ET-FR/HP_new_generation/docs/README.md

# docs

Retour au [document principal](../README.md).

| Emplacement | Contenu |
|---|---|
| `simulateur/` | Captures du simulateur de la PAC |
| `nomenclature.md` | Nomenclature de la PAC (rôle, choix, masse, coût, charge R290) |

Tout ce qui concerne les échangeurs (CFD, formes, plans, bibliographie, cahier des charges) est dans
[`../conception_echangeur/`](../conception_echangeur/README.md) ; les ventilateurs, dans
[`../conception_ventilateur/`](../conception_ventilateur/README.md).
