ET-FR/HP_new_generation/compresseurs/sources/concurrents_marche/SOURCES.md

# Sources : compresseurs des concurrents, marché et réglementation R290

Toutes les pages ont été consultées le 2026-11-11. « Fichier » = copie locale dans ce dossier.
« non sauvegardé » = page bloquée (Cloudflare, 403, JavaScript) : seule l'URL est conservée, et le contenu
a été lu par extrait de moteur de recherche ou par WebFetch (fiabilité moindre).

## 1. Produits concurrents

| Titre | URL | Fichier | Ce que la source établit |
|---|---|---|---|
| Midea PWHP — fiche technique (Efficiency Vermont, 2022-10-31) | https://www.efficiencyvermont.com/Media/Default/docs/products/Midea-PWHP_TechProdSheet_2022-10-31.pdf | midea_pwhp_techprodsheet_efficiencyvermont_2022.pdf | PWHP 9k : **R-32**, compresseur à vitesse variable, EER 12,6 (95 °F), COP 3,57 / 2,36 / 1,71 à 47 / 17 / 0 °F ; garantie compresseur 12 ans. Aucun modèle de compresseur. |
| Midea PWHP MAH09H1AGR — Product Specs 2024-06-12 v2.0 | https://midea.com/content/dam/midea-aem/us/air-conditioners/pwhp/mah09h1agr/PWHP-Product-Specs-20240612-v2-0.pdf | midea_pwhp_product_specs_2024.pdf | R-32 ; EER 11,81 ; COP 4,0 (47 °F), 2,42 (17 °F), 2,0 (5 °F), 1,41 (temp. min.) ; CEER 16, SEER2 18,76, HSPF2 10,12. |
| Midea 9,000 BTU Packaged Window Heat Pump (page produit) | https://midea.com/us/Heating_Cooling/pwhp/9000btu-115v-packaged-window-heat-pump-mah09h1agr | non sauvegardé | Fonctionnement jusqu'à −13 °F, 115 V. |
| Fast Company — Midea heat pump review | https://www.fastcompany.com/91448042/midea-heat-pump-review | non sauvegardé (anti-robot) | Midea dit avoir conçu un compresseur neuf pour ce format ; Midea possède son fabricant de compresseurs (GMCC). Lu par extrait de recherche seulement. |
| ACHR News — Midea à l'ENERGY STAR Partner Meeting 2024 | https://www.achrnews.com/articles/155312-midea-showcases-heat-pump-innovation-at-2024-energy-star-products-partner-meeting | achrnews_midea_energy_star_2024_window_hp.html | PWHP présenté dans le cadre du Clean Heat for All Challenge ; COP 2,42 à 17 °F. |
| ACCA blog — Midea cold-climate compressor (EVI) | https://hvac-blog.acca.org/transforming-cold-climate-heating-a-look-at-mideas-innovation-in-heat-pump-compressors/ | acca_blog_midea_cold_climate_compressor.html | Rotatif bi-étagé « sequential stage » à injection de vapeur saturée entre cylindres, pour les PAC **gainables** Midea (pas la fenêtre). |
| Cooling Post — Midea exceeds cold climate challenge (16/10/2023) | https://www.coolingpost.com/world-news/midea-exceeds-cold-climate-challenge/ | coolingpost_midea_exceeds_cold_climate_challenge.html | PAC 3 tonnes Midea (pas la fenêtre) : EVI, 118 % de la capacité à −15 °F, COP 1,92 ; fluide A2L non nommé. |
| Gradient All-Weather 120V — Spec Sheet | https://cdn.shopify.com/s/files/1/0558/4925/5070/files/All_Weather_120V_Spec_Sheet.pdf | gradient_allweather120v_spec_sheet.pdf | **R32** hermétique, compresseur et ventilateurs à vitesse variable ; EER 10,0 ; COP 4,00 / 2,60 / 2,35 / 1,71 à 47 / 17 / 5 / −7 °F. |
| Gradient — product specifications (Efficiency Vermont) | https://www.efficiencyvermont.com/Media/Default/docs/products/gradient-product-specifications.pdf | gradient_product_specifications_efficiencyvermont.pdf | Autre version : EER 13,6, COP 4,04 / 2,37 / 2,06 / 1,80 ; R-32 chargé en usine. |
| Gradient — Installation Manual | https://cdn.shopify.com/s/files/1/0558/4925/5070/files/Gradient_Installation_Manual.pdf | gradient_installation_manual.pdf | R32, consignes A2L ; pas de masse de charge ni de modèle de compresseur trouvés. |
| Gradient blog — How we build your Gradient's heat pump (2022) | https://gradientcomfort.com/blog/how-to-build-a-planet-friendly-air-conditioner | gradient_blog_how_we_build_heat_pump.html | Assemblage, charge R32, scellé hermétique. |
| Cooling Post — Gradient rethinks the window air conditioner | https://www.coolingpost.com/products/gradient-rethinks-the-window-air-conditioner/ | coolingpost_gradient_rethinks_window_ac.html | Ancien modèle : R32, objectif « naturel » à terme ; « thought to employ » un compresseur à « roll-diaphragm » breveté (hypothèse du journaliste). |
| NaturalRefrigerants.com — window heat pumps / ACEEE (Gradient 780 g R32) | https://naturalrefrigerants.com/news/window-mounted-heat-pumps-offer-lowest-cost-solution-to-decarbonize-multifamily-buildings-according-to-aceee-study/ | non sauvegardé (403) | Selon l'extrait de recherche : Gradient 780 g de R32, ouvert au R290 à l'avenir. **Non vérifié.** |
| Hydrocarbons21 — Gradient eyes R290 (2021) | https://archive.hydrocarbons21.com/articles/10123/HC21-120.png | non sauvegardé | Gradient envisageait le R290 (2021) ; limite US ~114 g selon UL 60335-2-40. |
| LG — Case study INNOVA x LG (2022) | https://www.lg.com/global/business/insights/compressor-motor/blog/case-study1-innova-lg/ | lg_case_study_innova_2.0_mini_R290_twin_rotary.html | Innova 2.0 MINI : **compresseur rotatif bi-cylindre inverter LG R290** (« LG R290 Twin Inv. Rotary »). Pas de référence ni de cylindrée. |
| Innova 2.0 — brochure EN (2025-01-16) | https://ventilaatorid24.ee/wp-content/uploads/documents/250116_-_innova_-_2_0-en.pdf | innova_2.0_brochure_en_2025.pdf | 2.0 MINI 9 HP : R290, **0,14 kg**, rotatif DC inverter, EER 3,01, COP 3,15, 27–39 dB(A) ; tous les modèles plus gros sont en R32 (0,50 kg). |
| CINEA — LIFE ZEROGWP (Innova 2.0 NR) | https://cinea.ec.europa.eu/featured-projects/life-zerogwp_cs | non sauvegardé | Projet LIFE : monobloc double conduit Innova 2.0 NR chargeable en R290 ; compresseur non précisé. |
| Ephoca AIO Wall Mounted Pro — data sheet (copie NYC DOB, rév. 08/2024) | https://www.nyc.gov/assets/buildings/pdf/ec220.82.pdf | ephoca_AIO_wall_mounted_pro_datasheet_nycgov_2024.pdf | Ephoca = filiale US d'Innova ; **rotatif bi-cylindre BLDC inverter** ; **R32 ou R410A** (pas de R290 aux US) ; garantie compresseur 9 ans. |
| Olimpia Splendid — catalogue Unico « Retail » IT | https://olimpiasplendid.it/Downloadfile/IT_UnicoRetail | olimpia_catalogue_unico_retail_IT.pdf | Unico Next-F 8 / Next 10 : R290, **0,145 kg**, 1,6 / 2,1 kW froid ; les tailles 2,6 kW sont en R32 (0,28 kg). Compresseur « Twin Rotary a basse vibrazioni ». Charges R290 < 152 g pour éviter la vérification de surface de pièce. |
| Olimpia Splendid — catalogue Unico « Prof » IT | https://olimpiasplendid.it/Downloadfile/IT_UnicoProf | olimpia_catalogue_unico_prof_IT.pdf | Unico Evo / Evo-F en R290 (16, 20, 25), même logique < 152 g, twin rotary. |
| Olimpia Splendid — catalogue Unico EN 2024 (copie distributeur) | https://steelsoft.rs/wp-content/uploads/2024/10/OLIMPIA-SPLENDID-UNICO-EN24.pdf | olimpia_unico_EN24_steelsoft.pdf | Nomenclature (P = R290, V = inverter), « new Twin Rotary compressor », 30 dB(A) en mode silence, encart IEC 60335-2-40 (152 g / 988 g). |
| Olimpia Splendid — notice Unico Evo-F R290 (10-2024) | https://olimpiasplendid.it/media/files/9451_26A00171A-1_UNICO%20EVO-F_10-2024_13L_compressed.pdf | olimpia_unico_evo_f_manual_2024_R290.pdf | Consignes de sécurité R290 ; pas de référence de compresseur. |
| AirCare — R290 monoblock AC (fiche) | https://aircareappliances.co.uk/cdn/shop/files/R290_MONOBLOCK_AC-2ffb4dfa-eb73-4440-b06b-8fc143c64816.pdf | r290_monoblock_ac_aircare.pdf | Monobloc mural R290 10 000 BTU générique : charge 290 g. |
| Midea — R290 NewGen Refrigerant (dossier Blauer Engel) | https://produktinfo.blauer-engel.de/uploads/pdf_uploads/R290%20NewGen%20Refrigerant.pdf | midea_blauer_engel_R290_newgen_refrigerant.pdf | Tableau Midea : charges R290 90–230 g (modèles PHA5K…PD12K) et compresseurs R290 **plus lourds de 0,6 à 2,7 kg** que les R410A équivalents. |
| Midea — Faltblatt R290 (2024) | https://midea.com/content/dam/midea-aem/de/hvac/kataloge/midea-faltblatt-r290-natural-organic-refrigerant-2024-din-a4-5seiter-digital.pdf | midea_faltblatt_R290_2024.pdf | Gamme split R290 Midea en Allemagne. |
| Midea — communiqué PortaSplit R290 (sept. 2026) | https://www.midea.com/content/dam/midea-aem/de/umber-midea/press/Midea-Pressemitteilung-PortaSplit-R290.pdf | midea_portasplit_R290_pressemitteilung.pdf | PortaSplit passe du R32 au R290 en 2027 à cause de l'interdiction F-gas du 1/1/2027. |
| Cooling Post — Midea propane AC wins Blue Angel | https://www.coolingpost.com/world-news/midea-propane-ac-wins-blue-angel-award/ | coolingpost_midea_propane_ac_blue_angel.html | Split R290 Midea « All Easy » ; compresseur R290 développé en interne. |
| IIR — Midea launches R290 split ACs on the European market | https://iifiir.org/en/news/midea-launches-r290-split-acs-on-the-european-market | non sauvegardé | Lancement 2021 en Europe. |
| Groupsumi — Midea Zenith R290 3,5 kW | https://groupsumi.es/en/climate-control/air-conditioning/split-air-conditioning/midea-zenith-r290-3-5-kw-12000-btu-air-conditioner-with-wifi-13950487 | non sauvegardé | Charge 0,38 kg (revendeur). |
| Haier Pearl R290 (2024) | https://haierhvac.eu/sites/default/files/2024-06/Haier_ENG_PearlR290_2024_Digital.pdf | haier_pearl_R290_2024.pdf | Split R290 : « Rotary Inverter », 310 g en usine, aucun complément de charge autorisé. |
| 2025 Resource Guide — R290 Split AC | https://industriaeformazione.it/wp-content/uploads/2025/07/2025_FINAL_ResourceGuide_R290_Split_AC_update.pdf | resource_guide_R290_split_AC_2025.pdf | Panorama des splits R290 du marché (non dépouillé en détail). |
| Room Heat Pumps Factsheet (08/2024) | https://static1.squarespace.com/static/5bb2379dca525b5810509ec1/t/66bcf2adb7400d548c67cd01/1723658926543/Room+Heat+Pumps+Factsheet+0814.pdf | room_heat_pumps_factsheet_0814.pdf | Tous les PAC de pièce US recensés sont en R32. |
| Windmill — spec sheet (Home Depot) | https://images.thdstatic.com/catalog/pdfImages/38/38f6fb39-9b2d-4f40-9b09-40b530a222c7.pdf | non sauvegardé | WhisperTech 12k : compresseur inverter, R32 ; climatiseur seul (pas de PAC). |
| Distributeur Area Cooling — catalogue compresseurs (GMCC R290) | https://exhibitorsearch.messefrankfurt.com/images/original/document_downloads/10000006202501/418603/1741874234911_75076646.pdf | distributeur_messefrankfurt_GMCC_R290_compresseurs_2025.pdf | Rotatifs GMCC R290 DC inverter 12–120 rps : RDSK46D15TZR3 (4,6 cm³), RDSK66D15TBZ3 (6,6), RDSK75D35TBZ3 (7,5), RDSK89D35TBZ3 (8,9), EDTN150D32EFZ (15,0), EDTN180D32EFZ (17,9), EDTN210D32EFZ (20,9) ; COP 3,08–3,51 (conditions de chauffage non explicitées dans l'extrait). |

## 2. Programmes Clean Heat for All / DOE

| Titre | URL | Fichier | Ce que la source établit |
|---|---|---|---|
| BE-Exchange — Window HP Expo program (17/06/2026) | https://be-exchange.org/wp-content/uploads/2026/06/20260617_Window-HP-Expo-Program_WEBSITE.pdf | be_exchange_window_hp_expo_2026-06.pdf | Exigences du challenge (≥ 1,87 COP à 17 °F, 9 000 Btu/h, 115 V 15 A) ; moyenne des deux fabricants : COP 3,92 / 2,44 / 2,03 / 1,32 / 1,19 à 47 / 17 / 5 / −13 / −22 °F ; R-32 ; 30–50 dB(A). |
| BE-Exchange — Room Heat Pump Expo (15/10/2025) | https://be-exchange.org/wp-content/uploads/2025/10/10.15.25-Room-Heat-Pump-Expo-Presentation-for-web.pdf | be_exchange_room_heat_pump_expo_2025-10.pdf | Cahier des charges NYCHA, cible ≤ 35 dB(A) évoquée pour d'autres programmes. |
| BE-Exchange — Clean Heat slides (16/01/2025) | https://be-exchange.org/wp-content/uploads/2025/01/20250116_CleanHeat_Slides-UPDATED.pdf | be_exchange_cleanheat_slides_2025-01.pdf | Midea vs Gradient : tous deux compresseur variable, R-32 ; 51 et 47 dB(A) max. |
| ACEEE 2024 — PWHP NYCHA (pièce jointe) | https://www.aceee.org/sites/default/files/proceedings/ssb24/assets/attachments/20240722160802234_36119e7d-75eb-48b9-ac5f-b4c191450e36.pdf | aceee_2024_ssb24_window_heat_pumps_attachment.pdf | Processus de sélection (6 propositions), R-32 + compresseurs variables, retours terrain. |
| Contractor Mag — Midea 20 000 unités NYCHA | https://www.contractormag.com/green/article/21249624/midea-to-provide-20000-electric-window-heat-pump-units-for-nyc-public-housing | non sauvegardé | Contrat de 20 000 unités. |
| DOE BTO Peer Review 2024 — Next-gen low-cost DX heat pumps | https://www.energy.gov/sites/default/files/2024-11/bto-peer-2024-322262007-next-gen-low-cost-direct-expansion-heat-pumps-li.pdf | doe_bto_peer_2024_next_gen_low_cost_DX_heat_pumps.pdf | Compresseur bi-étagé Copeland (R-457A) ; isentropique comparable au R-410A. |
| DOE 2016 — Shen, cold climate HP tandem compressors | https://www.energy.gov/sites/prod/files/2016/04/f30/32212_Shen_040616-1135.pdf | doe_2016_shen_cold_climate_hp_tandem_peer_review.pdf | Tandem à injection de vapeur + flash tank : 88 % de capacité à −13 °F, COP 4,4 à 47 °F. |
| OSTI 1468210 — Cold climate HP using tandem vapor-injection compressors | https://www.osti.gov/biblio/1468210 | non sauvegardé | À −30 °F : 75 % de la capacité à 47 °F, COP 1,8. |

## 3. Réglementation et normes

| Titre | URL | Fichier | Ce que la source établit |
|---|---|---|---|
| Règlement (UE) 2024/573 (F-gas), JO L du 20/02/2024 | https://eur-lex.europa.eu/legal-content/EN/TXT/PDF/?uri=OJ:L_202400573 | eurlex_reglement_UE_2024_573_fgas.pdf | Annexe IV point 8 : monoblocs / autonomes / plug-in ≤ 12 kW interdits avec GWP ≥ 150 au **1/1/2027** et avec tout gaz fluoré au **1/1/2032** (dérogation sécurité : GWP 750). Point 9 : splits air-air ≤ 12 kW GWP ≥ 150 au 1/1/2029, sans F-gas au 1/1/2035. |
| EIA — Concise guide EU F-gas, Ban/Market prohibitions (2026) | https://eia-international.org/wp-content/uploads/2026-EIA-A-Concise-Guide-to-the-EU-F-Gas-Regulation-Ban-Market-Prohibitions-Spread.pdf | eia_2026_concise_guide_fgas_ban_market_prohibitions.pdf | Synthèse des interdictions. |
| EIA US — Enabling Ultralow GWP Heating and Cooling (maj. 07/01/2026) | https://eia.org/wp-content/uploads/2025/09/Enabling-Ultralow-GWP-Heating-and-Cooling-Updating-U.S.-Safety-Standards-and-Codes-update-1.7.26.pdf | eia_us_enabling_ultralow_gwp_safety_standards_2026.pdf | Tableau 1 : IEC 60335-2-40 éd. 7 (2022) R290 : M1 = 4×LFL = 152 g, M2 = 26×LFL = 988 g, M3 = 130×LFL = 4,94 kg, non fixe 2×M1 = 304 g. UL 60335-2-40 éd. 4 : 3×LFL = 114 g partout. ASHRAE 15 : < 150 g. |
| Federal Register 80 FR 19454 (10/04/2015), SNAP Rule 20 | https://www.govinfo.gov/content/pkg/FR-2015-04-10/html/2015-07895.htm | federal_register_2015-07895_snap_hydrocarbons_room_ac.html | Table 2 « Window AC » : R-290 max **0,24 kg à 9 000 Btu/h** (0,22 à 8 000 ; 0,26 à 10 000) ; PTAC/PTHP 0,14 kg ; portable 0,30 kg ; mural 0,43 kg. |
| EPA — SNAP Rule 25 fact sheet (2023) | https://www.epa.gov/system/files/documents/2023-04/SNAP%20Final%20Rule%2025%20Factsheet_Final_4-3-2023_508_2.pdf | epa_snap_rule25_factsheet_2023.pdf | UL 60335-2-40 3e éd. obligatoire au 2/1/2024 pour les A2L en climatisation résidentielle. |
| EPA — SNAP Rule 27 proposed, fact sheet (10/2025) | https://www.epa.gov/system/files/documents/2025-10/fact-sheet-snap-rule-27_0.pdf | epa_snap_rule27_factsheet_2025-10.pdf | Mise à jour des conditions d'usage vers UL 60335-2-40 4e éd. ou certification NRTL (proposition). |
| EPA — SNAP Rule 27 supplemental proposal fact sheet (02/04/2026) | https://www.epa.gov/system/files/documents/2026-04/fact-sheet-san-12207-snprm-snap-listing-rule-27-04-02-2026.pdf | epa_snap_rule27_snprm_factsheet_2026-04.pdf | Proposition complémentaire ; non finalisée à la date de consultation (pas de règle finale trouvée). |
| IEC 60335-2-40:2022 éd. 7.0 — aperçu VDE | https://www.vde-verlag.de/iec-normen/preview-pdf/info_iec60335-2-40%7Bed7.0%7Db.pdf | iec_60335-2-40_ed7_preview_vde.pdf | Sommaire et domaine d'application de l'édition 7. |
| Cooling Post — Standard revision a « milestone » for propane AC (03/05/2022) | https://www.coolingpost.com/world-news/standard-revision-a-milestone-for-propane-ac/ | coolingpost_standard_revision_milestone_propane_ac.html | Éd. 7 approuvée le 29/04/2022 ; de ~334 g à 988 g de R290 pour un split avec mesures de sécurité. |
| HVAC&R News — Flammable charge limits on the move again (2020) | https://hvacrnews.com.au/regulations/flammable-charge-limits-on-the-move-again/ | hvacrnews_flammable_charge_limits_on_the_move.html | 334 g → 988 g dans une pièce de 20 m² × 2,2 m sous réserve de circulation d'air, vannes, conception robuste. |
| GIZ Proklima — Safety standards (2023) | https://www.green-cooling-initiative.org/fileadmin/user_upload/230630_GIZ-ProClima_Safety_standards_RZ.pdf | giz_proklima_safety_standards_2023.pdf | Formules de charge, notion d'« enhanced tightness refrigerating system », facteurs F = 0,35 / 0,50. |

## 4. Rendement des compresseurs rotatifs R290 et injection de vapeur

| Titre | URL | Fichier | Ce que la source établit |
|---|---|---|---|
| ORNL — Development of High Efficiency Window AC and Compressor Using Propane (rapport CRADA, 2018) | https://info.ornl.gov/sites/publications/Files/Pub119670.pdf | ornl_pub119670_window_ac_propane_limited_charge.pdf | Shanghai Highly : R410A ASD100HW-H6KUN (10,0 cm³) et R290 **PSD162XW (16,2 cm³)**, tous deux isentropique 67 % ; prototype R290 optimisé ≈ 0,77–0,80 isentropique ; climatiseur fenêtre 12k EER 14,0 avec charge < 260 g. |
| ORNL/OSTI 1649540 — Development of High Efficiency WAC Using Propane under Limited Charge (article) | https://www.osti.gov/pages/servlets/purl/1649540 | osti_1649540_ornl_window_ac_propane_limited_charge_paper.pdf | Version article ; charge réductible à 150 g avec microcanaux ; R290 demande ~50 % de cylindrée en plus que le R410A. |
| Purdue ICEC 2096 (2012) — Gao, Chen, Gao : R290 compressor effect on RAC charge | https://docs.lib.purdue.edu/icec/2096/ | non sauvegardé (Cloudflare) | 1 HP inverter R290 : comparaison mono- / bi-cylindre et influence sur la charge (résumé seulement). |
| Purdue ICEC 2300 (2014) — R290 less-oil rotary compressor | https://docs.lib.purdue.edu/icec/2300 | non sauvegardé | Réduire l'huile pour réduire la charge R290 (gaz dissous). |
| Purdue ICEC 2815 (2024) — Zhang & Da : high-speed R290 compressor for RAC (fiche IIR) | https://iifiir.org/en/fridoc/development-of-a-high-speed-r290-compressor-for-room-air-conditioner-149533 | non sauvegardé | Haute vitesse plutôt que grande cylindrée ; double refoulement avantageux au-delà de ~90 Hz. |
| Purdue ICEC 2203 — minimum viscosity for high-side R290 rotary | https://docs.lib.purdue.edu/icec/2203 | non sauvegardé | Dilution de l'huile par le R290 dans un carter haute pression. |
| Ma, Huang, Geng, Zhu (2012), J. Refrigeration — Vapor-injection rotary compressor for residential HP | https://library.kab.ac.ug/Record/doaj-art-c8a6c94245424c779acdd21b521b4ab0/Description | non sauvegardé | Rotatif à injection : +18 % de puissance calorifique en basse température, flash tank meilleur que l'échangeur interne. |
| IIR Fridoc — startup characteristics of R290 rotary compressor / RAC | https://iifiir.org/en/fridoc/experimental-study-on-startup-characteristics-of-a-r290-room-air-141980 | non sauvegardé | Démarrage à froid : aspiration sub-atmosphérique, condensation du R290 dans le compresseur. |
