ET-FR/HP_new_generation/compresseurs/sources/japon_coree/SOURCES.md

# Sources — compresseurs R290 petits, fabricants japonais / coréens / thaïlandais

Toutes les sources consultées le 2026-11-11. « Fichier local » = copie dans ce dossier (rien n'a été exécuté).
Certaines pages (industrial.panasonic.com, docs.lib.purdue.edu en texte intégral, mdpi.com, sciencedirect.com) refusent les téléchargements automatiques : URL citée sans copie locale.

## Panasonic (dont Panasonic Wanbao Appliances Compressor, Guangzhou)

| Titre | URL | Fichier local | Ce que ça appuie |
|---|---|---|---|
| Panasonic Industry Europe — HVAC-R Components catalogue 2026 | https://industry.panasonic.eu/storage/custom-upload/Devices/Panasonic_HVAC_R_Catalogue_2026.pdf | panasonic_HVACR_catalogue_2026.pdf | Tableau « Inverter R290 Rotary Compressors » : 7MS020Z (2,0 cm³) … 7SD110Z (11,2 cm³, twin, Ø95×225 mm, 1990 W froid / 570 W, COP chaud 4,49) … 7WD220Z ; conditions CT 54,4 / ET 7,2 / Ts 35 / Tex 46,1 °C ; plages 15–120 rps (série R) ; fabrication Chine |
| Panasonic — Fighting card « Compressors – Rotary (variable and fixed speed) » v3 | https://industry.panasonic.eu/storage/custom-upload/Devices/Compressors/Fighting_Card_Compressors_v3.pdf | panasonic_fighting_card_rotary_v3.pdf | Arguments techniques (aimant terres rares, bobinage concentré/distribué, ratio huile/R290 optimisé, twin rotary) |
| Panasonic Industry EU — page Rotary compressors | https://industry.panasonic.eu/products/devices/compressors/rotary-compressors | panasonic_eu_rotary_page.html | Gamme 1–10 kW, R290 |
| Panasonic — fiche 7TD052Z- (T2P, R290) | https://industrial.panasonic.com/kr/products/pt/rotary-compressors-vs/models/7TD052Z- | — (accès bloqué au téléchargement) | 5,20 cm³, 1325 W, 443 W, COP 2,99, condition « HPD 57.5Hz », 1Φ 208–230 V UL, Chine |
| Panasonic — fiche 7TD062Z- (T2P, R290) | https://industrial.panasonic.com/kr/products/pt/rotary-compressors-vs/models/7TD062Z- | — | 6,20 cm³, 1500 W, 525 W, COP 2,86, « HPD 57.5Hz », 3Φ DC inverter |
| Panasonic — fiche 7SS064Z- (S, R290) | https://industrial.panasonic.com/kr/products/pt/rotary-compressors-vs/models/7SS064Z- | — | 6,40 cm³, 1636 W, 478 W, COP 3,42, « HPD 57.5Hz » (le catalogue EU donne 330 W / COP 4,53 : incohérence) |
| Panasonic — liste des modèles rotatifs vitesse variable | https://industrial.panasonic.com/ww/products/pt/rotary-compressors-vs/models | — | 38 modèles R290 (séries J2P, K2P, M, M2P, R1P, R2P, S, S2P, T2P, V2P, W2P) |
| Panasonic NA — R-290 series | https://na.industrial.panasonic.com/products/hvacr-appliance-devices/compressors/lineup/rotary-compressors/series/150863 | — | Gamme R290 vitesse fixe 0,5–8 kW, gros modèles 3–16 kW |

## LG Electronics (Corée)

| Titre | URL | Fichier local | Ce que ça appuie |
|---|---|---|---|
| LG Rotary Compressor Catalog 2022 (copie hébergée par un distributeur, hvacr-shop.com) | https://cdn.shopify.com/s/files/1/0605/9560/1544/files/LG_Rotary_Compressor_Catalog_2022_20230420_143824.pdf | lg_rotary_catalog_2022.pdf | R290 vitesse variable : PST092MA, PST102MA (2 pistons), PAT134MA ; capacité, puissance, COP à 60 Hz ASHRAE ; 20–90 rps ; aimant NdFeB ; nomenclature (P = R290, 102 = 10,2 cc/tr) ; R290 vitesse fixe PSG066P/PSG075P/PSG075K |
| LG — catalogue rotatif 2025 (preview) | https://www.lg.com/global/business/download/airsolution/2025_LG_CM_Catalog_Rotary%20compressor_preview[20250718_155755452].pdf | — (le serveur renvoie une page d'erreur) | non exploité |
| LG — page Rotary Compressor | https://www.lg.com/global/business/compressor-motor/compressors/rotary-compressor/ | lg_rotary_compressor_page.html | R290 en vitesse fixe et variable, 1,0–14 kW, single/twin |
| LG — Case study INNOVA (R290 twin inverter rotary) | https://www.lg.com/global/business/insights/compressor-motor/blog/case-study1-innova-lg/ | lg_case_study_innova_R290_twin_rotary.html | Compresseur LG R290 twin rotary inverter choisi pour le monobloc INNOVA 2.0 MINI (concurrent direct « mural sans unité extérieure ») |

## Mitsubishi Electric / Mitsubishi Electric Siam Compressor Industry (Thaïlande) / MHI

| Titre | URL | Fichier local | Ce que ça appuie |
|---|---|---|---|
| Mitsubishi Electric — Compressors | https://www.mitsubishielectric.com/bu/air-conditioning-systems/products/compressors/ | mitsubishi_electric_compressors_page.html | « premier compresseur R290 du secteur (orienté ATW) », extension de capacité R290 ; technologies (Pokipoki motor, vilebrequin revêtu, scrum middle plate) ; sites Shizuoka, Siam (Laem Chabang), Guangzhou ; contact marketing@siamcompressor.com |
| ME-SCI (Siam Compressor) — Products | https://technic.me-sci.com/siamcompressor/en/products | siam_compressor_products_page.html | Filtre « R-290 » présent mais aucune donnée publique ; catalogue rotatif non téléchargeable (lien javascript) |
| ME-SCI — Documentation | https://technic.me-sci.com/siamcompressor/en/documentation | — | Catalogues listés sans lien de téléchargement |
| Mitsubishi Electric UK — MSZ-RZ R290 | https://les.mitsubishielectric.co.uk/products/air-conditioning/m-series/wall-mounted/msz-rz-r290 | mitsubishi_MSZ-RZ_R290_page.html | Split mural R290 (RZ25/RZ35), SEER jusqu'à 11,7, SCOP 5,3 : preuve qu'un petit rotatif R290 inverter Mitsubishi existe (modèle non publié) |
| MHI Technical Review Vol. 60 No. 2 (2023) — SRK_23S | https://mth.mhi.com/development/paper/pdf/e602050.pdf | mhi_technical_review_e602050_twin_rotary_RAC.pdf | (R32) twin rotary 13→15 cc, revêtement DLC palette, +5 % de rendement ; onduleur MOSFET superjonction, pertes contrôleur −60 % |
| Mitsubishi Ecodan R290 (PUZ-WZ) — revendeur | https://www.theheatpumpwarehouse.co.uk/shop/heat-pumps/mitsubishi-ecodan-r290-5kw-monobloc/ | — | PAC eau R290 à rotatif double (trop gros pour nous) |

## Samsung (Corée)

| Titre | URL | Fichier local | Ce que ça appuie |
|---|---|---|---|
| Samsung — Rotary & Scroll applications | https://www.samsung.com/global/business/compressor/applications/special-rotary-scroll | samsung_special_rotary_scroll_page.html | « Variable Speed / R290 » seulement en scroll ; aucun rotatif R290 publié |
| Samsung — Rotary compressor dimension spec | https://images.samsung.com/is/content/samsung/assets/global/business/compressor/rotary-compressor/rotary-compressor-dimension-spec-detailed-v1.pdf | samsung_rotary_dimension_spec_detailed_v1.pdf | Cotes des carcasses 39/44/48 frames ; pas de fluide ni performances |

## Toshiba / GMCC, Hitachi / Highly (JCI), Daikin — notes

| Titre | URL | Fichier local | Ce que ça appuie |
|---|---|---|---|
| ORNL/TM-2018/1063 — Development of High Efficiency Window AC and Compressor Using Propane (B. Shen) | https://info.ornl.gov/sites/publications/Files/Pub119670.pdf | ornl_window_AC_propane_limited_charge_Pub119670.pdf | Highly (Shanghai Hitachi / JCI) PSD162XW R290 16,2 cm³ : 10 014 Btu/h, 894 W, COP 3,28, η_vol 91 %, η_is 67 %, huile 270 ml, ~40 g de R290 dans l'huile ; prototype optimisé ≈ 0,80 d'η_is (carte 0,77–0,80) ; climatiseur fenêtre R290 EER 14,0 |
| ORNL — Development of High Efficiency WAC Using Propane under Limited Charge (article) | https://www.osti.gov/pages/servlets/purl/1649540 | ornl_osti1649540_window_AC_propane_limited_charge_paper.pdf | Même projet, charge ramenée à 150 g avec microcanaux |
| Toshiba GMCC compressor catalogue (revendeur) | https://okmarts.com/jeecg-boot/sys/common/pdf/PDF/Compressor/Toshiba_Compressor/Toshiba_GMCC_Compressor.pdf | — | GMCC = JV Midea / Toshiba Carrier ; ligne R290 depuis 2014 |
| Revendeur — GMCC DSM180D19UDZ R290 | https://qishanr.com/products/r290-gmcc-inverter-compressor-dsm180d19udz | — | R290 DC inverter 17,9 cm³ (source non constructeur) |
| Daikin — EWA(Y)K-CZ | https://www.daikin.eu/en_us/product-group/chillers/ewa-y-k-cz.html | — | Daikin R290 = scroll ; pas de « swing » R290 public trouvé |

## Littérature rendement

| Titre | URL | Fichier local | Ce que ça appuie |
|---|---|---|---|
| Zheng et al. (Midea / Pékin), Performance analysis for a rotary compressor at high speed, arXiv 2407.11080 (2024) | https://arxiv.org/pdf/2407.11080 | arxiv_2407.11080_rotary_compressor_high_speed.pdf | (R32, Te −14,3 / Tc 33,3, PR ≈ 4,2) rendement global ≈ 0,66–0,70 entre 80 et 160 Hz, pic ~68 % à 160 Hz, chute à 200 Hz ; η_vol 84 % (80 Hz) → 105 % (180 Hz) ; η moteur×méca ≈ 83–87 % |
| Gao, Qian, Chen, Liang (GMCC/Meizhi), Research and Development of R290 Less Oil Rotary Compressor, ICEC 2014, paper 2300 | https://docs.lib.purdue.edu/icec/2300/ | purdue_icec2014_2300_R290_less_oil_rotary_abstract.html | Réduction de l'huile pour baisser la charge R290 (IEC 60335-2-40) ; résumé seulement |
| Gao, Chen, Gao, Research of R290 Compressor Effect on RAC System Charge Amount, ICEC 2012, paper 2096 | https://docs.lib.purdue.edu/icec/2096/ | purdue_icec2012_2096_abstract.html | Mono- vs bicylindre dans une clim 1 HP R290 DC inverter ; résumé |
| Zhang, Da, Development of a High Speed R290 Compressor for Room Air Conditioner, ICEC 2024, paper 2815 | https://docs.lib.purdue.edu/icec/2815/ | purdue_icec2024_2815_high_speed_R290_RAC_compressor_abstract.html | Rotatif R290 haute vitesse pour clim ; refoulement simple/double équilibré vers 90 Hz (texte intégral non accessible) |
| Experimental Investigation of Heat Pump Modules Limited to 150 g of R290 (Energies 2025, 18(10), 2455) | https://www.mdpi.com/1996-1073/18/10/2455 | — (accès refusé au téléchargement) | η_is total > 0,45 pour rotatif et piston ; rotatif meilleur à faible taux de compression, piston meilleur à fort taux |
| Performance research and improvement of ultra-high-speed R290 rotary compressor (ResearchGate) | https://www.researchgate.net/publication/381387371_Performance_research_and_improvement_of_ultra-high-speed_R290_rotary_compressor | — | « η_is > 80 % » annoncé à −20 °C (résumé seulement, définition non vérifiée) |
| Thermodynamic performance … low GWP refrigerant in compressors (ATE 2024) | https://www.sciencedirect.com/science/article/abs/pii/S1359431124021598 | — (403) | R290 vs R32 à cylindrée égale : R290 meilleur η_is aux vitesses usuelles ; chute à haute vitesse par sur-compression (d'après résumé du moteur de recherche) |
