ET-FR/HP_new_generation/conception_ventilateur/ventilateurs.html

# Ventilateurs de la PAC de fenêtre : pales, biomimétisme, moteur BLDC

Recherches et pré-dimensionnement · généré le 11/11/2026 par conception_ventilateur/outils/fiche_ventilateurs.py · ventilateur interactif

## L'essentiel

1. Les ventilateurs pèsent lourd : à COP 6, les 76 W du budget actuel font 17 % de la puissance électrique. Les ramener à 40 W donne COP 6,5.
2. Le budget de 76 W est faux : il ne compte que les 25 Pa de la batterie. Un ventilateur axial perd aussi l'énergie de l'air qui sort (½ρc²) : à l'extérieur, de 10 Pa (rotor de 500 mm) à 75 Pa (300 mm). Le diamètre disponible dans la fenêtre décide de tout.
3. Le premier gain vient de ce qu'il y a autour de la pale : grand rotor lent, diffuseur, stator redresseur, faible jeu en bout de pale. Un diffuseur fait passer un axial de 42 % à plus de 50 %[12][11].
4. Le biomimétisme sert d'abord le bruit (−2,5 à −5 dB) ; les gains de rendement indépendants sont de 3 à 8 %. Les tubercules de baleine aident quand la batterie extérieure givre (le ventilateur ne décroche pas).
5. Moteur BLDC à commande vectorielle sans capteur : le bon choix. 60–90 % de rendement contre 30–50 % pour un moteur à condensateur, et efficace à bas régime, là où la PAC tourne le plus[29].
6. Pourquoi un petit ventilateur rend si mal : pression utile faible (l'air sortant emporte l'énergie), faible Reynolds (profils peu efficaces), bout de pale, petit moteur. Le ventilateur EC du commerce du dépôt plafonne à 0,26. Cible revue : 0,45–0,55.
7. Bout de pale : anneau tournant fixé aux pales, oui ; roulement en périphérie, non ; moteur en périphérie (rim-driven), intéressant mais trop cher pour le premier prototype.
8. Un seul module (même batterie, même ventilateur) des deux côtés : ça tient, et les ventilateurs ne consomment plus que ≈ 12 à 30 W au total ; la batterie intérieure plus grande permet de baisser Tc (≈ −35 W de compresseur à 8,3 °C). Voir Même ventilateur et même échangeur.
9. Pour essayer les variantes : ventilateur interactif (géométrie, vitesse, anneau, diffuseur, motifs bio-inspirés, moteur ; bilan des pertes en direct).

## Cahier des charges

| Intérieur | Extérieur
Débit max | 800 m³/h | 2 500 m³/h
Perte de charge de la batterie | ≤ 25 Pa | ≤ 25 Pa, davantage quand elle givre
Cas qui dimensionne | chauffage 8,3 °C | chauffage −8,3 °C (air à 1,33 kg/m³, +11 % de pression)
Budget actuel | 76 W au total, η = 0,30, perte de sortie non comptée
Cible du dossier | η global 0,45–0,55 → ≈ 45–55 W au total
Moteur | BLDC rotor extérieur, FOC sans capteur

Source : pac_9000btu.html, cahier des charges des échangeurs (9 000 BTU/h = 2 638 W).

## Pourquoi chaque watt compte

COP de l'unité selon la puissance des ventilateurs, compresseur inchangé. Ronds : budget actuel ; carrés verts : cible de 40 W.

COP visé | P élec. totale W | Ventilateurs 76 W | Ventilateurs 40 W | COP si 76 → 40 W
4,0 | 660 | 12 % | 6 % | 4,23
6,0 | 440 | 17 % | 9 % | 6,54

## Architecture : la perte de sortie et le diamètre

pression totale à fournir Δp_t = Δp_batterie + ½ ρ c² (c = débit / section annulaire du rotor) puissance électrique P = Q × Δp_t / η_global similitude Q ∝ n D³ Δp ∝ n² D² P ∝ n³ D⁵ bruit ∝ u⁵ à u⁶ (u = vitesse en bout de pale)

Pression totale qu'un axial doit fournir selon son diamètre. Bleu : la batterie ; orange : énergie perdue par l'air qui sort ; vert : avec un diffuseur qui en récupère la moitié.

Puissance électrique selon le diamètre (diffuseur à 50 %) pour trois rendements ; en pointillé violet, la vitesse de rotation pour un coefficient de pression ψ = 0,2.

Échangeur | D mm | c sortie m/s | ½ρc² Pa | Δp_t avec diffuseur Pa | u bout m/s | tr/min | φ | P élec. W (η 0,30 / 0,45 / 0,60)
intérieur | 200 | 8,1 | 39,0 | 44,5 | 19,3 | 1839 | 0,37 | 33 / 22 / 16
intérieur | 250 | 5,2 | 16,0 | 33,0 | 16,6 | 1267 | 0,27 | 24 / 16 / 12
intérieur | 300 | 3,6 | 7,7 | 28,9 | 15,5 | 987 | 0,20 | 21 / 14 / 11
extérieur | 300 | 11,2 | 75,2 | 62,6 | 22,8 | 1454 | 0,43 | 145 / 97 / 72
extérieur | 400 | 6,3 | 23,8 | 36,9 | 17,5 | 837 | 0,32 | 85 / 57 / 43
extérieur | 500 | 4,0 | 9,7 | 29,9 | 15,8 | 603 | 0,22 | 69 / 46 / 35

φ = Q / (π D²/4 · u) : coefficient de débit, en vert dans la plage usuelle d'un axial basse pression (0,15–0,35), en rouge si le diamètre est mal adapté au débit. ψ = 2 Δp_t / (ρ u²) = 0,2. Calcul : conception_ventilateur/outils/predimensionnement.py.

Lecture. À l'extérieur, un rotor de 300 mm est hors jeu (φ trop grand, 145 W à η = 0,3). À 500 mm on tourne à 600 tr/min, silencieux, pour 35 W à η = 0,6. À l'intérieur, 250–300 mm à 1 000–1 300 tr/min, 11 à 16 W.

## Quelle famille de ventilateur

Famille | Où elle gagne | Rendement global typique | Pour nous
Axial à virole + diffuseur / stator | grand débit, faible pression (notre cas) | 0,45–0,60 avec diffuseur[12] | extérieur : choix de base
Contrarotatif (2 rotors) | plus de pression dans le même diamètre, giration récupérée | 63–65 % mesurés sur petits rotors[23][24] | si la fenêtre limite le diamètre
Diagonal (hélico-centrifuge) | pression moyenne, compact | ≈ 0,48–0,56 (chiffre fabricant)[28] | intérieur si la batterie résiste plus que prévu
Centrifuge à aubes arrière | pression élevée, débit moyen | > 0,70 en grande taille (chiffre fabricant)[15] | intérieur possible, encombrant
Tangentiel (cross-flow) | nappe d'air large, très plat, silencieux | faible (≈ 0,2–0,4, à vérifier)[21][22] | standard des splits ; à éviter pour gagner des watts

### Jeu en bout de pale

Passer de 0,3 % à 0,1 % du diamètre gagne ≈ 2 points de rendement[27] ; en dessous de 5 % de la hauteur de pale, le rendement baisse linéairement avec le jeu[26]. Avec une virole partielle, il existe un jeu optimal non nul[25]. Les solutions (anneau tournant, roulement périphérique, rim-driven) sont comparées plus bas, section Jeu en bout de pale.

## Pales récentes des fabricants

Produit | Ce qui change | Gain annoncé (chiffre fabricant)
ebm-papst AxiBlade / AxiBlade.Perform (2025)[10][11] | profil aile, winglets intégrés, aubes directrices, diffuseur | jusqu'à +54 % de rendement, −8 dB ; η statique ≤ 53 %
ebm-papst AxiTop[12] | diffuseur seul | −27 % de puissance et −7,2 dB(A), ou +9 % de débit
Ziehl-Abegg FE2owlet[14][16] | pales en faucille, bord de fuite dentelé, winglets | −4 dB(A) ; version Mahle : +10 % de rendement, −10 % de masse
Ziehl-Abegg ZAbluefin[15] | centrifuge, bord d'attaque ondulé (nageoire de baleine) | +10 à +15 % selon les sources
LG MULTI V 5[20] | pales inspirées de la baleine | −20 % de consommation
Sharp[17][18] | roue sirocco « aile de libellule » ; hélice extérieure aigle / albatros / martinet | −2,5 dB mesurés (sirocco) ; extérieur : qualitatif

Aucun de ces chiffres n'est accompagné d'une norme d'essai ou d'une référence de comparaison publiée.

## Biomimétisme : ce que dit la recherche

Les motifs bio-inspirés, dessinés schématiquement sur une même pale.

Modèle naturel | Motif | Effet mesuré | Prix à payer
Chouette | dents de bord d'attaque, peigne de bord de fuite | −3 à −5 dB à moyenne et haute fréquence[1] ; hélice avec les deux : −3,1 dB et +7,9 % de rendement de poussée[3] | sous 15° d'incidence, l'aéro se dégrade[2] ; dents longues = moins de bruit mais moins de rendement[4]
Baleine à bosse | tubercules sinusoïdaux au bord d'attaque | décrochage retardé, tourbillons de bout réduits, couple réduit (hélices, CFD)[5][7] ; ventilateurs : chiffres commerciaux seulement[6] | léger déficit au point nominal ; gain surtout hors nominal
Libellule | section ondulée | −2,5 dB (sirocco Sharp)[17] ; rigidité d'une pale très mince | profil plus délicat à mouler
Harle (oiseau) | profil d'aile sur roue tangentielle | −3,3 % de puissance à débit égal[19] | gain modeste
Bout d'aile d'oiseau | winglets, faucille | réduit le tourbillon de bout de pale[25] | —

Pour nous. Quand la batterie extérieure givre, sa perte de charge monte et le ventilateur passe à faible débit et forte incidence : c'est là que tubercules et dentelures sont favorables (décrochage retardé, moins de bruit de décrochage tournant). C'est l'argument le plus solide pour un motif bio-inspiré dans la PAC. Revues générales : [8][9][7].

## Moteur : petit BLDC piloté en FOC sans capteur

Rendement des moteurs de ventilateur, ordres de grandeur[29].

- Pourquoi : rendement élevé et presque plat en charge partielle, vitesse continue (on suit la puissance de la PAC au lieu de trois vitesses), démarrage doux, et le couple mesuré à vitesse donnée révèle l'encrassement ou le givre.
- Moteur : rotor extérieur intégré au moyeu, la cloche sert de moyeu.
- Alimentation : bus DC commun (24 V, ou bus haute tension de l'onduleur du compresseur) : à trancher avec l'électronique de la PAC.

Circuit | Type | Points forts | Usage
TI MCF8316A / C / D[30][31] | FOC sans capteur, MOSFET intégrés, 4,5–35 V, 8 A crête | aucun code, identification automatique du moteur, consigne PWM / analogique / I²C | prototype
Fortior FT8132[32] | pré-driver FOC sans capteur, MOSFET externes, 28 V | réglage par interface graphique, paramètres en EEPROM ; famille FT8213 / FT8215 / FS9276 | grande série, bas coût
Infineon iMOTION IMD110, ST STSPIN32 | contrôleur FOC intégré | à évaluer | alternatives

## Un ventilateur EC du commerce, mesuré

Courbes fabricant du ventilateur déjà utilisé par le simulateur (ventilateurs/W1G200-EC87-20.json).

Même un bon ventilateur EC de 200 mm plafonne à η = 0,26 à son meilleur point : l'hypothèse de 0,30 du cahier des charges correspond à un bon produit standard, pas à un objectif ambitieux.

## Pourquoi le rendement est si bas

Quatre causes se cumulent ; les deux premières sont physiques et nous suivent quel que soit le dessin.

1. Pression utile faible : l'air qui sort emporte une grosse part de l'énergie. Le rendement statique ne compte que la pression gagnée sur la batterie. W1G200 à 320 m³/h : section annulaire ≈ 250 cm², air sortant à 3,5 m/s, ½ρc² ≈ 7,5 Pa perdus, soit 25 % de la pression totale. À 1 000 Pa (centrifuge) ce serait négligeable ; à 25 Pa c'est structurel.
2. Faible nombre de Reynolds. Re = vitesse × corde / viscosité ≈ 55 000 pour le W1G200, ≈ 100 000 pour un rotor de 500 mm à 600 tr/min, contre ≈ 10⁷ pour une aile d'avion. Sous ≈ 10⁵ la finesse d'un profil tombe de ≈ 100 à 20–40 (couche limite laminaire, bulle de décollement). C'est le régime des oiseaux et des insectes : profils minces cambrés, dentelures et ondulations y sont adaptés.
3. Bout de pale et giration. 1 à 2 mm de jeu sur 200 mm, c'est 3 à 10 fois plus en proportion que sur un grand ventilateur ; sans stator, la rotation de l'air en sortie est perdue.
4. Petit moteur et électronique. À 8 W, roulements, pertes fer, alimentation de la commande et redresseur 230 V pèsent lourd : ≈ 60–70 % pour le moteur, contre plus de 90 % à 1 kW.

Où part l'électricité. Première ligne : estimation pour le W1G200 (seules l'entrée et la sortie viennent de la fiche). Lignes suivantes : modèle de l'animation, à la vitesse qui donne 2 500 m³/h.

Cas (modèle de l'animation) | tr/min | m³/h | P élec. W | η global | Reynolds | w₂/w₁ (décroche < 0,62)
W1G200 (banc, modèle) | 1300 | 302 | 7,0 | 0,25 | 36 k | 0,65
Extérieur 300 mm | 2204 | 2 500 | 101,0 | 0,17 | 121 k | 0,86
Extérieur 500 mm, base | 616 | 2 499 | 41,1 | 0,42 | 80 k | 0,74
Extérieur 500 mm, optimisé | 559 | 2 501 | 29,4 | 0,59 | 75 k | 0,79
Intérieur 280 mm, optimisé | 1016 | 800 | 10,3 | 0,54 | 46 k | 0,79

Ce que nous pouvons attaquer : le moteur et l'électronique (BLDC + FOC à 15–40 W : 80–85 %), l'air sortant et la giration (diffuseur, stator), le bout de pale (anneau). Le faible Reynolds ne se supprime pas, il se repousse : grand diamètre, corde large, profil choisi pour ce régime. D'où la cible revue de 0,45–0,55. Le modèle de l'animation donne ≈ 0,6 pour la version optimisée : il est optimiste (une seule section de pale, écoulement idéal derrière la batterie).

## Jeu en bout de pale : anneau, roulement, rim-driven

Coupes schématiques du bout de pale. Rouge : fuite d'air de l'aval vers l'amont.

Solution | Pour | Contre | Décision
Pales libres, jeu serré | simple | perte ≈ 2,85 × jeu / hauteur de pale[26] ; bruit de jeu ; tolérances serrées | référence
Anneau tournant fixé aux pales (« ring fan », ventilateurs automobiles) | plus de tourbillon de bout de pale ; la fuite passe entre anneau et carter, moins nuisible, freinée par un joint sans contact (lèvre dans une gorge du pavillon, labyrinthe) ; pales rigidifiées, donc plus minces ; 2–3 mm de jeu tolérés (fabrication, givre) | frottement de l'air sur l'anneau ≈ 1 W à 500 mm ; un peu d'inertie | retenu : à comparer en CFD (jeu 1 à 3 mm)
Anneau porté par un roulement en périphérie | — | couple de frottement ∝ diamètre : graisse et joints d'un roulement fin de 500 mm, quelques à plusieurs dizaines de W à 600 tr/min (à vérifier sur catalogue) ; givre, eau et poussière dans le contact ; bruit transmis au carter ; coût | écarté
Moteur en périphérie (rim-driven) | plus de moyeu : +14 % de section (moyeu 0,35 D), −23 % d'énergie de l'air sortant | entrefer ≈ 1 mm sur 500 mm de diamètre, aimants coûteux, paliers à l'air froid et humide | intéressant mais trop cher : hors premier prototype

Gain attendu de l'anneau : quelques points de rendement (2 à 5 estimés, pas encore de mesure sur un ventilateur comparable).

## Quelle pale pour notre système

Notre cas : axial basse pression (25 Pa), rotor de 500 mm à ≈ 500–600 tr/min à l'extérieur, 280 mm à ≈ 1 000 tr/min à l'intérieur, Reynolds de pale 50 000–150 000. Ce que dit la recherche, point par point :

Choix | Ce que dit la recherche | Pour nous
Profil | Sous Re ≈ 10⁵, la plaque cambrée mince (arc de cercle, ≈ 3 % d'épaisseur, bord d'attaque arrondi) vaut ou bat les profils épais type NACA : leur traînée explose à bas Reynolds, pas celle de la plaque[33][34]. Modèles mesurés de portance et traînée : Re 40 000–140 000, cambrure 0–8 %, C_L 0–1,3, C_D 0,02–0,14[33]. Au-dessus de ≈ 1,5·10⁵, les profils minces dessinés pour le bas Reynolds (famille SD, Selig) deviennent intéressants[35]. | plaque cambrée 4–7 %, épaisseur 3 %, bords arrondis : simple à imprimer et à mouler, légère
Nombre de pales et corde | Les hélices d'unités extérieures de PAC sont à 3 pales très larges, semi-carénées[42]. Exemple publié : 401 mm, 3 pales, moyeu 0,25, corde 67 → 318 mm du pied au bout, calage 46 → 69°, 839 tr/min, 1 780 m³/h, rendement total 65 → 68 % après optimisation[36]. | 3 à 4 pales larges : à solidité égale, la corde double et le Reynolds aussi (≈ 150 000 au lieu de 75 000)
Répartition le long de la pale | Passer d'un tourbillon libre à un tourbillon contrôlé (pied de pale moins chargé) : +4,2 points[38] ; à faible rapport moyeu / diamètre, +3,9 à 4,6 points de rendement[37]. Un tourbillon contrôlé crée des migrations radiales : il faut redessiner les sections en conséquence[39]. | tourbillon contrôlé, moyeu 0,25–0,30 (le BLDC à rotor extérieur tient dans 100–150 mm)
Faucille | Faucille avant au bout de pale : +3 points et −1,1 dB sur le ventilateur de PAC de 401 mm[36] ; moins de fluctuations de pression en paroi et moins de bruit sur un 495 mm[40]. Hors point nominal (faible débit), la faucille arrière est plus silencieuse[41]. | faucille avant modérée ; à vérifier en conditions de givre
Bout de pale | Anneau tournant + chevauchement axial avec le carter = joint à labyrinthe ; l'anneau améliore le rendement volumétrique, la fuite résiduelle fait du bruit quand la pale est très chargée[46][45]. | anneau tournant + labyrinthe (déjà retenu)
Pavillon et installation | Pavillon redessiné : +1,2 %[44]. Une pale optimisée montée dans l'unité fait mieux qu'une pale optimisée seule ; les gros changements sont au bout de pale[43]. L'air qui arrive de la batterie n'est pas uniforme : décollements et bruit[42]. | optimiser la pale avec la batterie et le pavillon dans la CFD, pas isolée
Bords | Bord de fuite dentelé : −2 à −4 dB, petit coût ; tubercules : marge au décrochage (voir Biomimétisme). | bord de fuite dentelé ; tubercules en option pour le givre

### Nombre de pales, avec le modèle de l'animation

Rotor extérieur 500 mm optimisé (anneau, diffuseur, stator, calage 34°) | tr/min | Reynolds | P élec. W | η global
9 pales, corde 85 mm, plaque | 512 | 52 k | 31,5 | 0,552
9 pales, corde 85 mm, profil bas Re | 502 | 51 k | 29,5 | 0,589
7 pales, corde 110 mm, plaque | 509 | 67 k | 31,0 | 0,560
7 pales, corde 110 mm, profil bas Re | 500 | 66 k | 29,2 | 0,594
5 pales, corde 150 mm, plaque | 508 | 92 k | 30,6 | 0,568
5 pales, corde 150 mm, profil bas Re | 500 | 91 k | 29,0 | 0,600
4 pales, corde 190 mm, plaque | 506 | 116 k | 30,3 | 0,574
4 pales, corde 190 mm, profil bas Re | 498 | 115 k | 28,7 | 0,604
3 pales, corde 250 mm, plaque | 505 | 152 k | 30,0 | 0,580
3 pales, corde 250 mm, profil bas Re | 498 | 151 k | 28,6 | 0,608

À solidité comparable, moins de pales plus larges gagnent ≈ 1,5 point et tournent moins vite (moins de bruit) ; le profil bas Reynolds gagne 3 à 4 points sur la plaque standard. Ces écarts viennent directement de la loi de traînée supposée dans le modèle (voir les hypothèses de l'animation) : ce sont des tendances, que la CFD devra chiffrer.

### Pale de départ proposée

extérieur : Ø 500 mm, moyeu 0,25–0,30, 3 à 4 pales, corde ≈ 150 mm au pied → 220–250 mm au bout plaque cambrée arc de cercle 3 % d'épaisseur, cambrure 5–6 %, bords arrondis tourbillon contrôlé, faucille avant modérée, anneau tournant + labyrinthe, pavillon soigné bord de fuite dentelé ; ≈ 500–550 tr/min ; BLDC rotor extérieur + FOC intérieur : Ø 280 mm, même famille, 5 pales, corde ≈ 90–110 mm (Re ≈ 70 000–100 000 : la plaque cambrée s’impose)

## Les autres formes de roue : blower, centrifuge, tangentielle

Les grandes formes de roue, vues de face (schémas).

### Ce que fait un climatiseur de fenêtre classique

Un seul moteur à double arbre, en général asynchrone PSC à 3 vitesses, entraîne à la fois la roue blower côté pièce et l'hélice « slinger » côté extérieur[47][48]. La roue blower est une centrifuge à aubes avant ; elle souffle l'air de la pièce à travers l'évaporateur. La slinger est une hélice axiale à anneau en bout de pales : c'est déjà un « ring fan ». Elle aspire l'air à travers le condenseur et projette l'eau de condensation du bac sur la batterie.

| Fenêtre classique | Notre PAC
Moteurs | 1 moteur PSC à double arbre (30–50 %) | 2 BLDC + FOC indépendants (80–85 %)
Vitesses | liées entre elles, 3 crans | continues, réglées séparément (dégivrage : extérieur seul, intérieur arrêté)
Intérieur | roue blower : compacte, lente, silencieuse, tourne l'air de 90° | à choisir (tableau ci-dessous)
Extérieur | hélice axiale à anneau (slinger) | axiale à anneau + labyrinthe (même famille, mieux dessinée)
Eau de condensation | projetée sur le condenseur (gain de capacité en clim) | piste à garder en clim ; en chauffage, la batterie extérieure givre : pas de slinger

### Familles de roues

Famille | Forme des aubes | Coef. de pression ψ | Rendement de pointe publié | Points forts | Points faibles
Roue blower (sirocco, centrifuge aubes avant) | 36 à 60 aubes courtes, courbées vers l'avant | ≈ 2–3 | statique 0,55–0,68[49][51] (grandes roues) | très compacte et lente pour un débit donné, silencieuse, courbe plate | rendement plus bas ; puissance qui monte avec le débit ; la volute compte beaucoup (+5 %[54], −6,4 dB[55])
Centrifuge aubes arrière (roue libre, EC) | 6 à 12 aubes longues, courbées vers l'arrière, parfois profilées | ≈ 0,8–1,1 | statique ≤ 0,80, profilée ≤ 0,84[51][50] ; module EC de 250 mm : global 0,47–0,56[52][53] | le meilleur rendement, courbe stable, puissance plafonnée | plus grosse et plus rapide qu'une blower ; à l'aise à des centaines de Pa, pas à 25 Pa
Centrifuge aubes radiales | aubes droites | ≈ 1–2 | plus bas | robuste, s'encrasse peu | rendement et bruit : sans intérêt ici
Tangentielle (cross-flow) | tambour à aubes avant, l'air le traverse | ≈ 2 | faible[21][22] | nappe d'air large et plate, silencieuse : le standard des splits muraux | rendement le plus bas, sensible au tourbillon interne
Diagonale | pales en hélice sur un moyeu conique | ≈ 0,4–0,6 | ≈ 0,48–0,56[28] | entre les deux | encombrement axial
Axiale | pales en hélice | ≈ 0,1–0,3 | 0,45–0,60 avec diffuseur | grand débit, faible pression : notre extérieur | besoin de diamètre ; l'air ne tourne pas tout seul de 90°

ψ = 2Δp / (ρu²), avec u la vitesse en bout de roue. Plus ψ est grand, plus la roue est petite et lente pour une même pression. Les rendements publiés sont ceux de grandes roues ; à petite taille, tous perdent des points, pour les raisons de la section « Pourquoi le rendement est si bas ».

### Côté intérieur : quelle roue pour 800 m³/h ?

Famille | ψ (coef. de pression) | Taille pour 800 m³/h | tr/min | u bout m/s | Rendement statique de pointe publié
Roue blower (aubes avant) | 2,5 | Ø 160 × 171 mm de large | 616 | 5,2 | 0,55–0,68 (grandes roues)
Centrifuge aubes arrière | 1,0 | Ø 250 × 139 mm de large | 624 | 8,2 | ≤ 0,80 (grandes roues)
Tangentielle | 2,0 | Ø 100 × 642 mm de large | 1103 | 5,8 | faible, à vérifier
Axiale (avec virage dans un caisson) | 0,2 | Ø 280 mm | 1245 | 18,3 | 0,45–0,60 avec diffuseur

Hypothèses : 40 Pa à fournir (25 Pa de batterie + ≈ 15 Pa de grille et de virage de l'air) ; coefficients de débit supposés de 0,5 (blower), 0,25 (aubes arrière) et 0,6 (tangentielle) ; diamètre choisi pour chaque famille. Ce sont des ordres de grandeur pour comparer les encombrements, pas un dimensionnement.

Lecture. À l'extérieur, l'axiale à anneau reste le bon choix : grand débit, 25 Pa, et la place existe côté façade. À l'intérieur, tout dépend de la place dans la fenêtre. La roue blower fait 800 m³/h avec une roue de Ø 160 mm à ≈ 600 tr/min : c'est pour cela que les climatiseurs l'utilisent. Elle tourne l'air de 90° sans caisson et reste très silencieuse, mais rend moins bien. L'axiale de 280 mm rend mieux, à condition d'avoir la profondeur et un caisson pour tourner l'air. La centrifuge à aubes arrière n'est intéressante que si la perte de charge intérieure dépasse nettement 25 Pa (filtre, grilles). À trancher avec la géométrie de la fenêtre : c'est la même question que le diamètre maximal.

## Même ventilateur et même échangeur des deux côtés

Attention : le ventilateur n'est pas encore dessiné. Les puissances ci-dessous viennent du modèle de l'animation appliqué à la pale de départ proposée (axiale 500 mm, 3 pales), une hypothèse de travail, pas une conception.

Idée : un seul module (batterie + ventilateur de 500 mm) monté deux fois, l'un côté pièce, l'autre côté façade. Il est dimensionné sur le cas le plus dur côté extérieur. Avec les Te et Tc actuels de la fiche échangeur, ce cas n'est plus le chauffage à −8,3 °C mais la clim à 35 °C : 1 104 W/K à 2 500 m³/h (contre 897 W/K à −8,3 °C). Les deux côtés ont alors le même circuit d'air : seule la vitesse du ventilateur change. Calcul : conception_ventilateur/outils/module_commun.py (besoins de la fiche échangeur, hA ∝ débit^0,6, modèle du ventilateur de l'animation).

### Débits et puissances avec le module commun

Point | Intérieur | Extérieur | Ventilateurs | Budget actuel (fiche)
Clim 95 °F (35 °C) | 570 m³/h · 125 tr/min · 1,4 W | 2 500 m³/h · 498 tr/min · 28,6 W | 30 W | 72 W
Chauffage 47 °F (8,3 °C) | 830 m³/h · 177 tr/min · 2,2 W | 1 690 m³/h · 345 tr/min · 10,2 W | 12 W | 76 W
Chauffage 17 °F (−8,3 °C) | 830 m³/h · 177 tr/min · 2,2 W | 2 160 m³/h · 434 tr/min · 19,3 W | 22 W | 76 W
Chauffage 5 °F (−15 °C) | 830 m³/h · 177 tr/min · 2,2 W | 1 700 m³/h · 346 tr/min · 10,3 W | 13 W | 76 W

- Le ventilateur reste à son point de dessin à toutes les vitesses : même batterie, même circuit, donc mêmes triangles des vitesses. Seul le Reynolds baisse à bas régime (≈ 36 000 à 125 tr/min), d'où un rendement plus faible côté pièce, sur une puissance de 1 à 2 W.
- Côté pièce, il tourne à 125–180 tr/min : vitesse en bout de pale de 3 à 5 m/s, quasi inaudible.
- La batterie intérieure est plus grande que nécessaire, et c'est une chance : on peut baisser la température de condensation (tableau ci-dessous).

### Ce que permet la batterie intérieure plus grande (chauffage 8,3 °C)

Débit intérieur m³/h | Tc possible °C | Air soufflé °C | Compresseur W | Ventilateur intérieur W | Bilan
830 | 32,0 | 30,6 | 355 | 2,2 | 0 W
1 000 | 30,4 | 28,9 | 335 | 3,1 | −19 W
1 200 | 29,0 | 27,6 | 318 | 4,5 | −35 W
1 500 | 27,7 | 26,3 | 302 | 7,6 | −48 W
2 500 | 25,4 | 24,2 | 273 | 28,6 | −56 W

Tc la plus basse pour laquelle la batterie intérieure du module suffit, cycle de la fiche échangeur (Te = 3,5 °C, η_is = 0,75). À 1 200 m³/h, on gagne ≈ 35 W, soit ≈ 10 % de la puissance électrique, pour un air soufflé un peu moins chaud ; au-delà, le gain continue mais l'air soufflé descend sous 27 °C (sensation de courant d'air tiède). À confirmer avec la fiche échangeur (résistance côté propane, givre).

### Points à vérifier

Point | Pourquoi | Avec qui
Encombrement côté pièce | une batterie de ≈ 0,4–0,5 m² de façade et un rotor de 500 mm aussi à l'intérieur | géométrie de la fenêtre
Charge de propane | deux batteries identiques au volume maximal : le cahier des charges admet déjà ≤ 279 cm³ chacune ; plus de surface d'ailettes pour le même volume | dossier échangeur
Eau | le module doit évacuer le condensat (clim, côté pièce) et dégivrer (chauffage, côté façade) : il le doit déjà, l'échangeur étant réversible | dossier échangeur
Moteur | le même BLDC doit tourner de 125 à 500 tr/min et fournir de 1,4 à 30 W : FOC sans capteur possible avec un moteur multipolaire (fréquence électrique suffisante) ; reprise d'un rotor que le vent fait tourner, côté façade | électronique
Jet d'air dans la pièce | ≈ 0,5 m/s en façade de batterie : la grille de soufflage doit porter l'air | conception

## Étapes suivantes

1. Fixer le diamètre maximal disponible dans la fenêtre pour chaque ventilateur.
2. Refaire le budget de ventilation avec la pression totale (batterie + perte de sortie − récupération du diffuseur), aussi dans conception_echangeur/outils/analytique/pac_calc.py.
3. Pale axiale de base (méthode de l'élément de pale, ψ ≈ 0,2), puis comparaison en CFD 3D (OpenFOAM, MRF) : stator redresseur, diffuseur, tubercules, bord de fuite dentelé, winglets, anneau tournant (jeu 1 à 3 mm, avec et sans labyrinthe). Profil choisi pour Re ≈ 50 000–100 000.
4. Batterie extérieure givrée : vérifier que la pale ne décroche pas quand la perte de charge double.
5. Prototype : pale imprimée en 3D, moteur BLDC rotor extérieur, carte d'évaluation MCF8316, banc débit / pression / puissance (ISO 5801).

## Sources

1. Agrawal et Sharma, bords d'attaque dentelés type chouette (AIAA 2016), Iowa State (https://dr.lib.iastate.edu/entities/publication/7628929b-0c75-4202-8ecc-9e165a324645)
2. Chiba University, dentelures et incidence (Bioinspir. Biomim. 2017) (https://www.sciencedaily.com/releases/2017/07/170704093621.htm)
3. Hélice à dentelures de chouette bord d'attaque + fuite (Phys. Fluids 2025) (https://www.ebsco.com/articles/chemistry/a2779745-54b9-5e5a-a4fc-1d678df0ef2d/experimental-investigation-of-a-biomimetic-propeller-coupled-with-owl-inspired-l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)
4. Mémoire PolyU, densité et longueur des dentelures (2019) (https://theses.lib.polyu.edu.hk/handle/200/10116)
5. Falchi et al., tubercules sur hélices marines (Ocean Eng. 2022) (https://strathprints.strath.ac.uk/80727/1/Falchi_etal_OE_2022_effect_of_leading_edge_tubercles_on_the_performance_of_marine_propellers.pdf)
6. WhalePower, tubercules (MIT Technology Review 2008) (https://www.technologyreview.com/2008/03/06/221447/whale-inspired-wind-turbines/)
7. Revue : rotors axiaux à bord d'attaque sinusoïdal (Energies 2024) (https://doaj.org/article/49e25c189677480097639621c0b9dfc4)
8. Revue : bio-inspiration et bruit aérodynamique (Appl. Sci. 2019) (https://mdpi.com/2076-3417/9/11/2224)
9. Revue : pales bio-inspirées éolien et marin (2025) (https://tethys-engineering.pnnl.gov/sites/default/files/publications/RevathiRamakrishnan-2025.pdf)
10. ebm-papst, AxiBlade.Perform (2025) (https://www.ebmpapst.com/ae/en/newsroom/news/2025/new-axiblade-perform-ec-technology.html)
11. ebm-papst, genèse de l'AxiBlade (https://mag.ebmpapst.com/en/?p=11258)
12. ebm-papst, diffuseur AxiTop (https://www.climatecontrolnews.com.au/news/axitop-sets-new-standard-in-acoustics)
13. ebm-papst, axial ou centrifuge pour PAC (https://www.ebmpapst.com.cn/en/newsroom/news/2020/fans-for-air-water-heat-pumps.html)
14. Ziehl-Abegg, bionique (https://www.ziehl-abegg.com/en/glossary/bionics-biomimetics)
15. Ziehl-Abegg, ZAbluefin (https://www.climatecontrolnews.com.au/interviews/bionic-profiling-delivers-peak-efficiency)
16. Mahle, ventilateur « chouette » (New Atlas) (https://newatlas.com/automotive/mahle-biomimetic-owl-cooling-fan)
17. Sharp, roue sirocco « libellule » (rapport technique) (https://corporate.jp.sharp/rd/n39/pdf/107_09.pdf)
18. Sharp, biomimétisme de l'unité extérieure (https://www.vn.sharp/en/microsite/biomimetic/air-conditioner-outdoor)
19. Roue tangentielle à pales d'aile de harle (Xi'an Jiaotong) (https://scholar.xjtu.edu.cn/zh/publications/%E9%87%87%E7%94%A8%E4%BB%BF%E7%A7%8B%E6%B2%99%E9%B8%AD%E7%BF%BC%E5%9E%8B%E5%8F%B6%E7%89%87%E8%B4%AF%E6%B5%81%E9%A3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)
20. LG, biomimétisme dans le HVAC (https://www.lghvacstory.com/?p=3076)
21. Vanaei et al., revue des ventilateurs tangentiels (Energies 2023) (https://sam.ensam.eu/bitstream/10985/26216/2/LIFSE_E_2023_VANAEI.pdf)
22. Himeur et al., performance des ventilateurs tangentiels (Energies 2022) (https://mdpi.com/1996-1073/15/14/5134/htm)
23. Wang, Ravelet, Bakir, ventilateurs contrarotatifs (2015) (https://sam.ensam.eu/bitstream/10985/9486/3/Dynfluid-JEPS-WANG-2015-1.pdf)
24. Contrarotatif : espacement et répartition de charge (https://pdf.arxiv.org/pdf/1208.6396)
25. Jeu en bout de pale, winglets, hauteur de virole (IIR) (https://iifiir.org/en/fridoc/effect-of-tip-clearance-winglets-and-shroud-height-on-the-tip-141441)
26. Jeu en bout de pale, ventilateur de 806 mm (https://koreascience.kr/article/JAKO200806135603722.page?lang=ko)
27. Jeu en bout de pale : 0,3 % → 0,1 % du diamètre (https://core.ac.uk/download/357550149.pdf)
28. ebm-papst DiaForce, ventilateur diagonal (DigiKey) (https://www.digikey.com/en/articles/high-performance-cooling-diagonal-compact-fans)
29. DigiKey, rendements EC / PSC / pôles ombragés (https://www.digikey.com/en/articles/ac-input-electronically-commutated-fans)
30. TI MCF8316A, FOC sans capteur (https://www.ti.com/product/MCF8316A)
31. TI MCF8316D (https://www.ti.com/product/MCF8316D)
32. Fortior FT8132, fiche technique (https://shop.mev-elektronik.com/wp-content/uploads/FT8132Q.pdf)
33. Balla et Vad, coefficients de portance et traînée des plaques cambrées à bas Reynolds (AIAA J. 2022) (https://real.mtak.hu/205592/1/Balla_Vad_resubmit_final_repositoriumba.pdf)
34. Koning, Romander, Johnson, profils à très bas Reynolds (NASA Ames, AIAA 2020) (https://rotorcraft.arc.nasa.gov/Publications/files/koningAIAA2020.pdf)
35. McGranahan et Selig, profils bas Reynolds (AIAA 2003, UIUC) (https://m-selig.web.engr.illinois.edu/pubs/McGranahanSelig-2003-AIAA-2003-4067-LRN-Airfoils.pdf)
36. Ventilateur axial à faucille avant pour PAC, optimisation (Frontiers Energy Res. 2021) (https://www.frontiersin.org/journals/energy-research/articles/10.3389/fenrg.2021.700365/full)
37. Jie Wang, ventilateurs axiaux basse pression : faucille et distribution de tourbillon (thèse Twente 2021) (https://www.utwente.nl/en/et/events/2021/12/258645/phd-defence-jie-wang-design-for-high-efficiency-of-low-pressure-axial-fans-use-of-blade-sweep-and-vortex-di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)
38. Tourbillon contrôlé à partir d'un tourbillon libre : +4,2 points (J. Appl. Fluid Mech. 2025) (https://doaj.org/article/ad577dee349946238ff246414e6c18b2)
39. Faucille avant et pales à tourbillon contrôlé, ventilateurs sans stator (Vad et al.) (https://katalog.lib.cas.cz/KNAV/EdsRecord/edsair,edsair.doi.dedup.....99d0ad5fba65dabcd33e17d129c3a276)
40. Sanjosé et al., faucille et bruit, ventilateur de 495 mm (Lattice Boltzmann, ETS 2022) (https://espace2.etsmtl.ca/26128/1/Sanjose-M-2022-26128.pdf)
41. Revue : faucille, bruit et rendement des ventilateurs basse pression (Acoustics 2020) (https://mdpi.com/2624-599X/2/4/43)
42. Iwase et Kishitani, hélice semi-carénée d'unité extérieure, optimisation CFD + algorithme génétique (https://www.jstage.jst.go.jp/article/tsj/43/6/43_325/_article/-char/en)
43. Optimisation de pales en tenant compte de l'unité extérieure (Int. J. Refrig., vol. 175) (https://iifiir.org/en/fridoc/aerodynamic-optimization-of-axial-fans-mounted-on-outdoor-air-151002)
44. Pavillon redessiné : +1,2 % de rendement d'unité extérieure (IIR) (https://iifiir.org/en/fridoc/aerodynamic-performance-improvement-of-up-flow-outdoor-unit-of-air-137908)
45. Ventilateurs à virole tournante : bruit de fuite (Gênes, ETC 2019) (https://iris.unige.it/bitstream/11567/963706/4/ETC2019-368.pdf)
46. Brevet US9903387B2, ventilateur à anneau et carénage (https://patents.google.com/patent/US9903387)
47. Friedrich, manuel de service : moteur à double arbre, roue blower intérieure, hélice « slinger » extérieure (https://lawnandgarden.manualsonline.com/manuals/mfg/friedrich/cp24n30.html?p=7)
48. Moteur PSC à double arbre pour climatiseur de fenêtre (Fasco D367) (https://www.supplyhouse.com/Fasco-D367-3-Speed-1550-RPM-Window-A-C-Motor-115V)
49. Bureau of Energy Efficiency (Inde), ventilateurs : rendements par famille (https://beeindia.gov.in/sites/default/files/3Ch5.pdf)
50. ASHRAE Handbook, chapitre 21 : ventilateurs (https://handbook.ashrae.org/Handbooks/S20/IP/s20_ch21/s20_ch21_ip.aspx)
51. Sélection des ventilateurs de traitement d'air (rapport d'application J1000) (https://www.precision-elec.com/wp-content/uploads/2020/11/J1000-Application-Report-Fan-Selection-for-Air-Handling.pdf)
52. ebm-papst K3G250-RR02-I2, centrifuge EC aubes arrière 250 mm : rendement global 56 % (https://media.onlinecomponents.com/upload/globalresourcefiles/ebm-papst%20-%20k3g250-rr02-i2.pdf)
53. ebm-papst R3G250-AM50-01, centrifuge EC 250 mm à 11 aubes : rendement global 47 % (https://www.mouser.com/catalog/specsheets/ebm_papst_R3G250AM5001.pdf)
54. Optimisation de la volute d'une roue sirocco : +5 % de rendement (Du et al.) (https://scite.ai/authors/shouhua-du-6gv30k)
55. Volute courbe d'une roue multi-aubes : −4,6 % de puissance, −6,4 dB (Xi'an Jiaotong 2025) (https://scholar.xjtu.edu.cn/en/publications/numerical-and-experimental-study-on-the-effects-of-curved-volute-/)
56. Greenheck, sélection de base d'un ventilateur (https://webcontent.greenheck.com/atg-cms-prod/docs/default-source/pdf-downloads/industry-articles/hpac_basic-fan-selection.pdf)
