ET-FR/HP_new_generation/conception_echangeur/docs/rapport_cfd.html

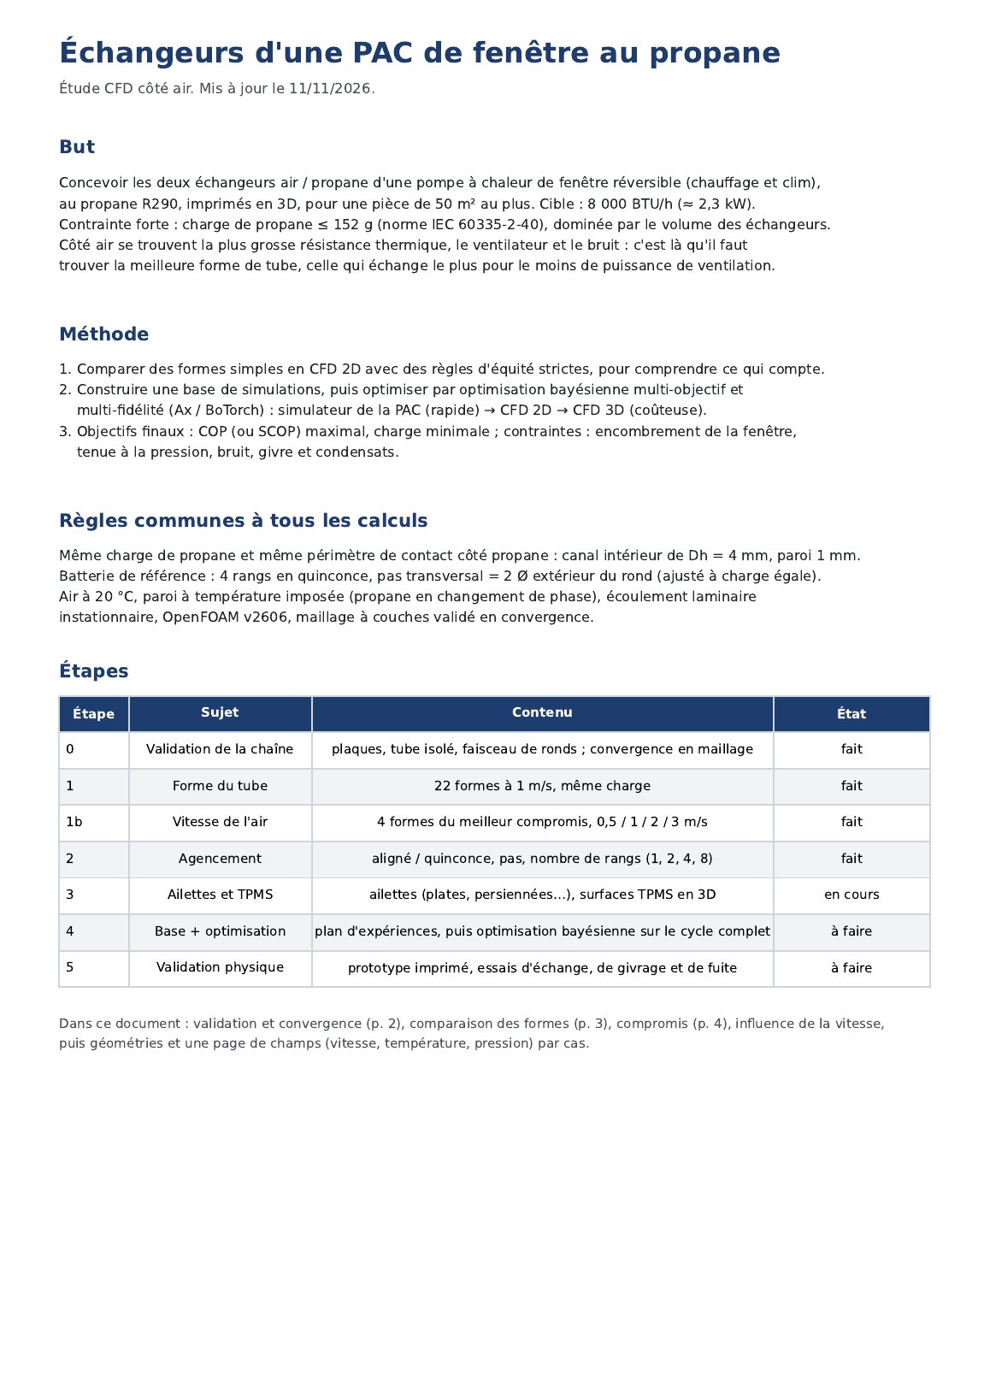
[picture p2: conception_echangeur/docs/rapport_cfd/pages/p-01.jpg]
Échangeurs d'une PAC de fenêtre au propane


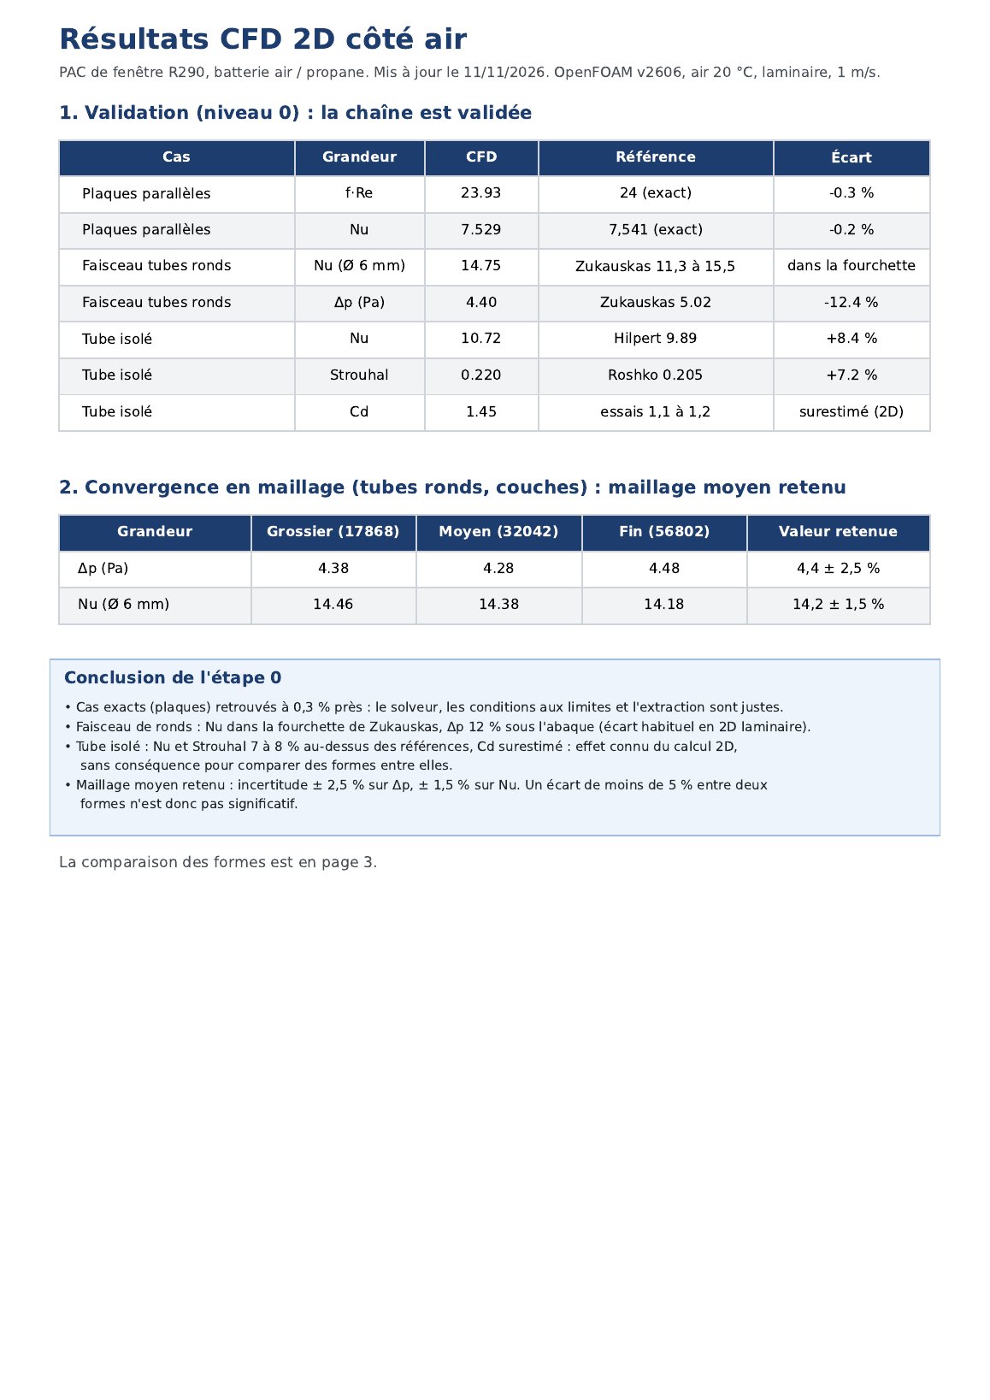
[picture p3: conception_echangeur/docs/rapport_cfd/pages/p-02.jpg]
Résultats CFD 2D côté air


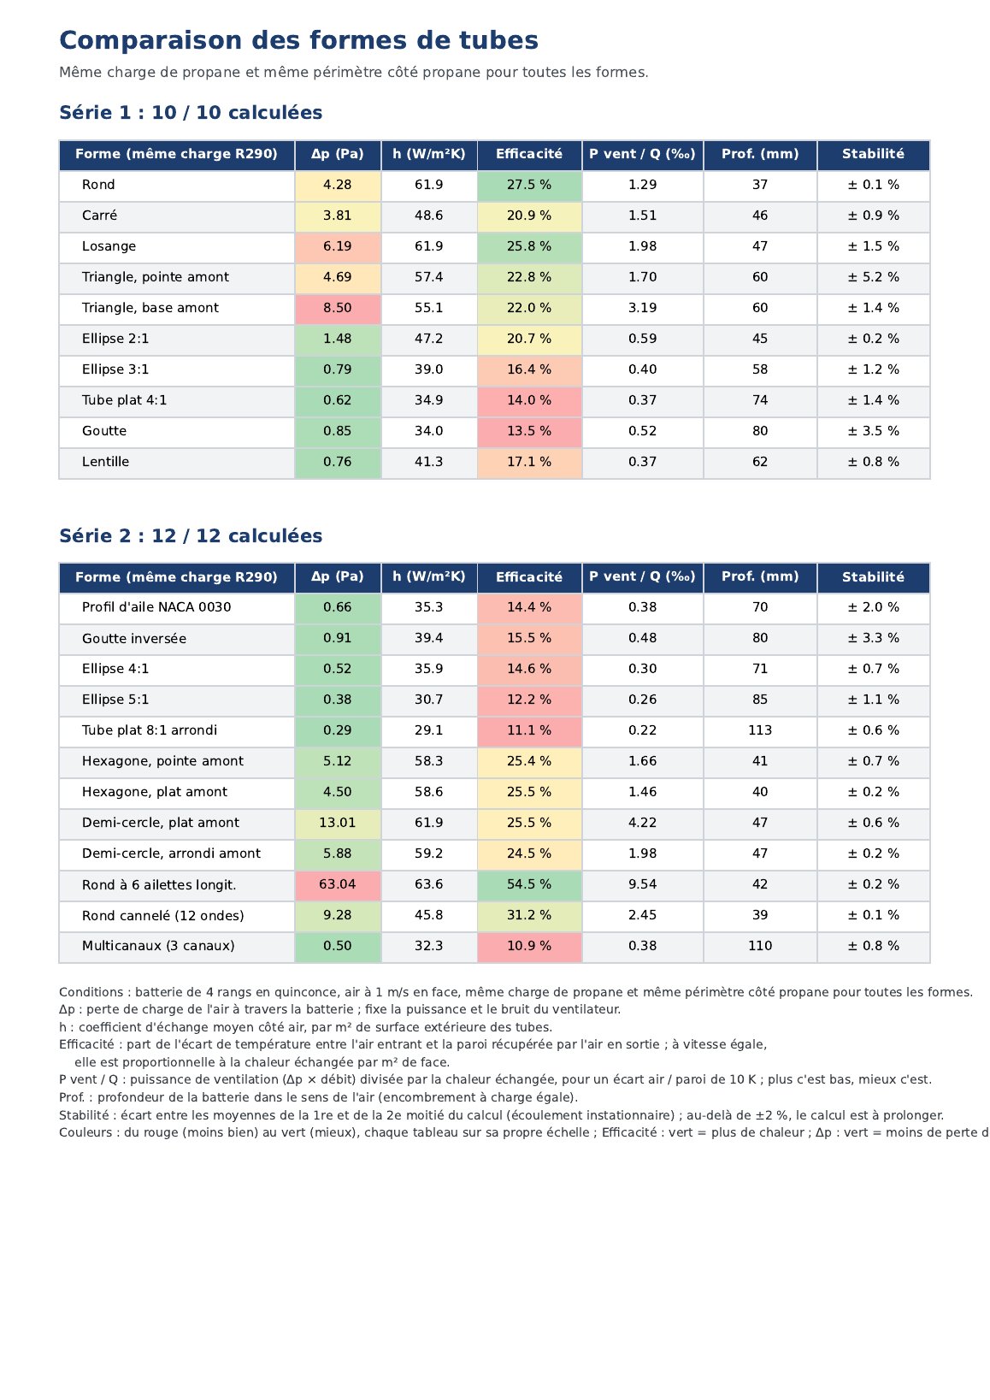
[picture p4: conception_echangeur/docs/rapport_cfd/pages/p-03.jpg]
Comparaison des formes de tubes


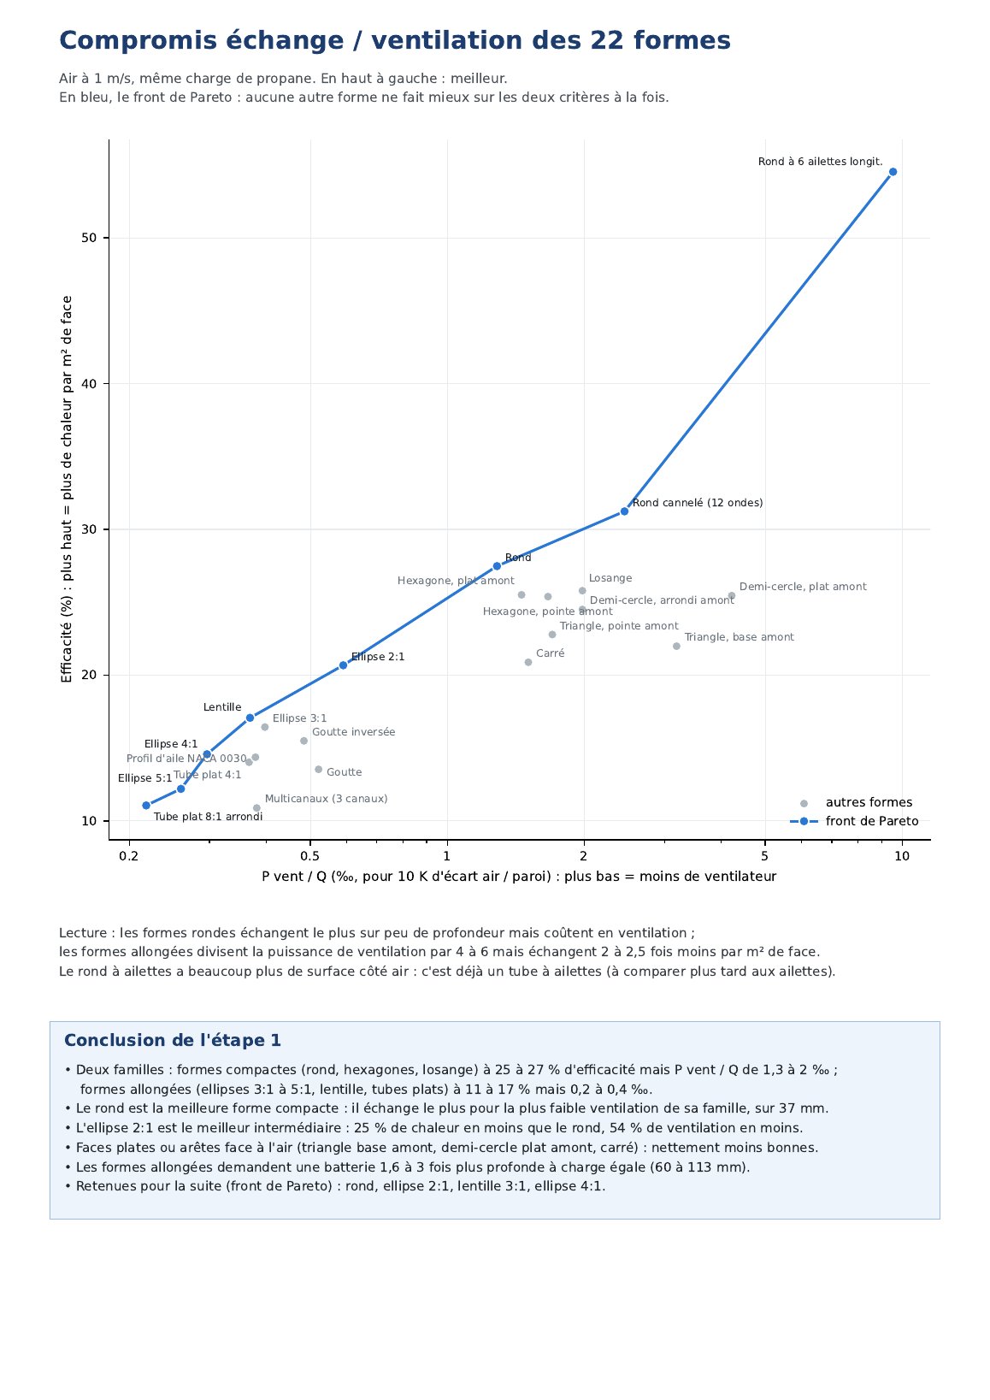
[picture p5: conception_echangeur/docs/rapport_cfd/pages/p-04.jpg]
Compromis échange / ventilation des 22 formes


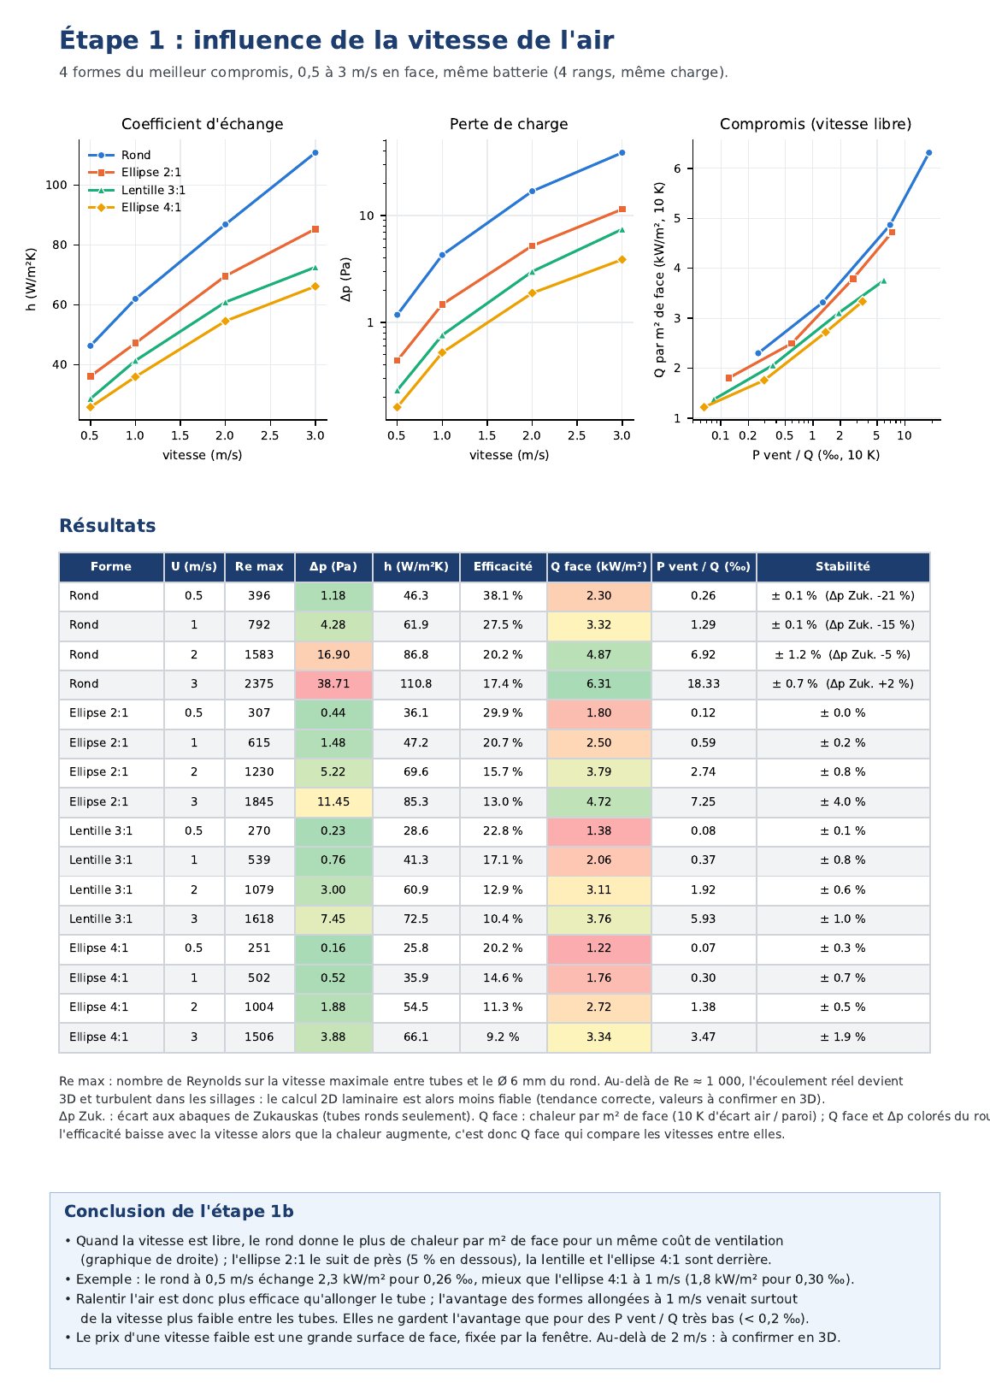
[picture p6: conception_echangeur/docs/rapport_cfd/pages/p-05.jpg]
Étape 1 : influence de la vitesse de l'air


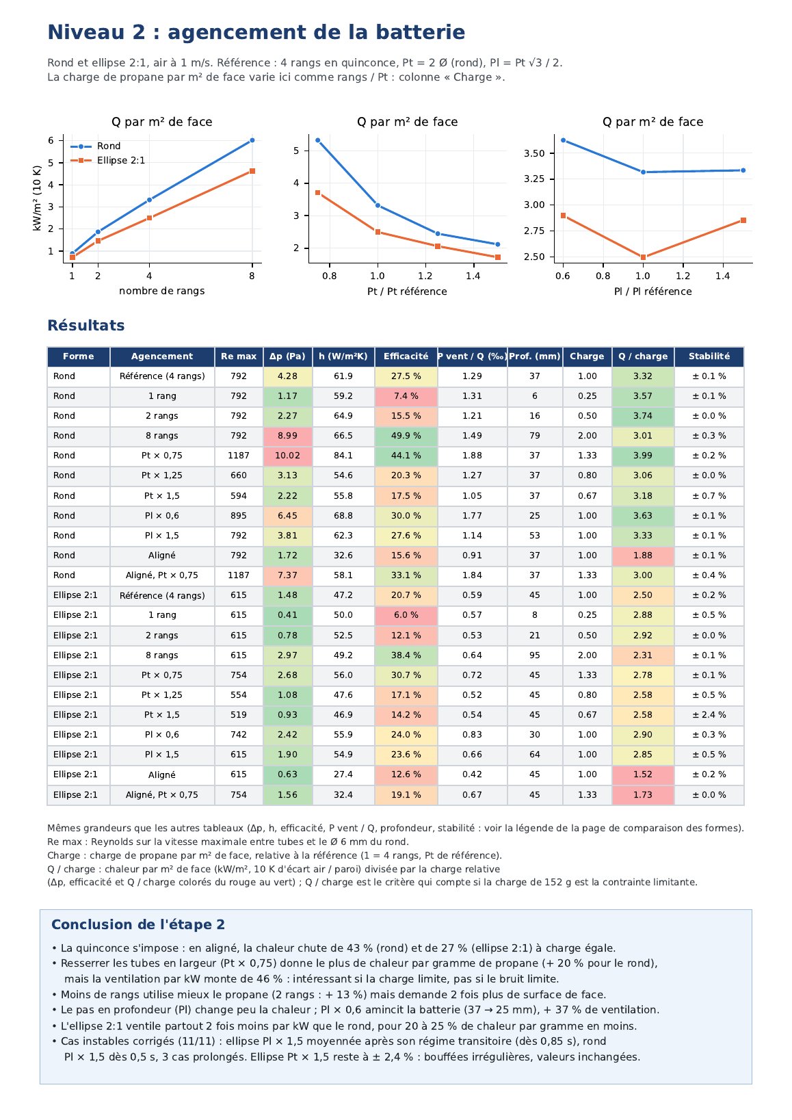
[picture p7: conception_echangeur/docs/rapport_cfd/pages/p-06.jpg]
Niveau 2 : agencement de la batterie


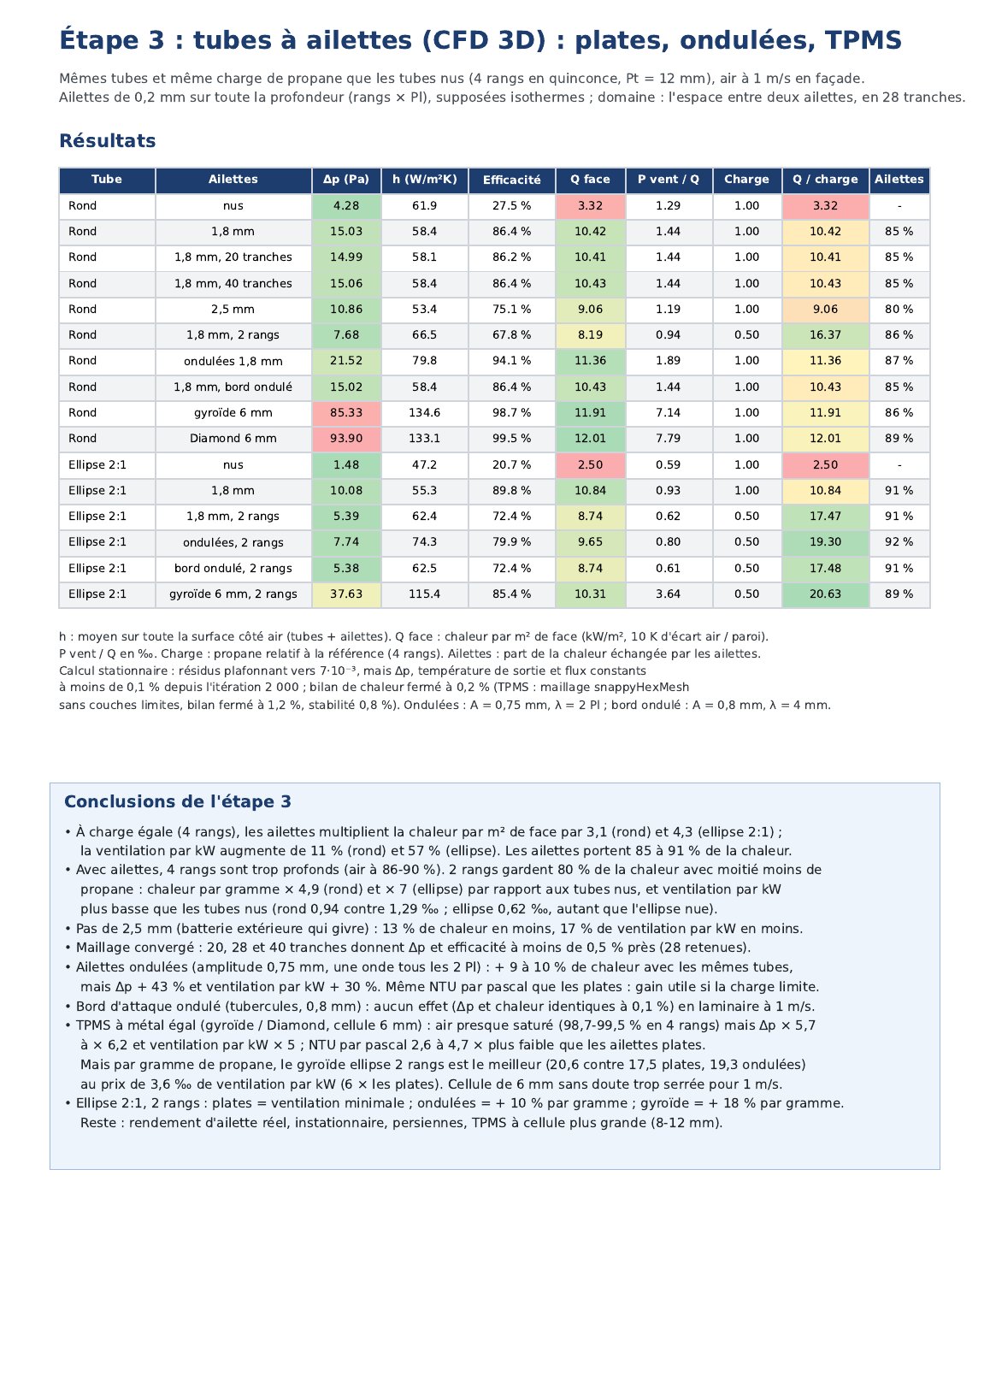
[picture p8: conception_echangeur/docs/rapport_cfd/pages/p-07.jpg]
Étape 3 : tubes à ailettes (CFD 3D) : plates, ondulées, TPMS


## Vue 3D interactive : tubes à ailettes (plates, ondulées, TPMS)

Glisser pour tourner, molette pour zoomer, clic droit pour déplacer. Le menu en haut à gauche choisit le cas ; un clic dans la légende masque ou affiche un objet. Coupe horizontale à mi-distance entre les ailettes (température), coupe verticale à travers les tubes 1 et 3 (vitesse), lignes de courant colorées par la température. Épaisseur entre ailettes dilatée × 4.

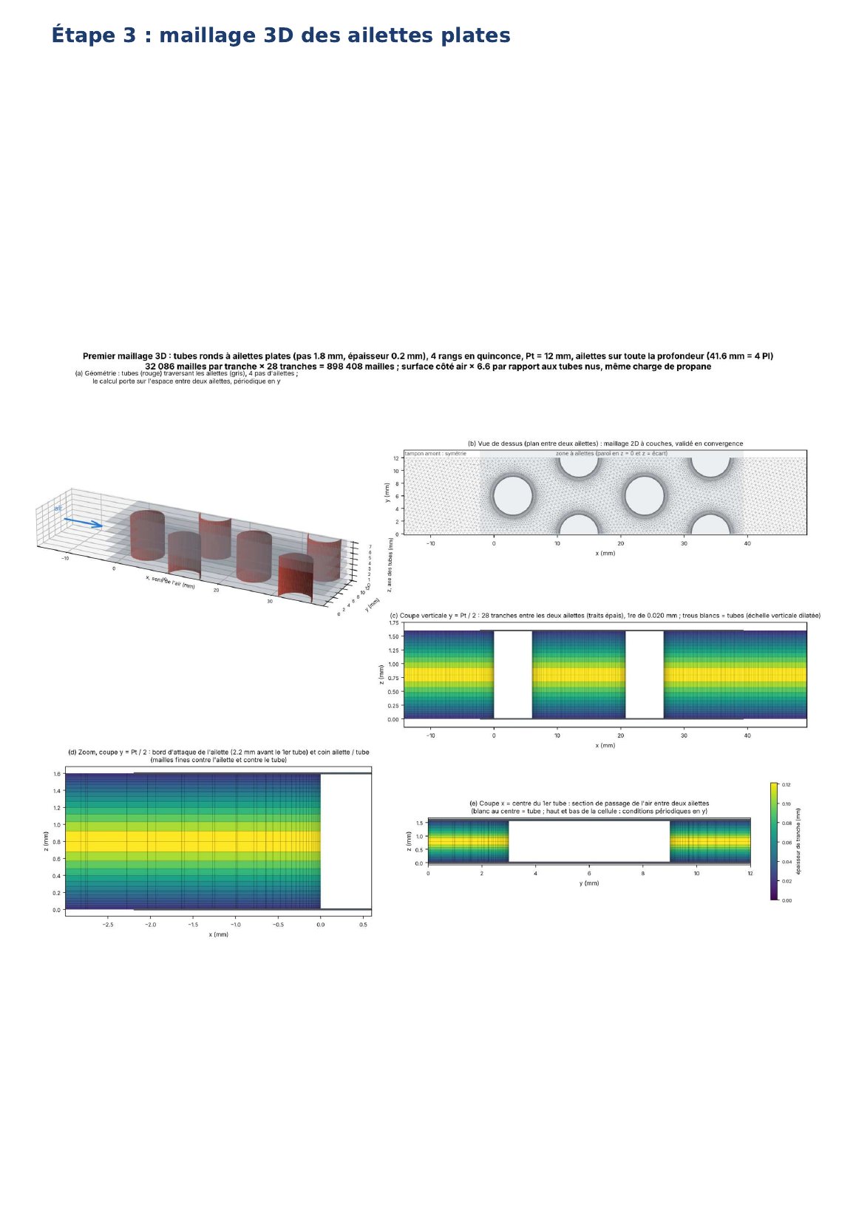
[picture p9: conception_echangeur/docs/rapport_cfd/pages/p-08.jpg]
Étape 3 : maillage 3D des ailettes plates


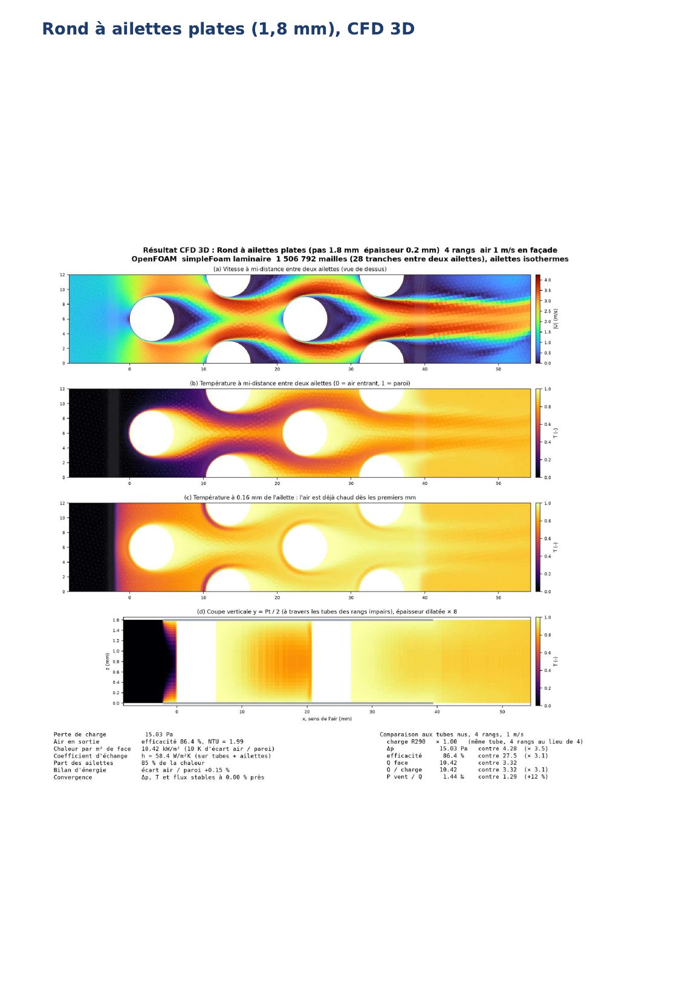
[picture p10: conception_echangeur/docs/rapport_cfd/pages/p-09.jpg]
Rond à ailettes plates (1,8 mm), CFD 3D


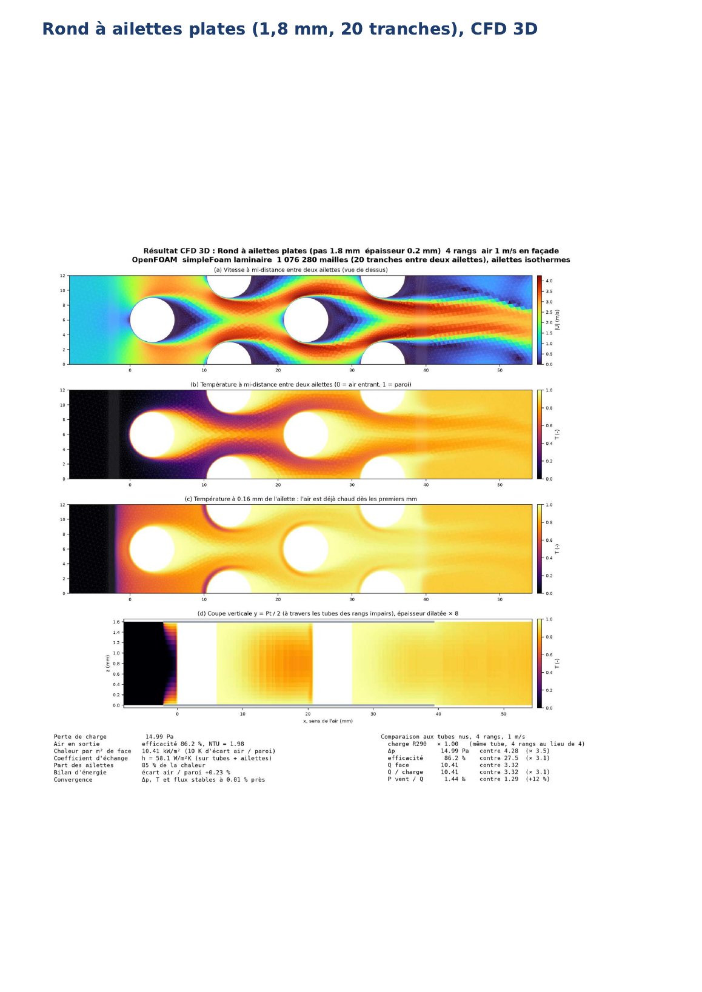
[picture p11: conception_echangeur/docs/rapport_cfd/pages/p-10.jpg]
Rond à ailettes plates (1,8 mm, 20 tranches), CFD 3D


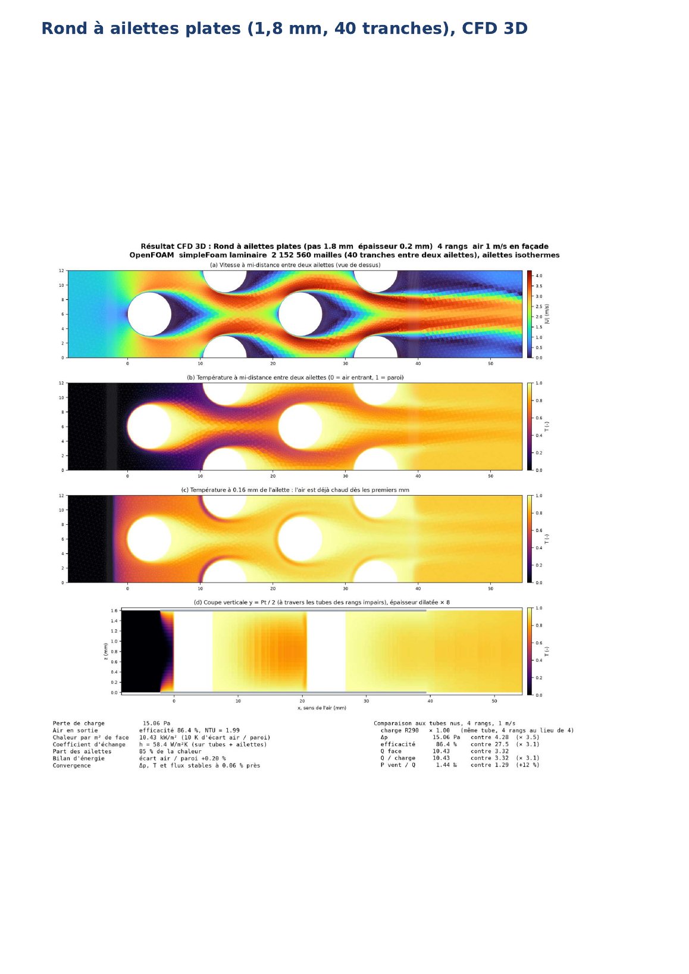
[picture p12: conception_echangeur/docs/rapport_cfd/pages/p-11.jpg]
Rond à ailettes plates (1,8 mm, 40 tranches), CFD 3D


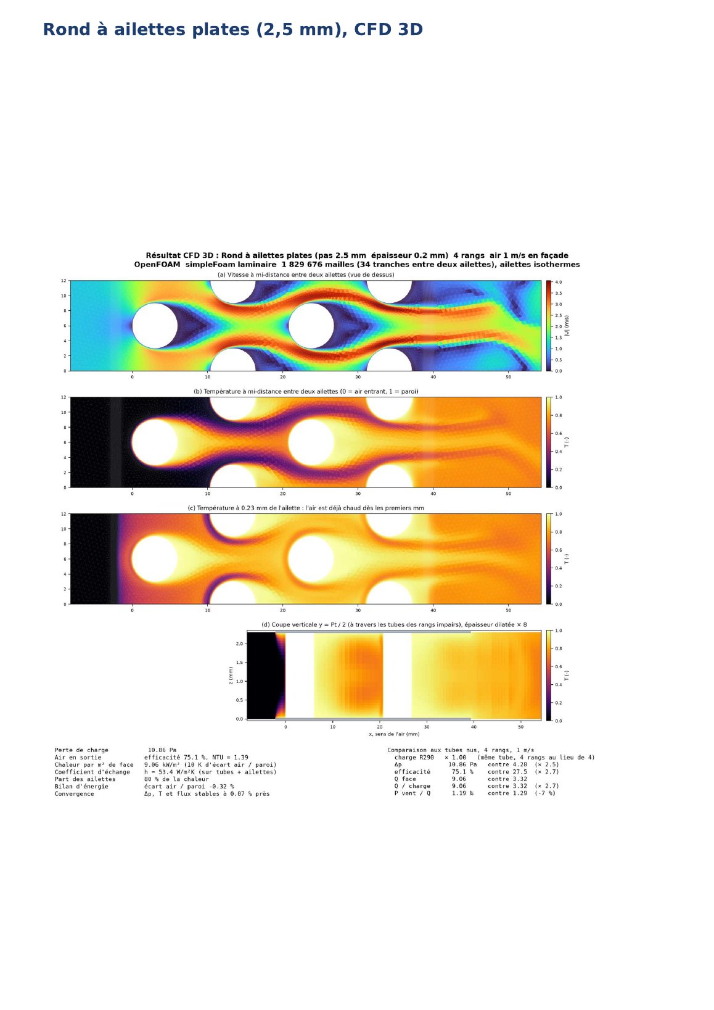
[picture p13: conception_echangeur/docs/rapport_cfd/pages/p-12.jpg]
Rond à ailettes plates (2,5 mm), CFD 3D


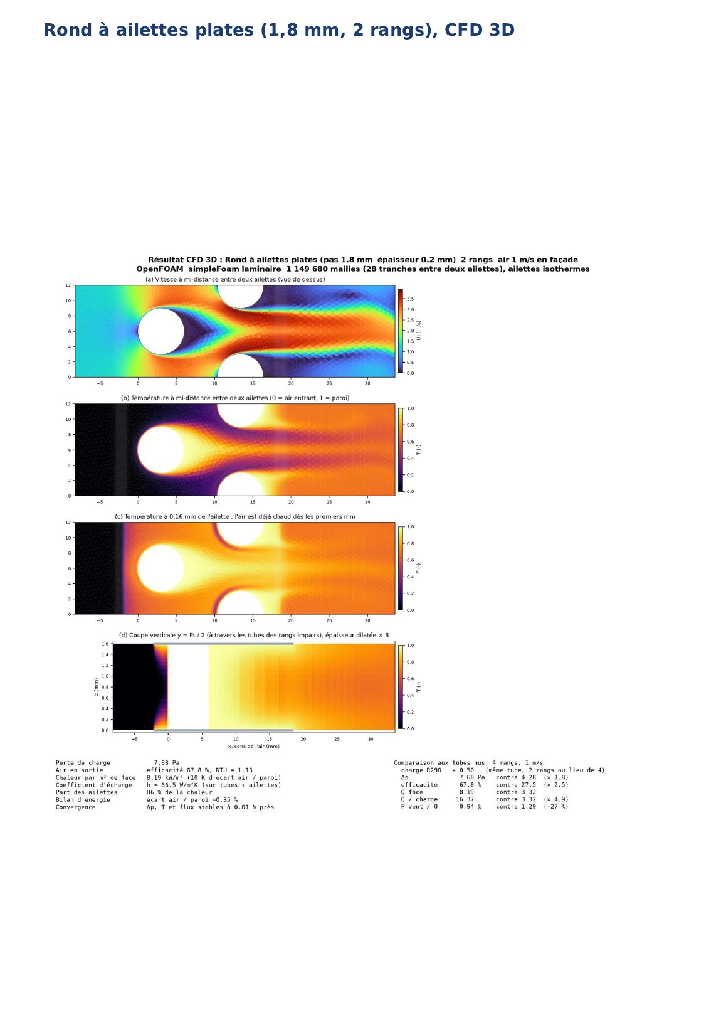
[picture p14: conception_echangeur/docs/rapport_cfd/pages/p-13.jpg]
Rond à ailettes plates (1,8 mm, 2 rangs), CFD 3D


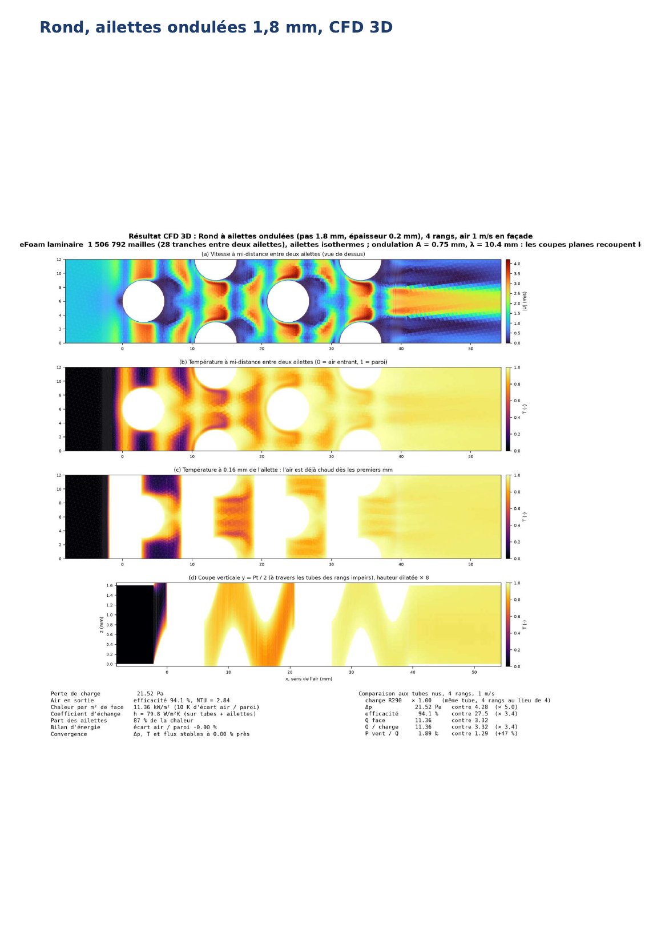
[picture p15: conception_echangeur/docs/rapport_cfd/pages/p-14.jpg]
Rond, ailettes ondulées 1,8 mm, CFD 3D


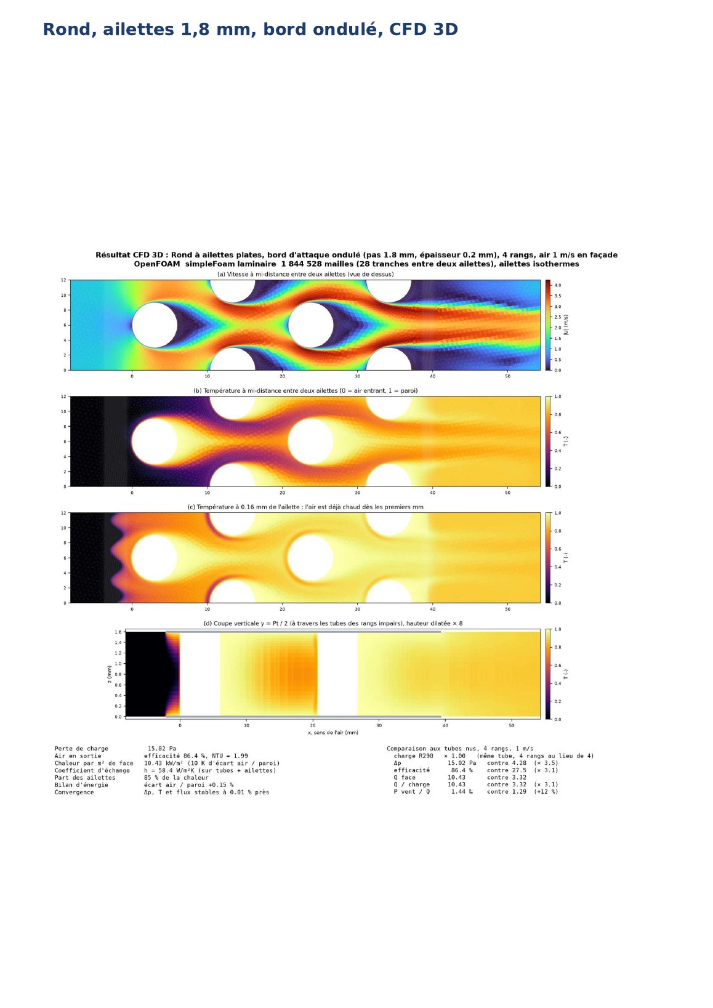
[picture p16: conception_echangeur/docs/rapport_cfd/pages/p-15.jpg]
Rond, ailettes 1,8 mm, bord ondulé, CFD 3D


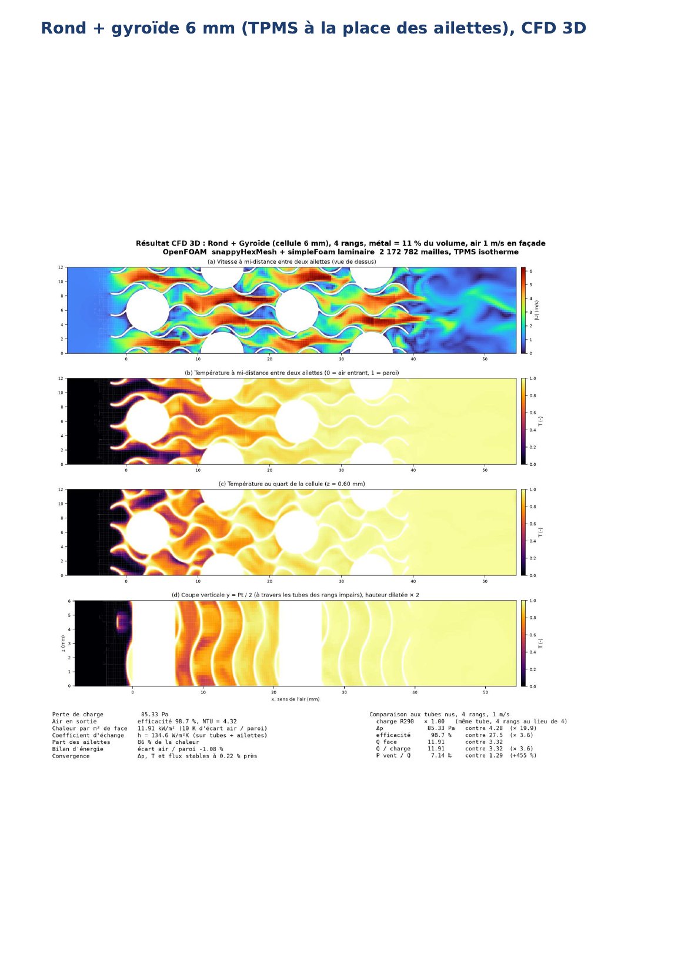
[picture p17: conception_echangeur/docs/rapport_cfd/pages/p-16.jpg]
Rond + gyroïde 6 mm (TPMS à la place des ailettes), CFD 3D


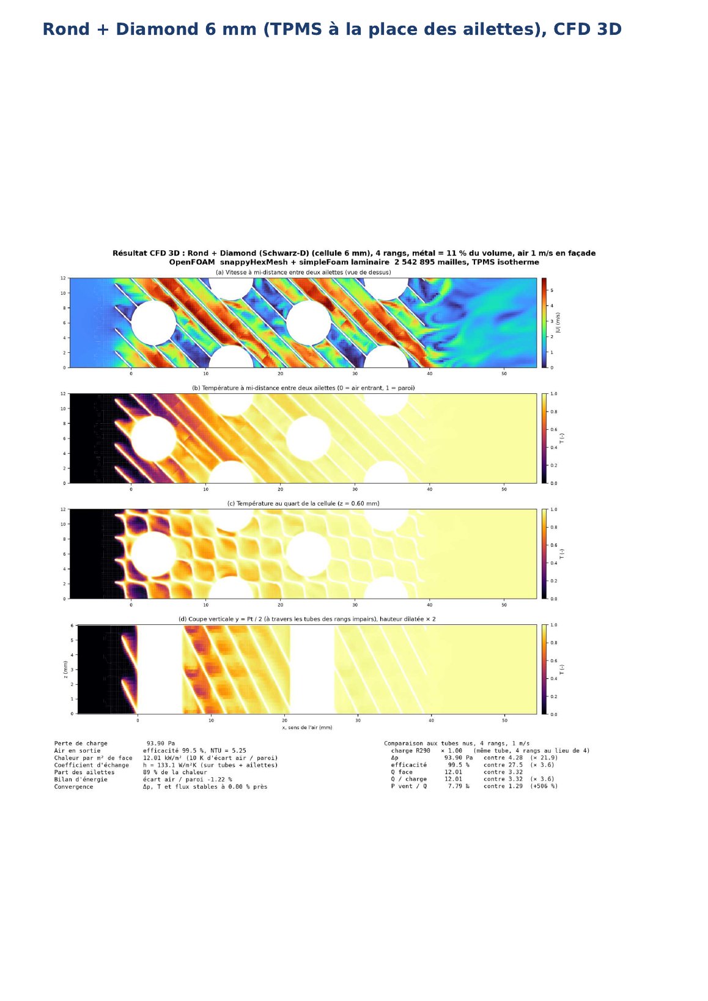
[picture p18: conception_echangeur/docs/rapport_cfd/pages/p-17.jpg]
Rond + Diamond 6 mm (TPMS à la place des ailettes), CFD 3D


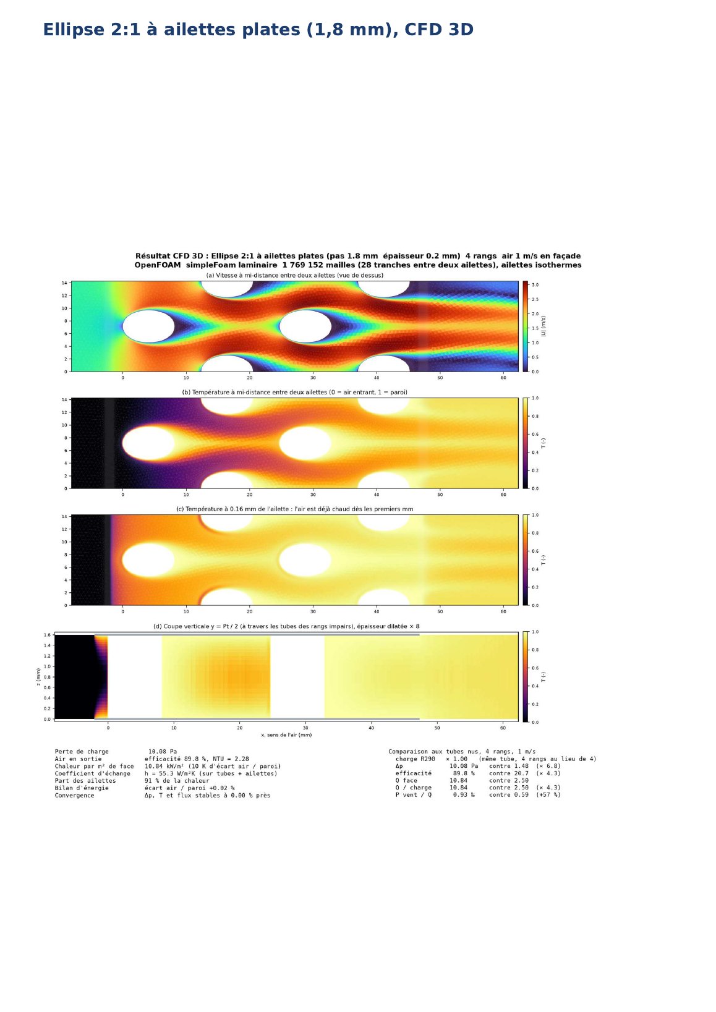
[picture p19: conception_echangeur/docs/rapport_cfd/pages/p-18.jpg]
Ellipse 2:1 à ailettes plates (1,8 mm), CFD 3D


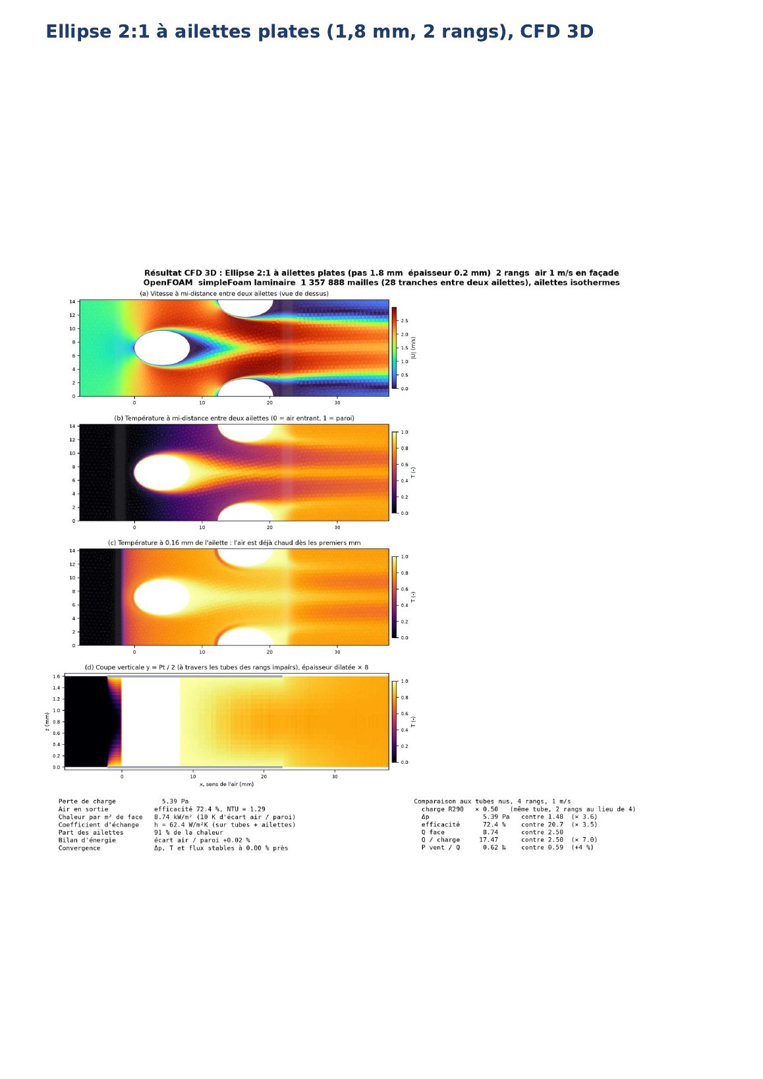
[picture p20: conception_echangeur/docs/rapport_cfd/pages/p-19.jpg]
Ellipse 2:1 à ailettes plates (1,8 mm, 2 rangs), CFD 3D


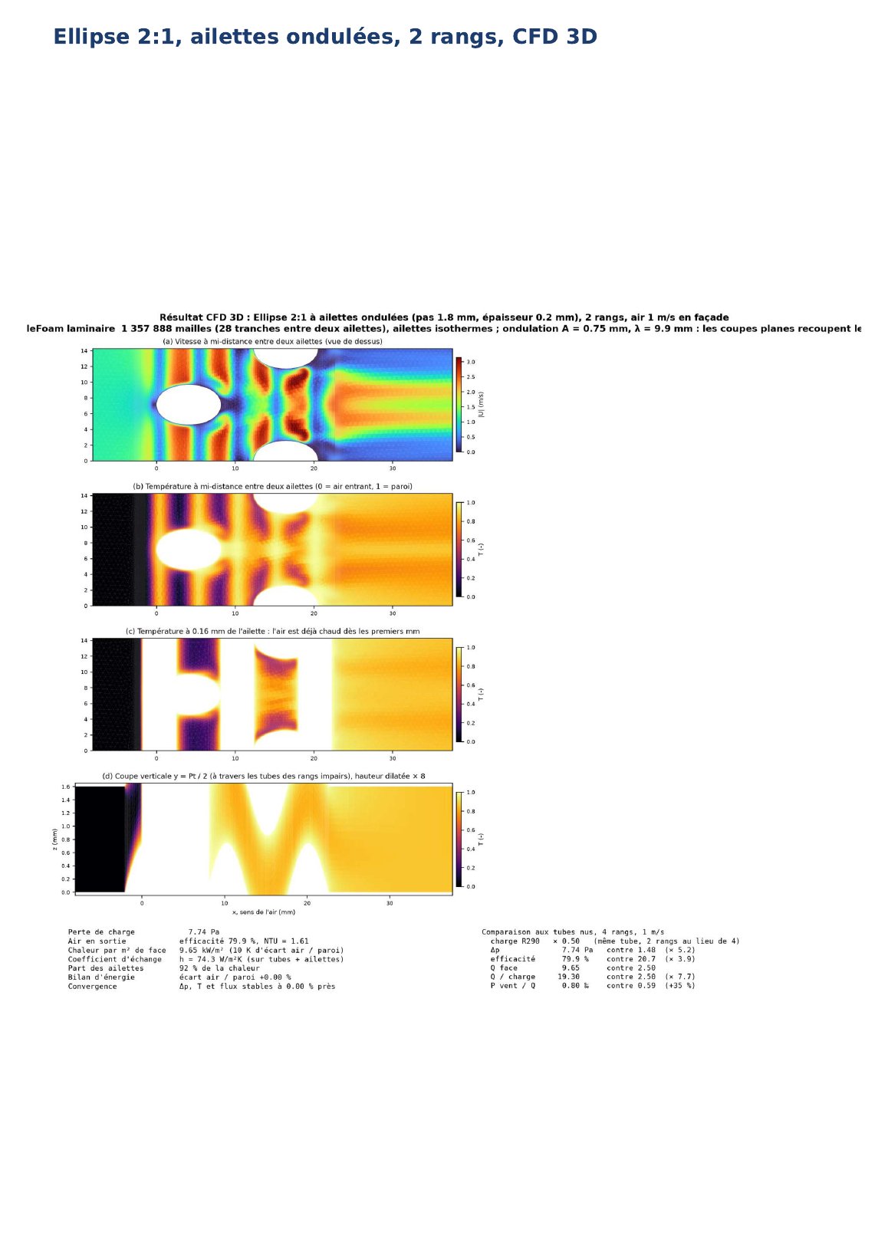
[picture p21: conception_echangeur/docs/rapport_cfd/pages/p-20.jpg]
Ellipse 2:1, ailettes ondulées, 2 rangs, CFD 3D


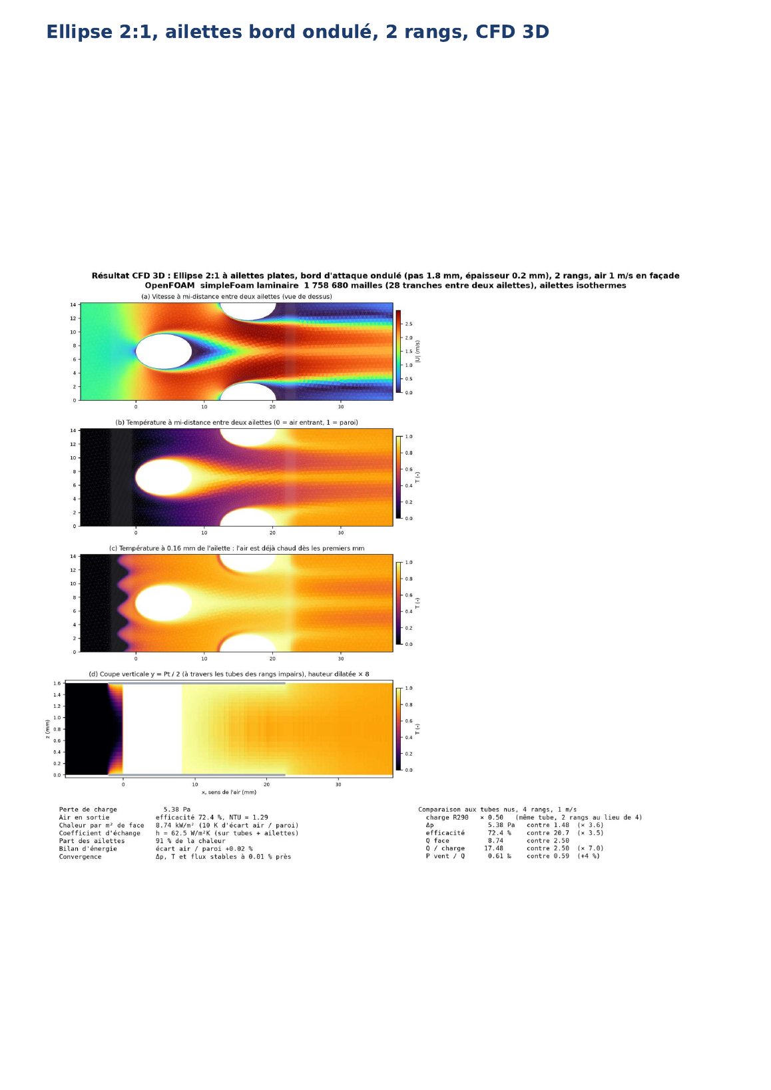
[picture p22: conception_echangeur/docs/rapport_cfd/pages/p-21.jpg]
Ellipse 2:1, ailettes bord ondulé, 2 rangs, CFD 3D


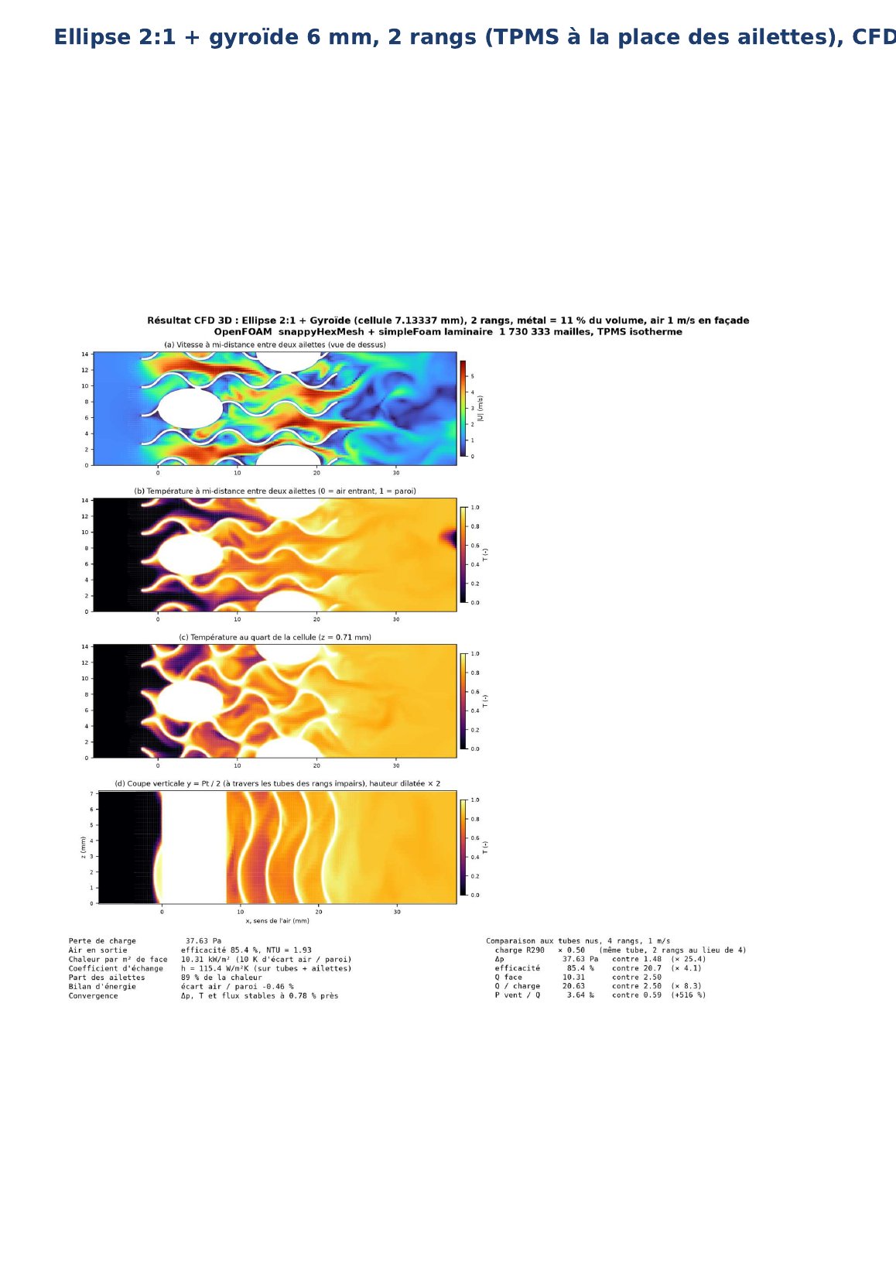
[picture p23: conception_echangeur/docs/rapport_cfd/pages/p-22.jpg]
Ellipse 2:1 + gyroïde 6 mm, 2 rangs (TPMS à la place des ailettes), CFD


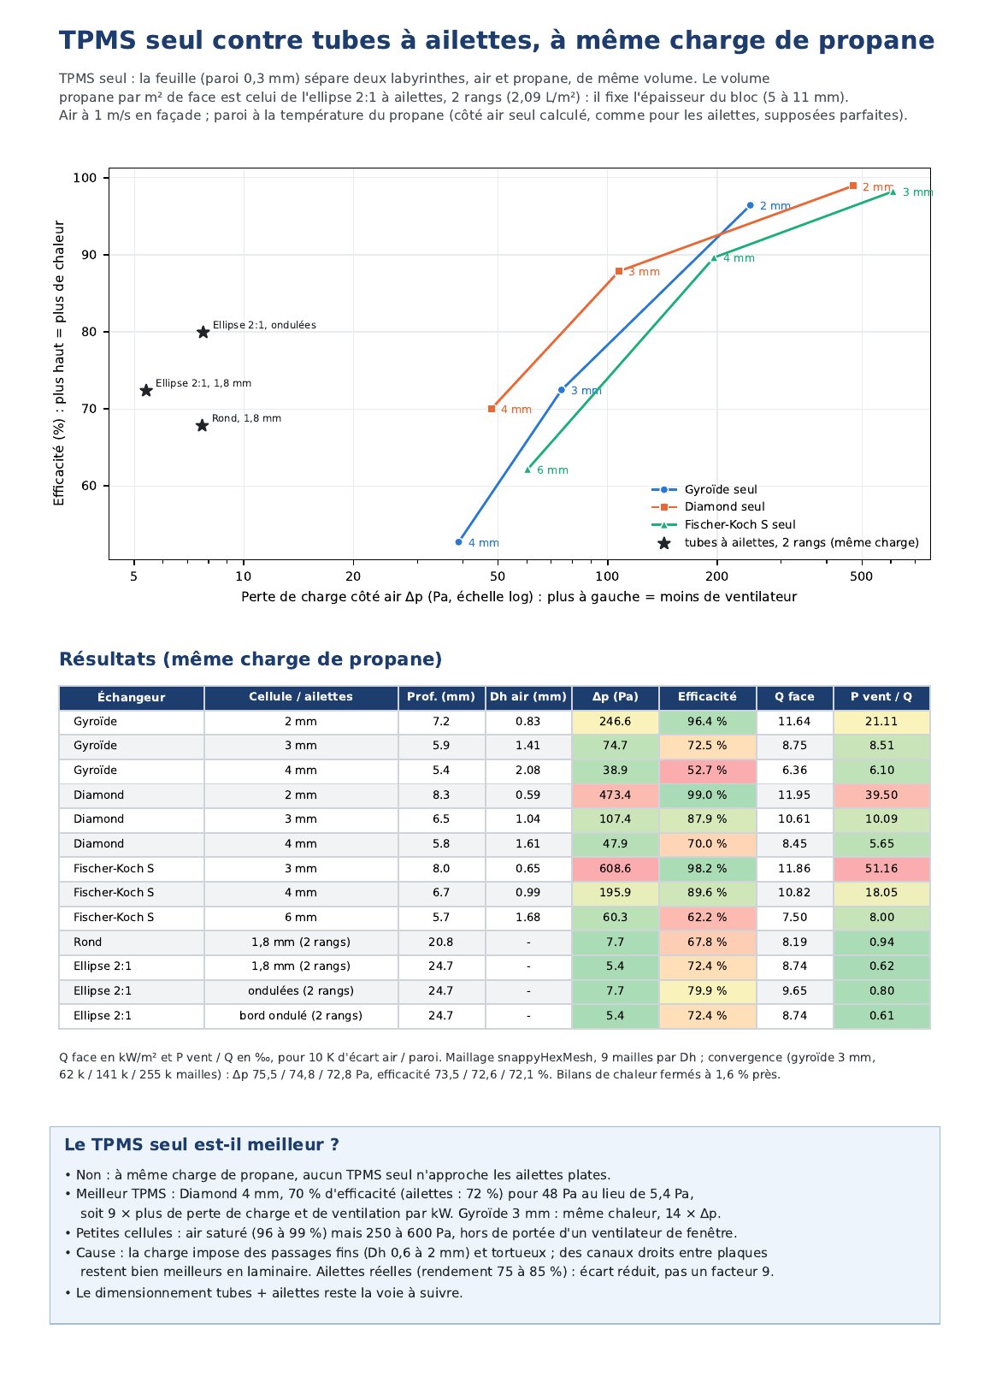
[picture p24: conception_echangeur/docs/rapport_cfd/pages/p-23.jpg]
TPMS seul contre tubes à ailettes, à même charge de propane


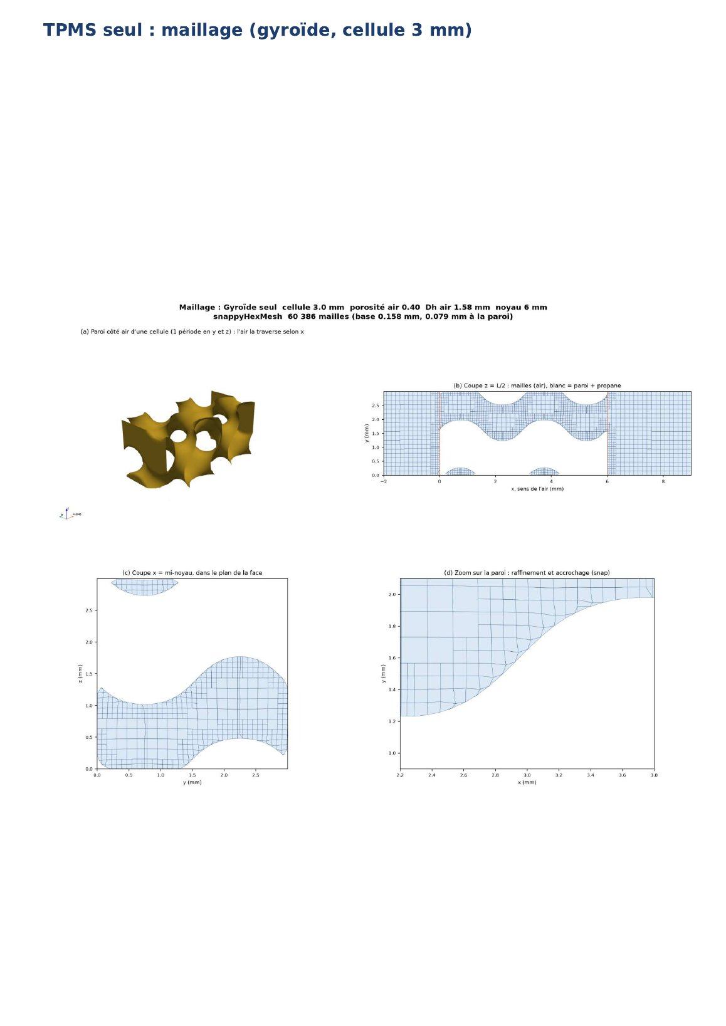
[picture p25: conception_echangeur/docs/rapport_cfd/pages/p-24.jpg]
TPMS seul : maillage (gyroïde, cellule 3 mm)


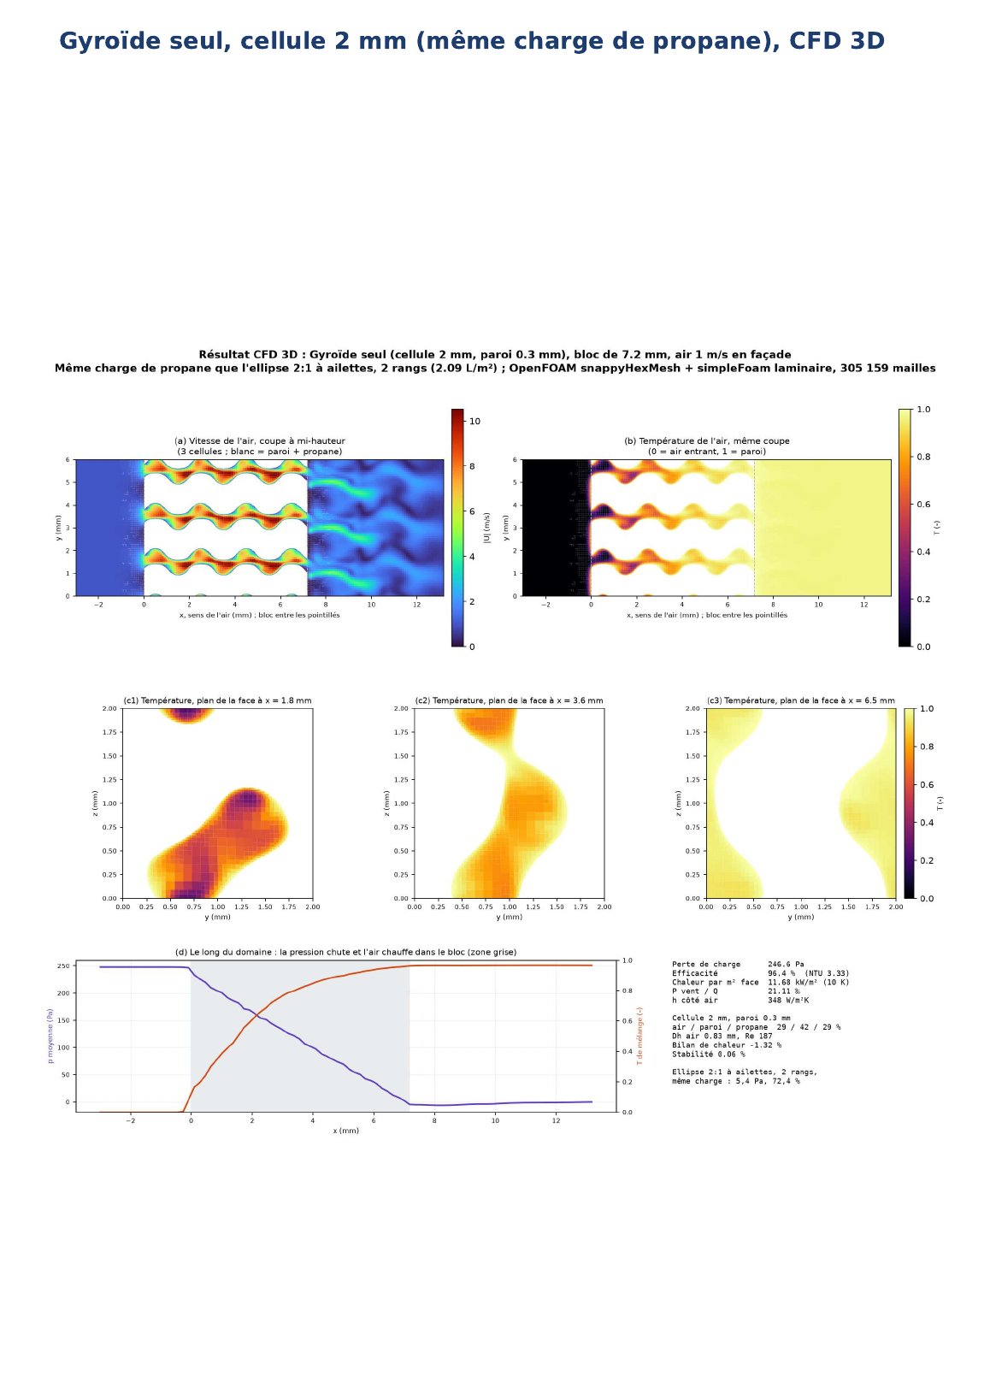
[picture p26: conception_echangeur/docs/rapport_cfd/pages/p-25.jpg]
Gyroïde seul, cellule 2 mm (même charge de propane), CFD 3D


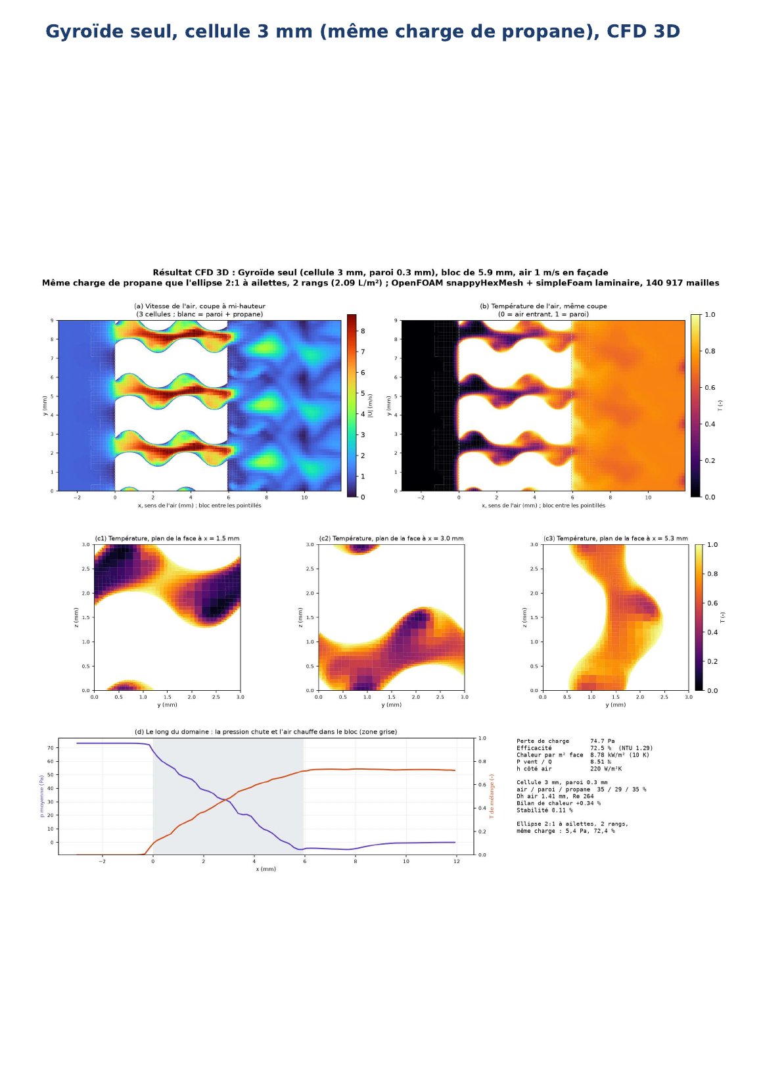
[picture p27: conception_echangeur/docs/rapport_cfd/pages/p-26.jpg]
Gyroïde seul, cellule 3 mm (même charge de propane), CFD 3D


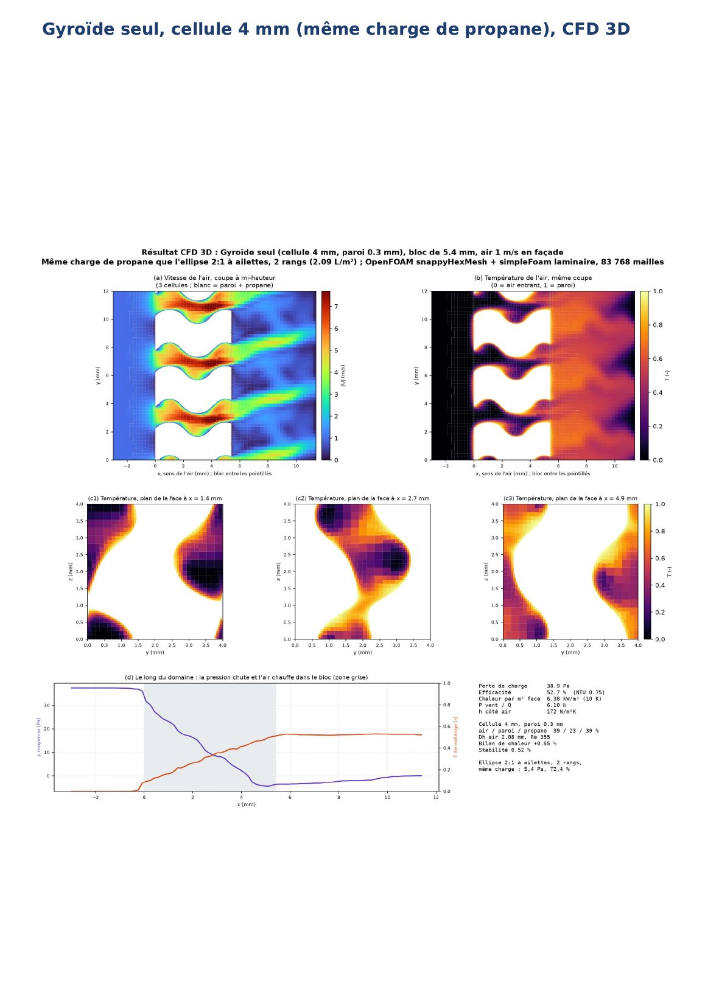
[picture p28: conception_echangeur/docs/rapport_cfd/pages/p-27.jpg]
Gyroïde seul, cellule 4 mm (même charge de propane), CFD 3D


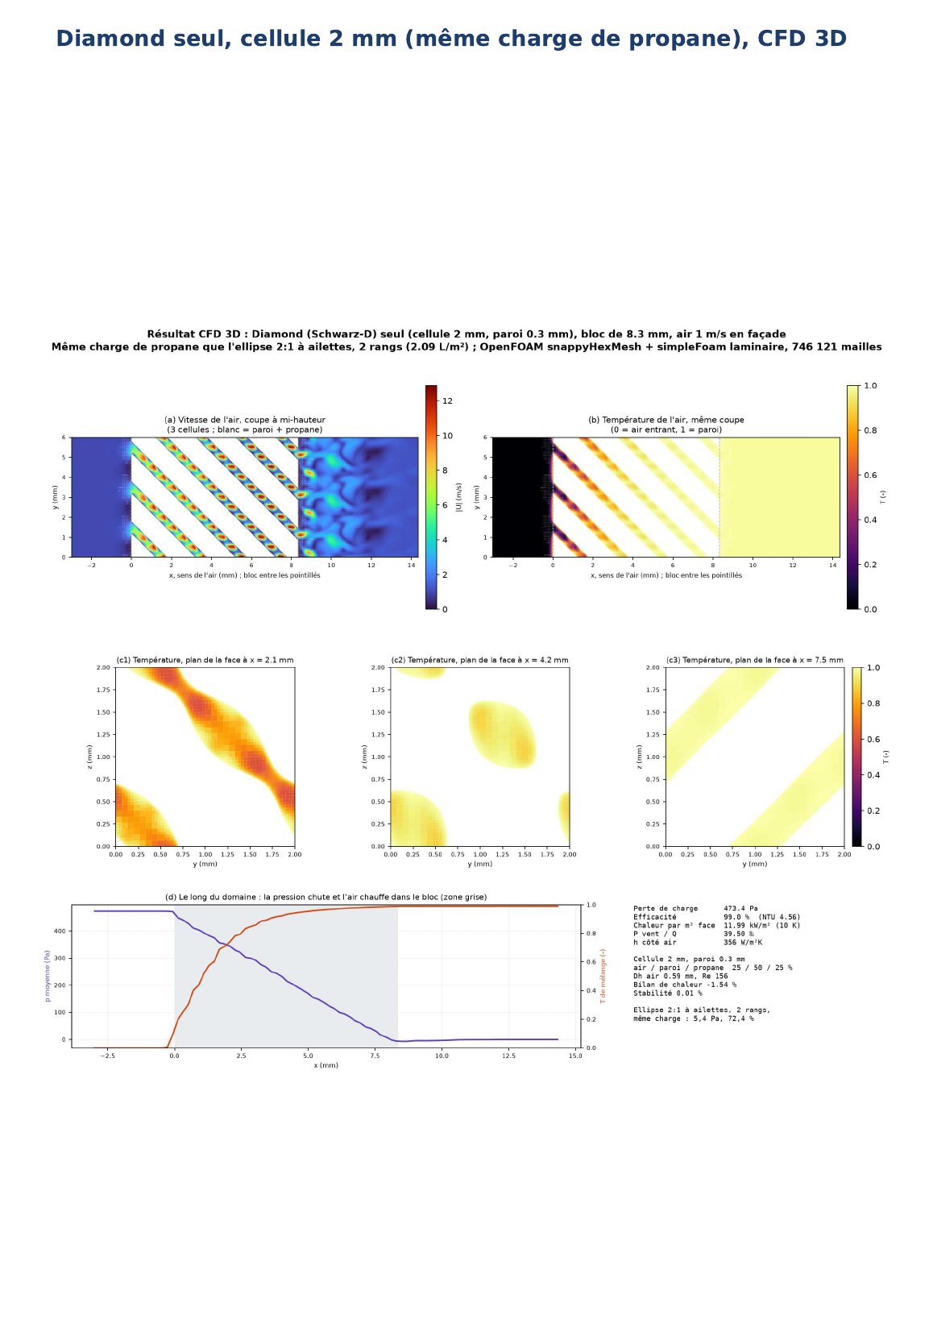
[picture p29: conception_echangeur/docs/rapport_cfd/pages/p-28.jpg]
Diamond seul, cellule 2 mm (même charge de propane), CFD 3D


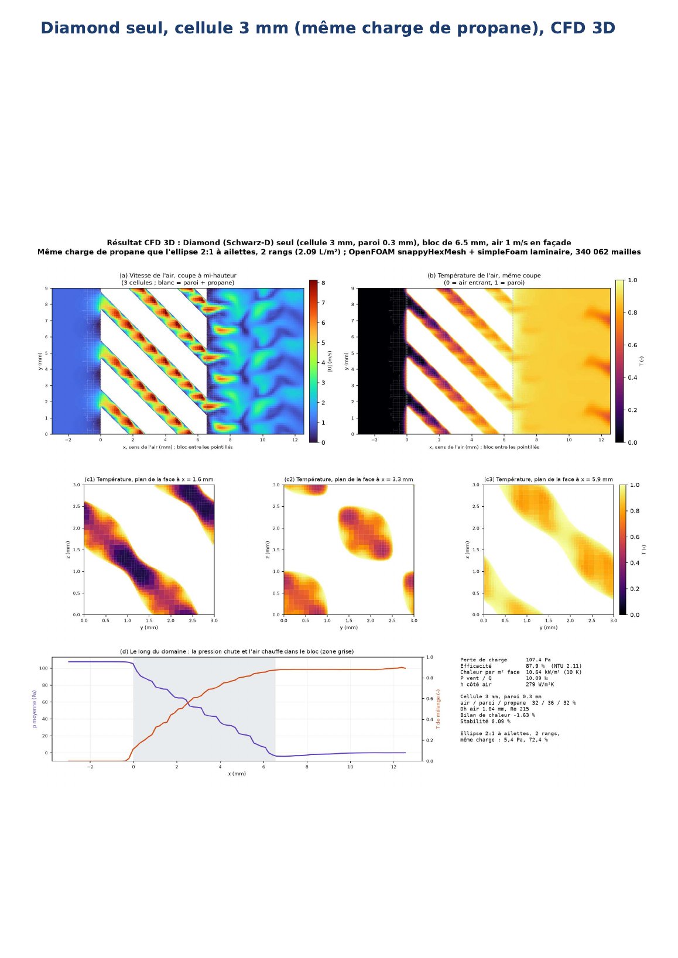
[picture p30: conception_echangeur/docs/rapport_cfd/pages/p-29.jpg]
Diamond seul, cellule 3 mm (même charge de propane), CFD 3D


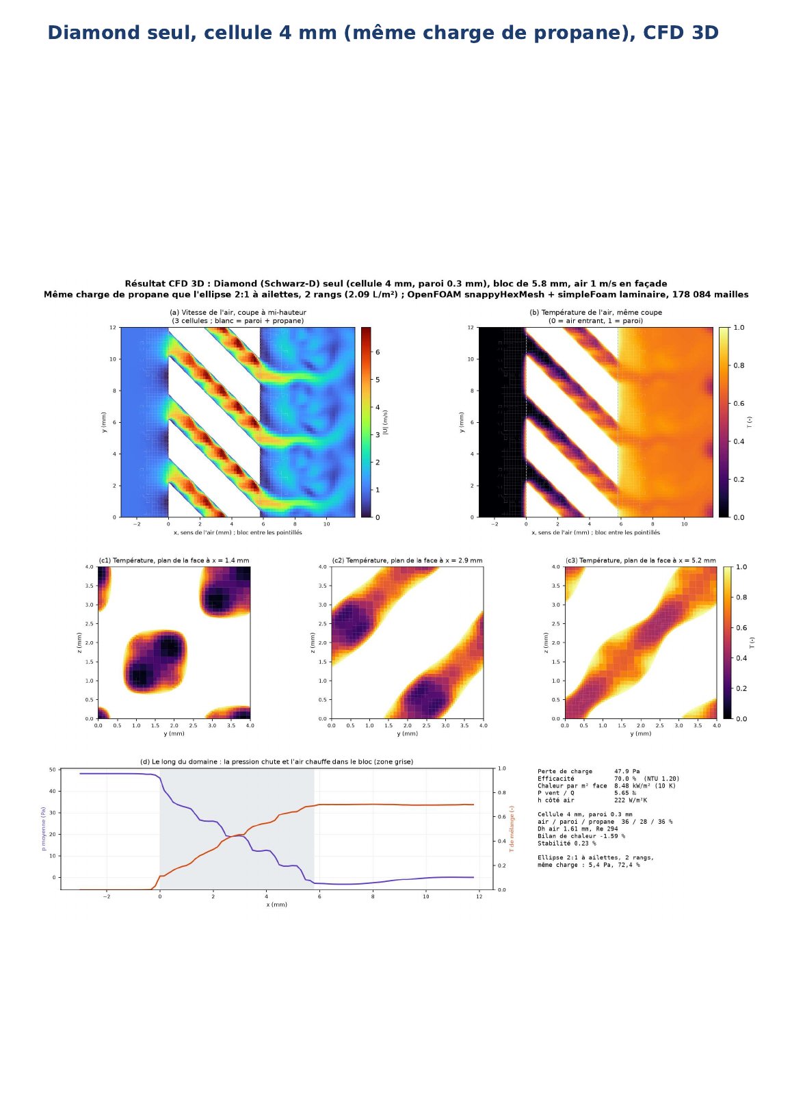
[picture p31: conception_echangeur/docs/rapport_cfd/pages/p-30.jpg]
Diamond seul, cellule 4 mm (même charge de propane), CFD 3D


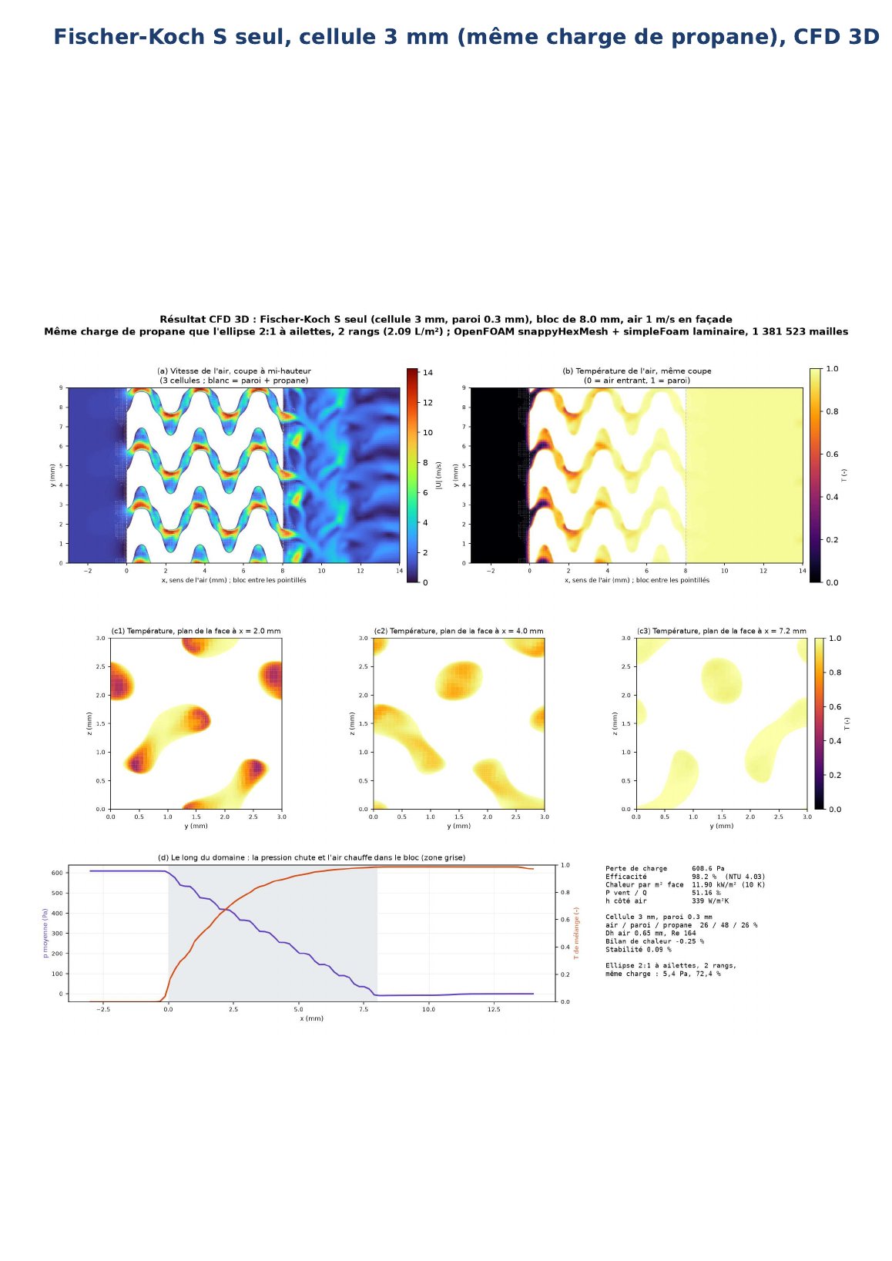
[picture p32: conception_echangeur/docs/rapport_cfd/pages/p-31.jpg]
Fischer-Koch S seul, cellule 3 mm (même charge de propane), CFD 3D


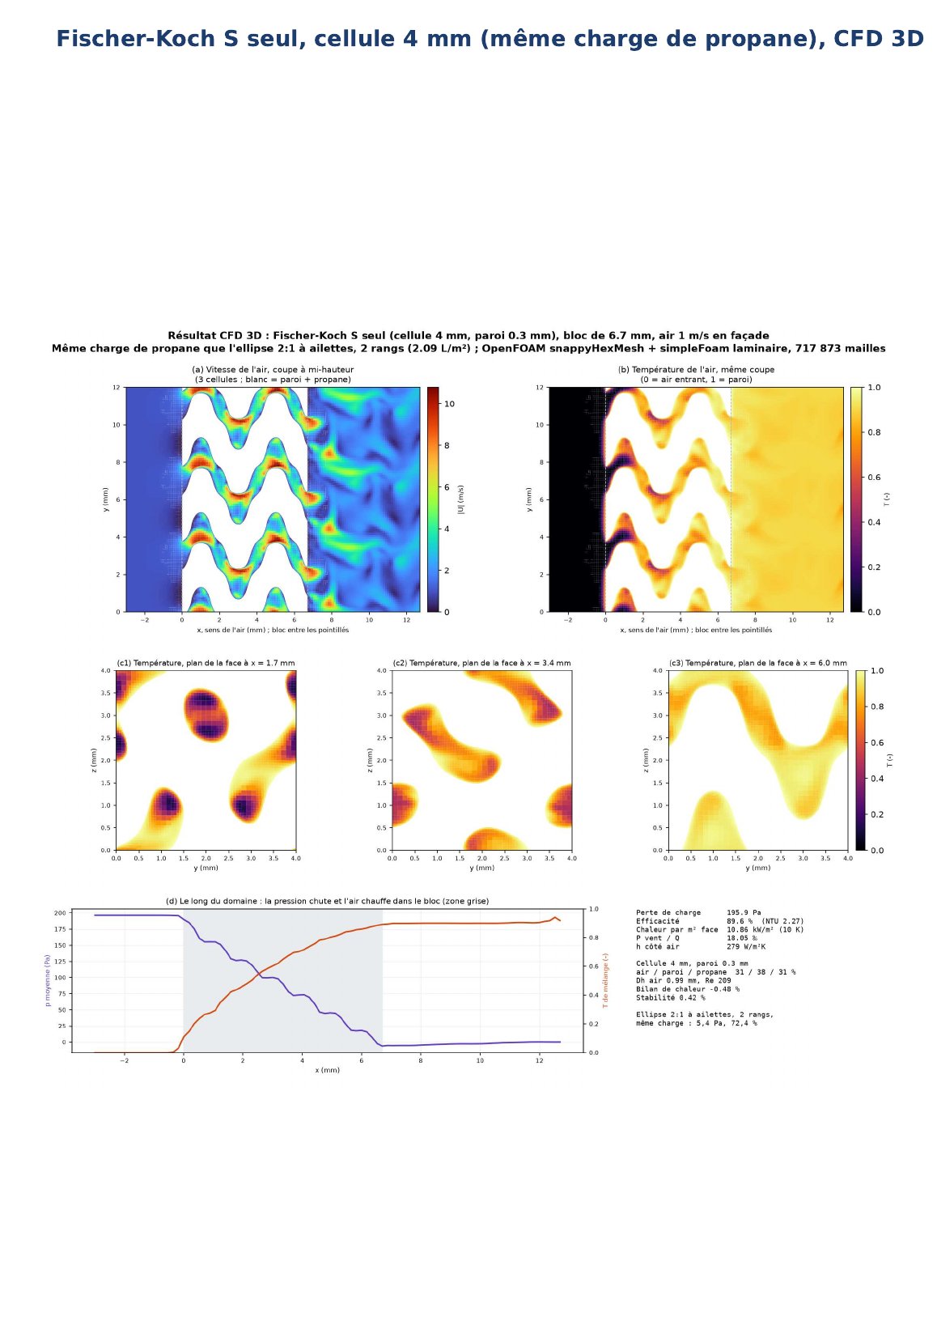
[picture p33: conception_echangeur/docs/rapport_cfd/pages/p-32.jpg]
Fischer-Koch S seul, cellule 4 mm (même charge de propane), CFD 3D


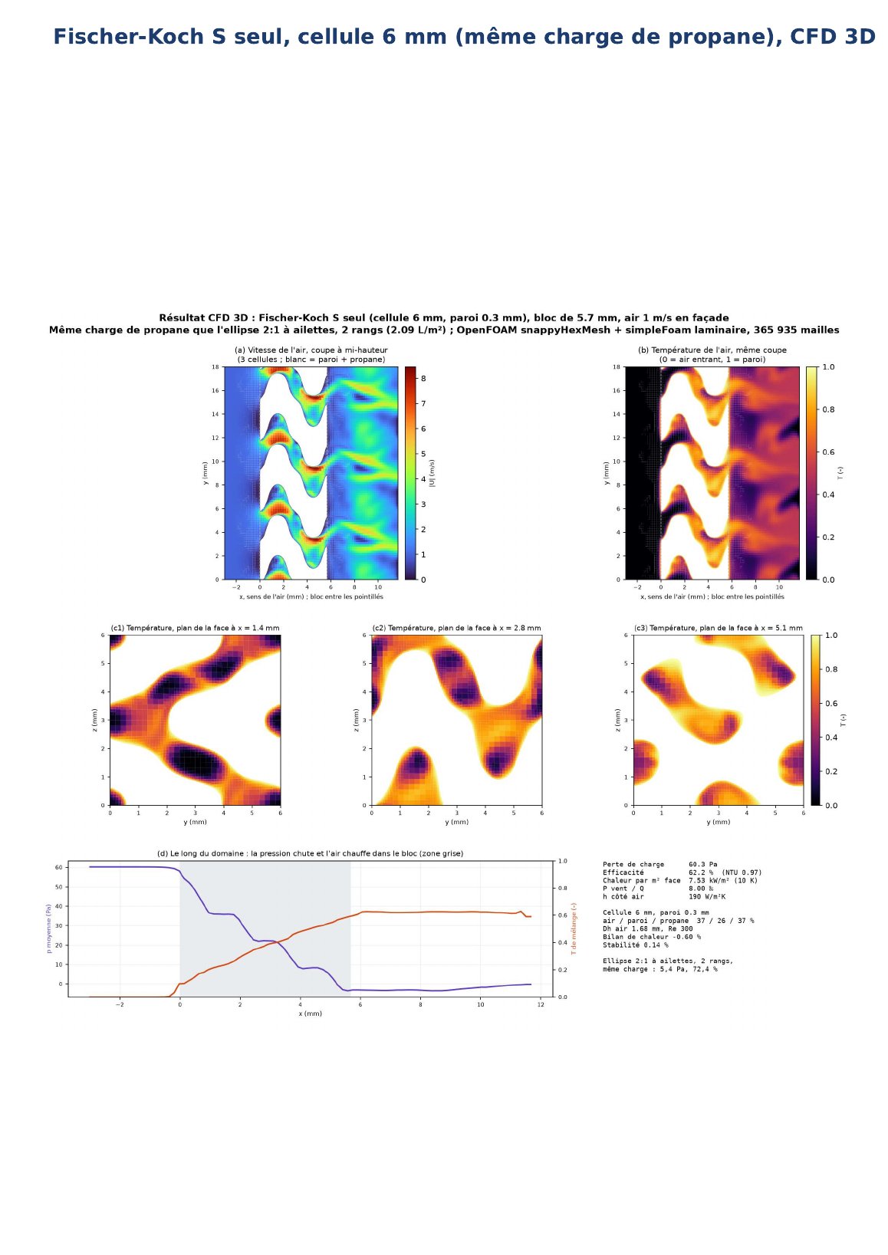
[picture p34: conception_echangeur/docs/rapport_cfd/pages/p-33.jpg]
Fischer-Koch S seul, cellule 6 mm (même charge de propane), CFD 3D


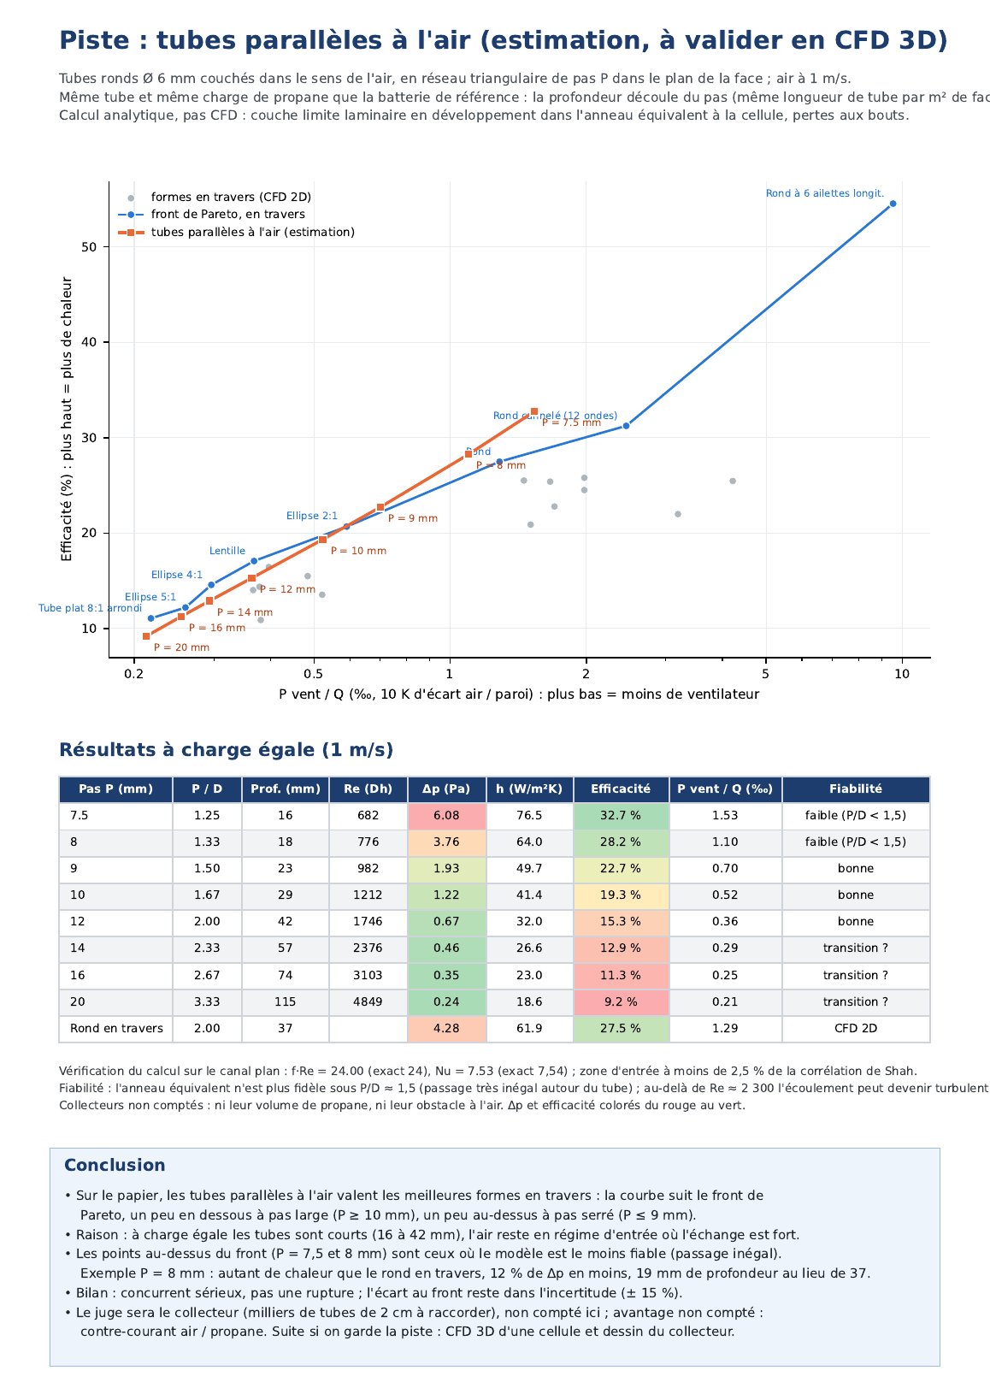
[picture p35: conception_echangeur/docs/rapport_cfd/pages/p-34.jpg]
Piste : tubes parallèles à l'air (estimation, à valider en CFD 3D)


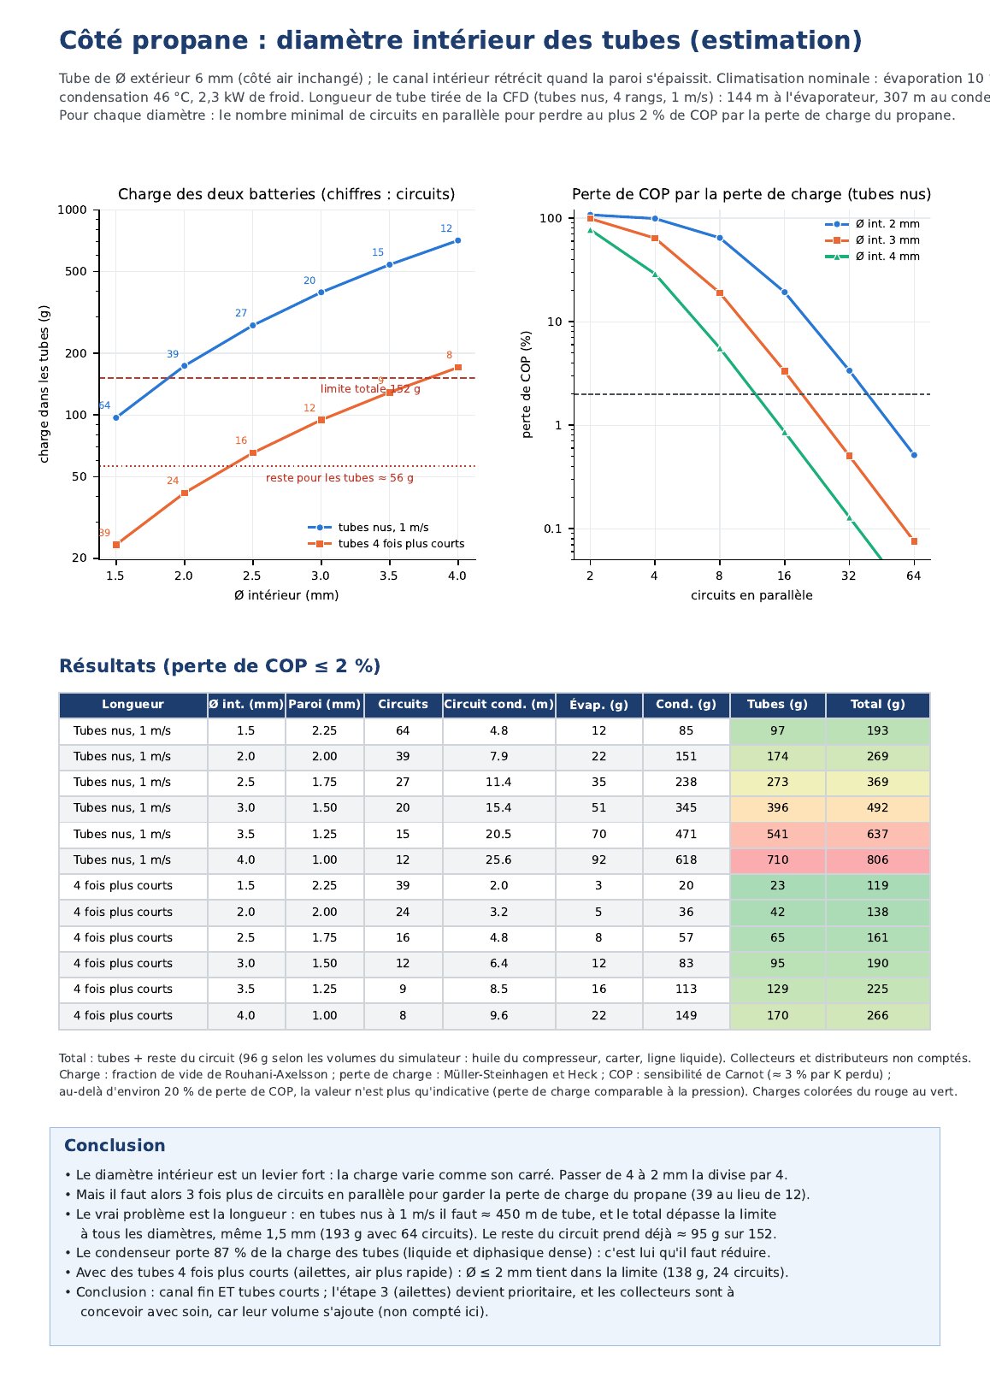
[picture p36: conception_echangeur/docs/rapport_cfd/pages/p-35.jpg]
Côté propane : diamètre intérieur des tubes (estimation)


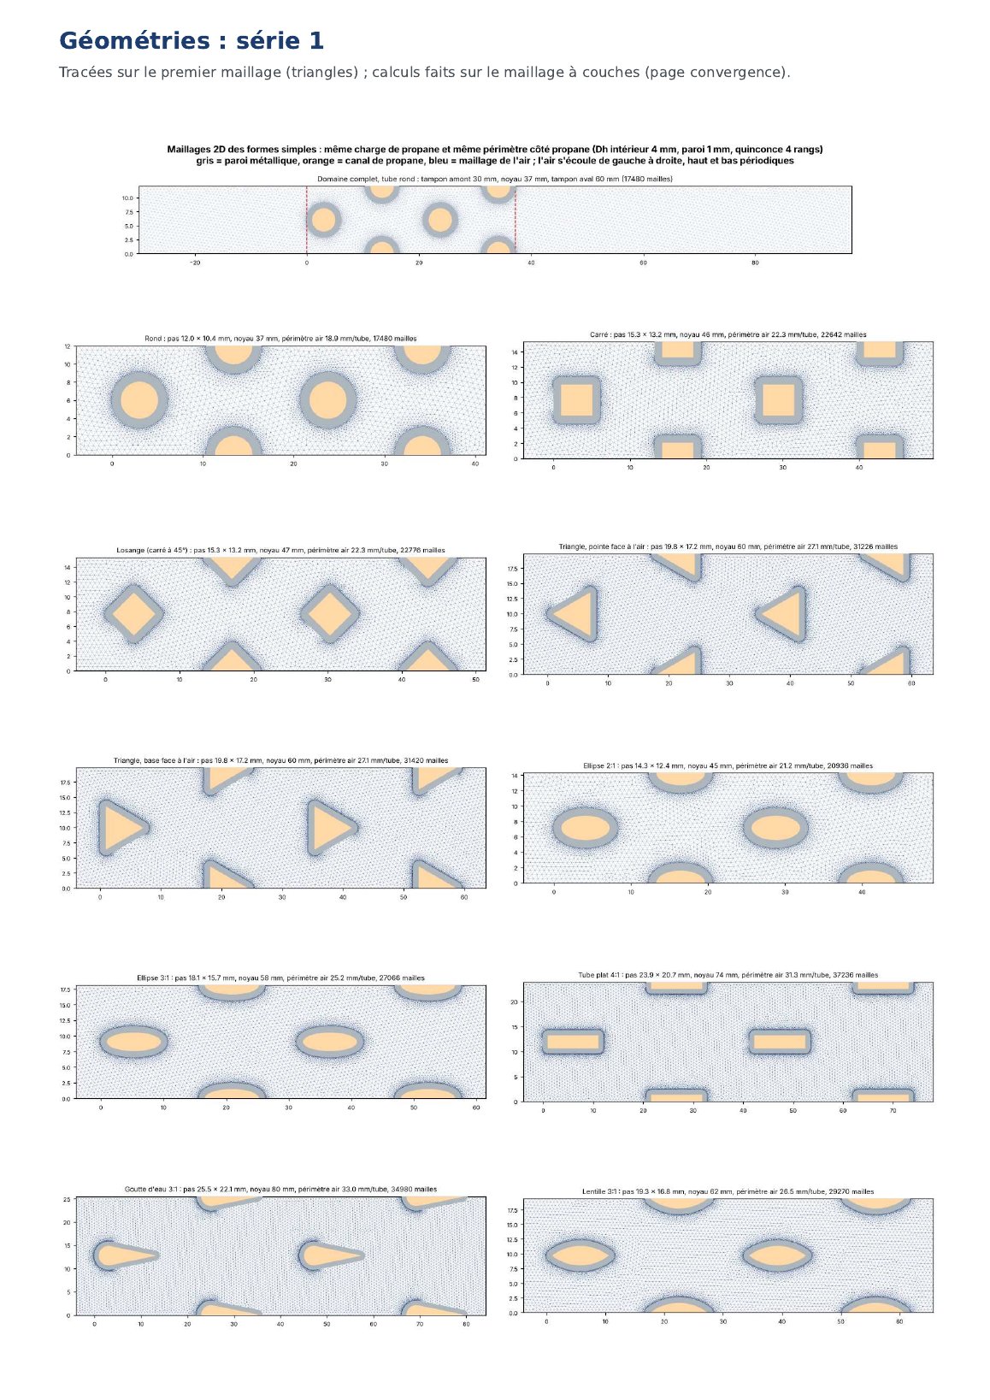
[picture p37: conception_echangeur/docs/rapport_cfd/pages/p-36.jpg]
Géométries : série 1


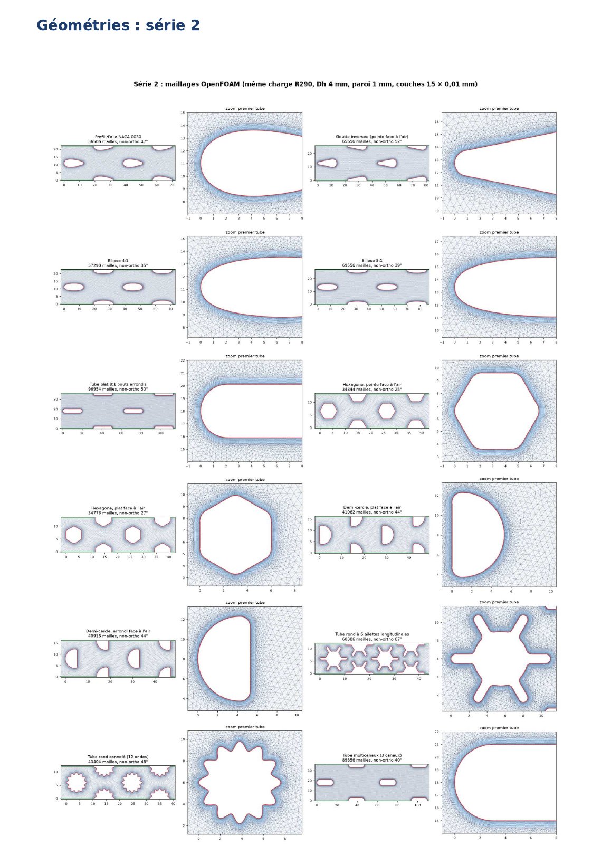
[picture p38: conception_echangeur/docs/rapport_cfd/pages/p-37.jpg]
Géométries : série 2


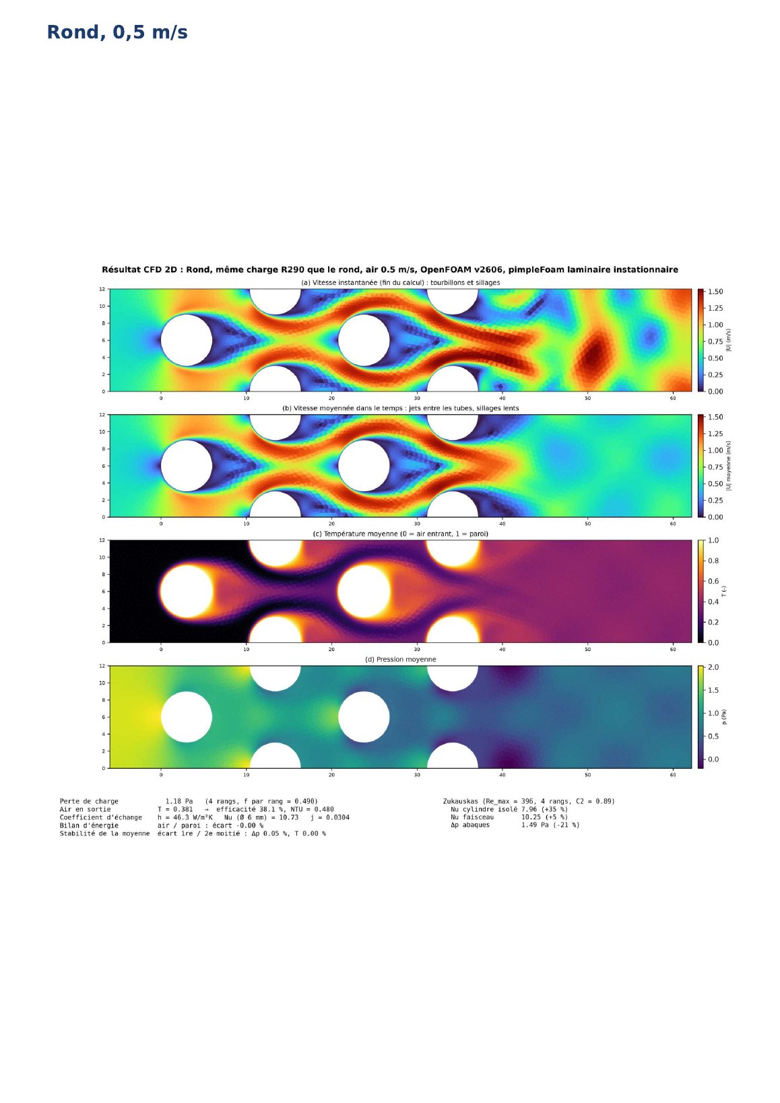
[picture p39: conception_echangeur/docs/rapport_cfd/pages/p-38.jpg]
Rond, 0,5 m/s


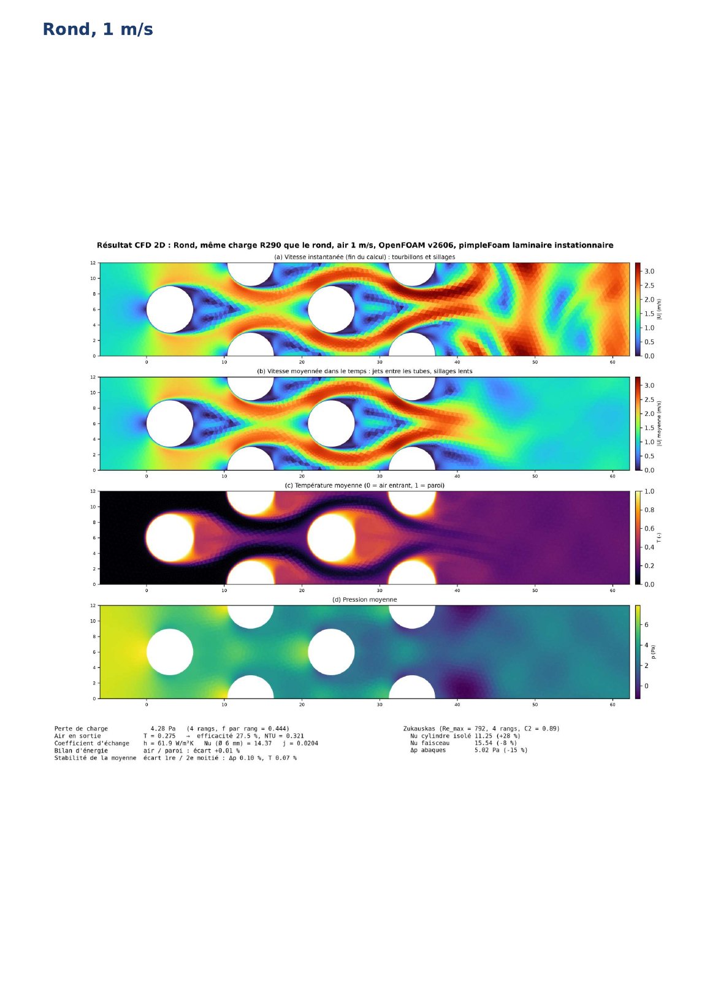
[picture p40: conception_echangeur/docs/rapport_cfd/pages/p-39.jpg]
Rond, 1 m/s


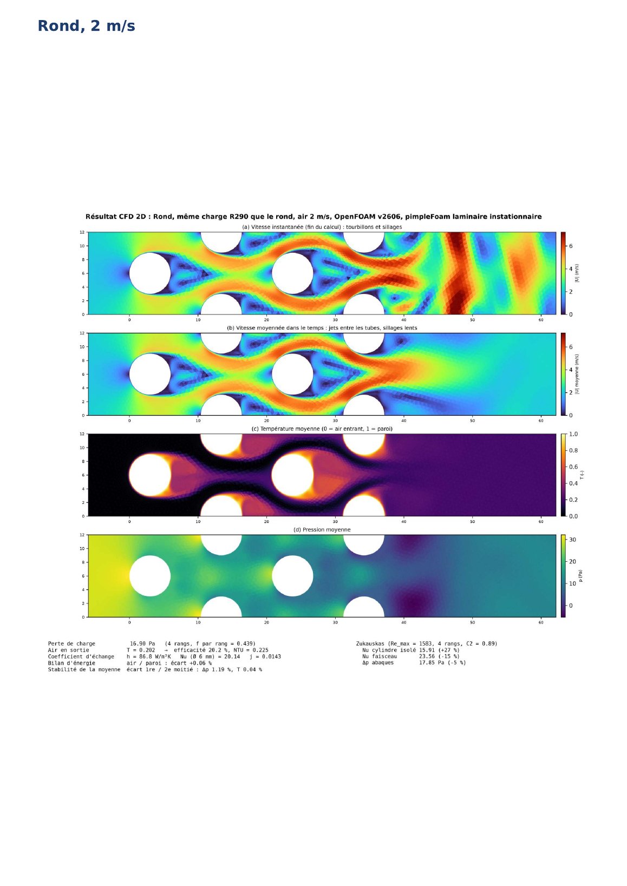
[picture p41: conception_echangeur/docs/rapport_cfd/pages/p-40.jpg]
Rond, 2 m/s


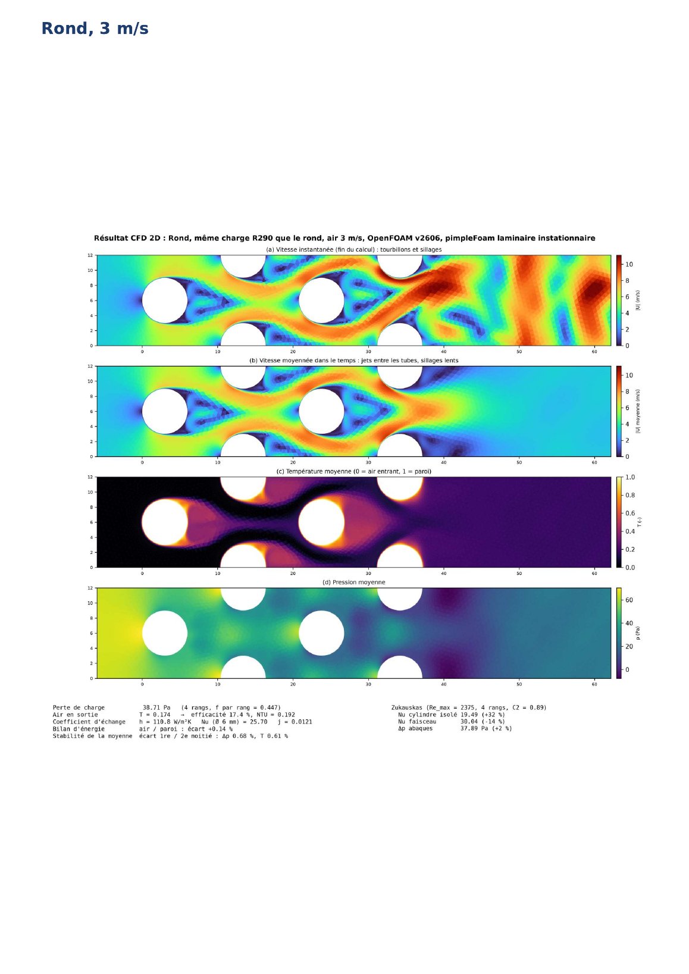
[picture p42: conception_echangeur/docs/rapport_cfd/pages/p-41.jpg]
Rond, 3 m/s


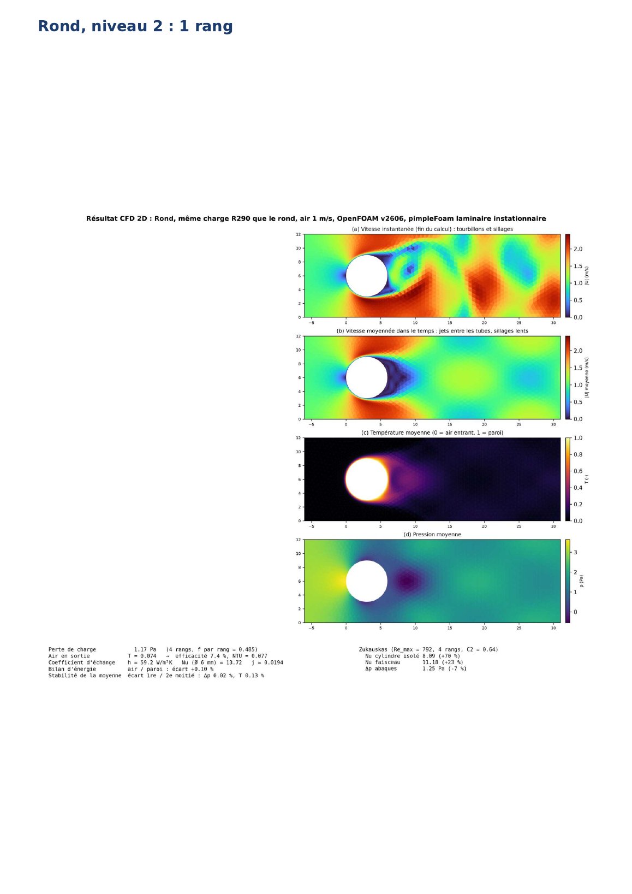
[picture p43: conception_echangeur/docs/rapport_cfd/pages/p-42.jpg]
Rond, niveau 2 : 1 rang


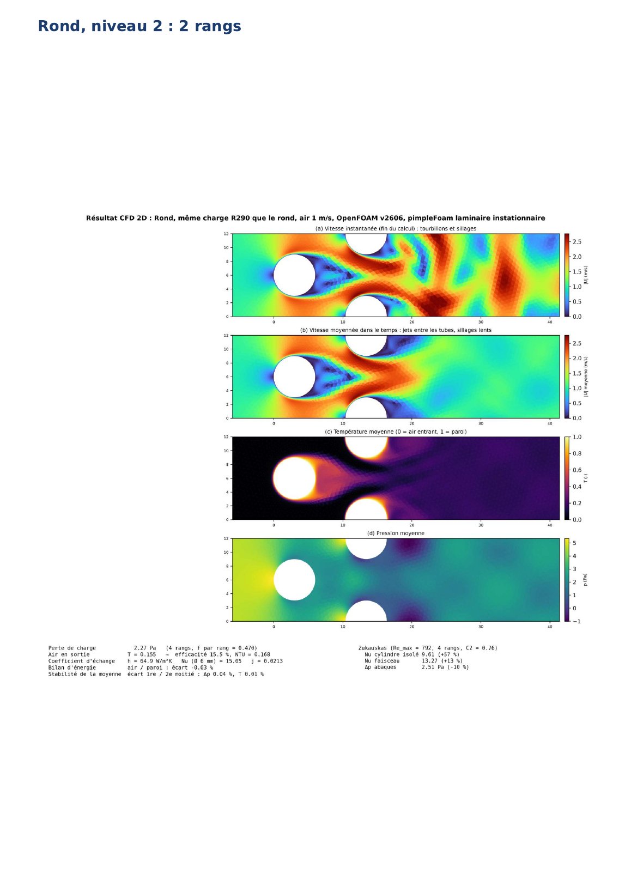
[picture p44: conception_echangeur/docs/rapport_cfd/pages/p-43.jpg]
Rond, niveau 2 : 2 rangs


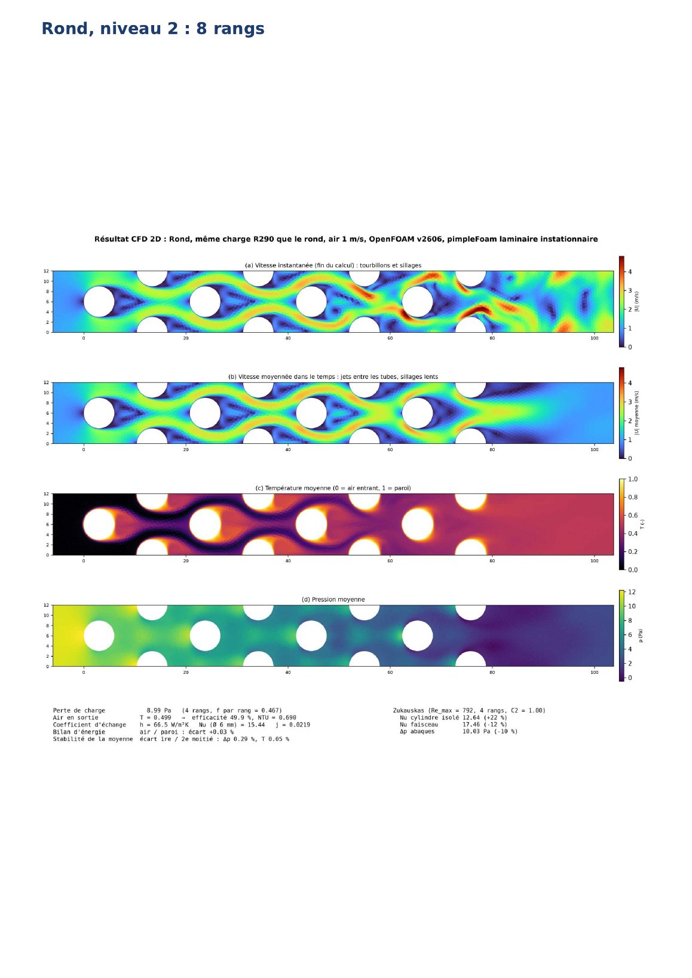
[picture p45: conception_echangeur/docs/rapport_cfd/pages/p-44.jpg]
Rond, niveau 2 : 8 rangs


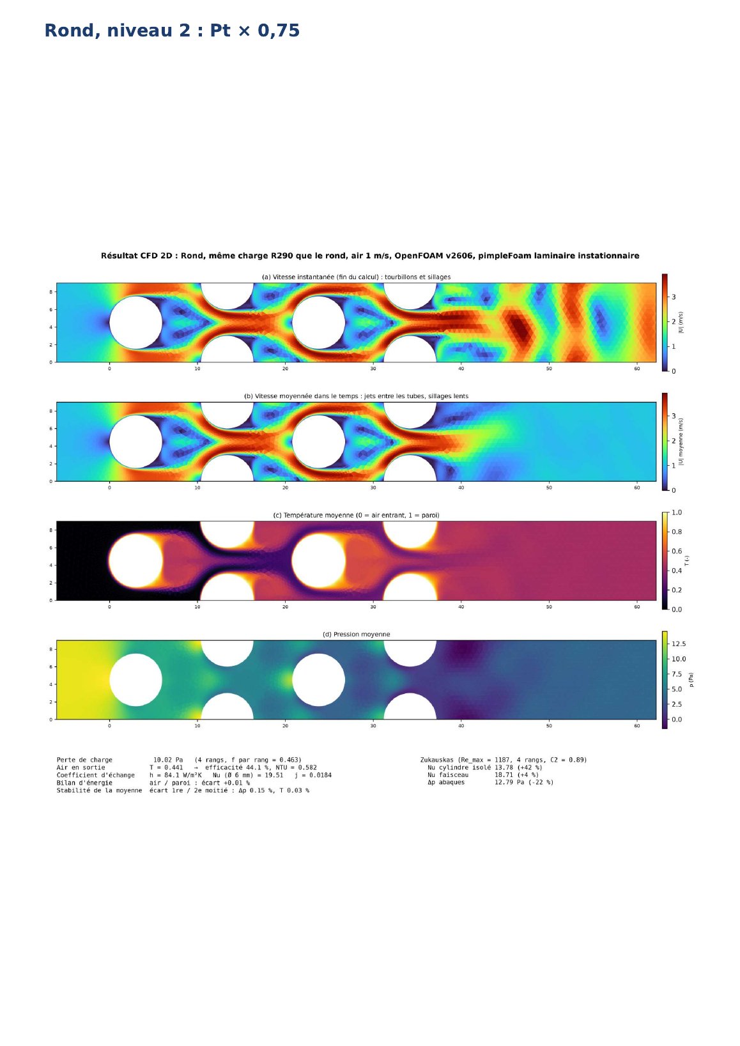
[picture p46: conception_echangeur/docs/rapport_cfd/pages/p-45.jpg]
Rond, niveau 2 : Pt × 0,75


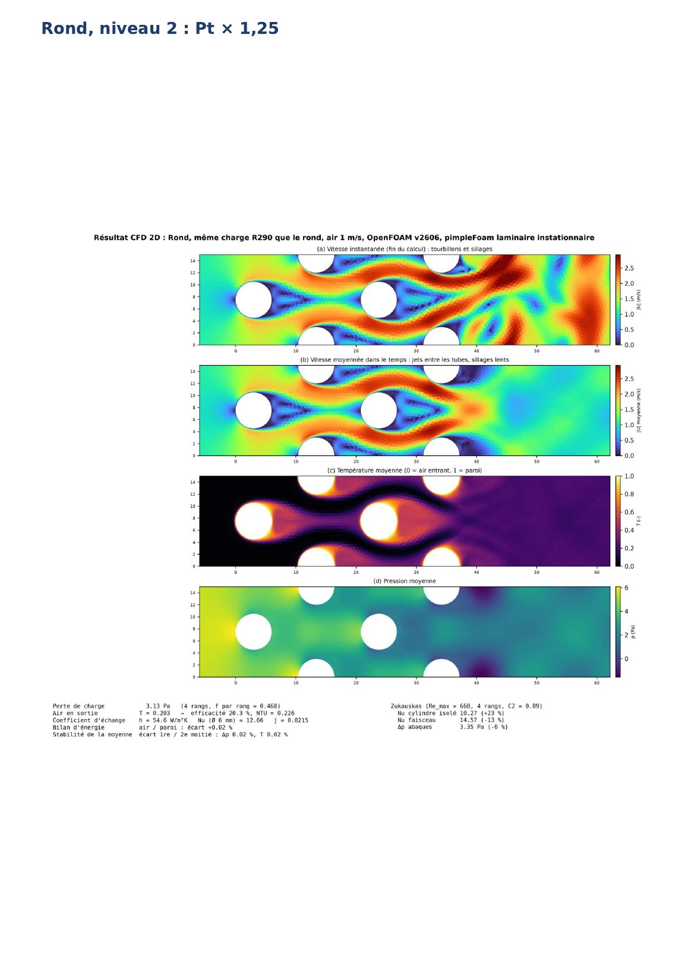
[picture p47: conception_echangeur/docs/rapport_cfd/pages/p-46.jpg]
Rond, niveau 2 : Pt × 1,25


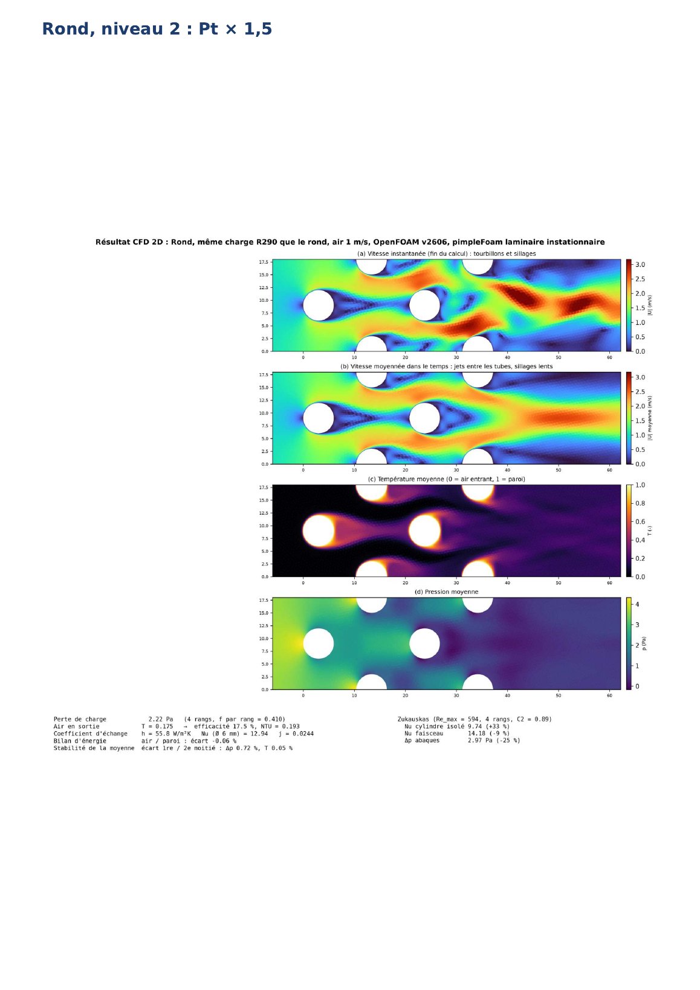
[picture p48: conception_echangeur/docs/rapport_cfd/pages/p-47.jpg]
Rond, niveau 2 : Pt × 1,5


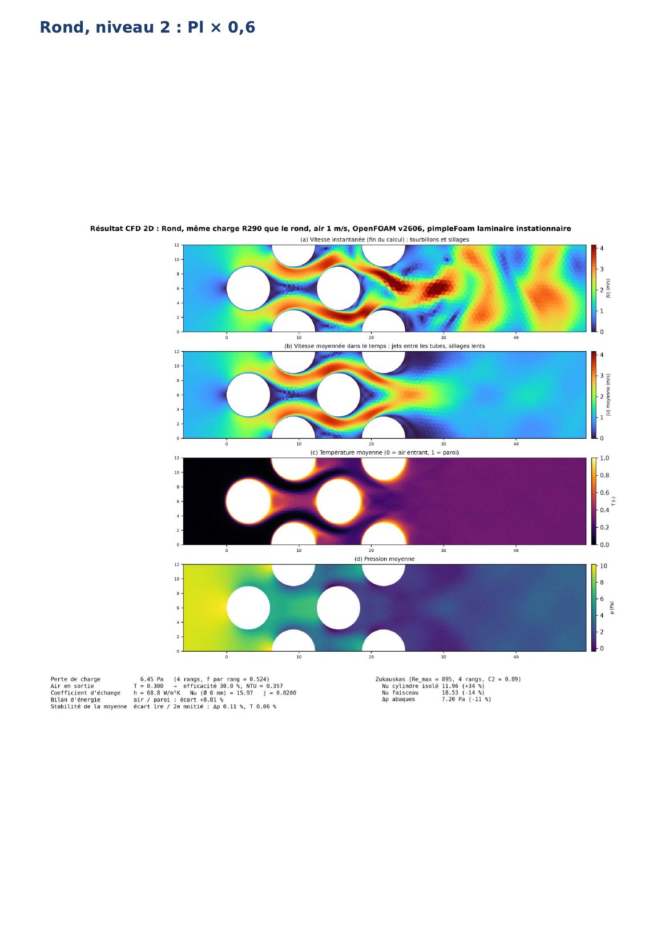
[picture p49: conception_echangeur/docs/rapport_cfd/pages/p-48.jpg]
Rond, niveau 2 : Pl × 0,6


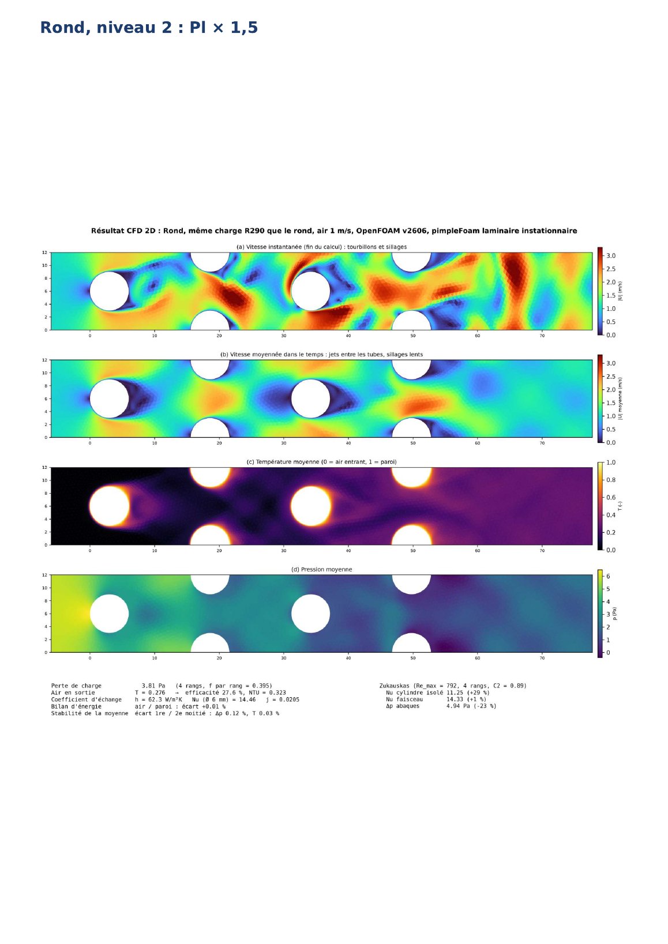
[picture p50: conception_echangeur/docs/rapport_cfd/pages/p-49.jpg]
Rond, niveau 2 : Pl × 1,5


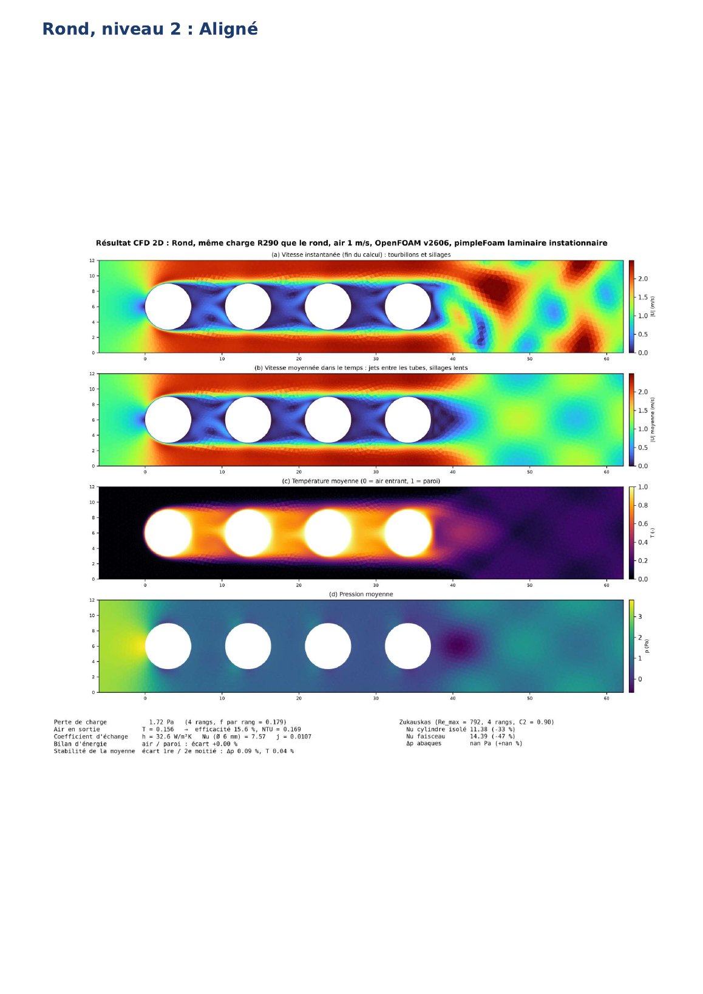
[picture p51: conception_echangeur/docs/rapport_cfd/pages/p-50.jpg]
Rond, niveau 2 : Aligné


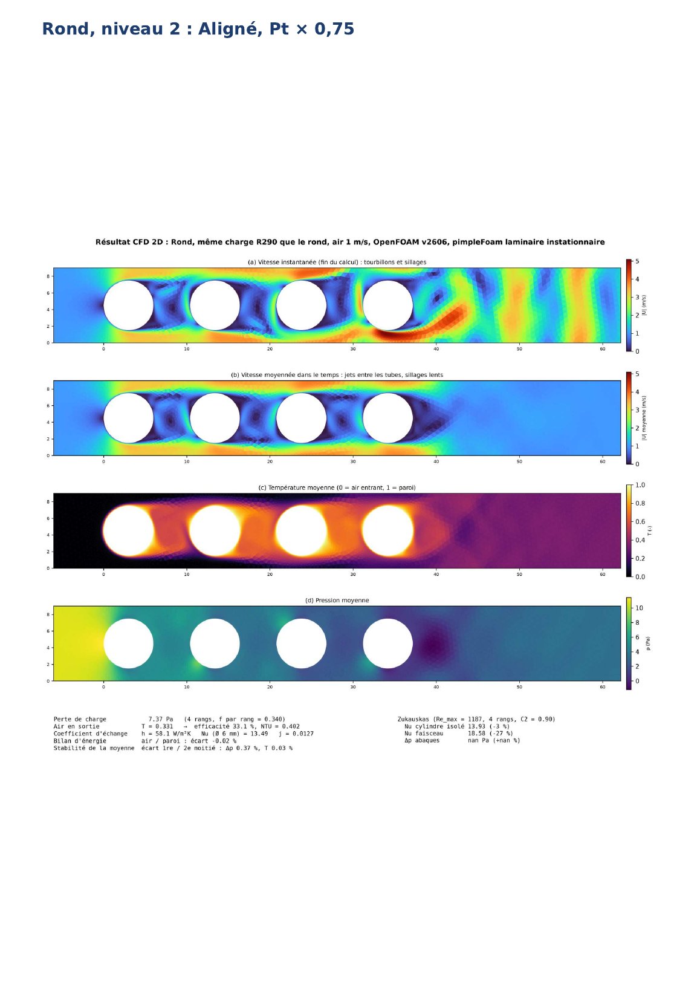
[picture p52: conception_echangeur/docs/rapport_cfd/pages/p-51.jpg]
Rond, niveau 2 : Aligné, Pt × 0,75


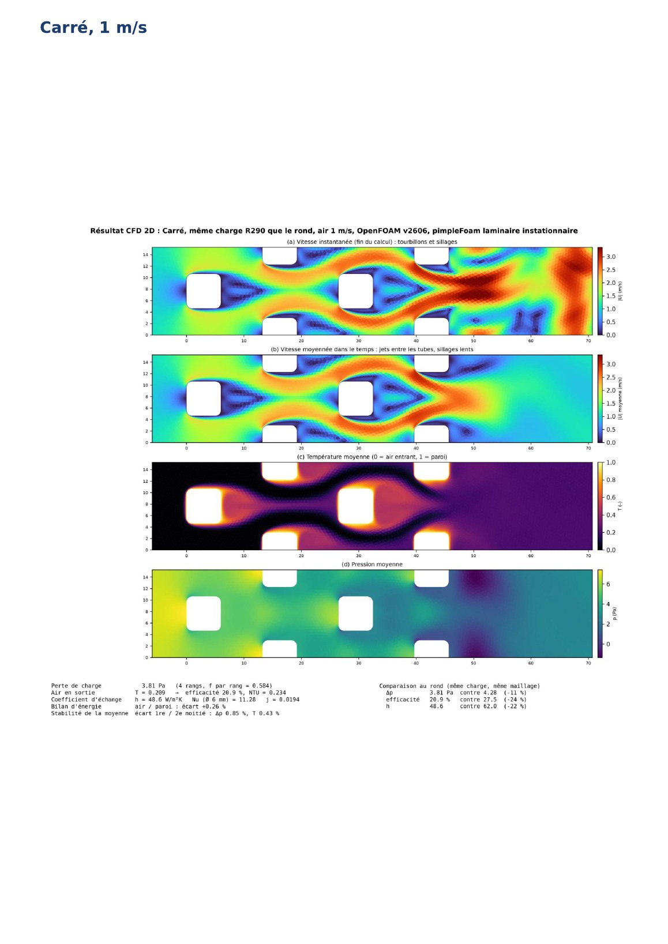
[picture p53: conception_echangeur/docs/rapport_cfd/pages/p-52.jpg]
Carré, 1 m/s


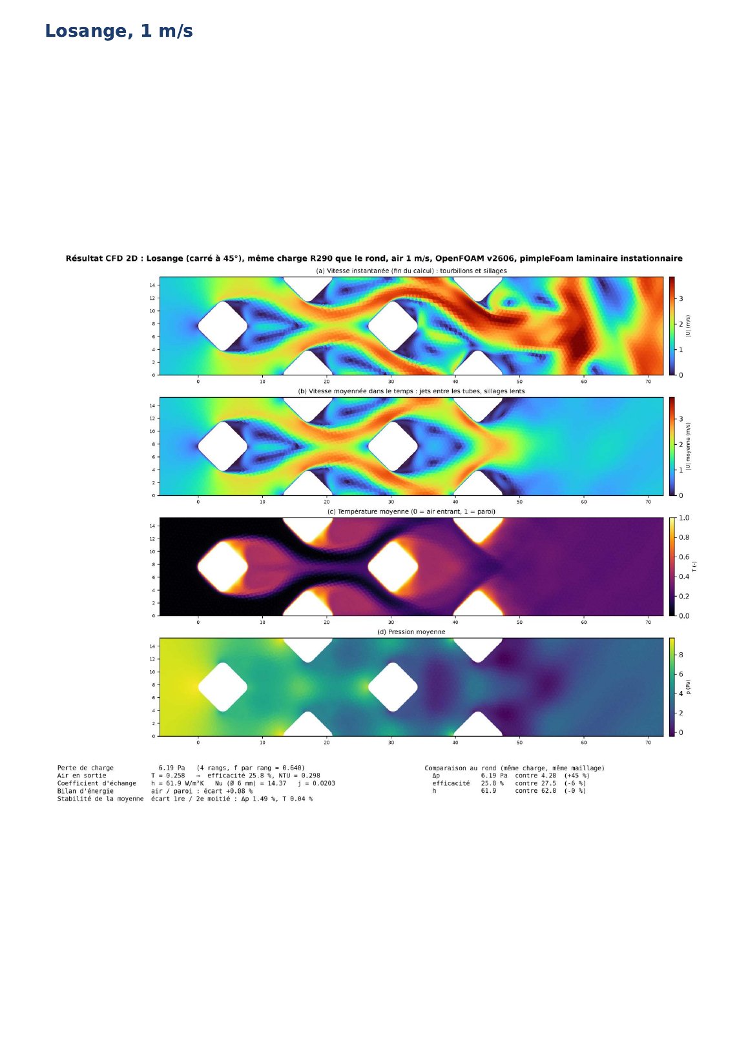
[picture p54: conception_echangeur/docs/rapport_cfd/pages/p-53.jpg]
Losange, 1 m/s


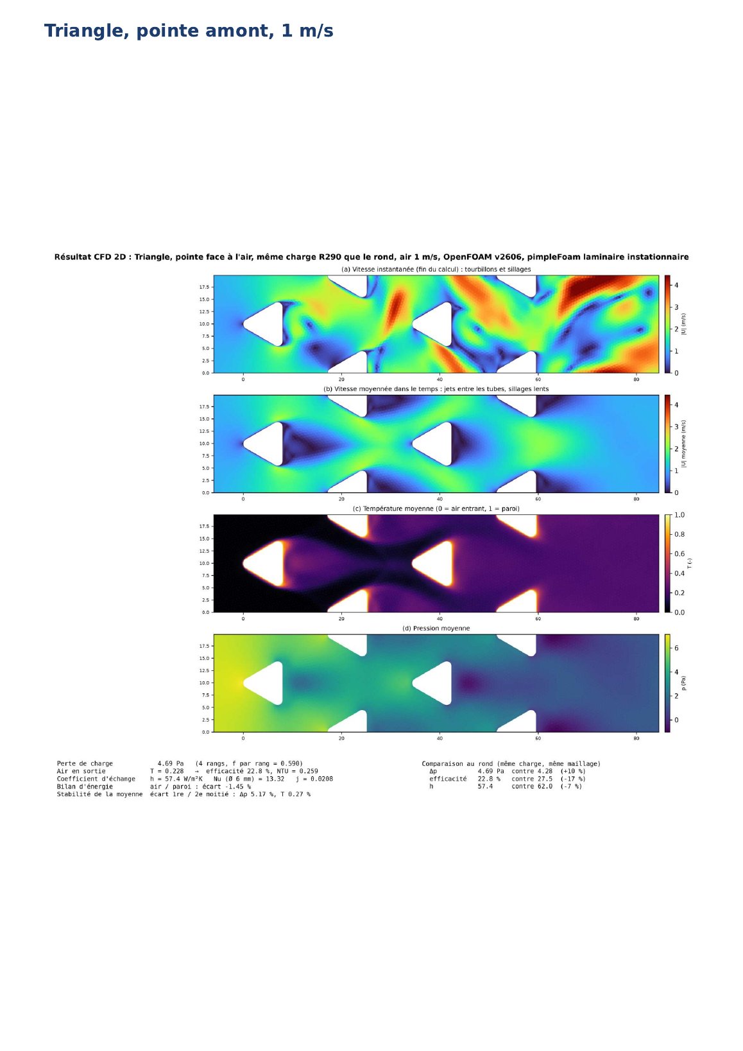
[picture p55: conception_echangeur/docs/rapport_cfd/pages/p-54.jpg]
Triangle, pointe amont, 1 m/s


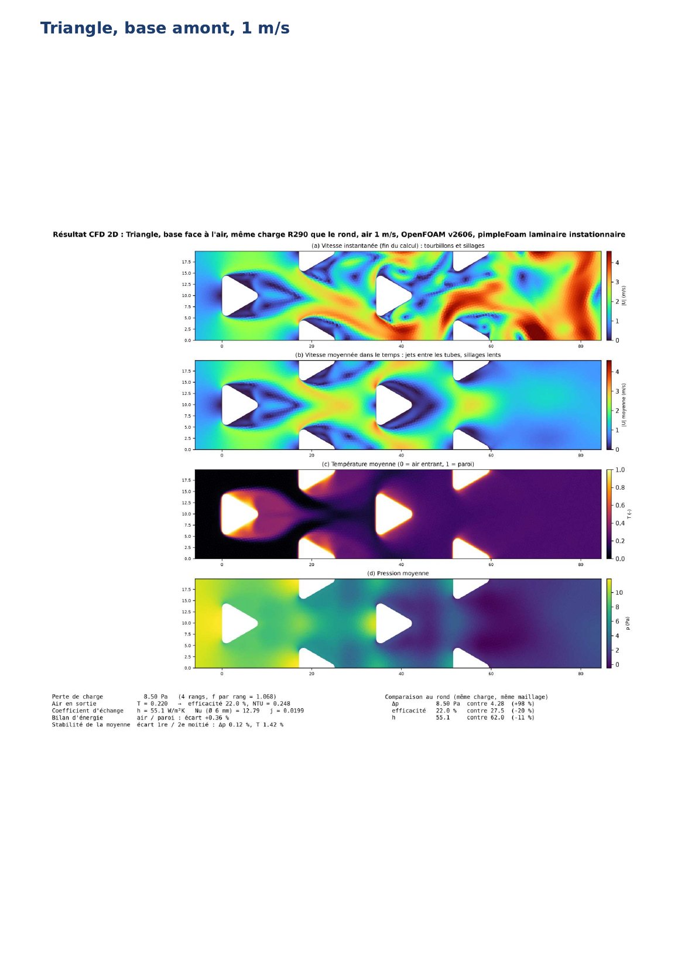
[picture p56: conception_echangeur/docs/rapport_cfd/pages/p-55.jpg]
Triangle, base amont, 1 m/s


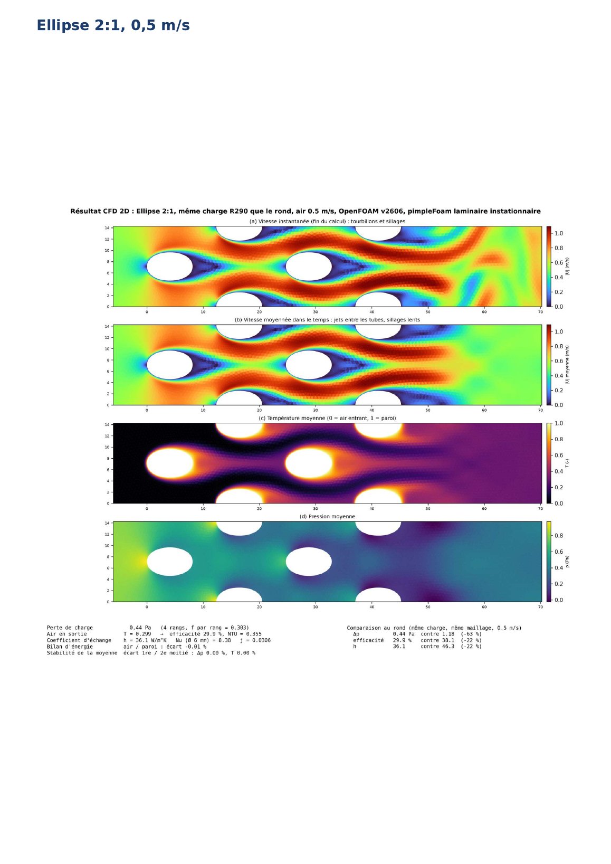
[picture p57: conception_echangeur/docs/rapport_cfd/pages/p-56.jpg]
Ellipse 2:1, 0,5 m/s


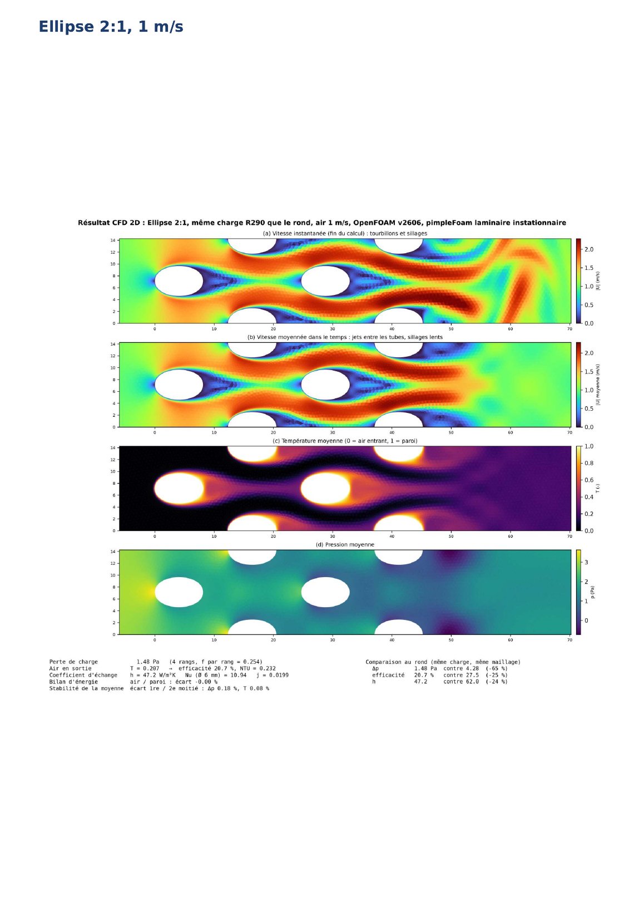
[picture p58: conception_echangeur/docs/rapport_cfd/pages/p-57.jpg]
Ellipse 2:1, 1 m/s


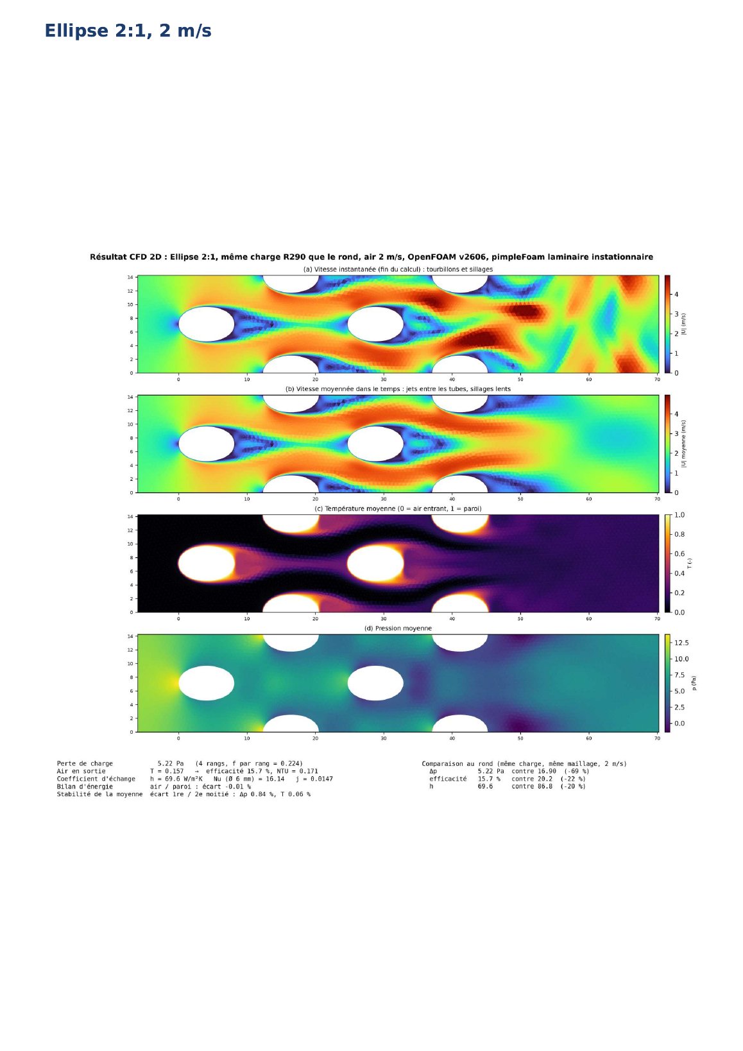
[picture p59: conception_echangeur/docs/rapport_cfd/pages/p-58.jpg]
Ellipse 2:1, 2 m/s


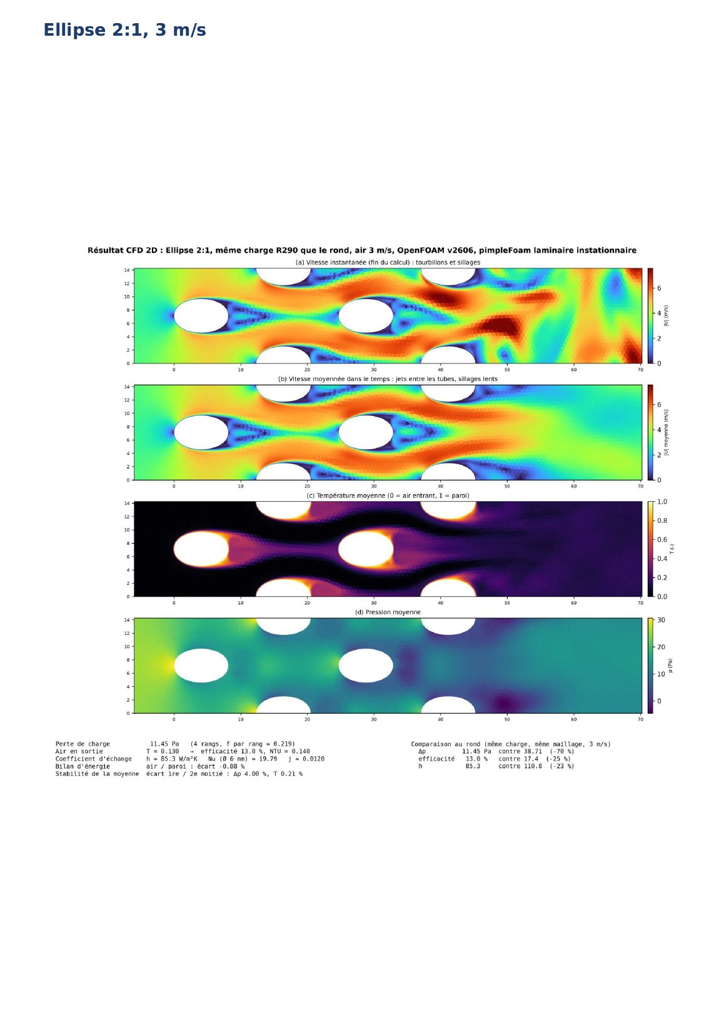
[picture p60: conception_echangeur/docs/rapport_cfd/pages/p-59.jpg]
Ellipse 2:1, 3 m/s


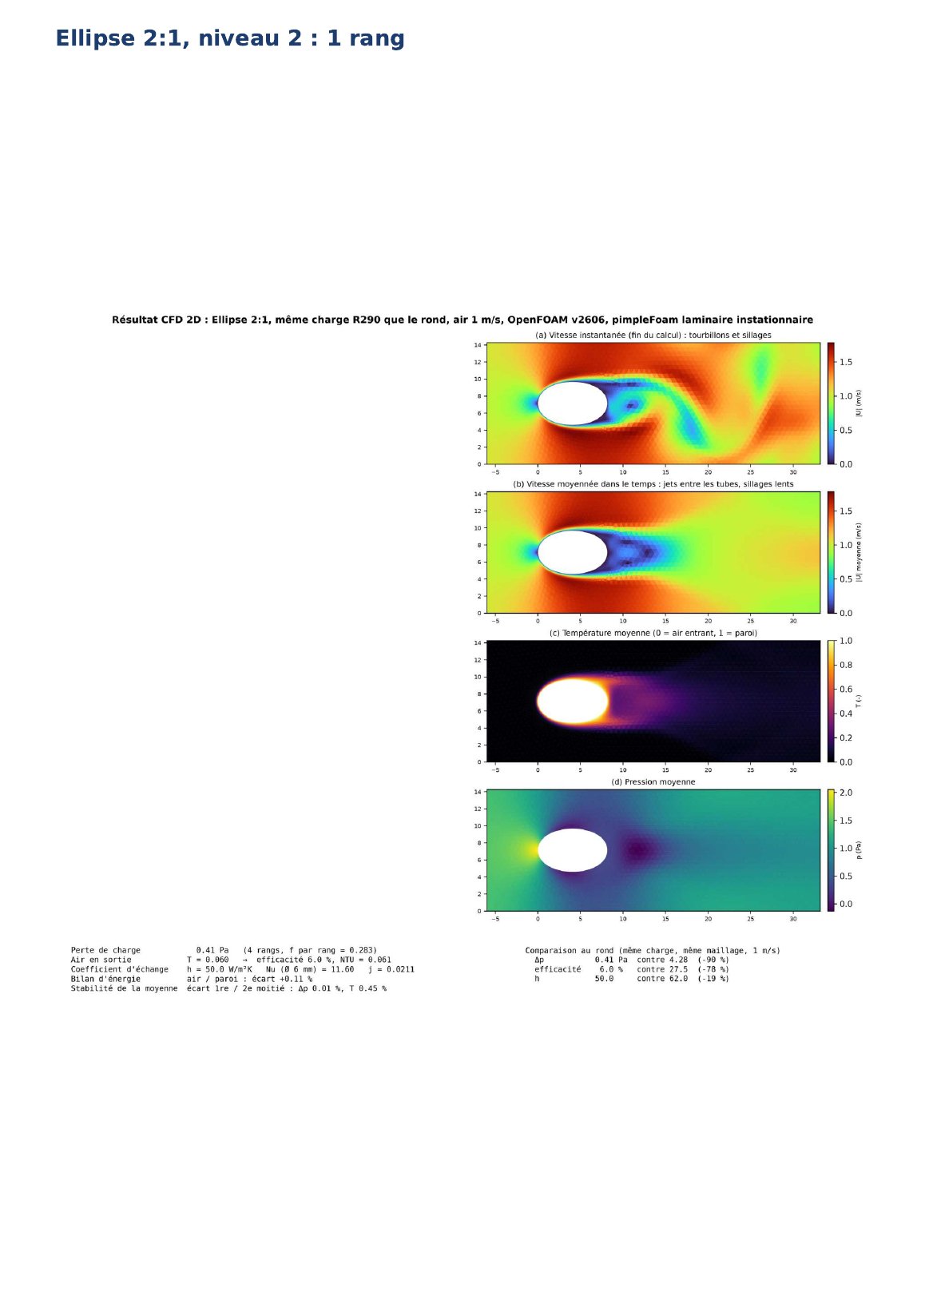
[picture p61: conception_echangeur/docs/rapport_cfd/pages/p-60.jpg]
Ellipse 2:1, niveau 2 : 1 rang


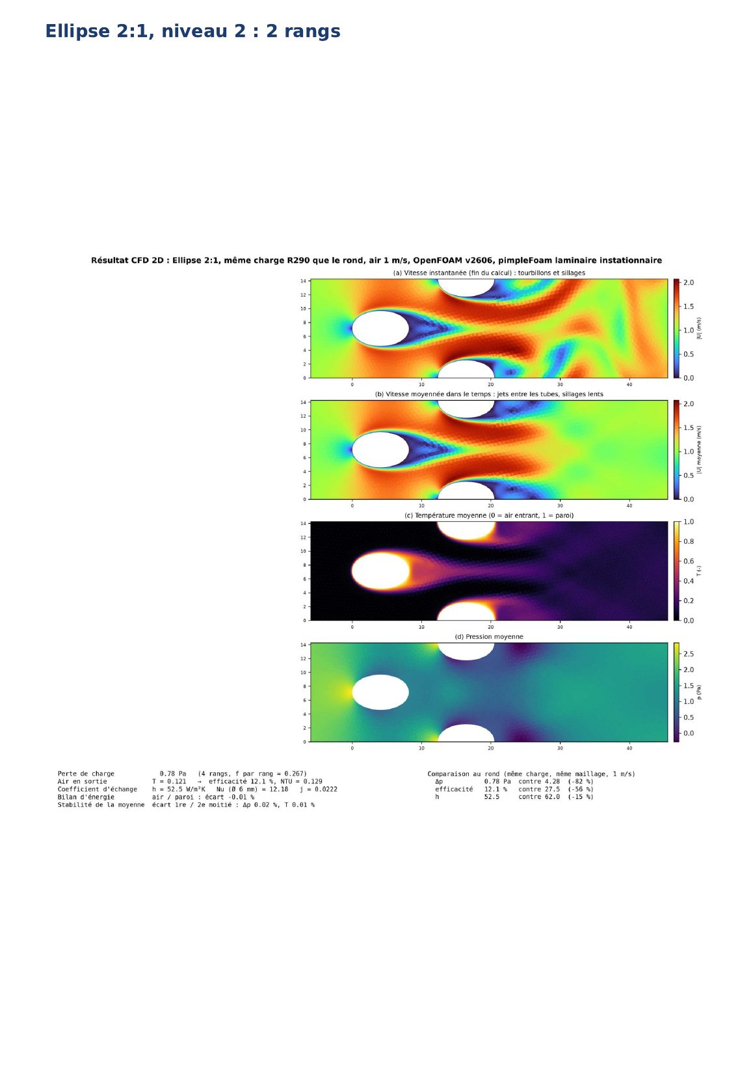
[picture p62: conception_echangeur/docs/rapport_cfd/pages/p-61.jpg]
Ellipse 2:1, niveau 2 : 2 rangs


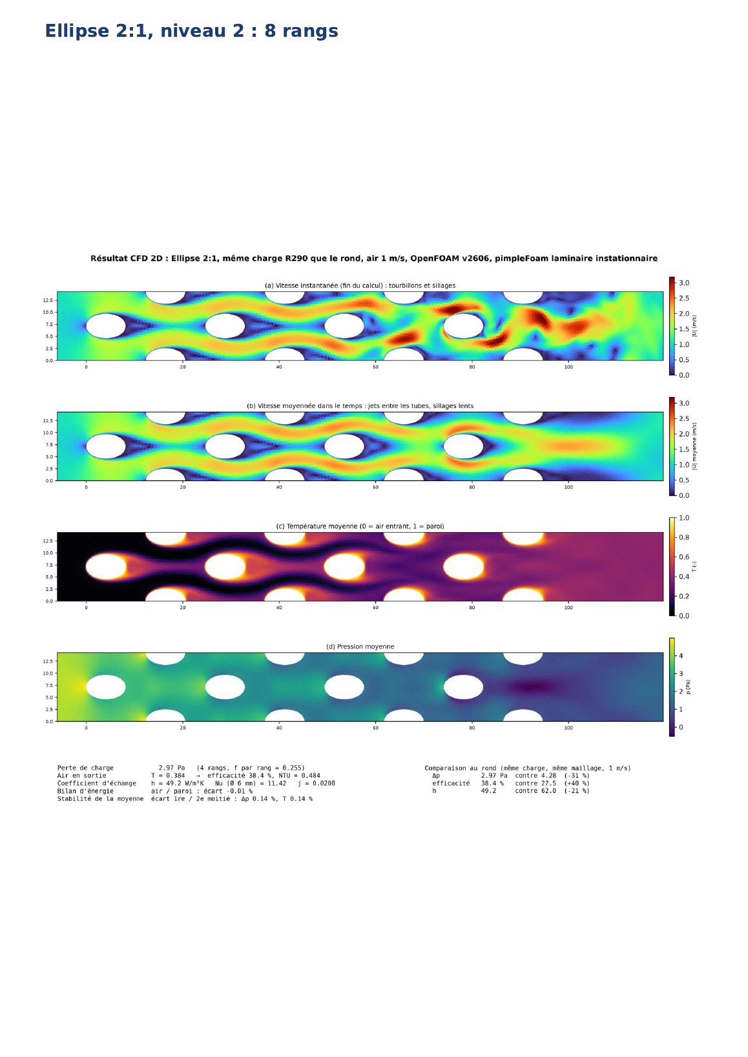
[picture p63: conception_echangeur/docs/rapport_cfd/pages/p-62.jpg]
Ellipse 2:1, niveau 2 : 8 rangs


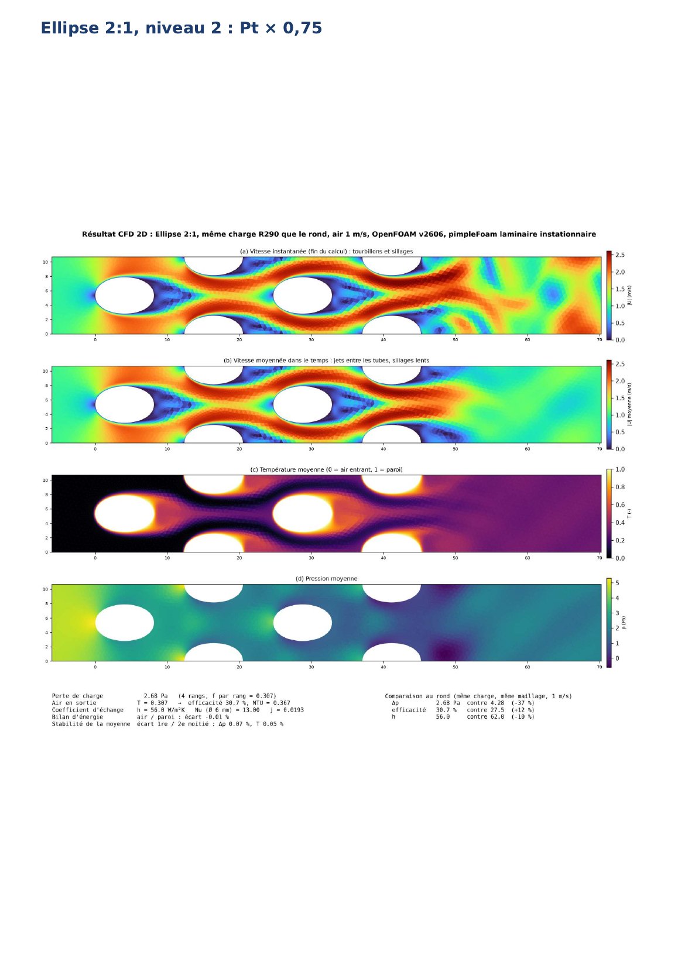
[picture p64: conception_echangeur/docs/rapport_cfd/pages/p-63.jpg]
Ellipse 2:1, niveau 2 : Pt × 0,75


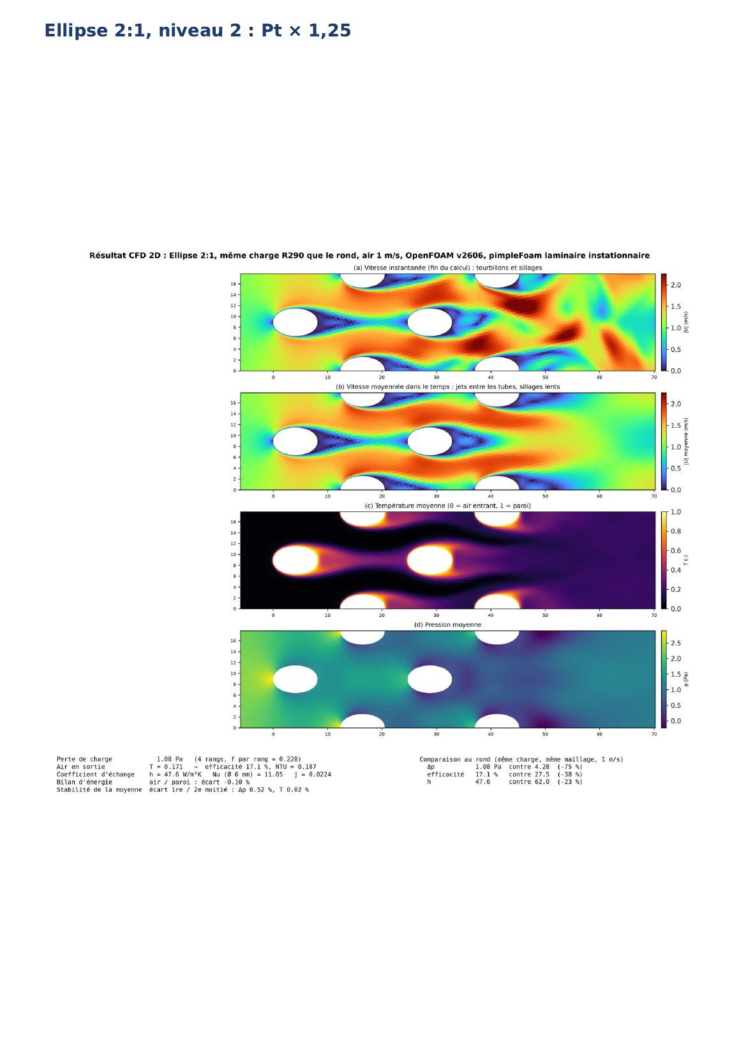
[picture p65: conception_echangeur/docs/rapport_cfd/pages/p-64.jpg]
Ellipse 2:1, niveau 2 : Pt × 1,25


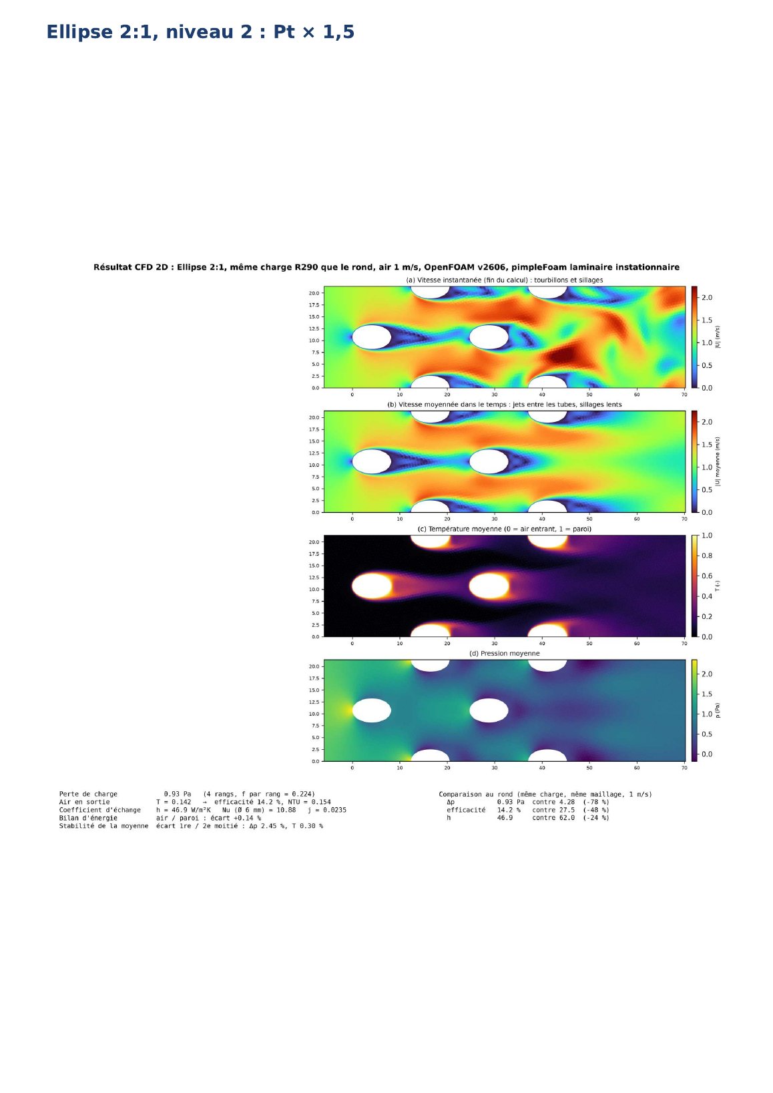
[picture p66: conception_echangeur/docs/rapport_cfd/pages/p-65.jpg]
Ellipse 2:1, niveau 2 : Pt × 1,5


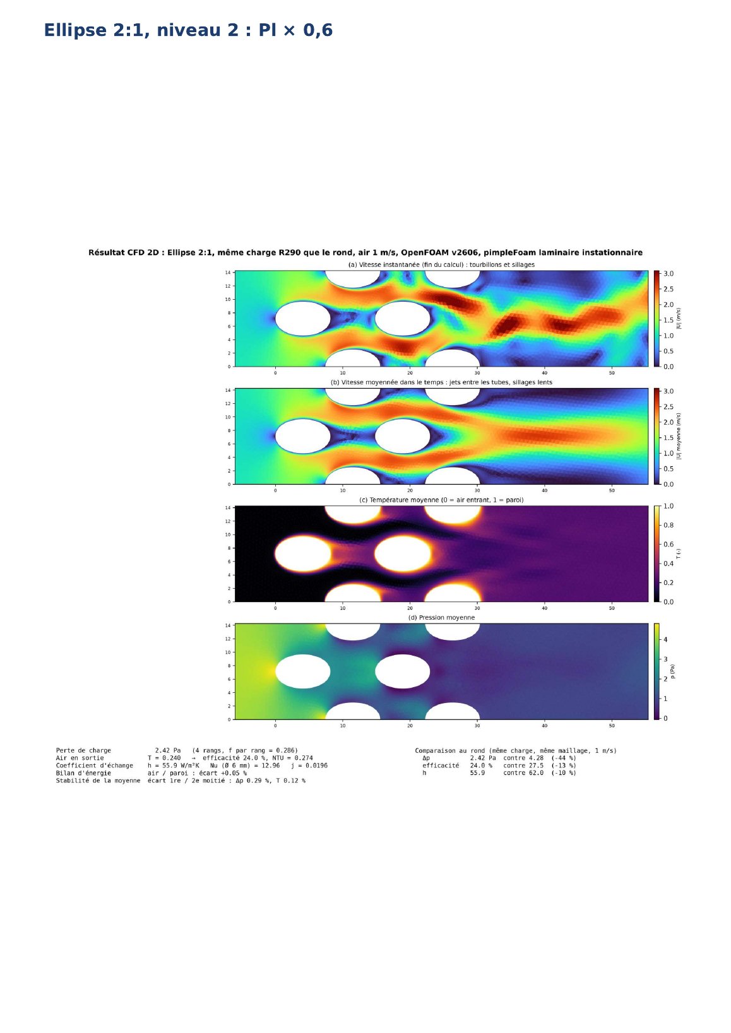
[picture p67: conception_echangeur/docs/rapport_cfd/pages/p-66.jpg]
Ellipse 2:1, niveau 2 : Pl × 0,6


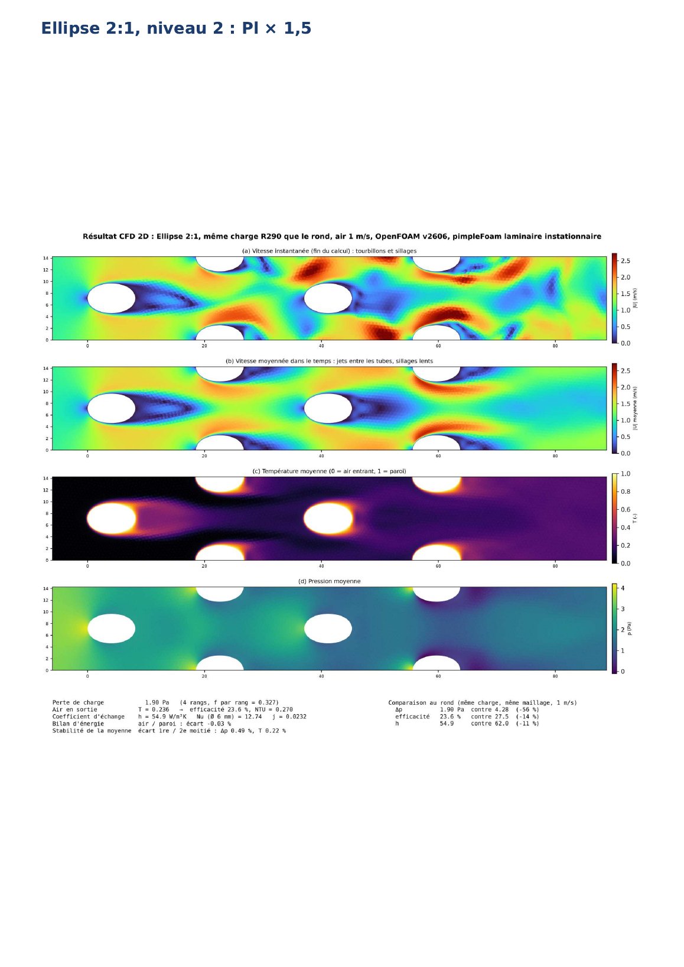
[picture p68: conception_echangeur/docs/rapport_cfd/pages/p-67.jpg]
Ellipse 2:1, niveau 2 : Pl × 1,5


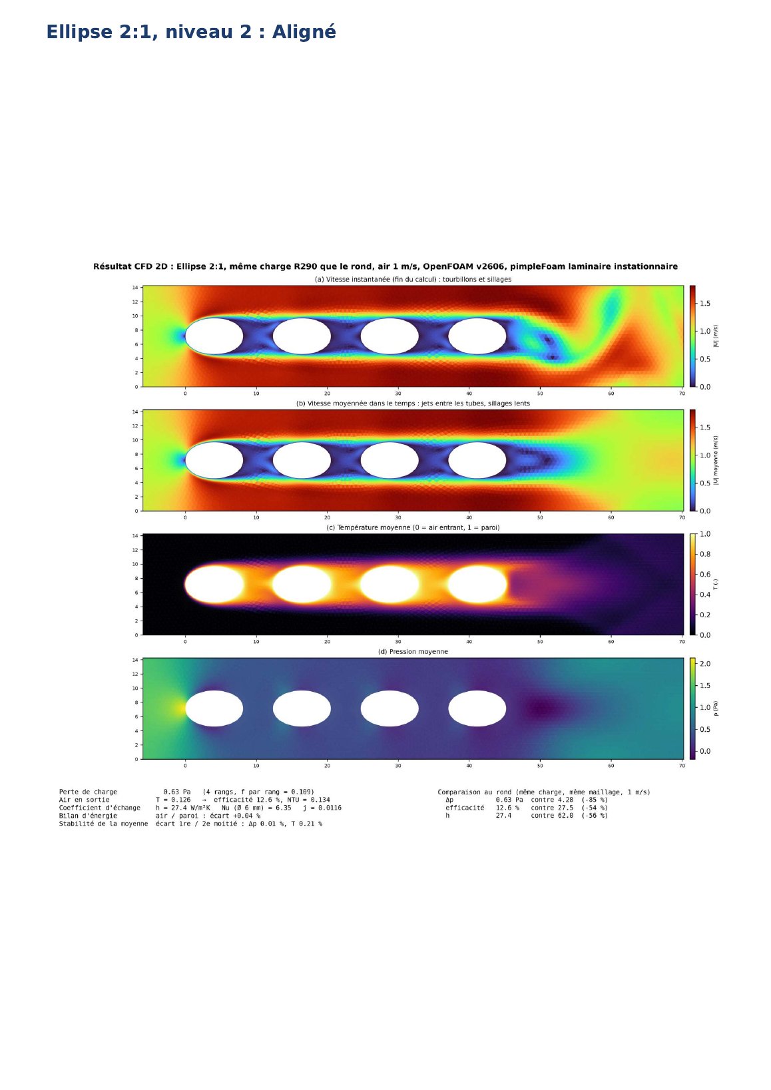
[picture p69: conception_echangeur/docs/rapport_cfd/pages/p-68.jpg]
Ellipse 2:1, niveau 2 : Aligné


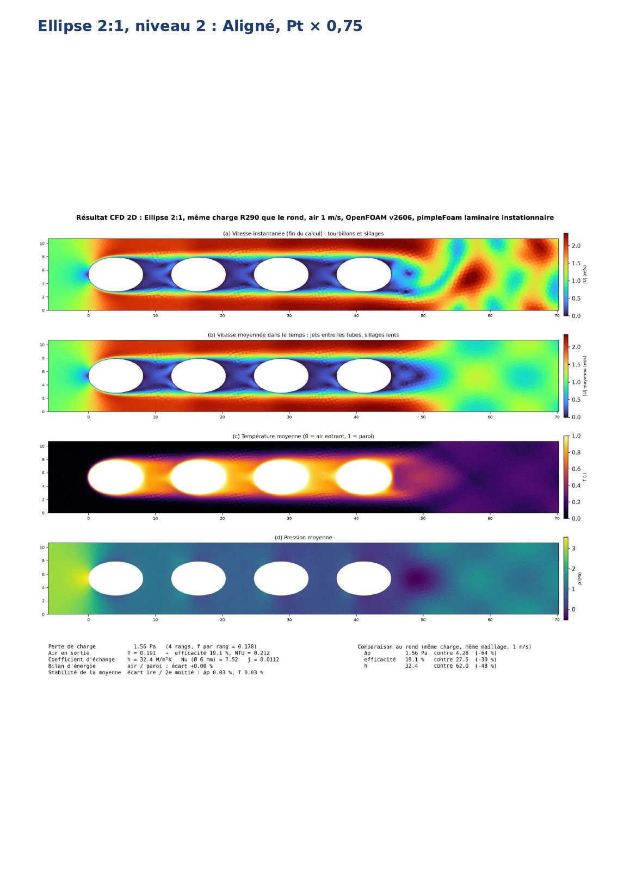
[picture p70: conception_echangeur/docs/rapport_cfd/pages/p-69.jpg]
Ellipse 2:1, niveau 2 : Aligné, Pt × 0,75


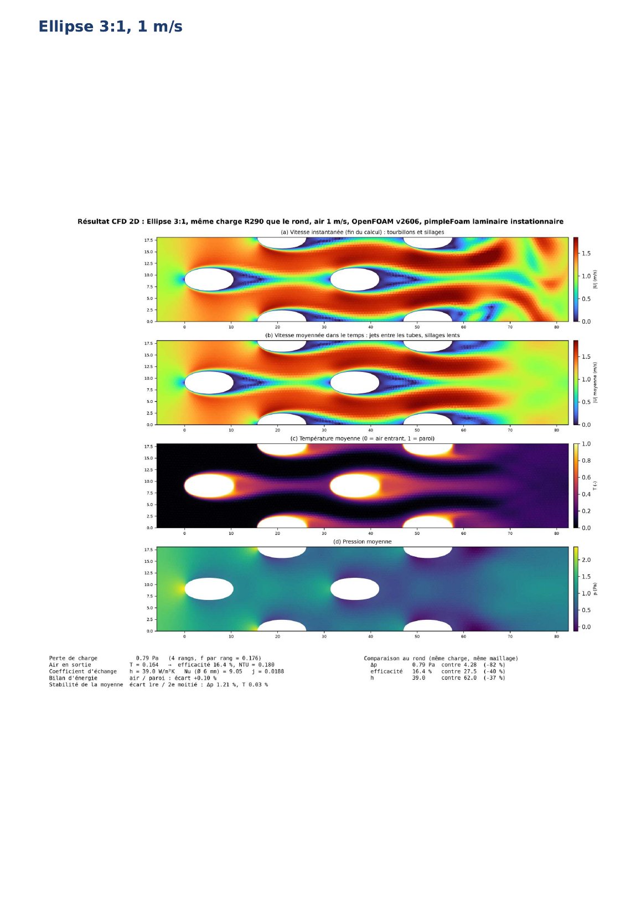
[picture p71: conception_echangeur/docs/rapport_cfd/pages/p-70.jpg]
Ellipse 3:1, 1 m/s


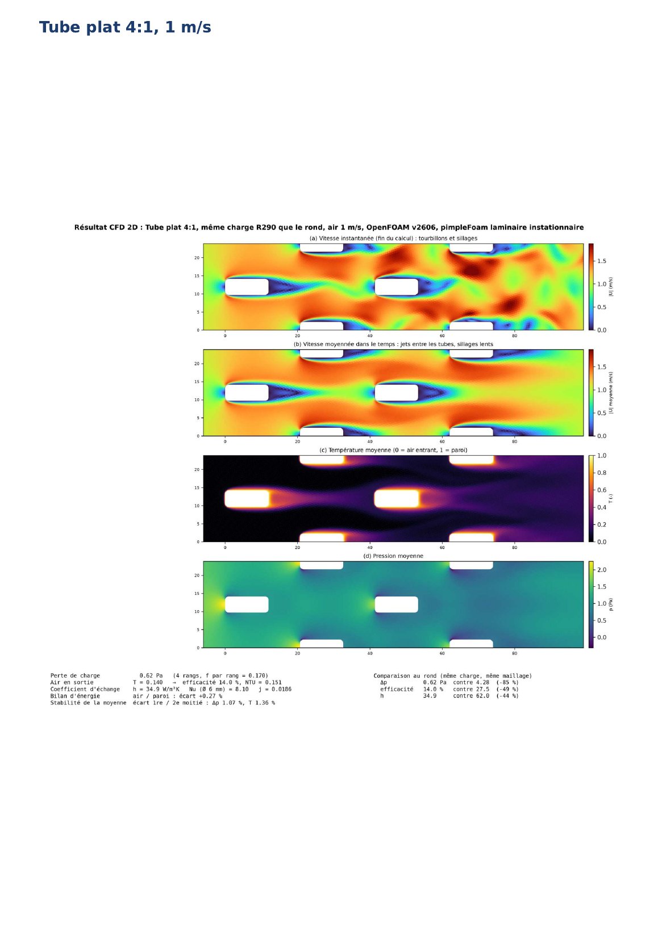
[picture p72: conception_echangeur/docs/rapport_cfd/pages/p-71.jpg]
Tube plat 4:1, 1 m/s


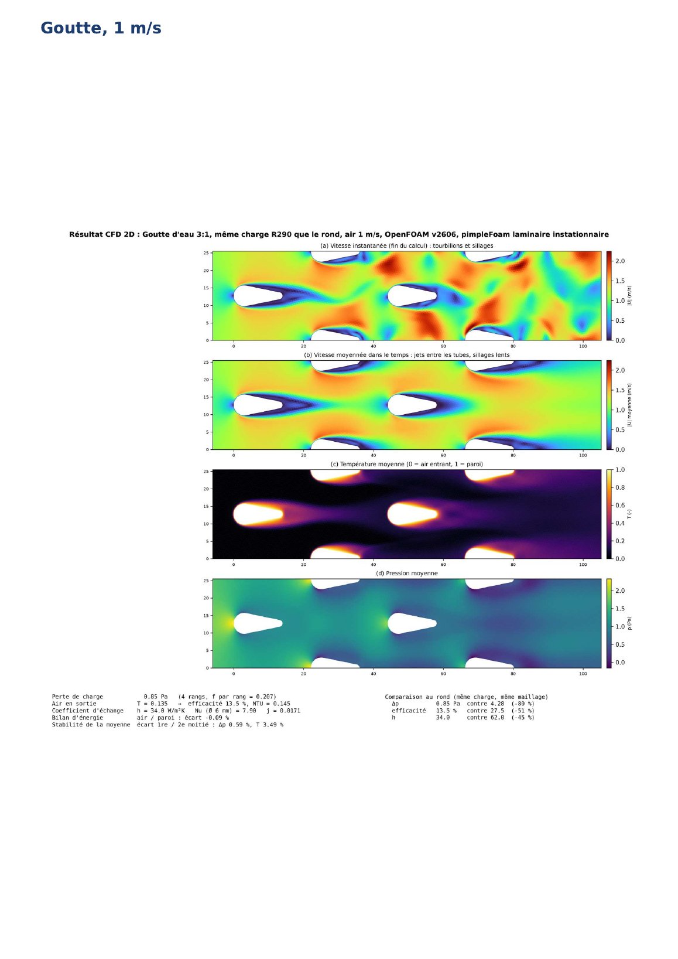
[picture p73: conception_echangeur/docs/rapport_cfd/pages/p-72.jpg]
Goutte, 1 m/s


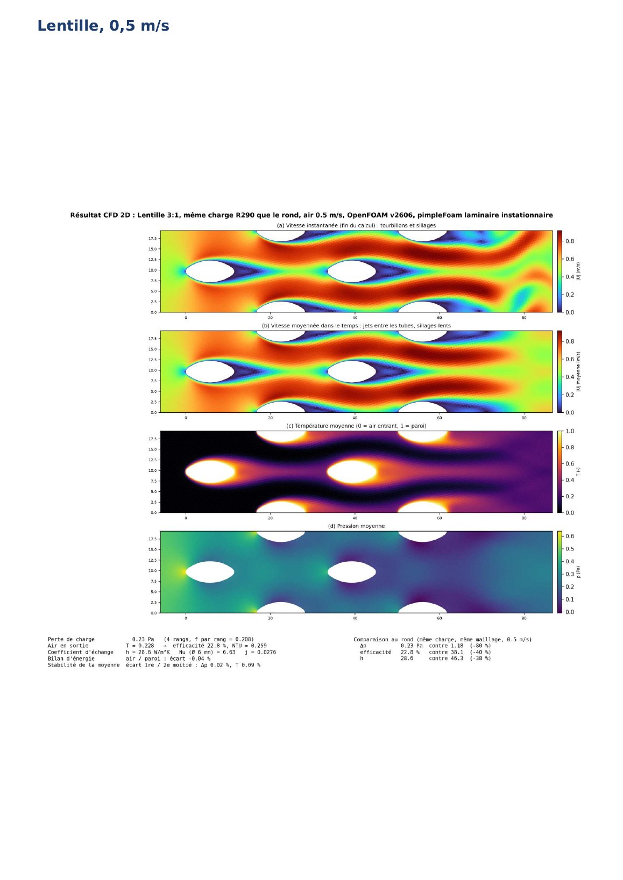
[picture p74: conception_echangeur/docs/rapport_cfd/pages/p-73.jpg]
Lentille, 0,5 m/s


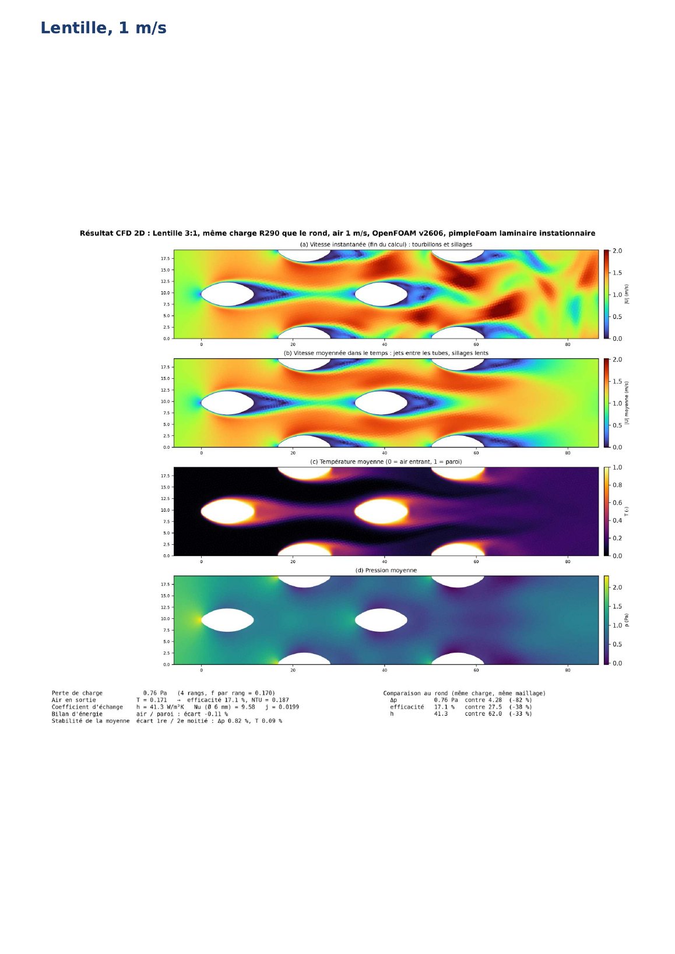
[picture p75: conception_echangeur/docs/rapport_cfd/pages/p-74.jpg]
Lentille, 1 m/s


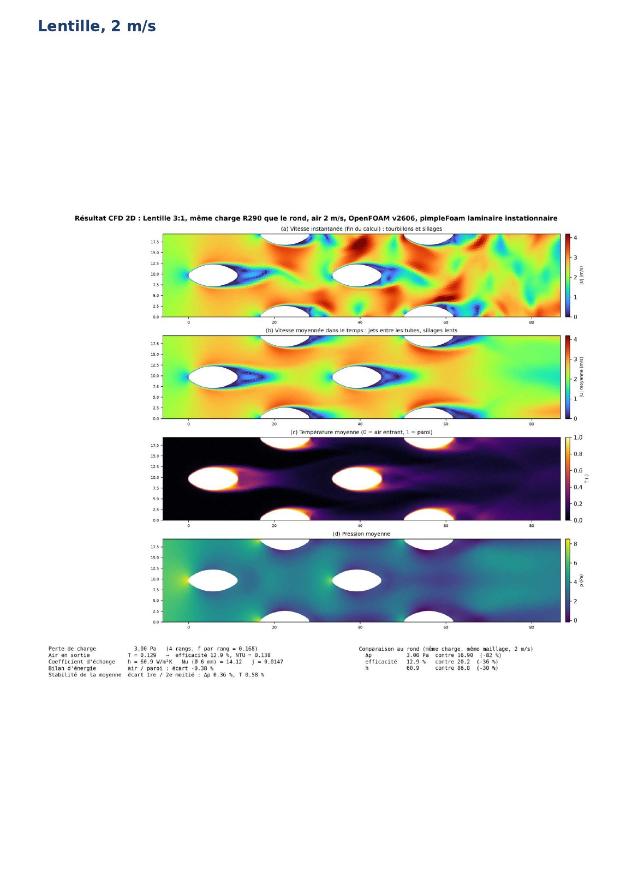
[picture p76: conception_echangeur/docs/rapport_cfd/pages/p-75.jpg]
Lentille, 2 m/s


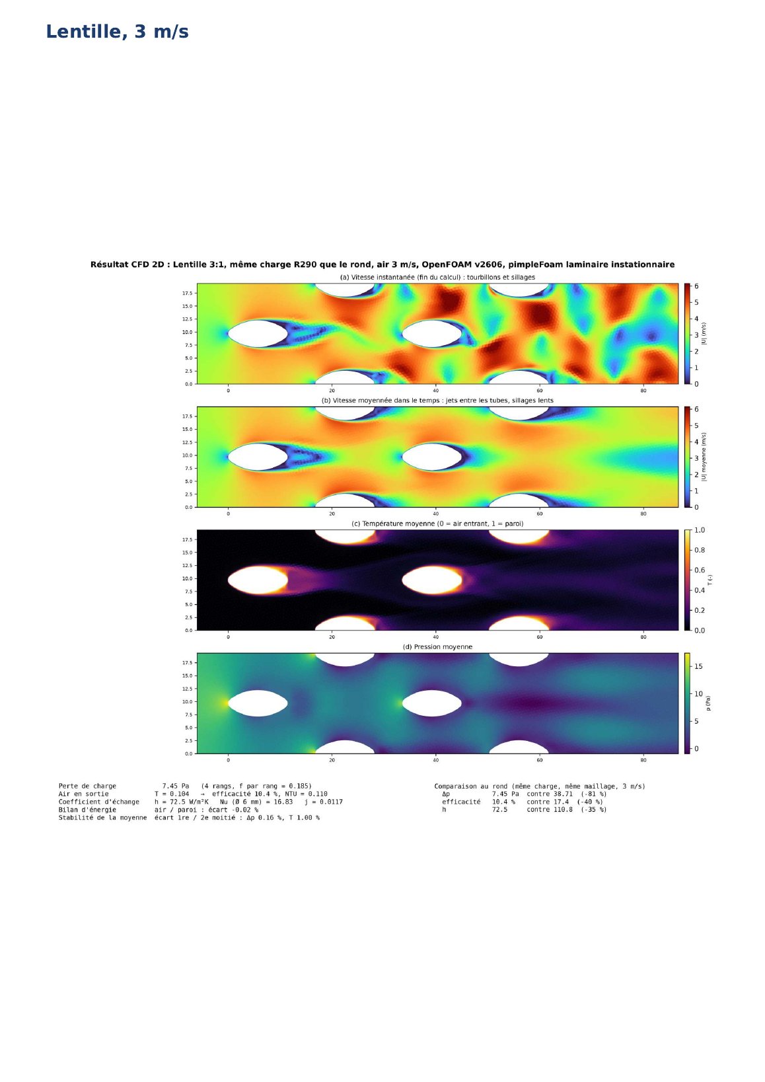
[picture p77: conception_echangeur/docs/rapport_cfd/pages/p-76.jpg]
Lentille, 3 m/s


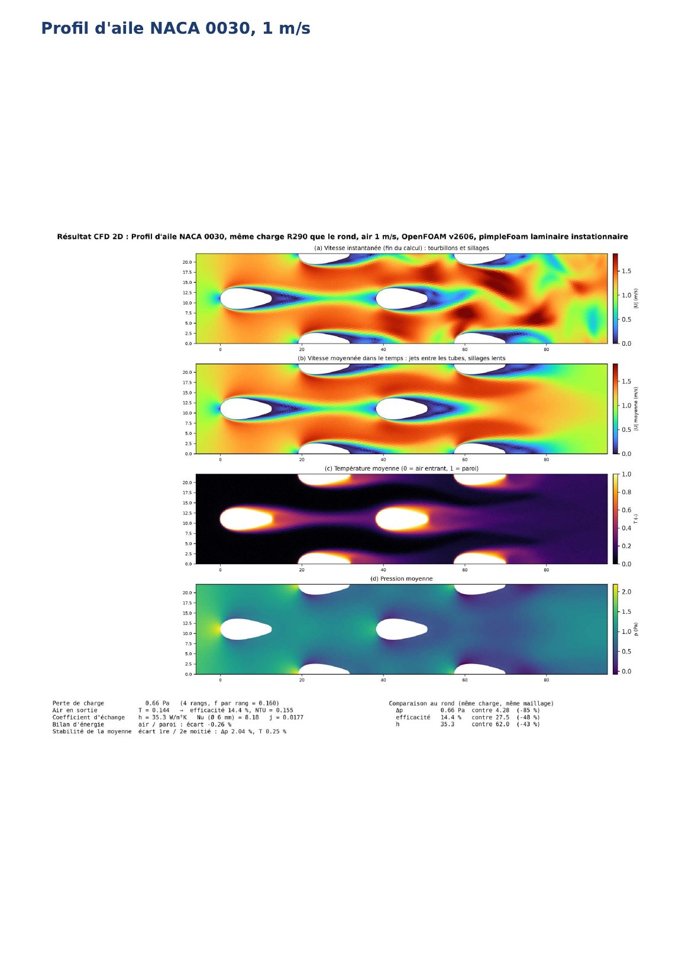
[picture p78: conception_echangeur/docs/rapport_cfd/pages/p-77.jpg]
Profil d'aile NACA 0030, 1 m/s


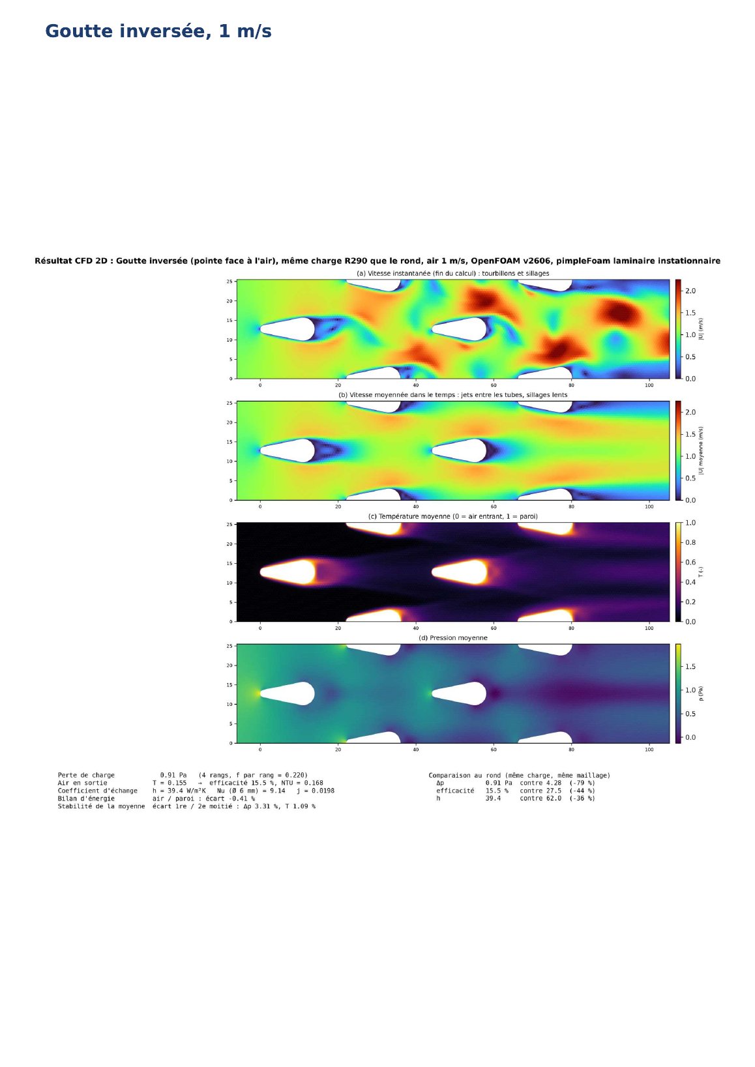
[picture p79: conception_echangeur/docs/rapport_cfd/pages/p-78.jpg]
Goutte inversée, 1 m/s


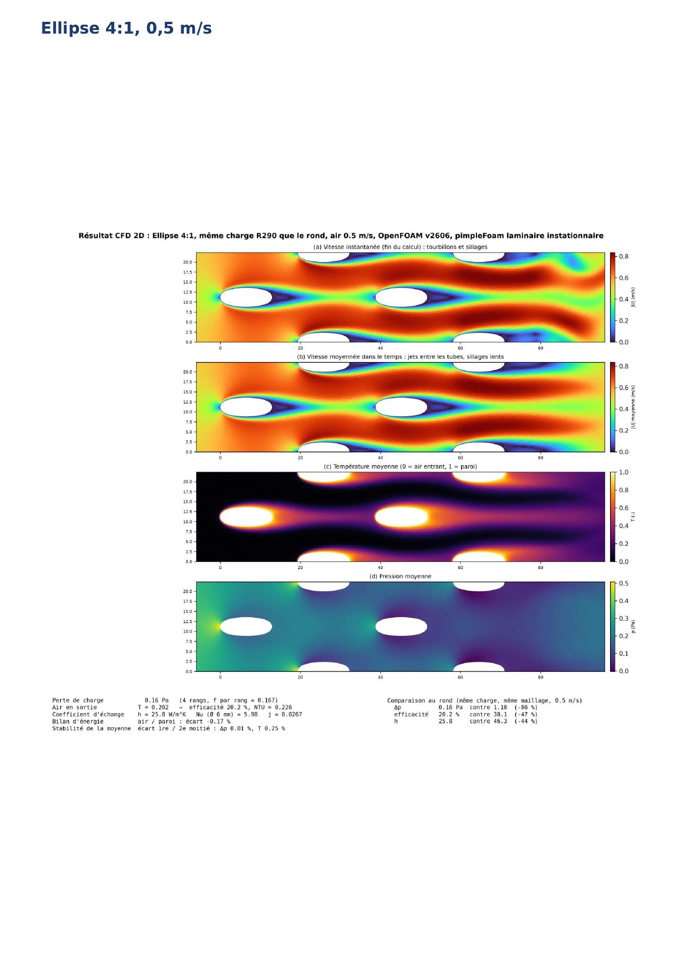
[picture p80: conception_echangeur/docs/rapport_cfd/pages/p-79.jpg]
Ellipse 4:1, 0,5 m/s


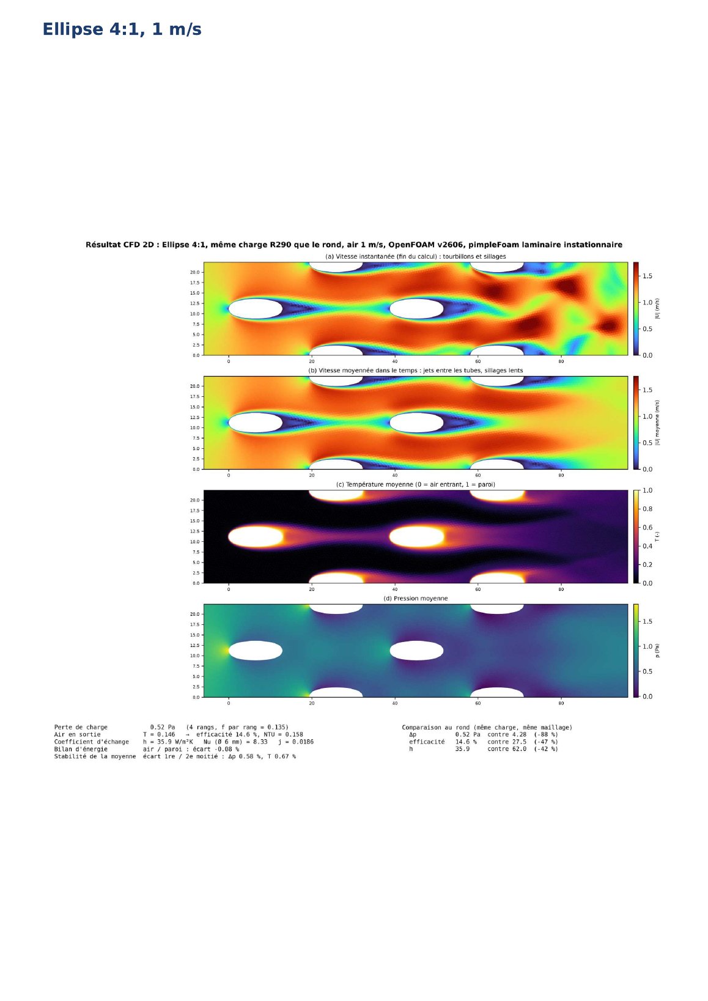
[picture p81: conception_echangeur/docs/rapport_cfd/pages/p-80.jpg]
Ellipse 4:1, 1 m/s


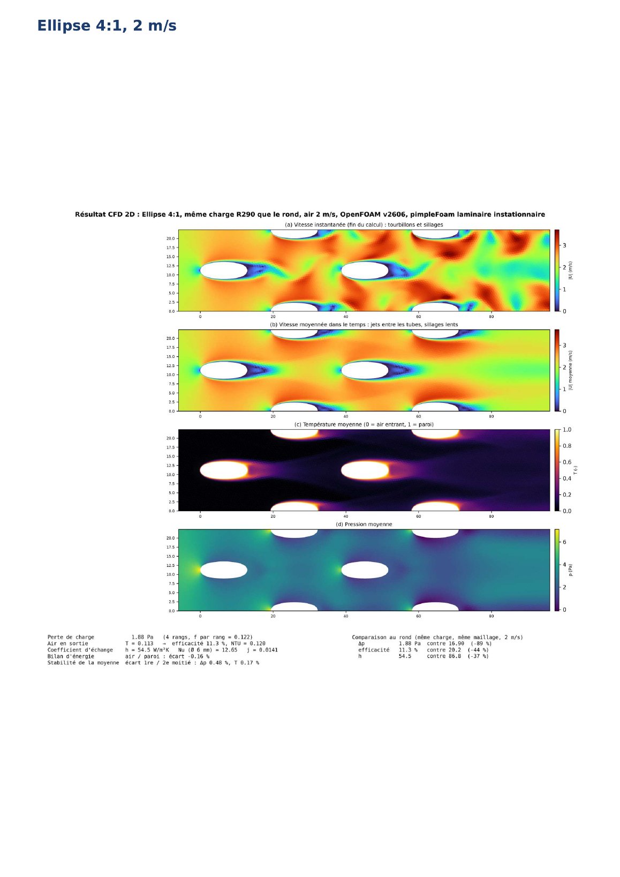
[picture p82: conception_echangeur/docs/rapport_cfd/pages/p-81.jpg]
Ellipse 4:1, 2 m/s


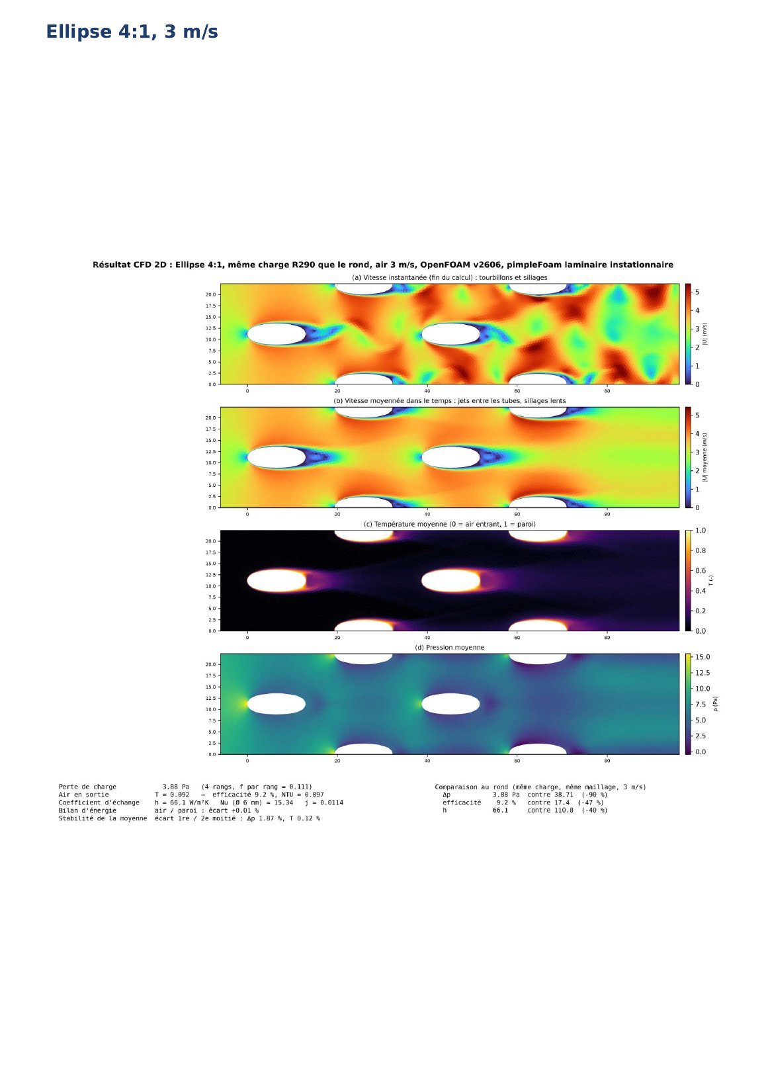
[picture p83: conception_echangeur/docs/rapport_cfd/pages/p-82.jpg]
Ellipse 4:1, 3 m/s


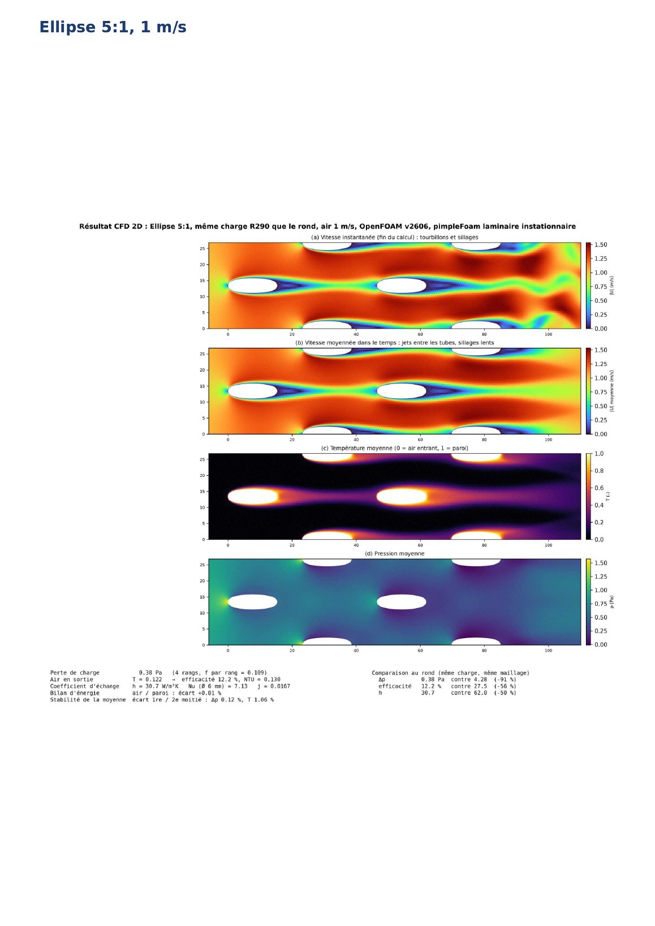
[picture p84: conception_echangeur/docs/rapport_cfd/pages/p-83.jpg]
Ellipse 5:1, 1 m/s


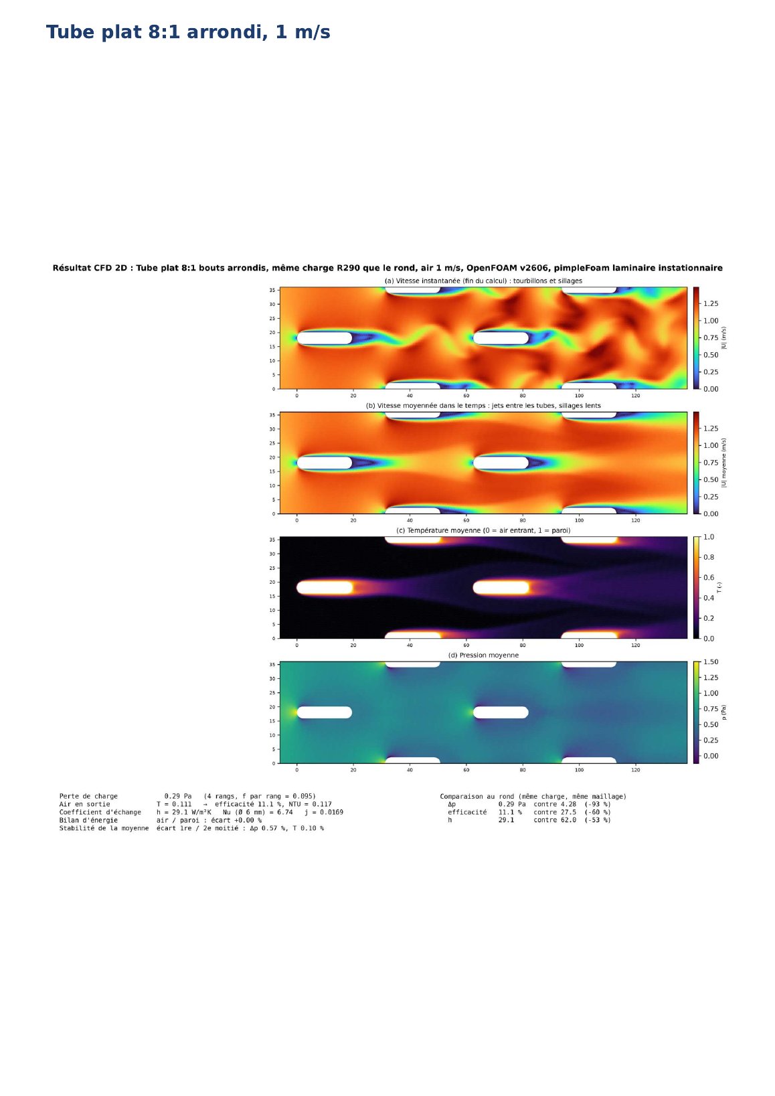
[picture p85: conception_echangeur/docs/rapport_cfd/pages/p-84.jpg]
Tube plat 8:1 arrondi, 1 m/s


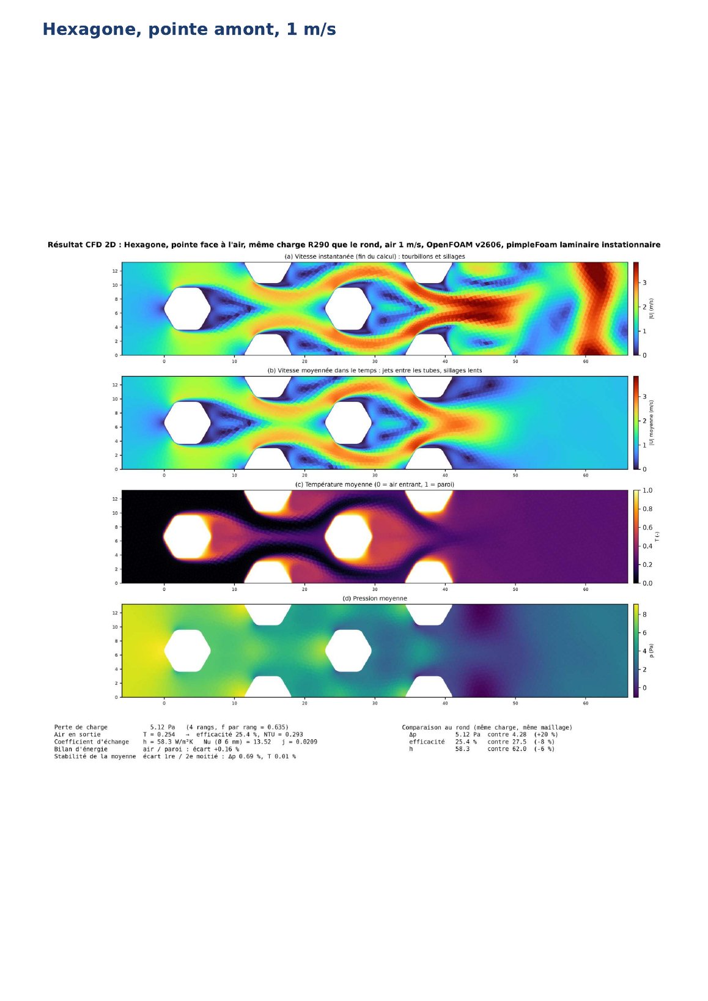
[picture p86: conception_echangeur/docs/rapport_cfd/pages/p-85.jpg]
Hexagone, pointe amont, 1 m/s


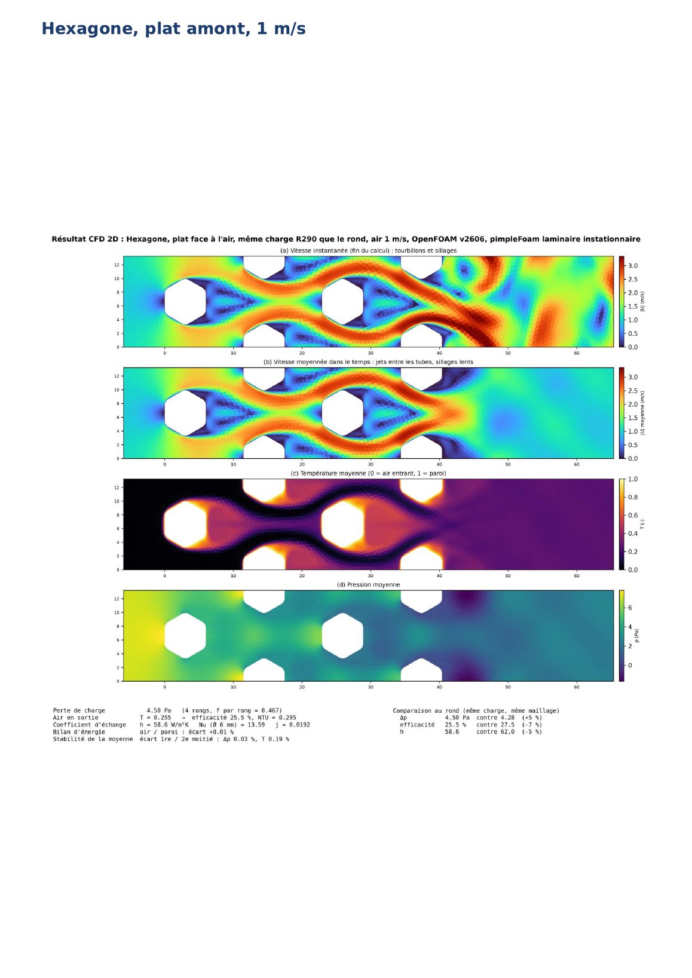
[picture p87: conception_echangeur/docs/rapport_cfd/pages/p-86.jpg]
Hexagone, plat amont, 1 m/s


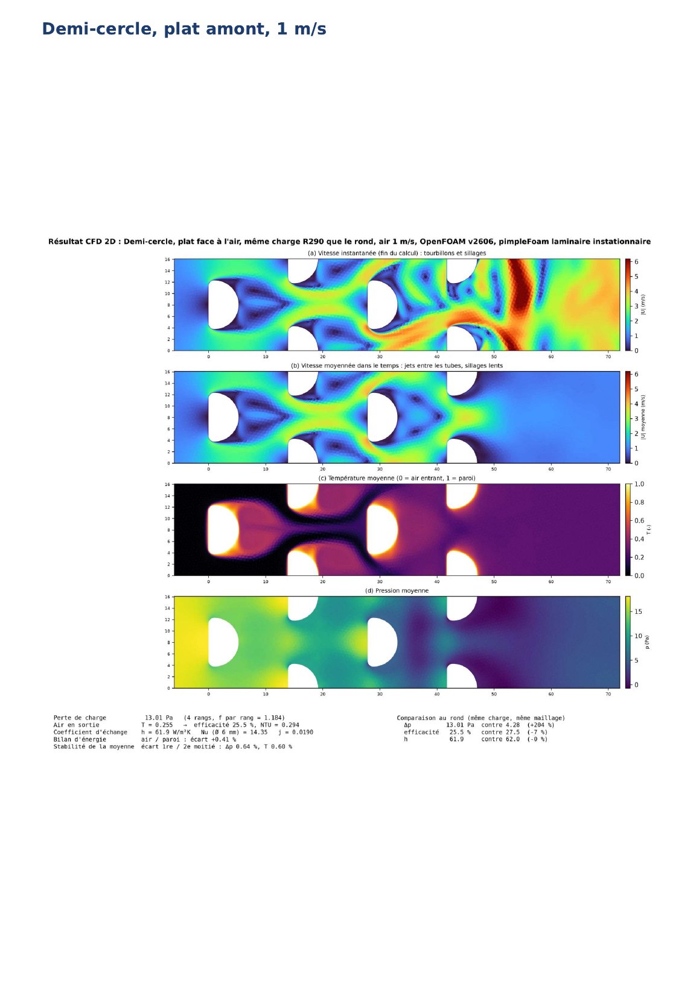
[picture p88: conception_echangeur/docs/rapport_cfd/pages/p-87.jpg]
Demi-cercle, plat amont, 1 m/s


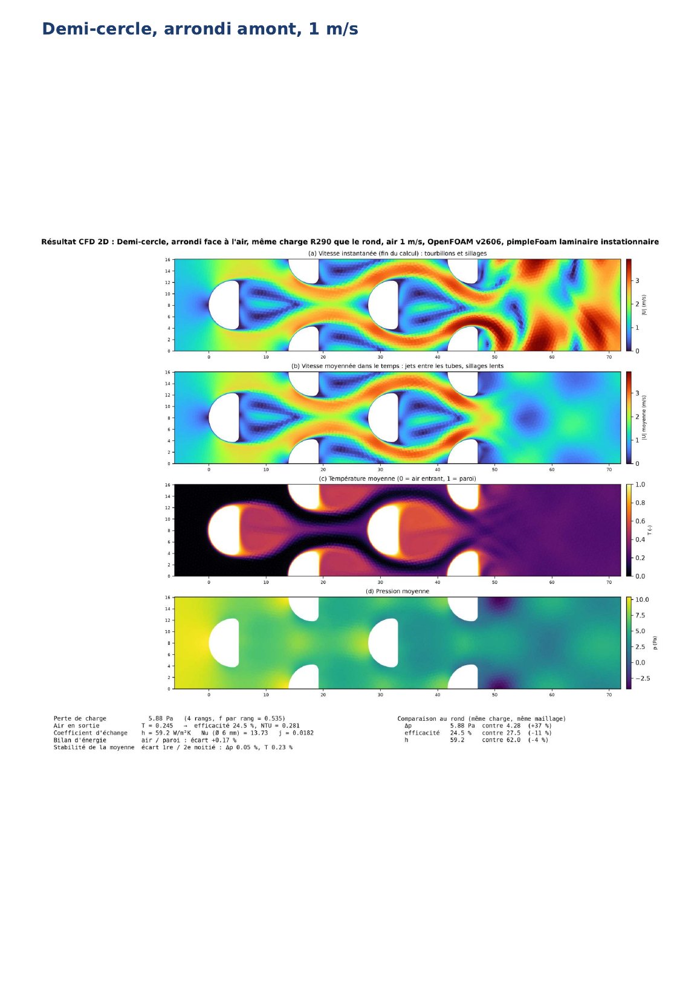
[picture p89: conception_echangeur/docs/rapport_cfd/pages/p-88.jpg]
Demi-cercle, arrondi amont, 1 m/s


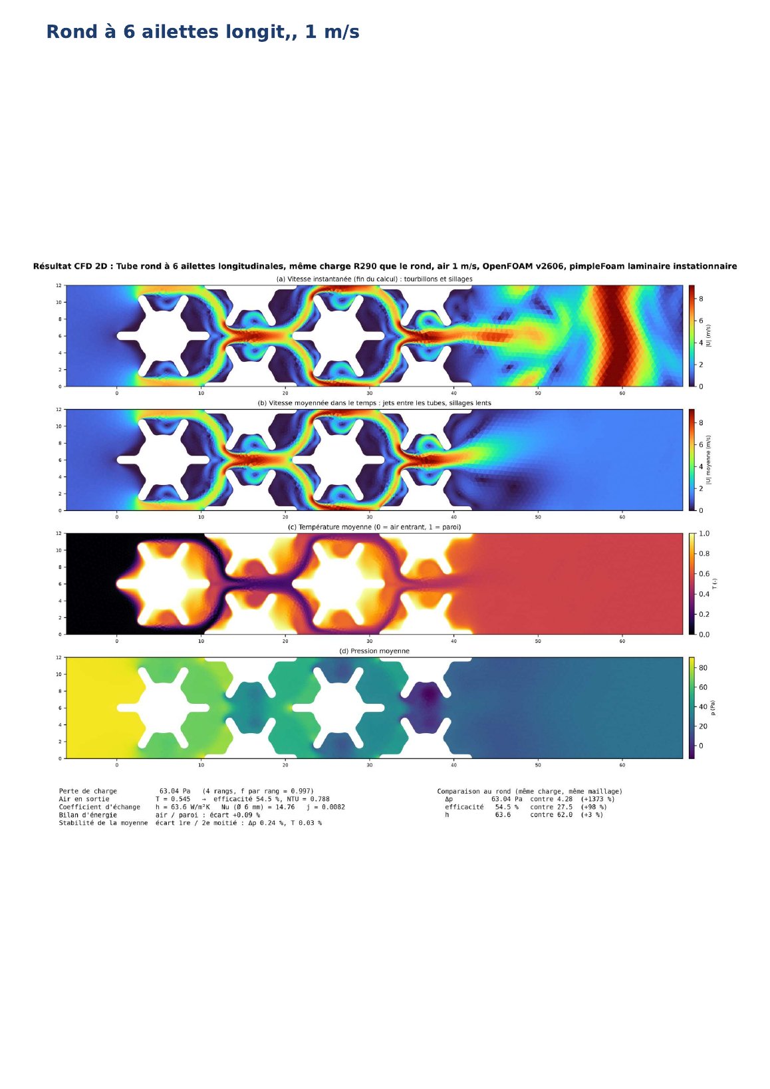
[picture p90: conception_echangeur/docs/rapport_cfd/pages/p-89.jpg]
Rond à 6 ailettes longit,, 1 m/s


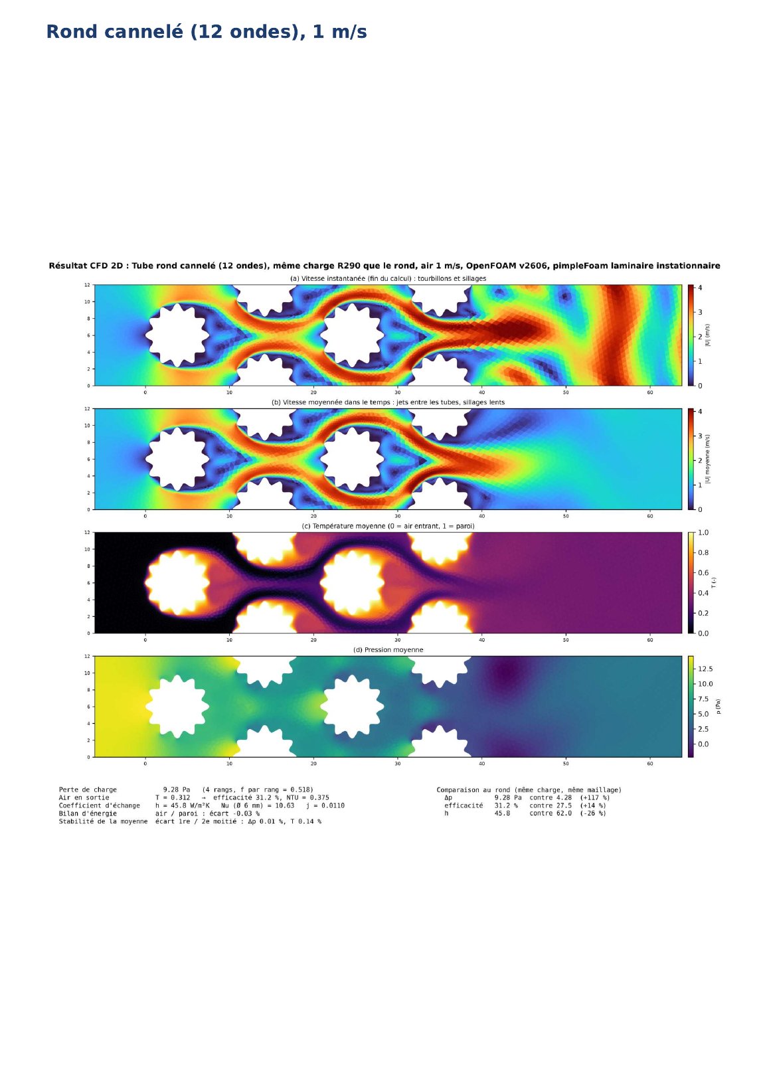
[picture p91: conception_echangeur/docs/rapport_cfd/pages/p-90.jpg]
Rond cannelé (12 ondes), 1 m/s


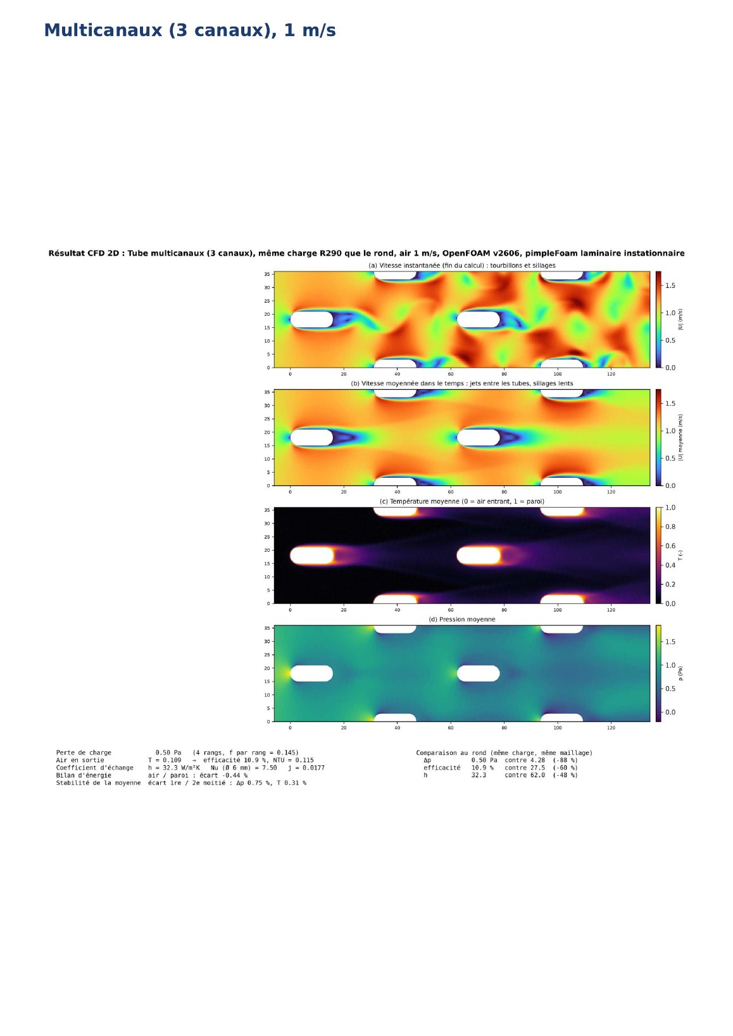
[picture p92: conception_echangeur/docs/rapport_cfd/pages/p-91.jpg]
Multicanaux (3 canaux), 1 m/s


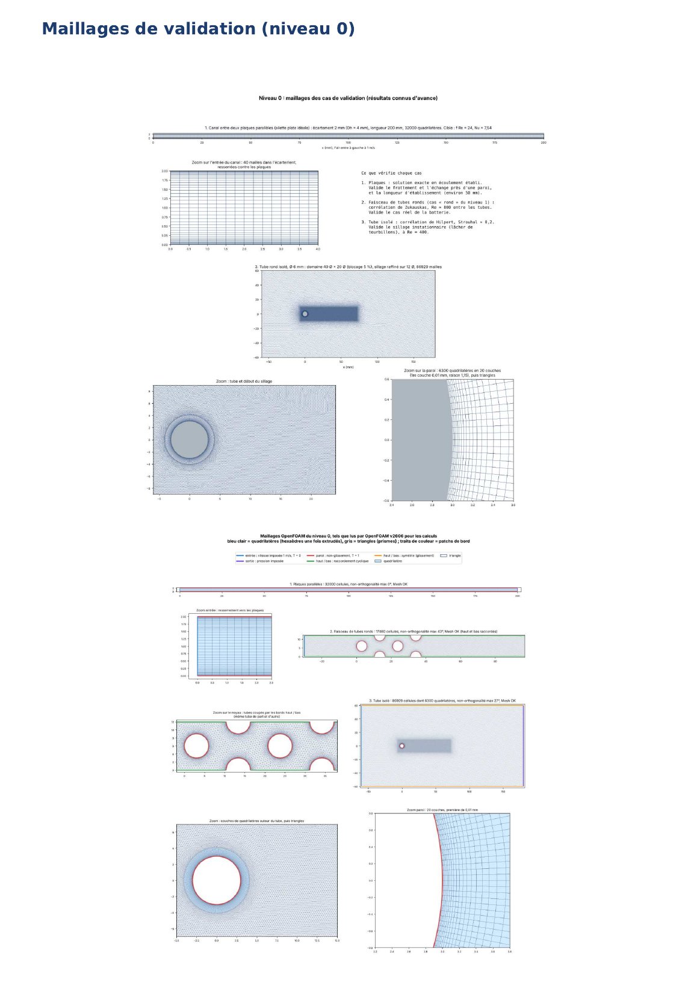
[picture p93: conception_echangeur/docs/rapport_cfd/pages/p-92.jpg]
Maillages de validation (niveau 0)


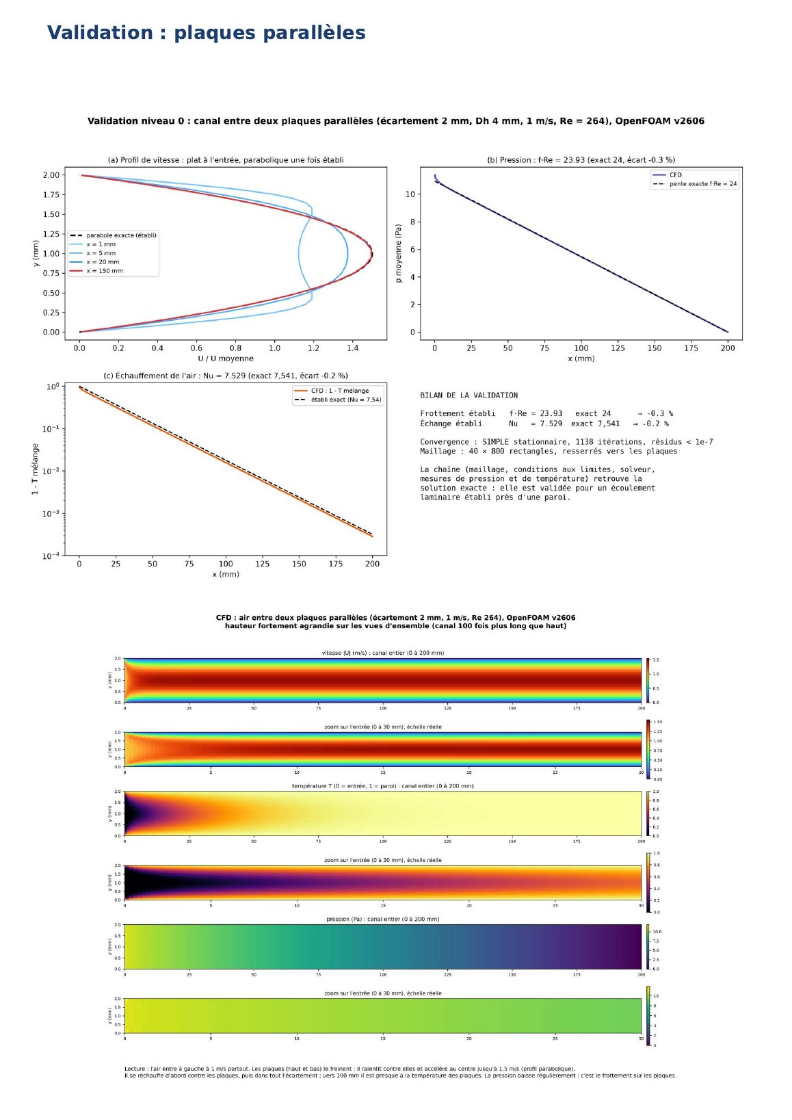
[picture p94: conception_echangeur/docs/rapport_cfd/pages/p-93.jpg]
Validation : plaques parallèles


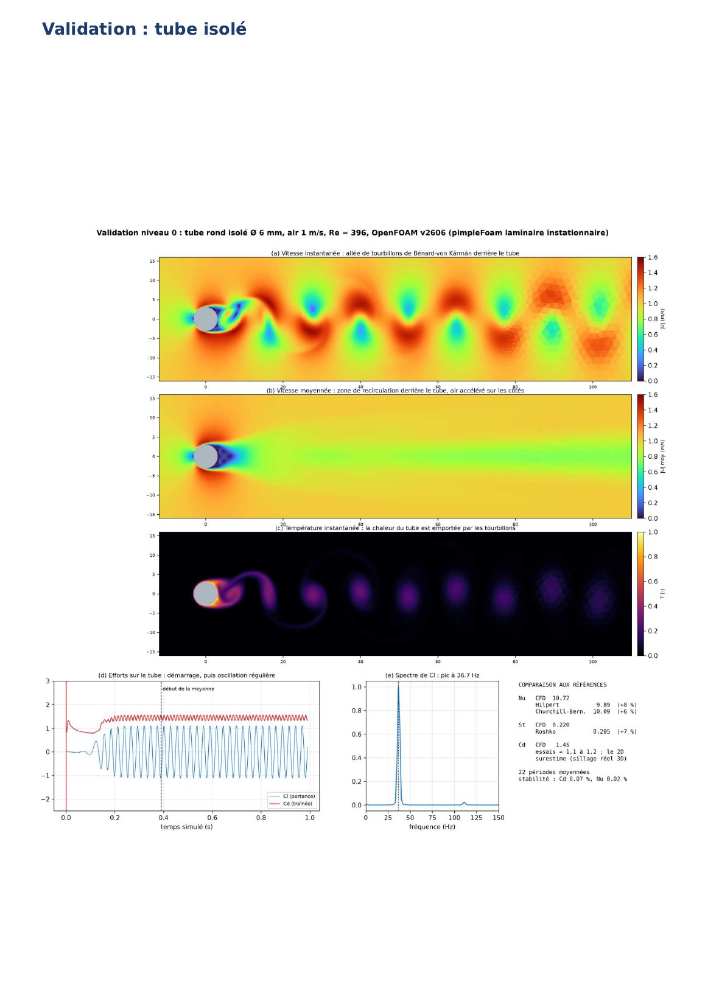
[picture p95: conception_echangeur/docs/rapport_cfd/pages/p-94.jpg]
Validation : tube isolé


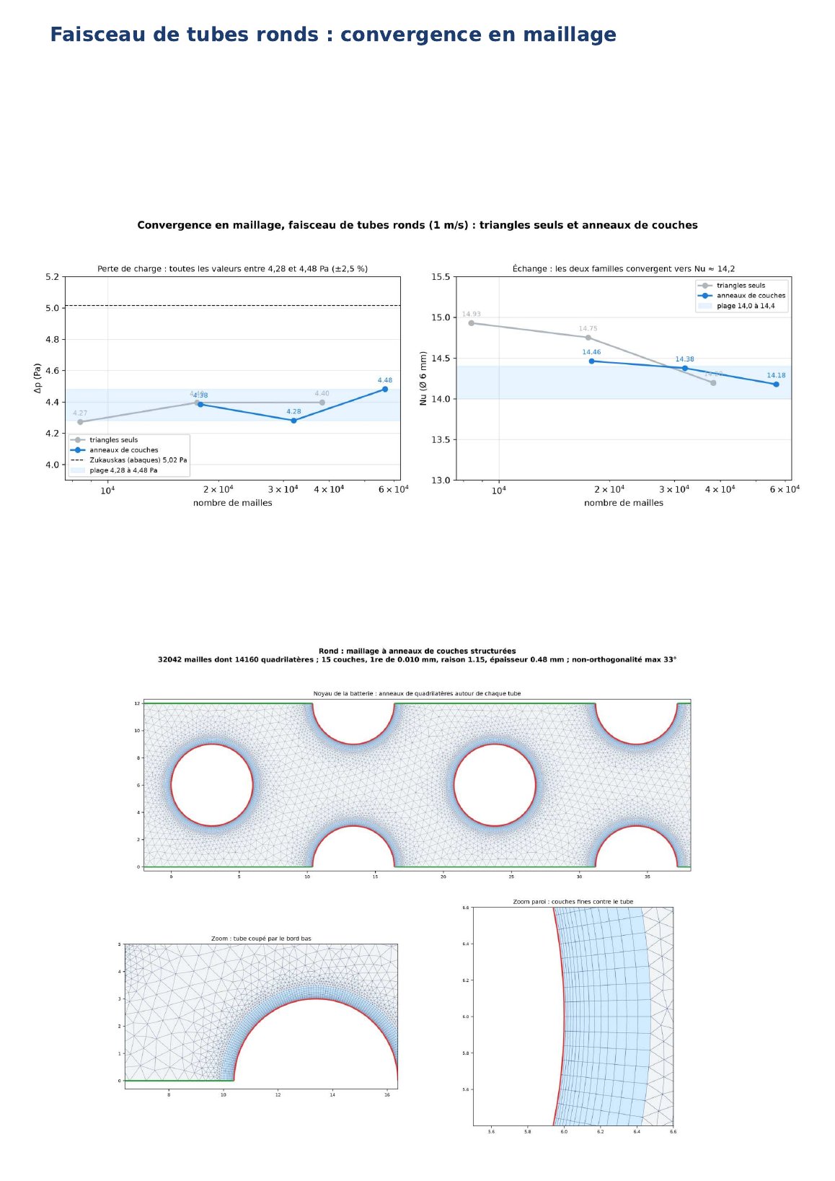
[picture p96: conception_echangeur/docs/rapport_cfd/pages/p-95.jpg]
Faisceau de tubes ronds : convergence en maillage


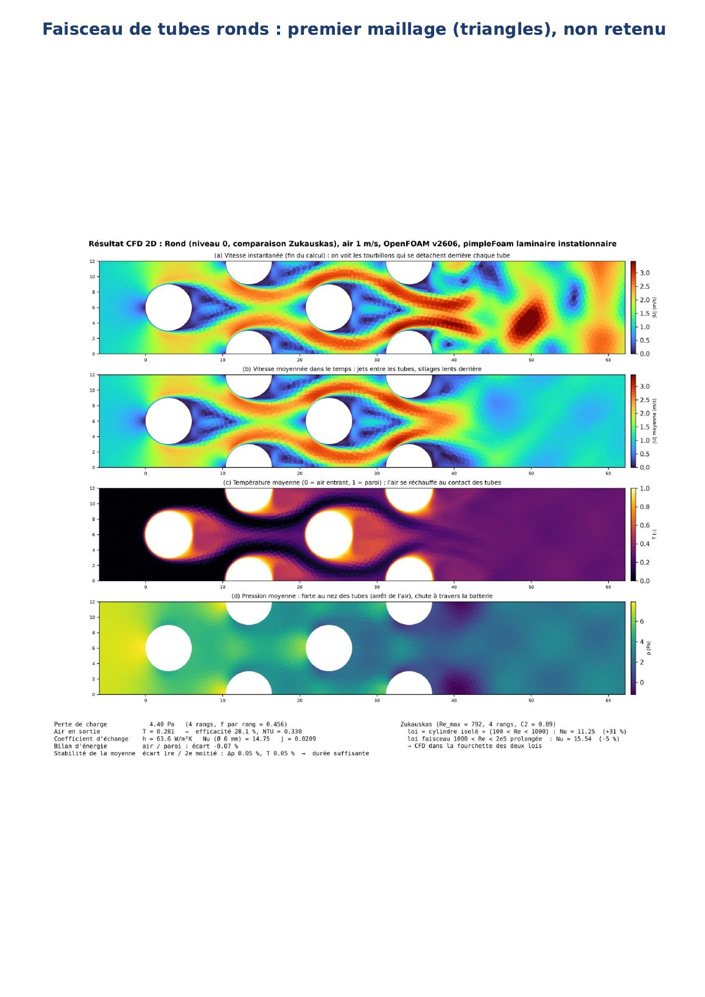
[picture p97: conception_echangeur/docs/rapport_cfd/pages/p-96.jpg]
Faisceau de tubes ronds : premier maillage (triangles), non retenu


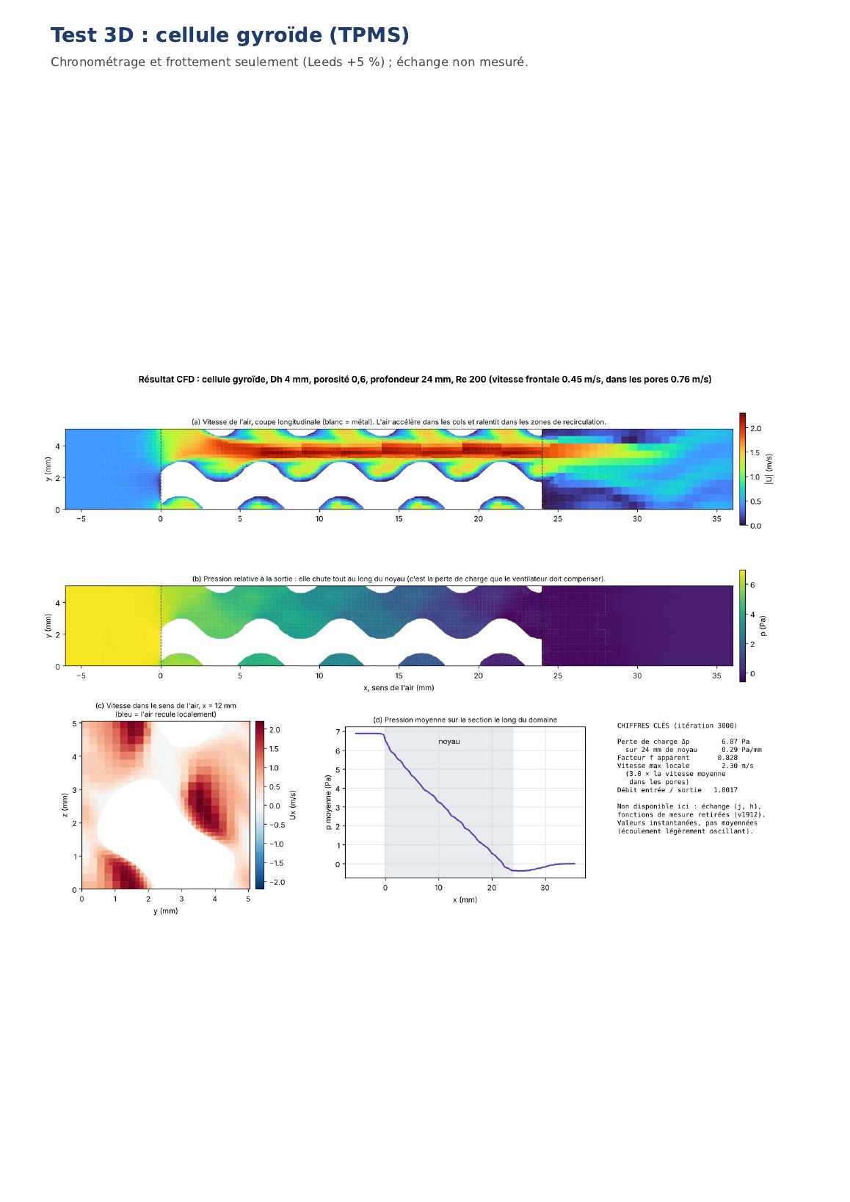
[picture p98: conception_echangeur/docs/rapport_cfd/pages/p-97.jpg]
Test 3D : cellule gyroïde (TPMS)


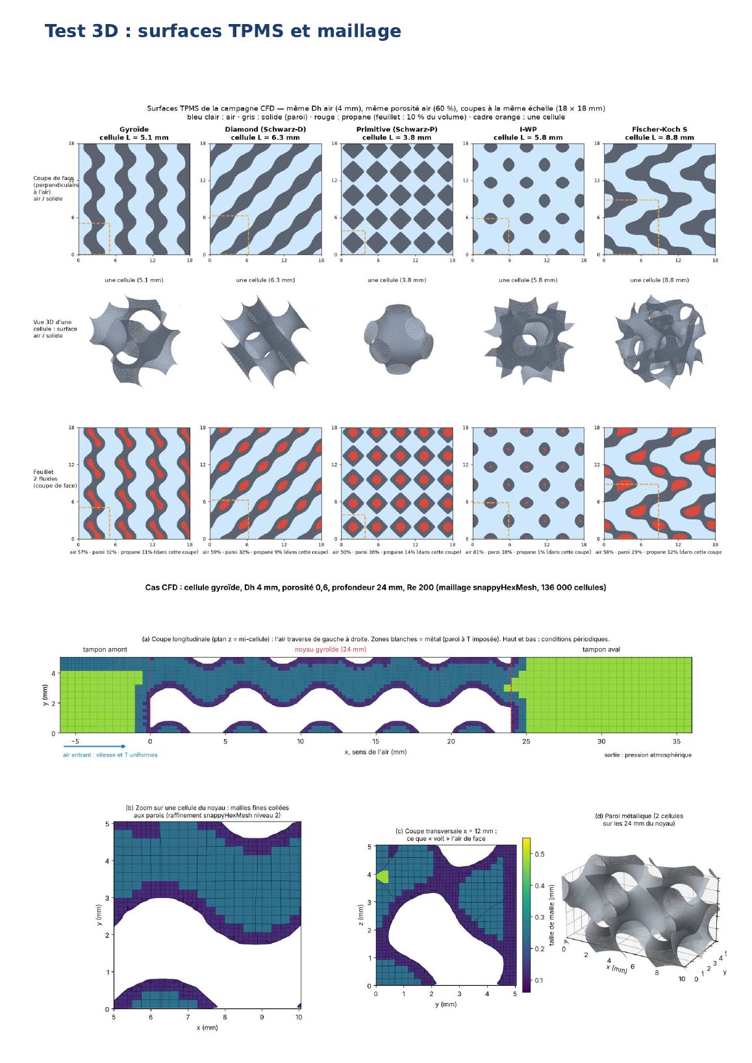
[picture p99: conception_echangeur/docs/rapport_cfd/pages/p-98.jpg]
Test 3D : surfaces TPMS et maillage
