ET-FR/HP_new_generation/conception_echangeur/docs/formes/cylindre_d100_t32/echangeur_d100.html

# Échangeur cylindrique Ø 100 mm

Version du 11/11/2026 · modèle FreeCAD paramétrique (outils/cad/echangeur_d100.py) · enveloppe et circuit du propane, sans ailettes.

Un tube principal de Ø 100 mm contient 32 tubes de propane parallèles à son axe. Le propane entre par un tube 3/8" côté droit. Un arbre de Murray 1 → 32 le répartit, et un arbre identique le regroupe à gauche. L'air entre tangentiellement à gauche, avance en tournant dans l'anneau entre le noyau et la paroi, puis sort à droite : il circule à contre-courant du propane.

## Vue 3D

MarqueurRègle (2 points) Effacer Tours de l'air Vitesse

Repère : x le long de l'axe (0 = début de la zone d'échange, l'air avance vers +x), z vertical, r = distance à l'axe ; cotes en mm. Marqueur : un clic sur une pièce affiche ses coordonnées. Règle : deux clics donnent la distance et ses composantes. Masquer l'enveloppe pour atteindre les tubes.
Animation : trajectoire idéale de l'air (couleur = avancement, de l'entrée à la sortie). Sans ailettes ni aubes, la rotation s'amortit le long du tube : le nombre réel de tours est plus faible que l'idéal (≈ 19,0 tours, si l'hélice gardait l'angle d'entrée de 5,0°). Le curseur montre l'effet.
Clic gauche : tourner dans tous les sens (boutons « Vue » pour revenir à une vue standard) · molette : zoom · clic droit : déplacer. Les maillages sont allégés pour la vue ; le modèle exact est dans echangeur_d100.FCStd et echangeur_d100.step.

## Plans cotés (mm)

Encombrement | mm
Longueur hors tout (tubes 3/8" compris) | 644
Longueur du tube principal (fonds compris) | 386
Zone d'échange | 300
Chambre d'air à chaque bout | 40
Diamètre extérieur | 104
Largeur avec les conduits d'air | 122
Longueur d'un arbre (axe → tubes) | 81

## Arbre de Murray (1 → 32)

Niveau | Branches | Ø int. (mm) | Ø ext. (mm) | Ø parent / Ø enfant | Nature
0 | 1 | 7,90 | 9,53 | — | tube 3/8" (donné)
1 | 2 | 6,27 | 7,27 | 1,260 | branche imprimée
2 | 4 | 4,98 | 5,98 | 1,259 | branche imprimée
3 | 8 | 3,95 | 4,95 | 1,261 | branche imprimée
4 | 16 | 3,14 | 4,14 | 1,258 | branche imprimée
5 | 32 | 2,49 | 3,49 | 1,261 | 32 tubes d’échange

Loi de Murray : Ø parent = 2^(1/3) × Ø enfant ≈ 1,26. Divisions en Y doux : chaque branche part en s'écartant d'environ 30 à 45°, glisse le long de la couronne et arrive dans l'axe du tube. Tous les circuits ont le même chemin. Niveau 1 : de l'axe vers la couronne sur 25 mm ; niveaux 2 à 4 : 12 mm chacun.

## Tubes, anneau d'air et volumes

Tubes et anneau | Valeur
Tubes d'échange (Ø ext. × Ø int.) | 3,49 × 2,49 mm
Longueur d'un tube (fond à fond + gardes) | 402 mm
Rayons des tubes (tournesol, un rayon par tube) | 19 à 46 mm
Écart minimal entre deux tubes | 8,78 mm
Jeu tube / paroi · tube / noyau (minimum) | 2,55 · 2,96 mm
Section de passage de l'air (anneau − tubes) | 68,4 cm²
Surface extérieure des tubes dans la zone d'échange | 0,1053 m²
Conduits d'air tangentiels (radial × axial) | 20 × 30 mm
Inclinaison des conduits vers l'aval (axe) | 5,0°

Volume intérieur côté propane | cm³ | g si plein de liquide
Arbre d'entrée (avec 40 mm de 3/8") | 13,25 | 6,2
32 tubes | 62,64 | 29,4
Arbre de sortie (avec 40 mm de 3/8") | 13,29 | 6,2
Total | 89,18 | 41,9

Masse : borne haute avec ≈ 0,47 g/cm³ (propane liquide vers 45 °C, ordre de grandeur). En fonctionnement, une grande partie du volume contient de la vapeur : la charge réelle est plus faible.

## Données et hypothèses

Données : tube principal Ø 100 mm ; entrée et sortie du propane en tube 3/8" (Ø 9,53 × 7,90 mm) ; arbre de Murray 1 → 32 avec les Ø intérieurs 7,90, 6,27, 4,98, 3,95, 3,14, 2,49 mm.

Hypothèses que j'ai prises par défaut (toutes réglables dans outils/cad/parametres_d100.json) :

- 100 mm = diamètre intérieur ; paroi de 2 mm, fonds de 3 mm.
- Zone d'échange de 300 mm ; chambre d'air de 40 mm à chaque bout pour les conduits.
- Noyau central plein de Ø 30 mm ; niveaux 1 à 4 sur une couronne de R 32,5 mm, puis dernier niveau en tournesol : tube i au rayon √(r₁² + (i + ½)(r₂² − r₁²)/32) et à l’angle i × 137,5°, motif tourné de 164° et tubes attribués deux à deux aux nœuds de la couronne pour raccourcir les branches (affectation optimale). Branches du dernier niveau de 20 mm selon l’axe ; leurs longueurs diffèrent de quelques mm, ≈ 1 % d’un circuit.
- Paroi des branches imprimées et des 32 tubes : 0,5 mm.
- Axe horizontal ; les arbres sont à l'extérieur des fonds, que les tubes traversent.
- Conduits d'air rectangulaires 20 × 30 mm, tangents à la paroi et inclinés de 5,0° vers l'aval : l'air entre déjà en hélice. Angle par défaut tel que tan α = section du conduit / section de l'anneau (rapport des vitesses axiale et tangentielle à débit égal) ; réglable par angle_conduit_deg.

## Points ouverts

- Surface d'échange : les tubes nus offrent 0,105 m². Les ailettes restent à dessiner (longitudinales ou en hélice).
- Débit d'air : la section de 68 cm² laisse passer ≈ 49 m³/h à 2 m/s. Un module transporte donc quelques centaines de watts : il en faudrait plusieurs pour une PAC de fenêtre.
- Orientation : avec l'axe horizontal, l'eau de condensation stagne en bas du tube principal. À trancher : axe vertical ou point de purge.
- Fabrication : passage étanche des tubes à travers les fonds, ou impression en une seule pièce.

## Rendus

Ensemble

Ensemble, enveloppe transparente

Arbre d'entrée

Arbre de Murray d'entrée (1 → 32)

Vue de bout

Vue de bout côté entrée
