ET-FR/HP_new_generation/compresseurs/sources/chine_taiwan/SOURCES.md

# Sources — compresseurs rotatifs R290 chinois / taïwanais

Date d'accès de toutes les sources : 2026-11-11.
Fichiers téléchargés tels quels (non exécutés). Les catalogues Rechi 2026 sont des PDF images (pas de texte extractible) : lire les pages à l'écran.

| # | Titre | URL | Fichier local | Ce que la source étaye |
|---|---|---|---|---|
| 1 | GMCC — fiche technique EDTN210D32EFZ (« Hermetic DC inverter compressor specification », bilingue) — copie hébergée sur le forum akkudoktor.net | https://akkudoktor.net/uploads/short-url/td8QM6XccsT73eRC9jk7BlpOhMP.pdf | GMCC_EDTN210D32EFZ_R290_21cc_akkudoktor.pdf | Seule fiche complète trouvée : 21,0 cm³, 12–120 rps, 4415 W chauffage / 900 W (entrée variateur) / COP 4,90 à 60 rps, Te 2,7 / Tc 42,3 ; huile 300 ml PAG XS-601C1 ; 8,45 kg ; moteur BLDC 6 pôles ; bruit 67+4 dB(A) puissance acoustique max ; limites Te −35…+25 °C, Tc max 83 °C, rapport de pression ≤ 17, refoulement ≤ 115 °C ; charge max 1000 g ; inclinaison ≤ 5° |
| 2 | GMCC — Rotary Compressor Product Catalog 2024 (copie distributeur) | https://www.hvacrcompressor.com/downloadpdf/GMCC-rotary-compressor-catalogue.pdf | GMCC_catalogue_rotatif_2024_hvacrcompressor.pdf | Tableau R290 (p. 07-08) : modèles DC inverter DSM165D19UDZ, DSM180D19UDZ, DSN180D54UEZ3, DSN210D54UEZ3, DTN180/210/250… et R290 vitesse fixe ; hauteurs ; diamètres de tubes ; définition des conditions d'essai (p. 34 : SEER60 = Tc 42,3 / Tliq 34,3 / Te 2,7 / Tasp 12,8 / amb. 35 °C, 60 rps, puissance variateur incluse ; ASH = 54,4/46,1/7,2/35 ; GX = 46/41/10/18) |
| 3 | Même catalogue GMCC 2024, autre copie (identique, non conservée) | https://refricompressor.com/wp-content/uploads/2024/09/GMCC-Rotary-Compressor-Catalog.pdf | — (doublon supprimé) | Confirme le contenu du n° 2 |
| 4 | GMCC & Welling — brochure « Heat pump » 2024 (salon, hébergée par NürnbergMesse) | https://images.nuernbergmesse.de/files/6fbf8406-3844-f991-6fb0-8720e3179dbe.pdf | GMCC_Welling_brochure_pompes_a_chaleur_2024_nuernbergmesse.pdf | Gamme R290 pompe à chaleur au point SEER60 (Te 2,8 / Tc 42,3 / SH 10 K / SC 8 K / 60 rps) : RDSK53D08TAR3 (5,3 cm³), RDSK75D35TBZ3 (7,5), RDSK89D35TBZ3 (8,9), RDTN150D21TEZ31 et RDTN150D54TEZ3 (14,9, bicylindre), EDTN150/180/210… ; R290 vitesse fixe pour chauffe-eau |
| 5 | AREA Cooling Solutions (distributeur GMCC, Espagne) — brochure gamme GMCC R290, ISH 2025 (Messe Frankfurt) | https://exhibitorsearch.messefrankfurt.com/images/original/document_downloads/10000006202501/418603/1741874234911_75076646.pdf | AREA_Cooling_brochure_gamme_GMCC_R290_ISH2025.pdf | Plages de vitesse 12–120 rps des RDSK/EDTN, enveloppes graphiques, chiffres « @90 rps » (Te 2,7 / Tc 42,3) ; mention d'un logiciel de calcul GMCC/AREA. ATTENTION : les COP @90 rps donnent un rendement incohérent (≈ 0,37), chiffres à faire confirmer |
| 6 | PR Newswire — « GMCC & Welling Showcase R290 Series at ISH 2025 Germany » | https://www.prnewswire.com/news-releases/gmcc--welling-showcase-r290-series-at-ish-2025-germany-302407667.html | GMCC_Welling_ISH2025_R290_prnewswire.html | Communiqué marketing : rotatif bicylindre R290 inverter pour PAC, scroll R290 135 cc ; aucun chiffre de rendement |
| 7 | Area Cooling — catégorie « Compressors hermetic rotary R290 Inverter » | https://areacooling.com/compressors-hermetic-rotary/compressors-hermetic-rotary-r290-inverter/ | — | Distribution européenne de GMCC R290 (EDTN150D32EEZ, EDTN180D32EFZ, RDSK…) : voie d'achat d'échantillons en Europe |
| 8 | Made-in-China — Qishanr, GMCC EDTN210D32EFZ | https://qishanr.en.made-in-china.com/product/uaDUlXGWaxcO/China-R290-Gmcc-Hermetic-DC-Inverter-Rotary-Compressor-Edtn210d32efz-for-Heat-Pump.html | — | Prix revendeur : 148,50 USD (10–29 pcs), 128,50 (30–49), 108,50 (50+), MOQ 1 pc |
| 9 | Highly (Shanghai Highly / Hitachi-Highly) — Rotary Compressor Catalog (PDF créé nov. 2021, copie HUBHVACR) | https://hubhvacr.com/wp-content/uploads/2023/06/Highly-Rotary-Compressor-Catalog-PDF.pdf | Highly_catalogue_rotatif_hubhvacr_2023.pdf | R290 DC inverter : PSD140RKQ-6B (14,0 cm³, 2810 W, COP 4,75, « New GB »), PTD175RKQ-6B (17,5, 3650 W, 4,93), PTL232SDN, PTL253UDP (ASHRAE/T) ; R290 DC inverter sèche-linge (HPD) : PSA586SD 5,86, PSD071UK 7,1, PSD0088RK 8,8 cm³ ; Hitachi-Highly WHP03600PRK (15 cm³, PAC). Conditions « New GB » et « HPD » NON définies dans le catalogue |
| 10 | Highly — page fournisseur HUBHVACR | https://hubhvacr.com/highly-compressor-china/ | — | Plages annoncées (14–25,3 cc R290 inverter AC ; 5,86–47 cc PAC) — distributeur, non officiel |
| 11 | Jointway — HIGHLY Rotary Compressor | https://www.jointway.cc/highly-rotary/?v=2789ae578844 | — | Distributeur Highly : « R290 full range 1.0 cc à 84.8 cc inverter » (affirmation commerciale) |
| 12 | Shanghai Highly — site officiel (EN) | https://en.highly.cc | — | Contact fabricant ; pas de fiche R290 téléchargeable trouvée |
| 13 | Zhuhai Landa (Gree) — catalogue 2023 « 家用、商用空调压缩机 » | http://www.landa.com.cn/uploads/file/20230627/8f921d6b1ec4d888e9ff3a2bd7180895.pdf | Landa_catalogue_2023_climatisation_domestique_commercial.pdf | « Household frequency conversion – R290 », 15–120 Hz : QXD-G088zD170 (8,8 cm³, 1620 W, 395 W, COP 4,1, h 277 mm), QXDS-N150zX170 (15 cm³, 3050 W, 701 W, 4,35, h 275), QXDS-M180zX170 (18), DTz-SM240AXBA (24) — condition « 新国标 » |
| 14 | Zhuhai Landa — catalogue 2023 « 新兴市场用压缩机 » | http://www.landa.com.cn/uploads/file/20230627/a4d24b9be16bb7b1524e022f8cba9672.pdf | Landa_catalogue_2023_marches_emergents.pdf | Définition des conditions « 新国标 » (60 Hz : Tc 46 / Te 7,2 / SC 8,3 K / Tasp 18,3 / amb. 35 ; aussi 20, 40, 80, 100 Hz) ; R290 PAC/chauffe-eau gros débits |
| 15 | Rechi — catalogue 2026 « 空调、除湿应用 » (PDF image) | https://www.rechi.com/folder/2026%E5%B9%B4%E7%A9%BA%E8%AA%BF%E9%99%A4%E6%BA%BC%E5%9E%8B%E9%8C%84.pdf | Rechi_catalogue_2026_climatisation_deshumidification.pdf | p. 13 : R290 DC inverter clim : QM140SJ70(*), 39P22LA (14,0 cm³), QP180SJ70, QP210SJ70 ; bicylindre QP184TJ71(*), QP200TJ72(*), QP220TJ71(*), QZ310TJ70(*), QN420TJ70(*) ; puissance avec et sans variateur ; p. 30 : conditions ASHRAE/T, NGB (46/7,2/37,7/18,3), TBA, CHEER, HPD (70/25/61/35), HPWH, NDOE ; p. 07 : codification (série 39 = moteur Ø 101, 36 = Ø 91,5 bicyl.) |
| 16 | Rechi — catalogue 2026 « 热泵及其他应用 » (PDF image) | https://www.rechi.com/folder/2026%E5%B9%B4%E7%89%B9%E6%AE%8A%E6%87%89%E7%94%A8%E5%9E%8B%E9%8C%84.pdf | Rechi_catalogue_2026_applications_speciales.pdf | p. 12 : R290 DC inverter sèche-linge : 39Q1ALK, 39Q1AQH (6,5 cm³), 39Q11QH (7,25), 39Q12MX (8,1), QS050/068/075SJ70-D01(*), bicyl. 36Q1BM2 et QS075TJ70(*) (7,5) — valeurs ASHRAE/T et HPD ; p. 19 : mini-compresseurs (49 dB(A), 0,86 kg — R134a/R290 3,25 cm³, hors sujet) |
| 17 | Rechi — page produits rotatifs (EN) | https://www.rechi.com/eng/Product/product | Rechi_page_produits_rotatifs_EN.html | Codes réfrigérant/application (R290 = P en clim ASHRAE/T, Q en sèche-linge HPD, U en chauffe-eau) ; recherche de modèles / demande de spécification en ligne |
| 18 | Rechi — page e-catalogue (TW) | https://www.rechi.com/Product/product_catalog et https://www.rechi.com/eng/Product/catalog | Rechi_page_catalogue.html | Liens vers les PDF 2026 |
| 19 | Alibaba — « R290 1.5 hp 12000btu Rechi rotary compressor » | https://www.alibaba.com/product-detail/R290-1-5-hp-12000btu-rechi_1600885300508.html | — | Existence d'offres revendeur Rechi R290 (page non lisible par l'outil, prix non relevé) |
| 20 | UNEP OzonAction — « Demonstrating feasibility of R-290 based AC manufacturing: China's Midea and Meizhi » | https://www.unep.org/ozonaction/resources/factsheet/demonstrating-feasibility-r-290-based-ac-manufacturing-chinas-midea-and-meizhi | — | Meizhi = GMCC (Guangdong Meizhi Compressor) : ligne R290 rotatifs 1 hp / 1,5 hp |
| 21 | ORNL — « Development of high efficiency window air conditioner using propane under limited charge » | https://www.ornl.gov/publication/development-high-efficiency-window-air-conditioner-using-propane-under-limited-charge | — | Contexte : climatiseur de fenêtre R290 12 kBtu/h, EER 14,0, compresseur rotatif propane d'un partenaire CRADA non nommé |
| 22 | GMCC — fiche fournisseur HUBHVACR | https://hubhvacr.com/gmcc-compressor/ | — | Revendeur chinois GMCC (voie échantillons) |

## Recherches sans résultat exploitable
- Huangshi Dongbei (Donper) : pas de rotatif R290 trouvé (gamme alternative / frigo).
- Kulthorn : pas de rotatif R290 trouvé (alternatifs).
- Aucun coefficient EN 12900 / AHRI 540 publié pour ces modèles trouvé en accès libre.
- Aucun rendement isentropique publié par ces fabricants : les valeurs du rapport sont recalculées (CoolProp 8.0, propane) à partir des points catalogue.
