ET-FR/HP_new_generation/conception_echangeur/docs/figures/branchie_imprimee.png

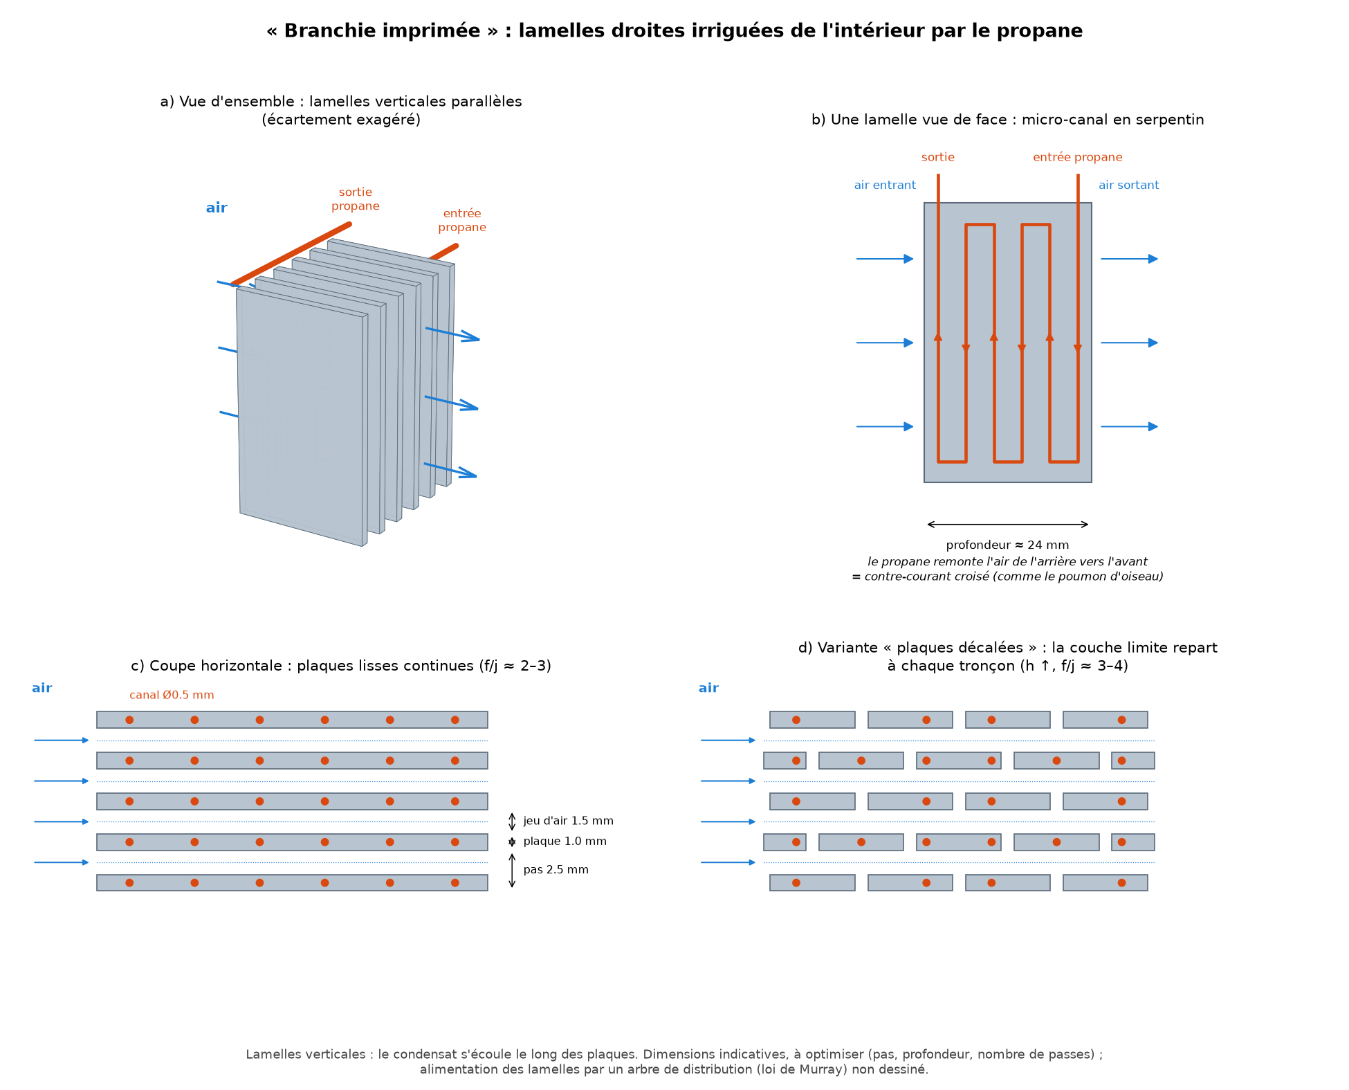
conception_echangeur/docs/figures/branchie_imprimee.png
