ET-FR/HP_new_generation/conception_echangeur/docs/figures/cornets_renne_ct.jpg

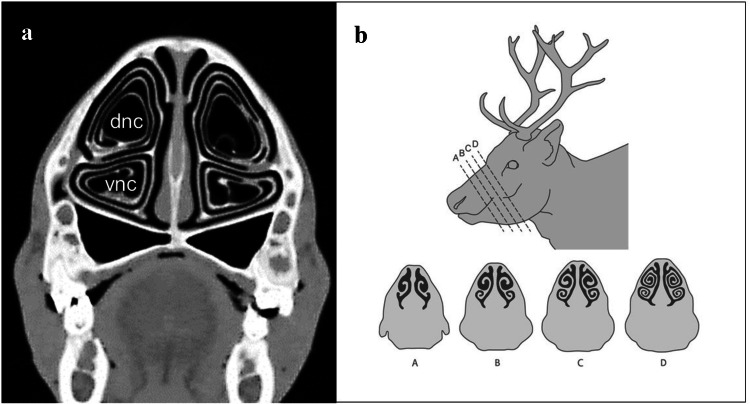
conception_echangeur/docs/figures/cornets_renne_ct.jpg
