ET-FR/HP_new_generation/conception_echangeur/docs/figures/loi_murray.png

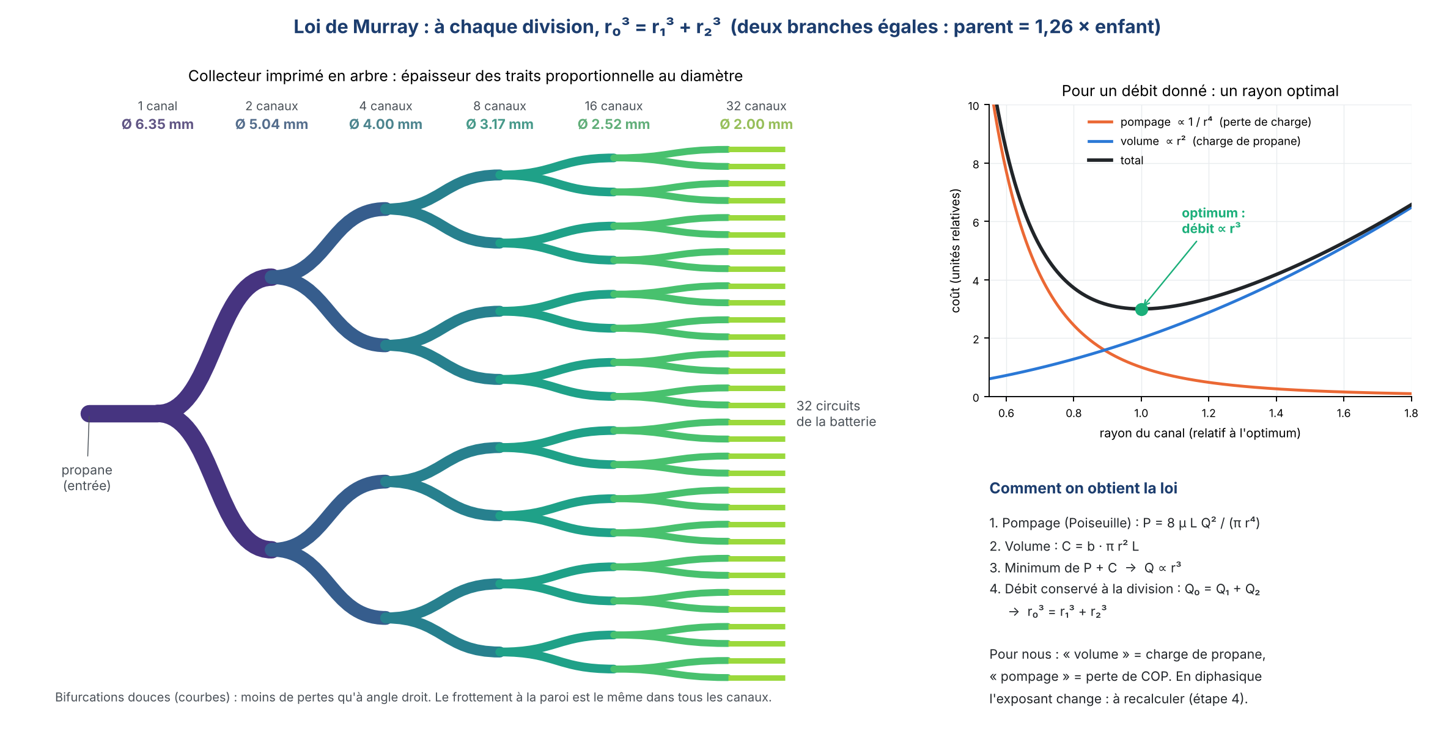
conception_echangeur/docs/figures/loi_murray.png
