ET-FR/HP_new_generation/conception_echangeur/docs/formes/cylindre_d100/vue_ensemble.png

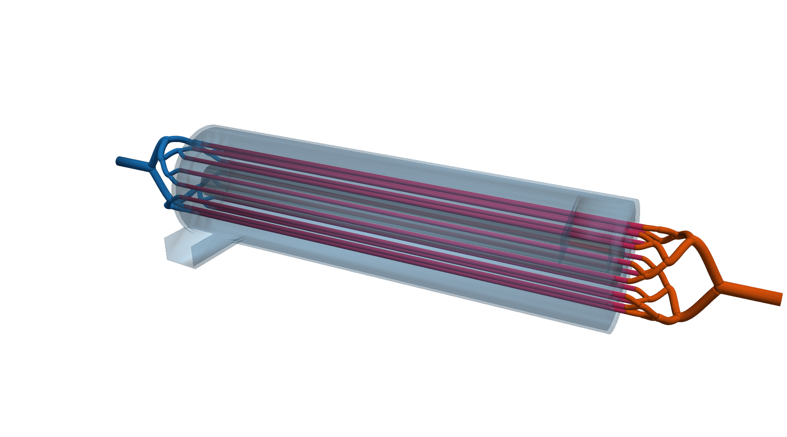
conception_echangeur/docs/formes/cylindre_d100/vue_ensemble.png
