ET-FR/HP_new_generation/conception_echangeur/docs/formes/cylindre_d150_helice/vue_coupe.png

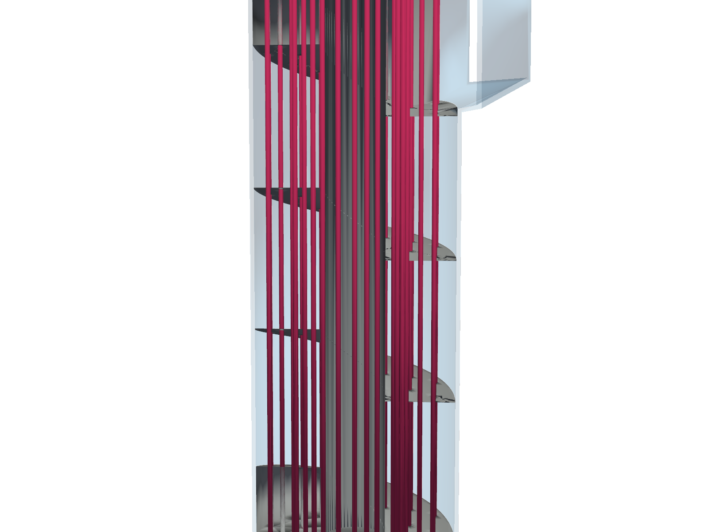
conception_echangeur/docs/formes/cylindre_d150_helice/vue_coupe.png
