ET-FR/HP_new_generation/conception_echangeur/docs/formes/cylindre_radial/variante_e/vue_ensemble.png

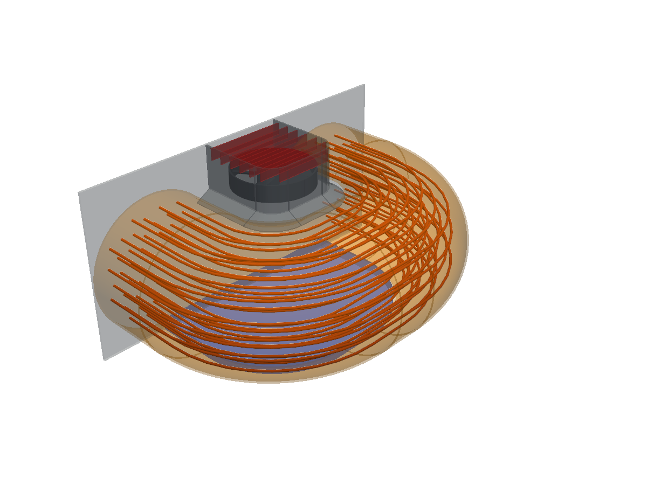
conception_echangeur/docs/formes/cylindre_radial/variante_e/vue_ensemble.png
