ET-FR/HP_new_generation/conception_echangeur/docs/formes/cylindre_radial/variante_f/imprime/cfd/graphe_secteur_dp_hA.png

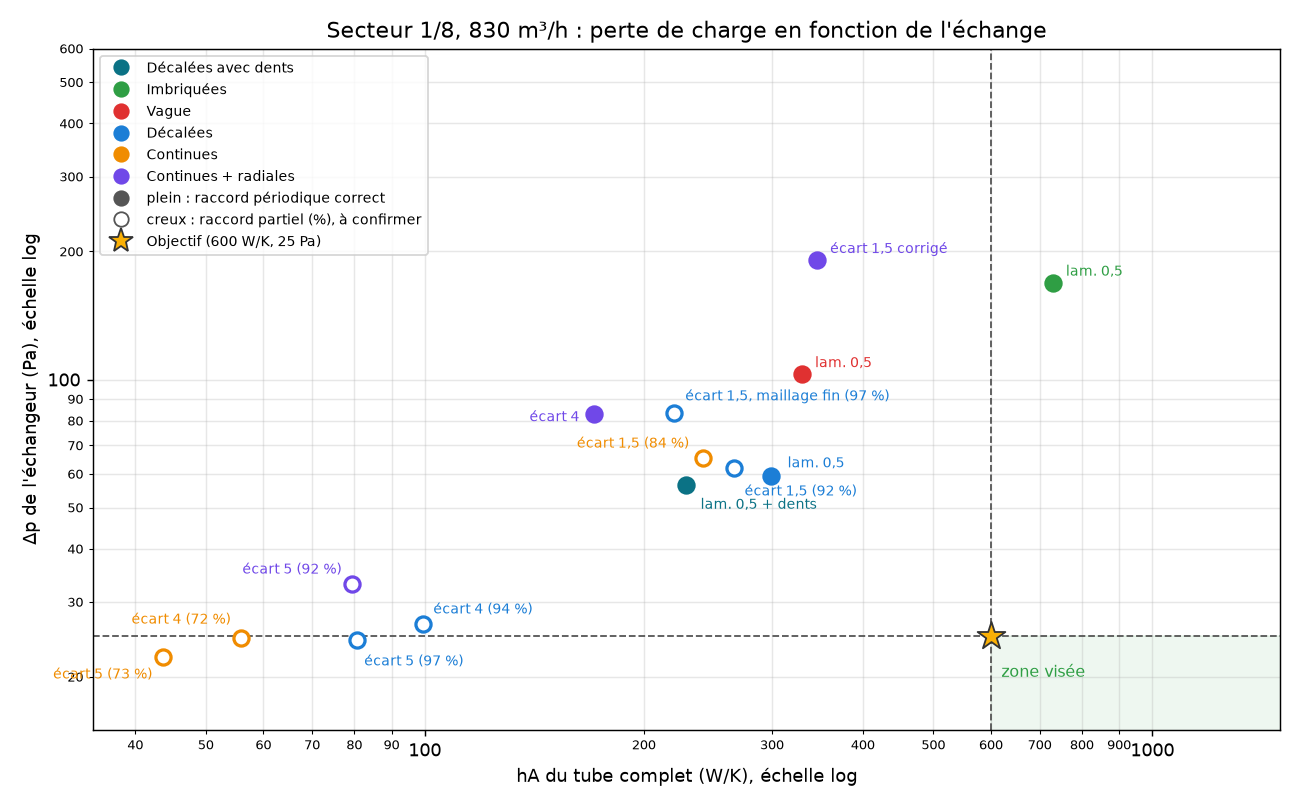
conception_echangeur/docs/formes/cylindre_radial/variante_f/imprime/cfd/graphe_secteur_dp_hA.png
