ET-FR/HP_new_generation/conception_echangeur/docs/formes/cylindre_radial/variante_f/imprime/cfd/maillage_avec_interstice.png

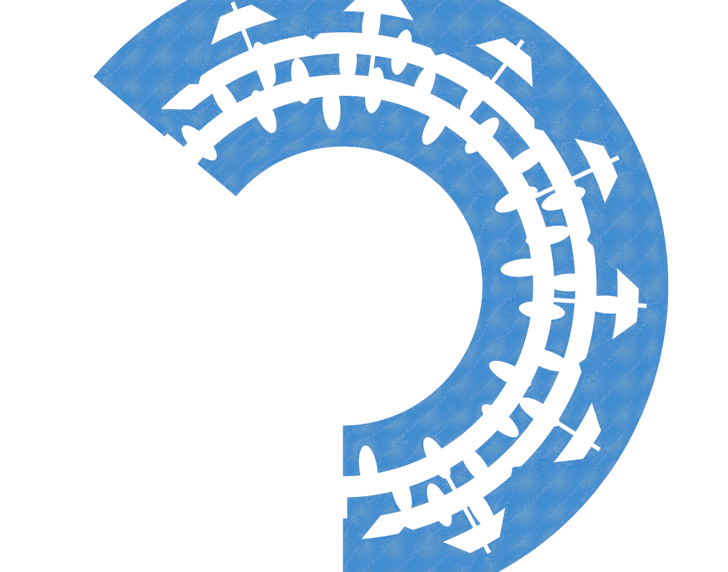
conception_echangeur/docs/formes/cylindre_radial/variante_f/imprime/cfd/maillage_avec_interstice.png
