ET-FR/HP_new_generation/conception_echangeur/docs/formes/cylindre_radial/variante_f/imprime/cfd/maillage_sans_radial.png

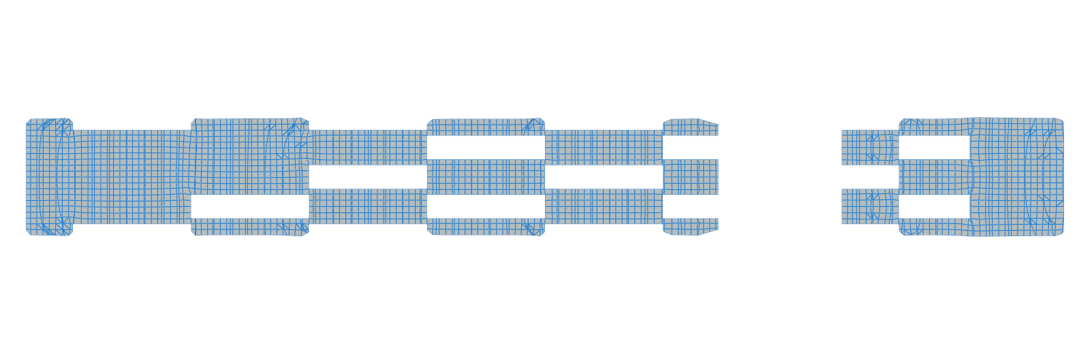
conception_echangeur/docs/formes/cylindre_radial/variante_f/imprime/cfd/maillage_sans_radial.png
