ET-FR/HP_new_generation/conception_echangeur/docs/formes/cylindre_radial/variante_f/imprime/imp_avec_bout.png

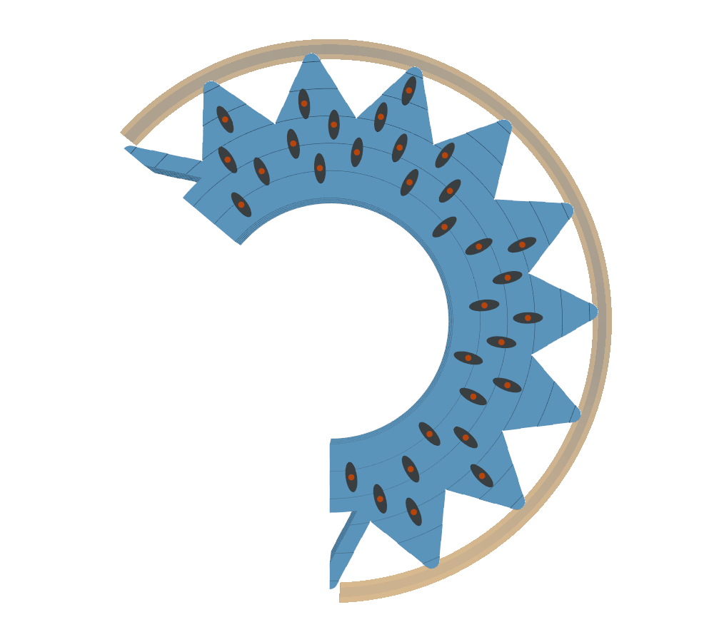
conception_echangeur/docs/formes/cylindre_radial/variante_f/imprime/imp_avec_bout.png
