ET-FR/HP_new_generation/conception_echangeur/docs/formes/cylindre_radial/variante_f/plis_coupe.png

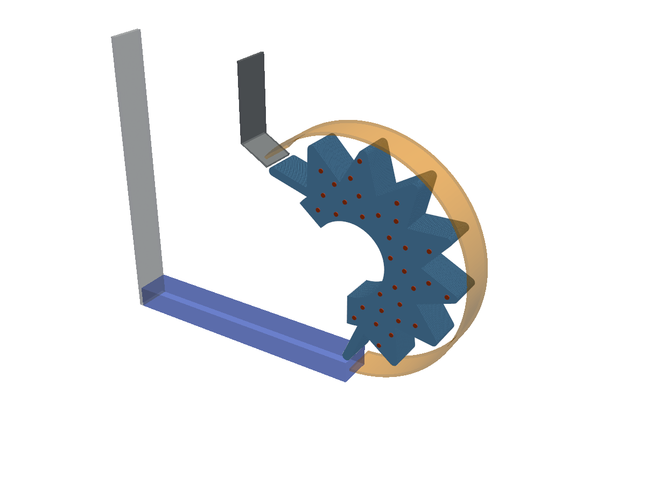
conception_echangeur/docs/formes/cylindre_radial/variante_f/plis_coupe.png
