ET-FR/HP_new_generation/conception_echangeur/docs/formes/helice/vue_ailette.png

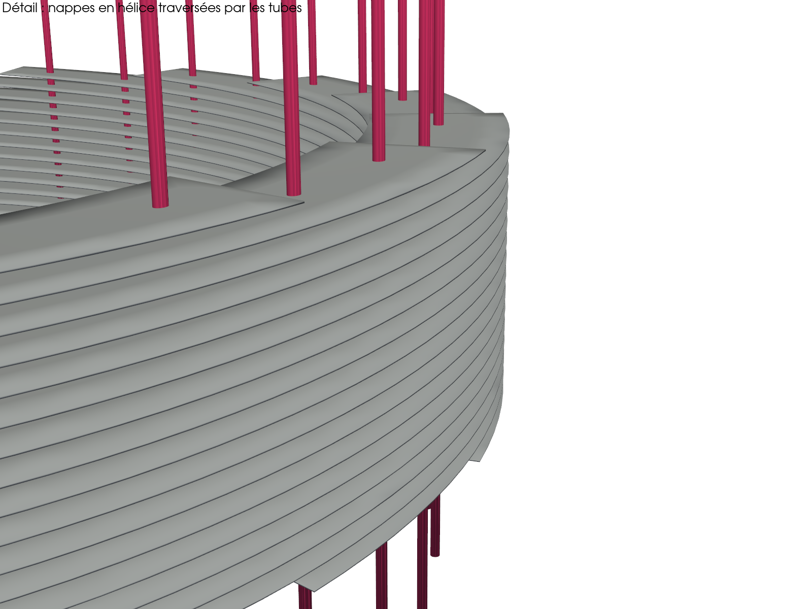
conception_echangeur/docs/formes/helice/vue_ailette.png
