ET-FR/HP_new_generation/conception_echangeur/docs/formes/plaques/champs.png

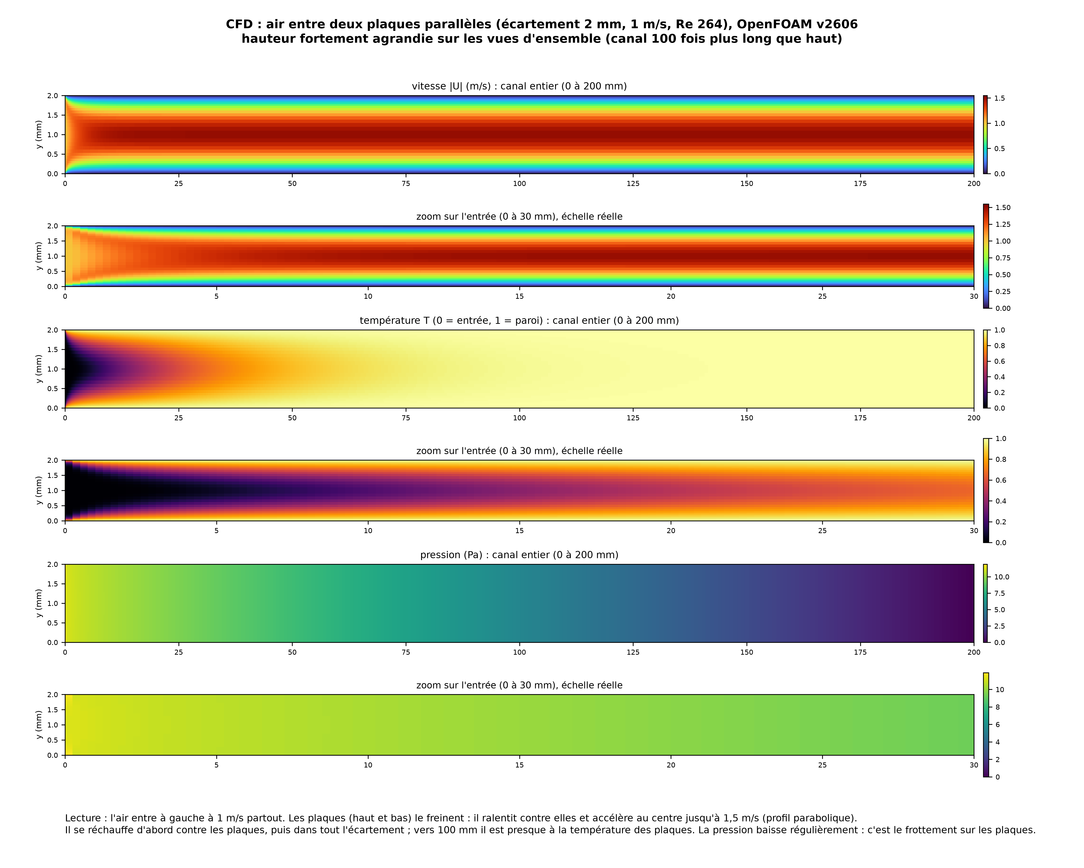
conception_echangeur/docs/formes/plaques/champs.png
