ET-FR/HP_new_generation/conception_echangeur/docs/formes/rond/convergence.png

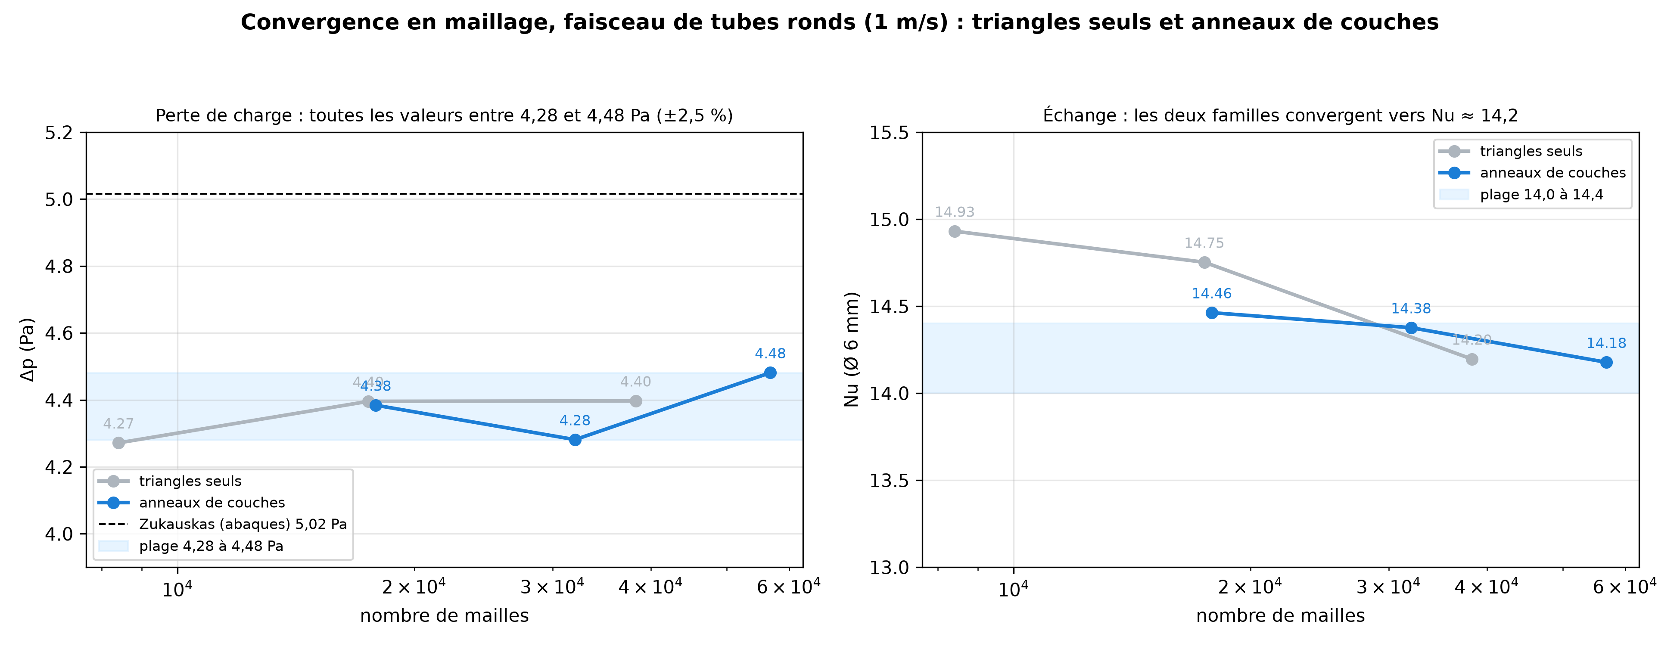
conception_echangeur/docs/formes/rond/convergence.png
