ET-FR/HP_new_generation/conception_echangeur/docs/formes/rond/maillage_couches.png

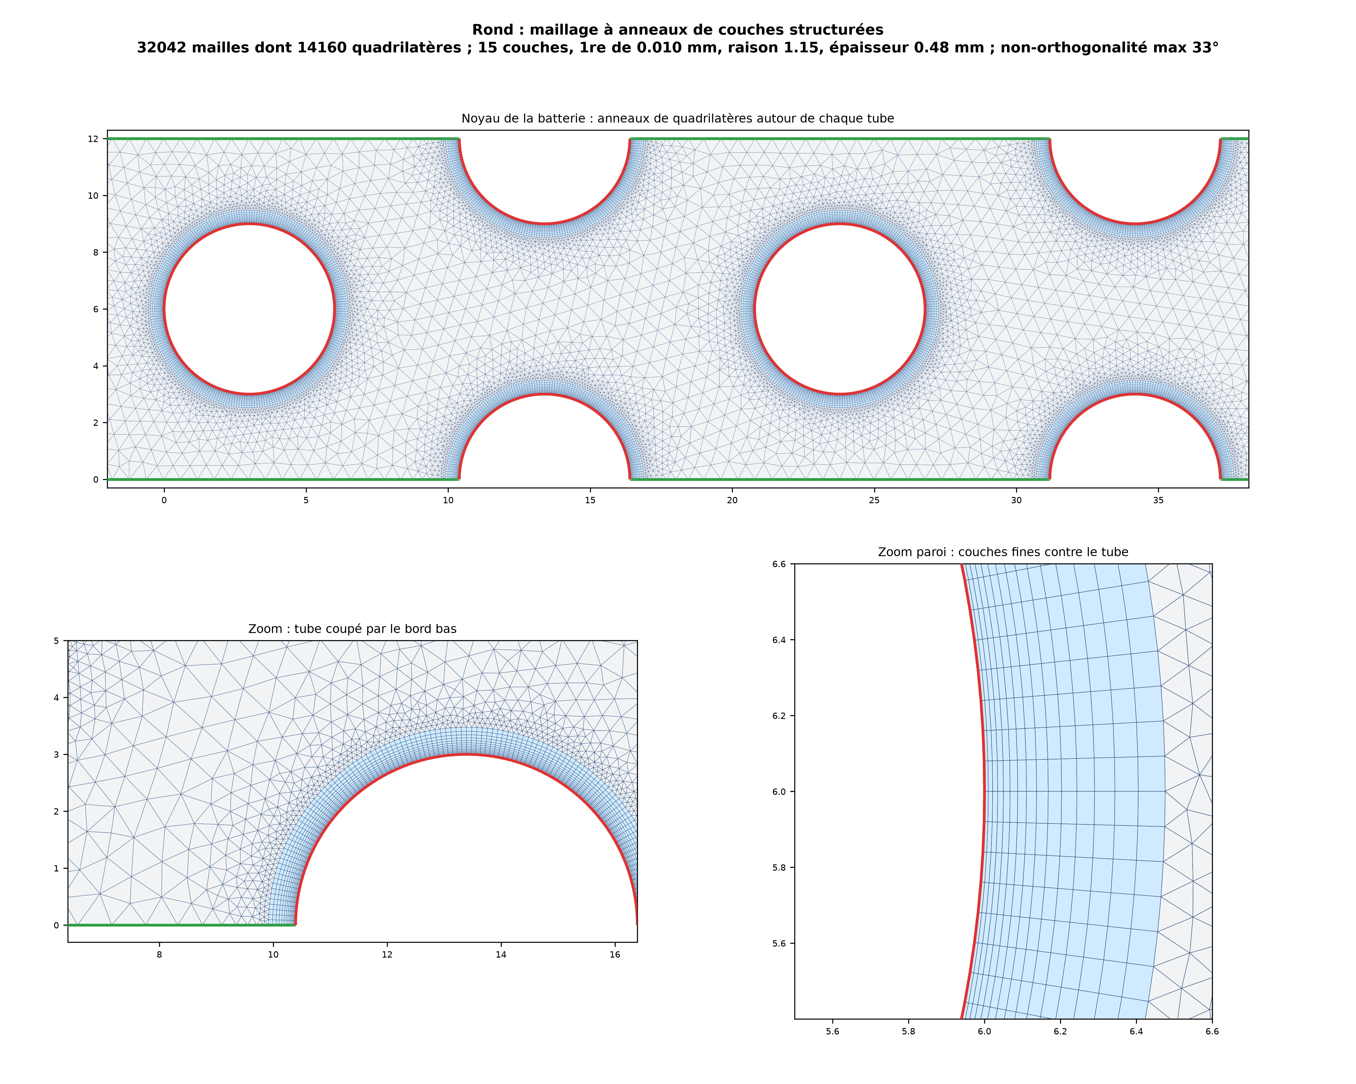
conception_echangeur/docs/formes/rond/maillage_couches.png
