ET-FR/HP_new_generation/conception_echangeur/docs/formes/tpms_gyroide/coupes_tpms.png

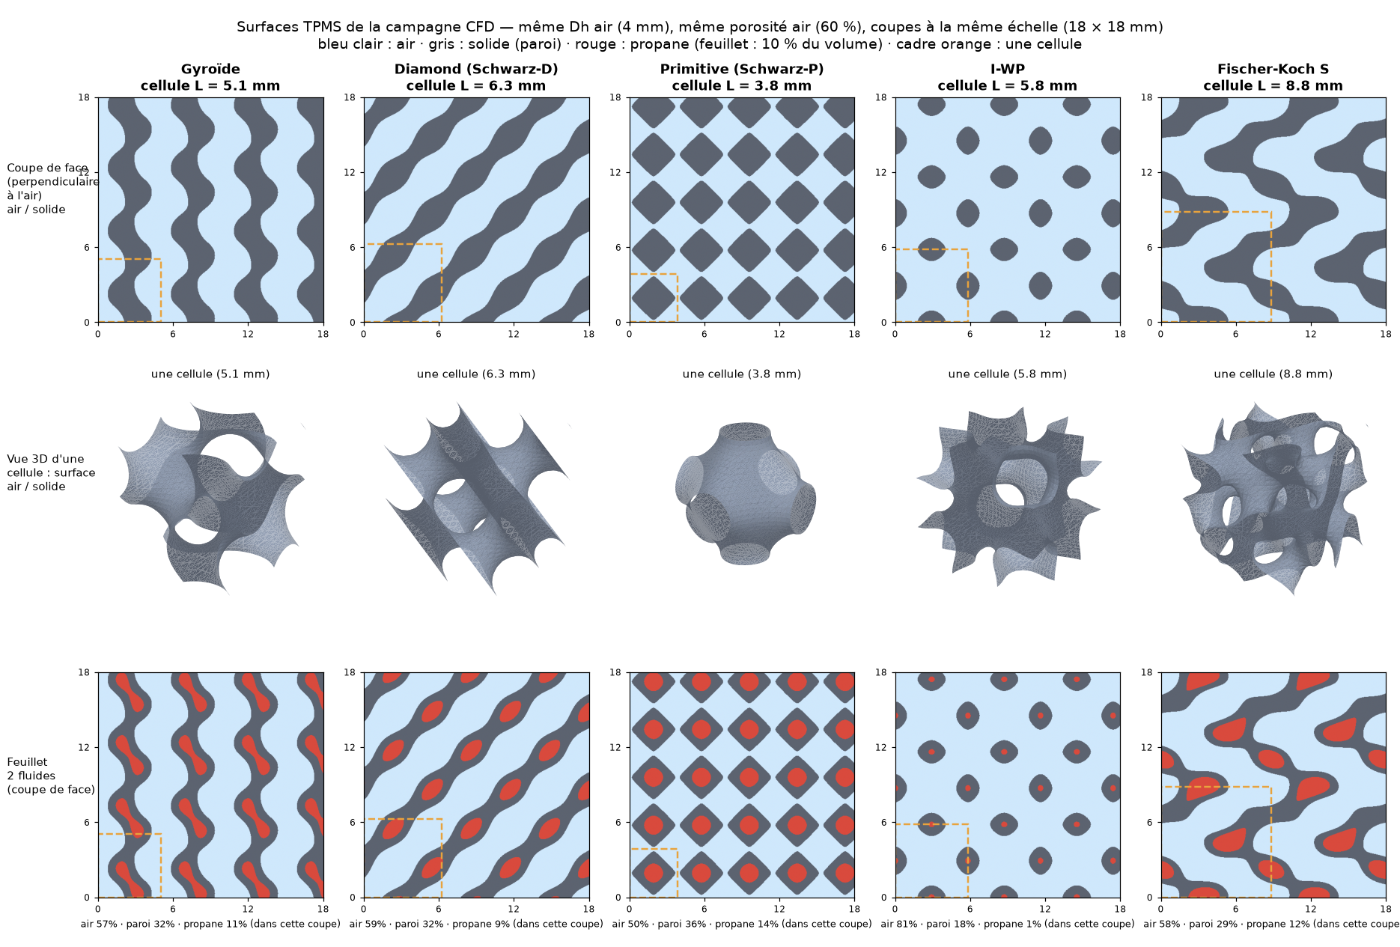
conception_echangeur/docs/formes/tpms_gyroide/coupes_tpms.png
