ET-FR/HP_new_generation/conception_echangeur/docs/formes/tpms_gyroide/maillage.png

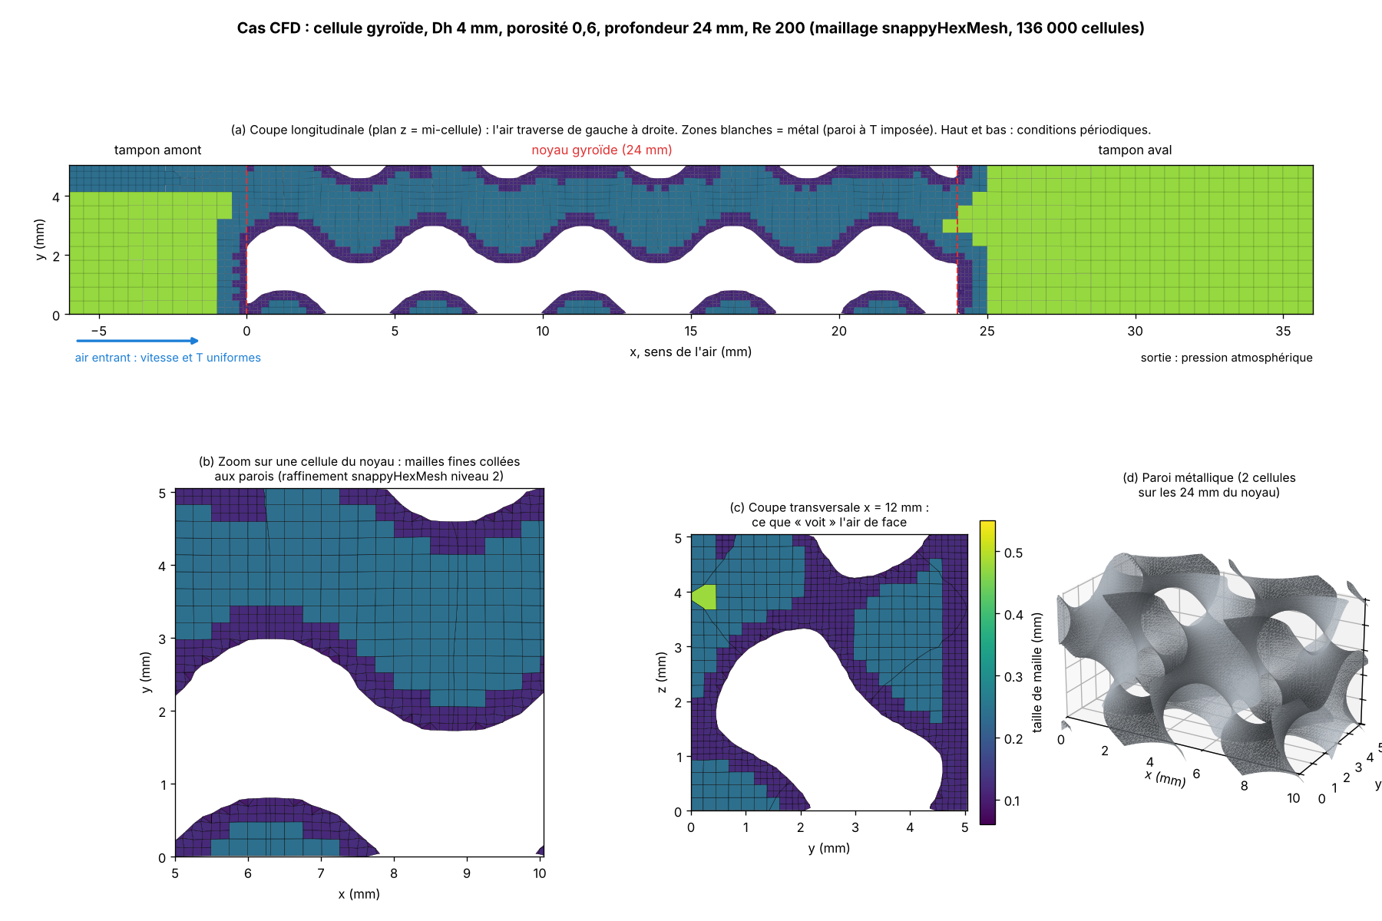
conception_echangeur/docs/formes/tpms_gyroide/maillage.png
