ET-FR/HP_new_generation/conception_echangeur/docs/formes/tpms_seul/maillage_gyroide_L3.png

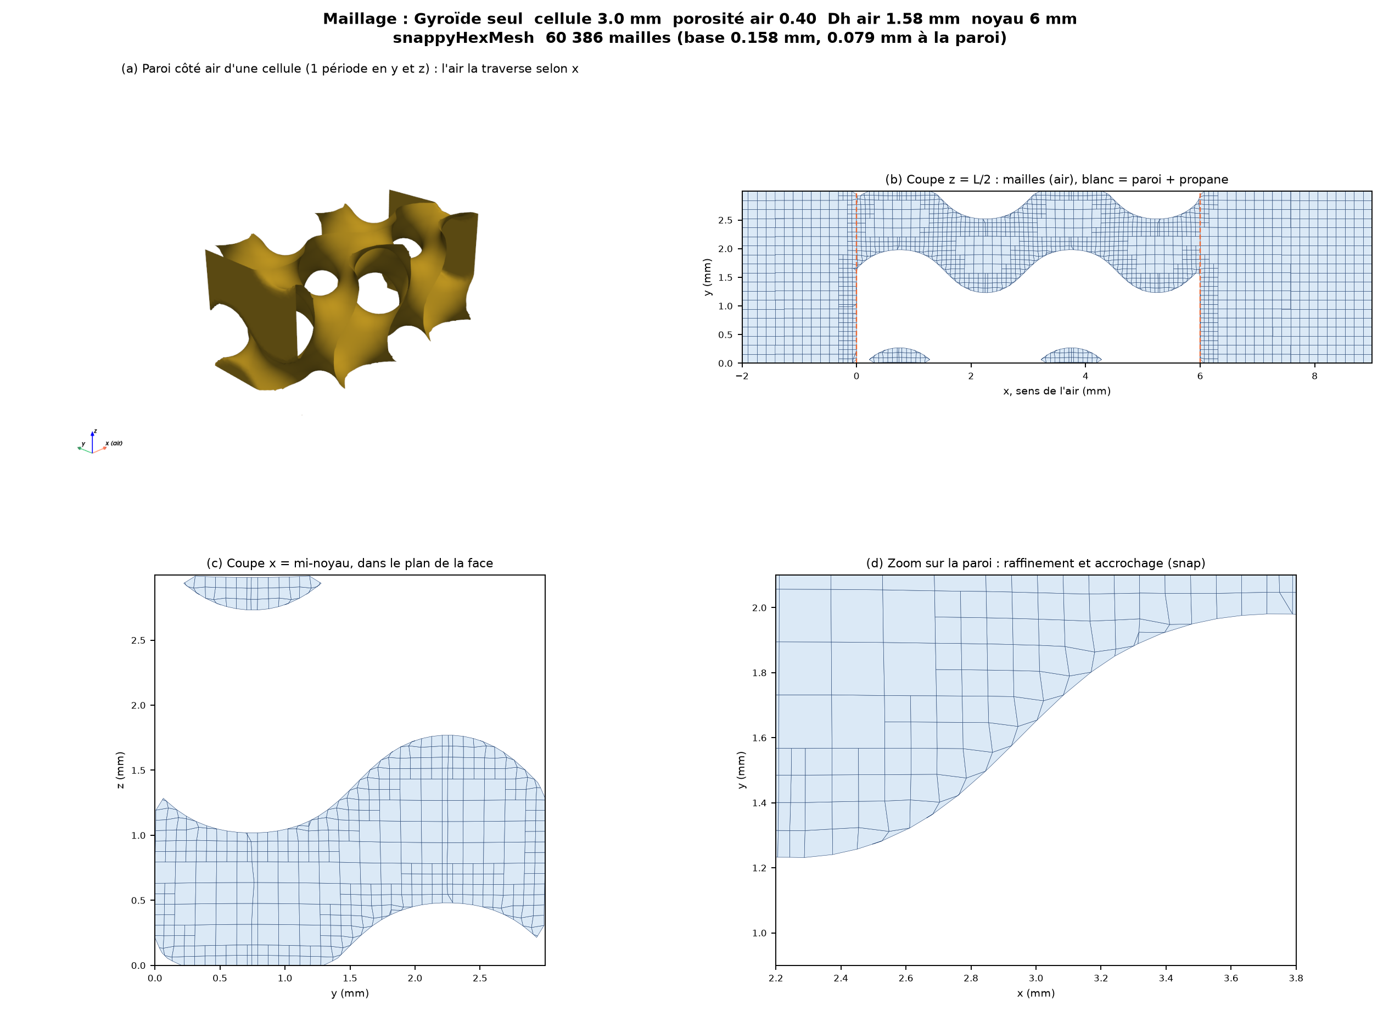
conception_echangeur/docs/formes/tpms_seul/maillage_gyroide_L3.png
