ET-FR/HP_new_generation/conception_echangeur/docs/maillages/ailettes_plates.png

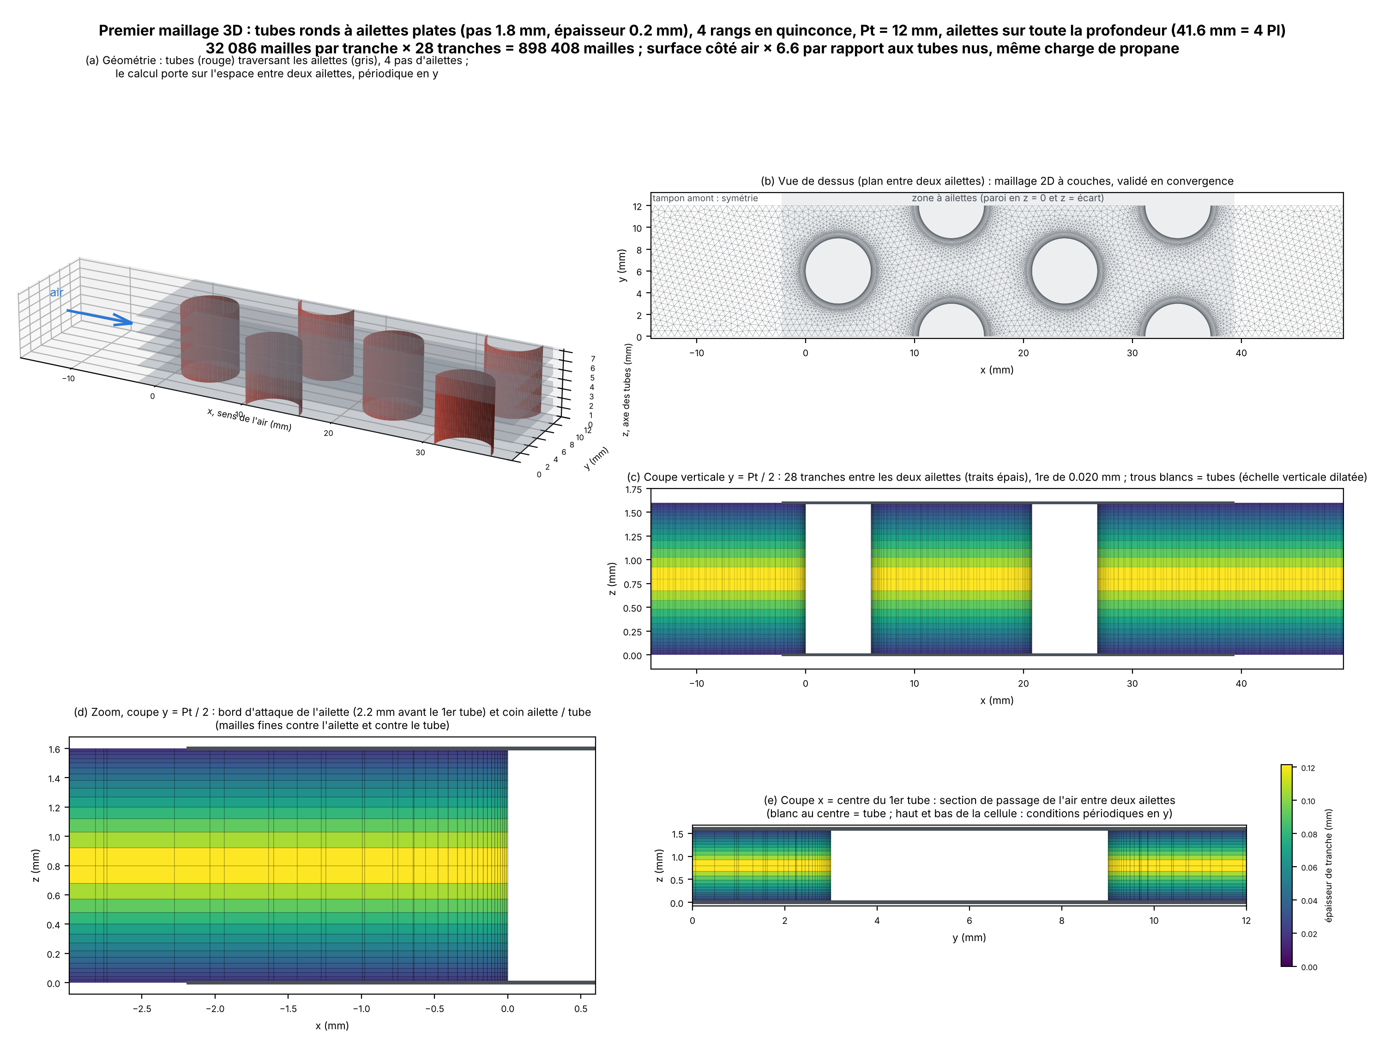
conception_echangeur/docs/maillages/ailettes_plates.png
