ET-FR/HP_new_generation/conception_echangeur/docs/maillages/formes_niveau1_zoom.png

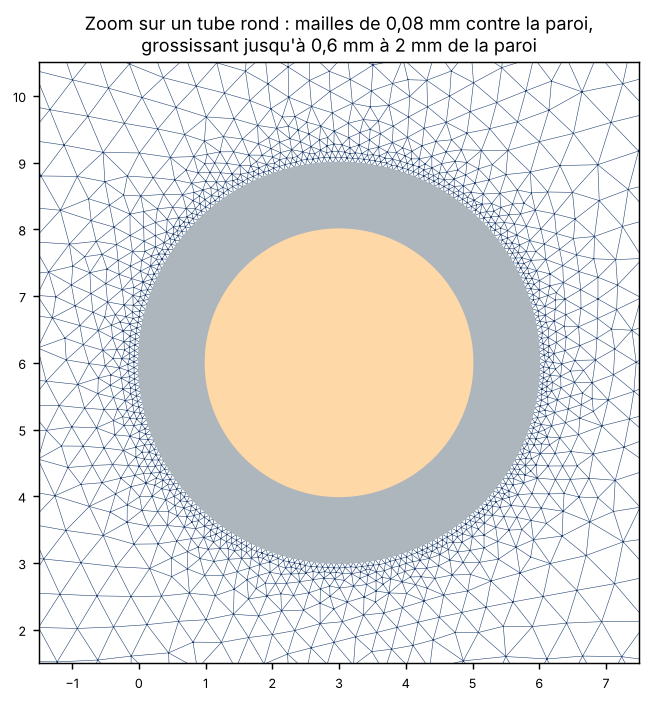
conception_echangeur/docs/maillages/formes_niveau1_zoom.png
