ET-FR/HP_new_generation/conception_echangeur/docs/maillages/formes_serie2.png

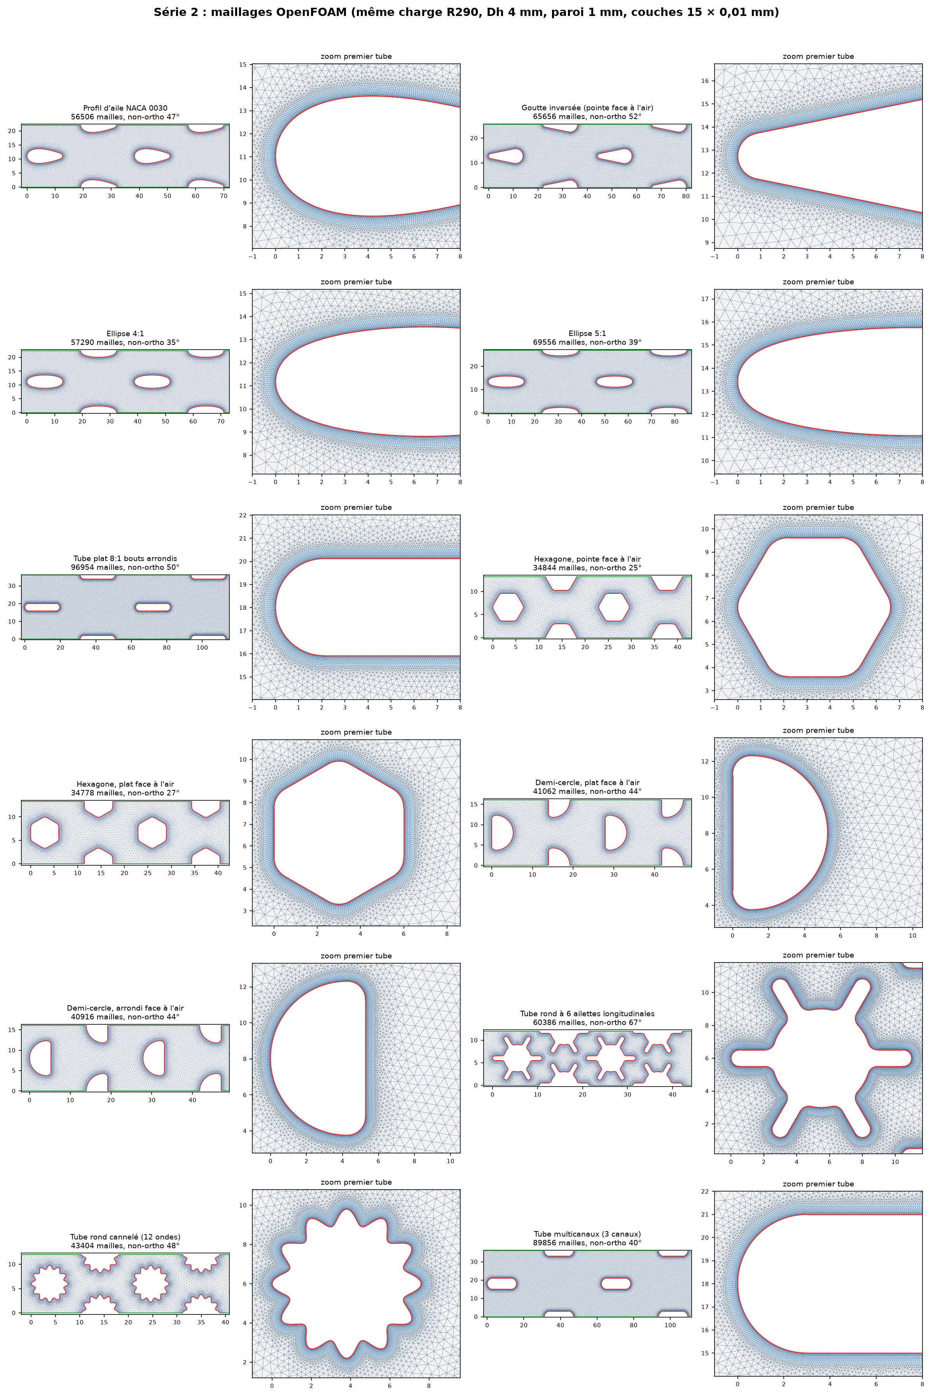
conception_echangeur/docs/maillages/formes_serie2.png
