ET-FR/HP_new_generation/conception_echangeur/docs/formes/cylindre_radial/variante_f/imprime/cfd/domaine_sans_entree.stl

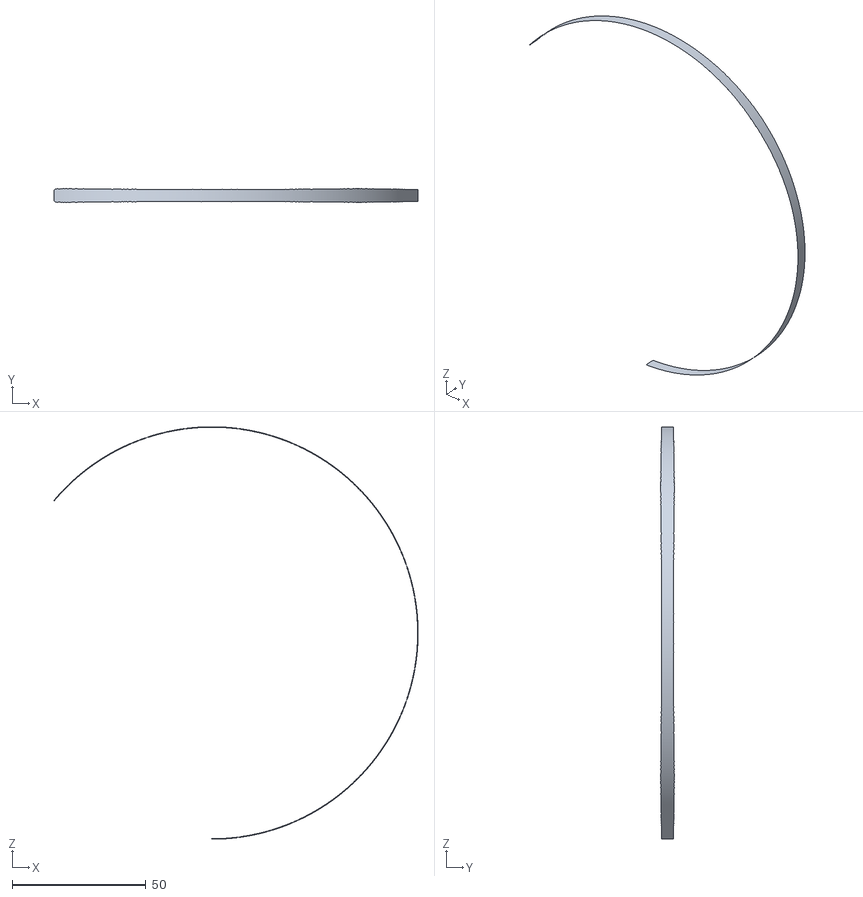
[picture p150: CAD file, 2026-11-13]
conception_echangeur/docs/formes/cylindre_radial/variante_f/imprime/cfd/domaine_sans_entree.stl
136.0 x 5.35 x 154.0
