ET-FR/HP_new_generation/conception_echangeur/docs/formes/cylindre_radial/variante_f/imprime/cfd/domaine_avec_cotes.stl

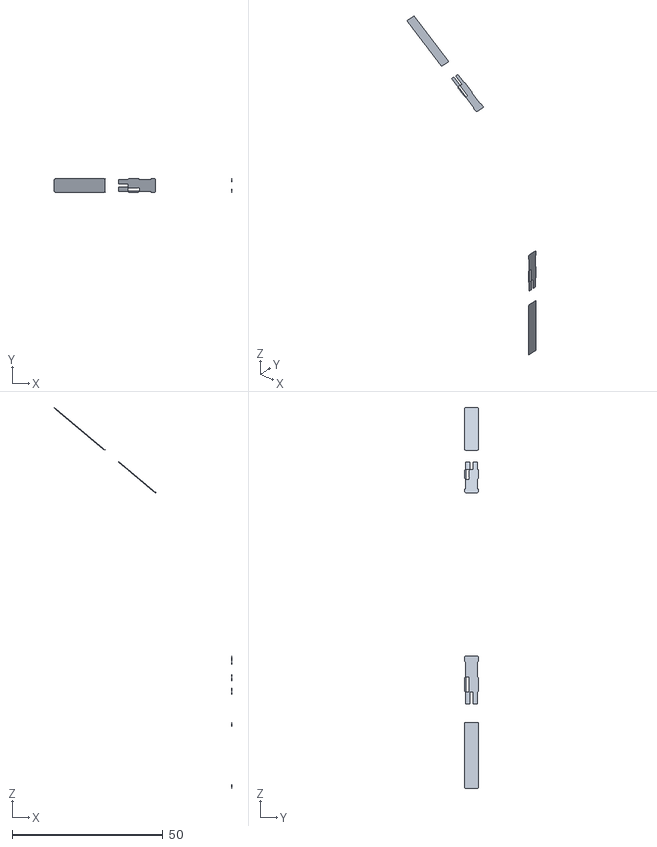
[picture p151: CAD file, 2026-11-13]
conception_echangeur/docs/formes/cylindre_radial/variante_f/imprime/cfd/domaine_avec_cotes.stl
59.1 x 4.66 x 126.6
