ET-FR/HP_new_generation/conception_echangeur/docs/formes/cylindre_radial/variante_f/imprime/cfd/domaine_avec_paroi.stl

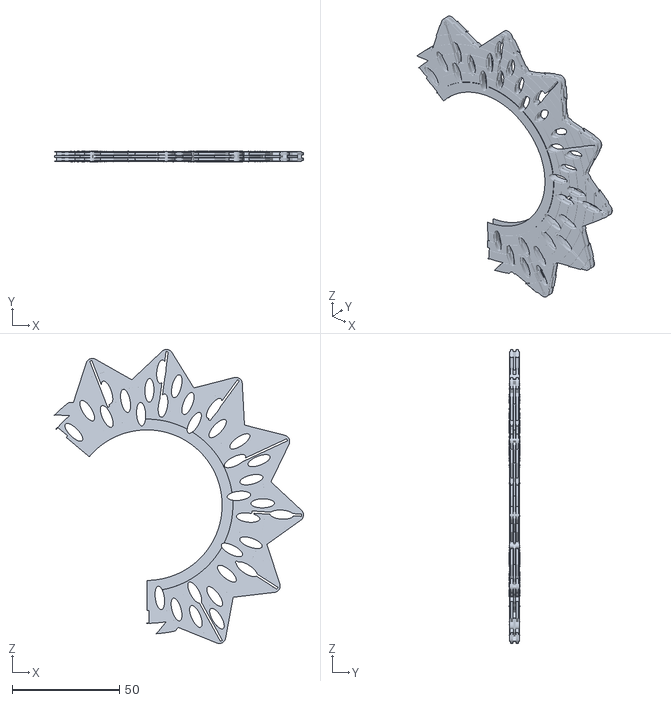
[picture p152: CAD file, 2026-11-13]
conception_echangeur/docs/formes/cylindre_radial/variante_f/imprime/cfd/domaine_avec_paroi.stl
115.8 x 5.24 x 136.8
