ET-FR/HP_new_generation/conception_echangeur/docs/formes/cylindre_radial/variante_f/imprime/cfd/domaine_avec_y1.stl

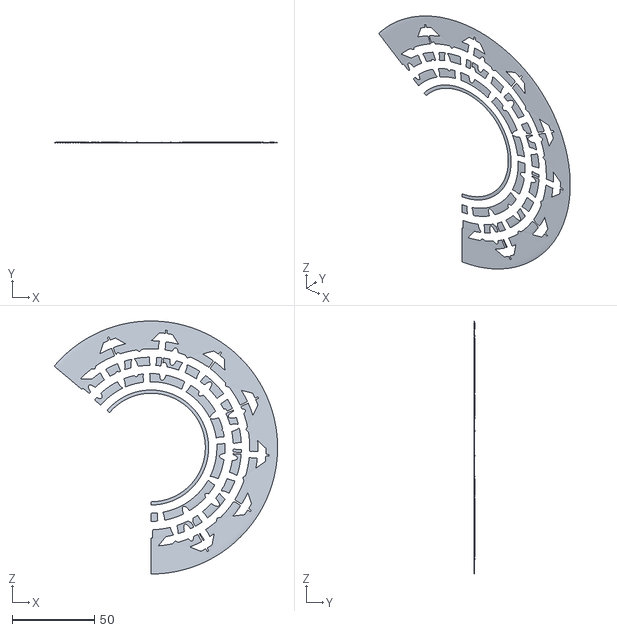
[picture p153: CAD file, 2026-11-13]
conception_echangeur/docs/formes/cylindre_radial/variante_f/imprime/cfd/domaine_avec_y1.stl
135.9 x 0.78 x 154.0
