ET-FR/HP_new_generation/conception_echangeur/docs/formes/cylindre_d150_helice/v1_conduits_droits/domaine_air.step

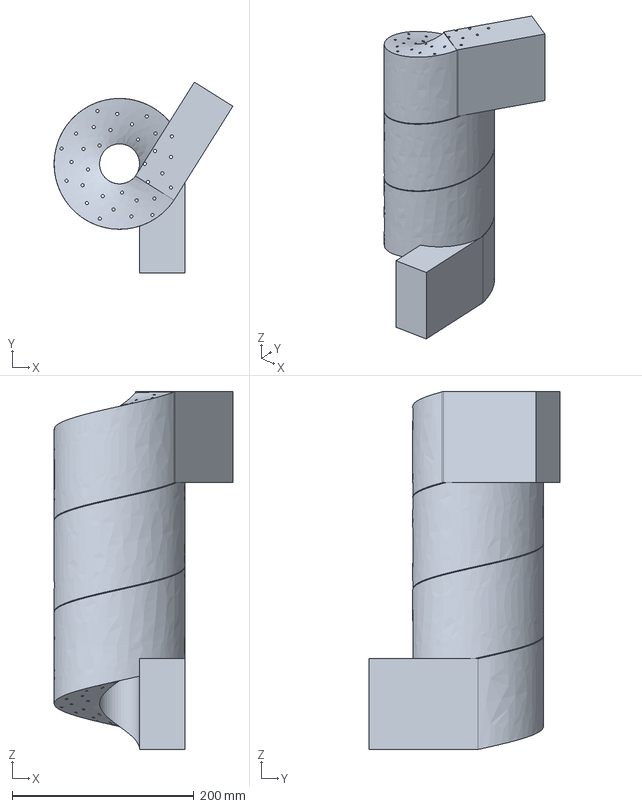
[picture p154: CAD file, 2026-11-13]
conception_echangeur/docs/formes/cylindre_d150_helice/v1_conduits_droits/domaine_air.step
196.7 x 210.0 x 394.0 mm
