ET-FR/HP_new_generation/conception_echangeur/docs/formes/cylindre_d150_helice/domaine_air.step

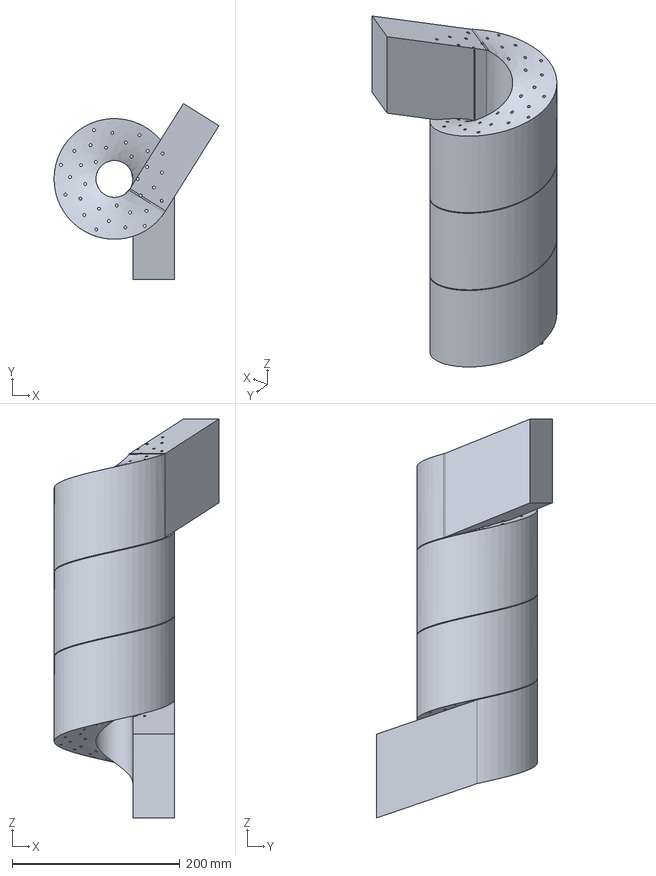
[picture p156: CAD file, 2026-11-13]
conception_echangeur/docs/formes/cylindre_d150_helice/domaine_air.step
196.7 x 210.0 x 476.1 mm
