ET-FR/HP_new_generation/conception_echangeur/docs/formes/cylindre_d100/noyau.stl

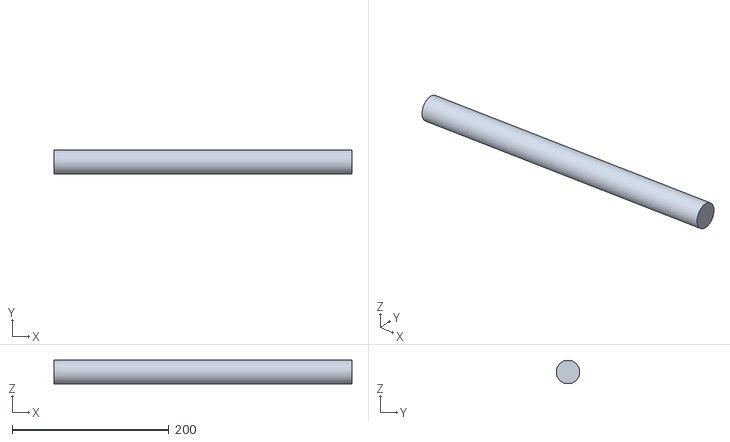
[picture p162: CAD file, 2026-11-13]
conception_echangeur/docs/formes/cylindre_d100/noyau.stl
380.0 x 30.0 x 30.0
