ET-FR/HP_new_generation/conception_echangeur/docs/formes/cylindre_d100_t32/arbre_entree.stl

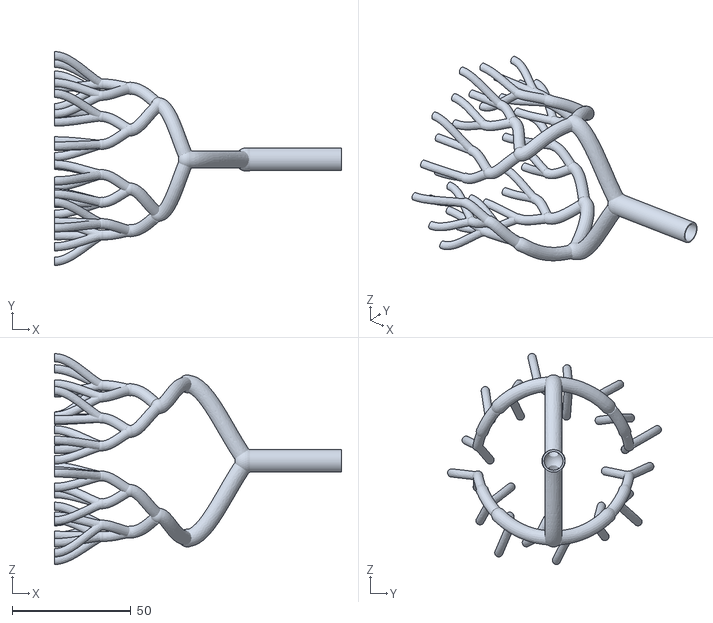
[picture p163: CAD file, 2026-11-13]
conception_echangeur/docs/formes/cylindre_d100_t32/arbre_entree.stl
121.0 x 90.2 x 89.0
