ET-FR/HP_new_generation/conception_echangeur/docs/formes/cylindre_d150_helice/cfd/entree.stl

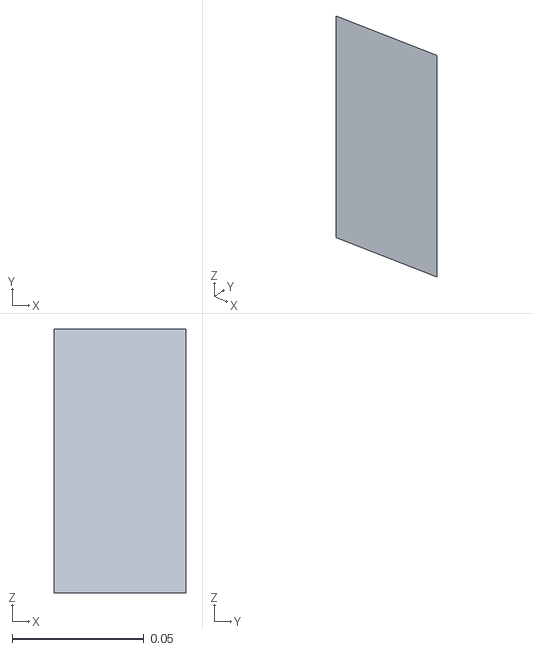
[picture p164: CAD file, 2026-11-13]
conception_echangeur/docs/formes/cylindre_d150_helice/cfd/entree.stl
0.05 x 0 x 0.1
