ET-FR/HP_new_generation/conception_echangeur/docs/formes/cylindre_d150_helice/tubes.stl

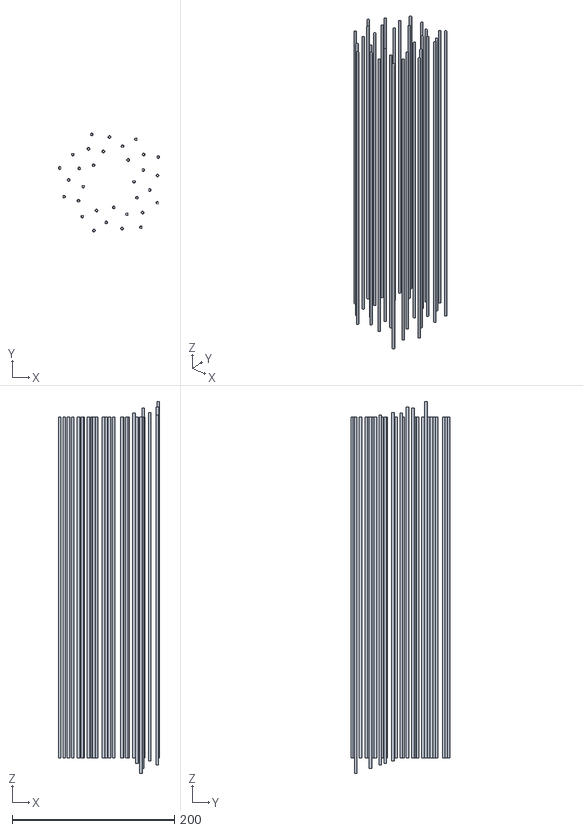
[picture p165: CAD file, 2026-11-13]
conception_echangeur/docs/formes/cylindre_d150_helice/tubes.stl
124.8 x 122.0 x 458.4
