ET-FR/HP_new_generation/conception_echangeur/docs/formes/cylindre_d150_helice/v1_conduits_droits/cfd/sortie.stl

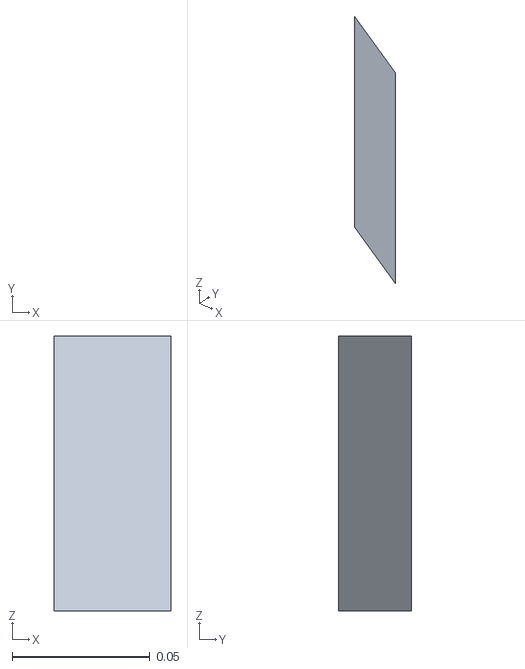
[picture p166: CAD file, 2026-11-13]
conception_echangeur/docs/formes/cylindre_d150_helice/v1_conduits_droits/cfd/sortie.stl
0.0424 x 0.0266 x 0.1
