ET-FR/HP_new_generation/conception_echangeur/docs/formes/cylindre_d150_helice/v1_conduits_droits/tubes.stl

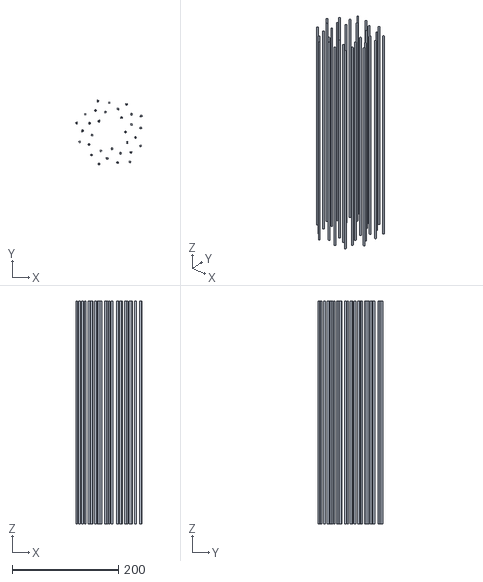
[picture p167: CAD file, 2026-11-13]
conception_echangeur/docs/formes/cylindre_d150_helice/v1_conduits_droits/tubes.stl
124.8 x 122.0 x 420.0
