ET-FR/HP_new_generation/conception_echangeur/docs/formes/cylindre_radial/echangeur_radial.step

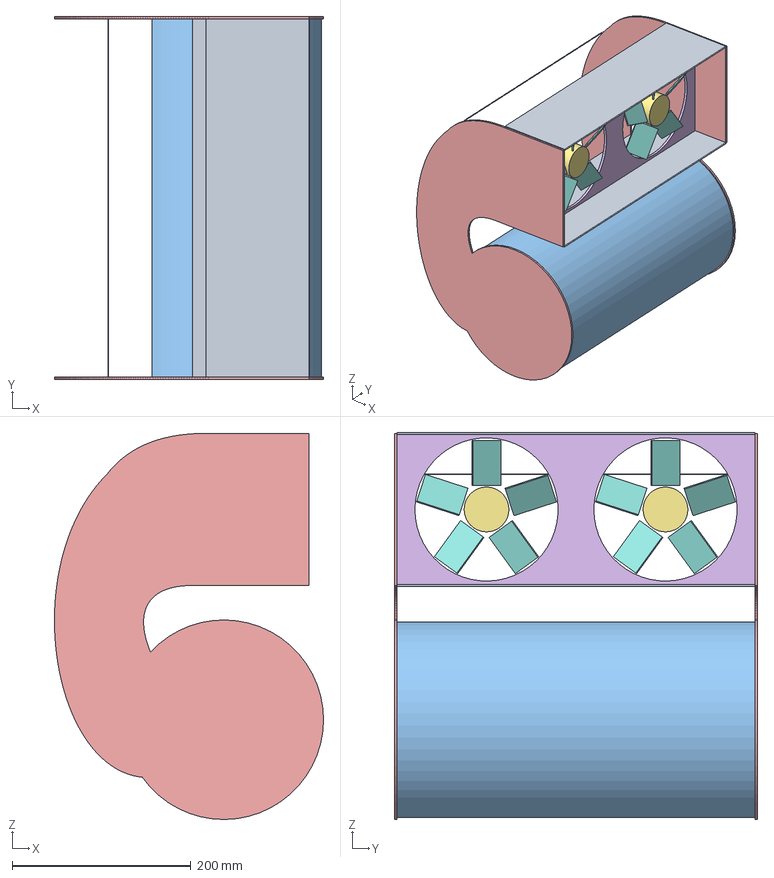
[picture p168: CAD file, 2026-11-13]
conception_echangeur/docs/formes/cylindre_radial/echangeur_radial.step
300.7 x 406.0 x 432.5 mm
