ET-FR/HP_new_generation/conception_echangeur/docs/formes/cylindre_radial/variante_e/variante_e.step

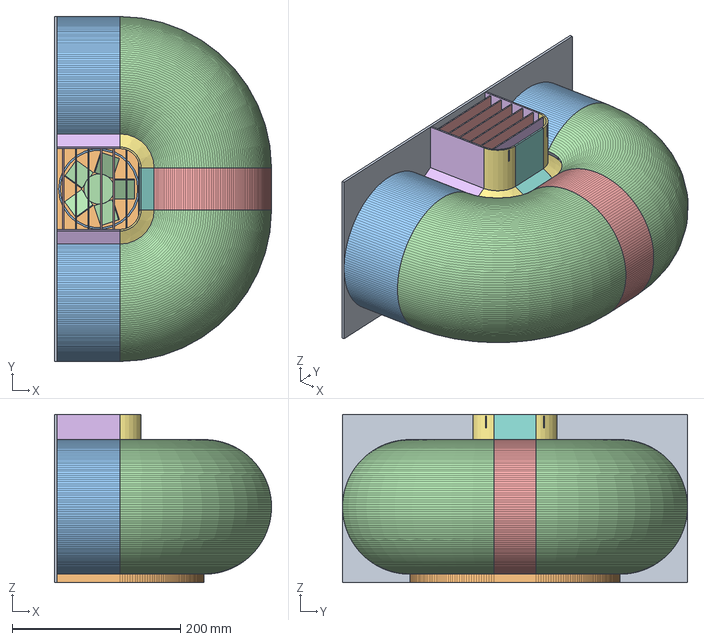
[picture p169: CAD file, 2026-11-13]
conception_echangeur/docs/formes/cylindre_radial/variante_e/variante_e.step
258.0 x 410.0 x 200.0 mm
