ET-FR/HP_new_generation/conception_echangeur/docs/formes/cylindre_radial/variante_f/imprime/imp_avec_filtre.stl

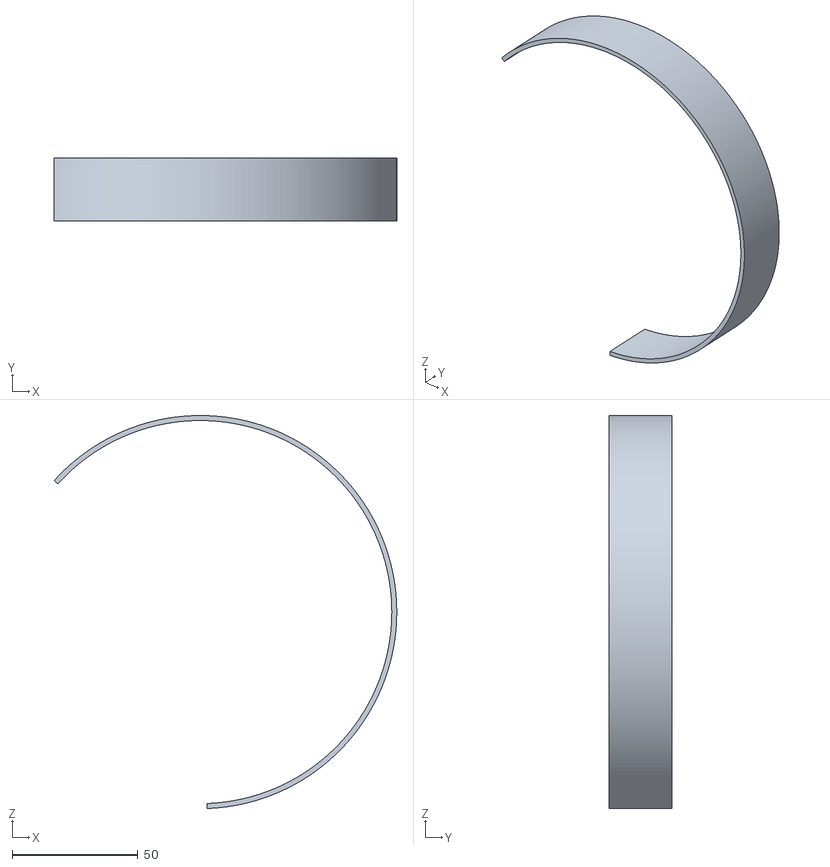
[picture p170: CAD file, 2026-11-13]
conception_echangeur/docs/formes/cylindre_radial/variante_f/imprime/imp_avec_filtre.stl
136.0 x 25.0 x 156.0
