ET-FR/HP_new_generation/conception_echangeur/docs/formes/cylindre_radial/variante_f/imprime/secteur/sect_lamelles_f05i.stl

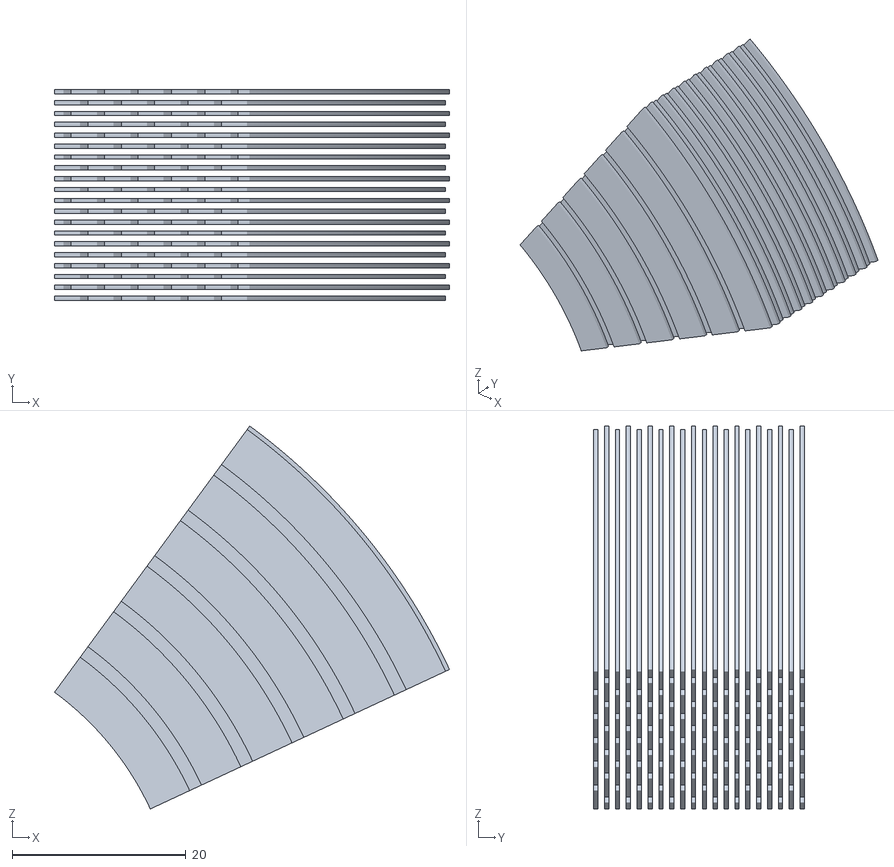
[picture p171: CAD file, 2026-11-13]
conception_echangeur/docs/formes/cylindre_radial/variante_f/imprime/secteur/sect_lamelles_f05i.stl
45.5 x 24.2 x 44.1
