ET-FR/HP_new_generation/conception_echangeur/docs/formes/helice/arbre_bas.stl

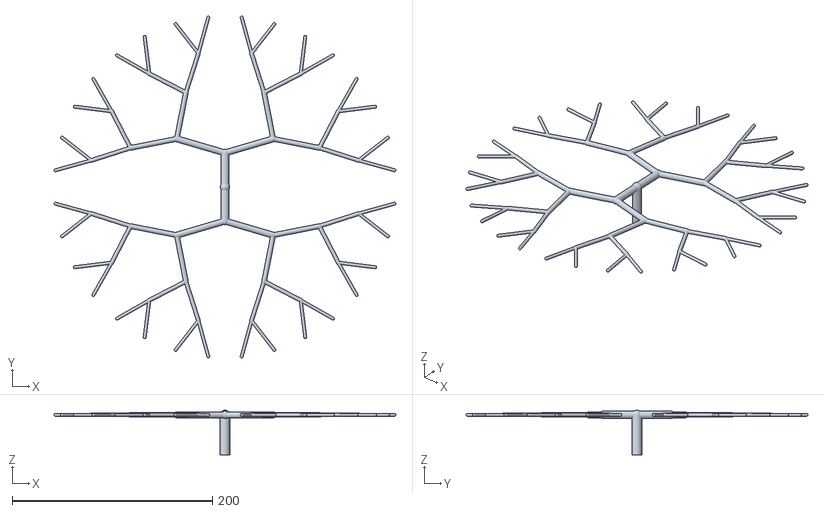
[picture p173: CAD file, 2026-11-11]
conception_echangeur/docs/formes/helice/arbre_bas.stl
341.4 x 341.3 x 44.8
