ET-FR/HP_new_generation/conception_echangeur/docs/formes/cylindre_d100/tubes.stl

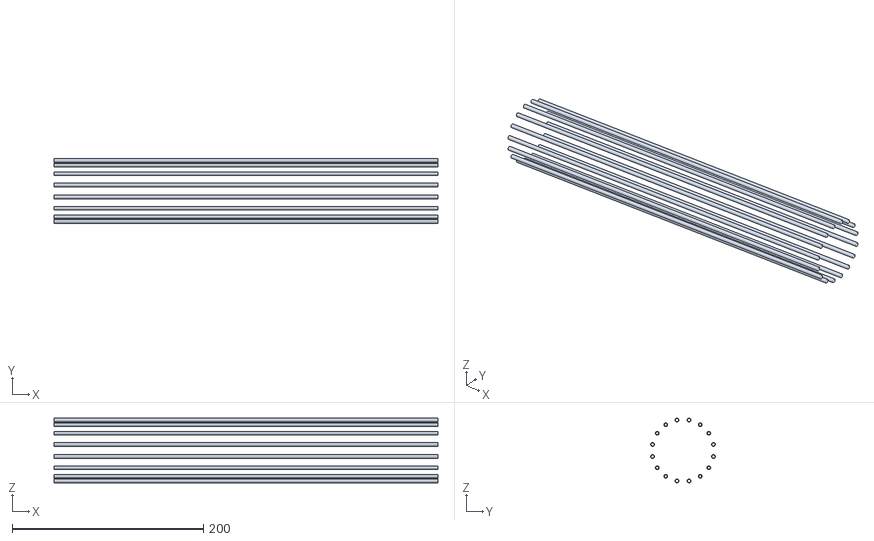
[picture p174: CAD file, 2026-11-13]
conception_echangeur/docs/formes/cylindre_d100/tubes.stl
402.0 x 67.9 x 67.9
