ET-FR/HP_new_generation/conception_echangeur/docs/formes/cylindre_d150_helice/ailette.stl

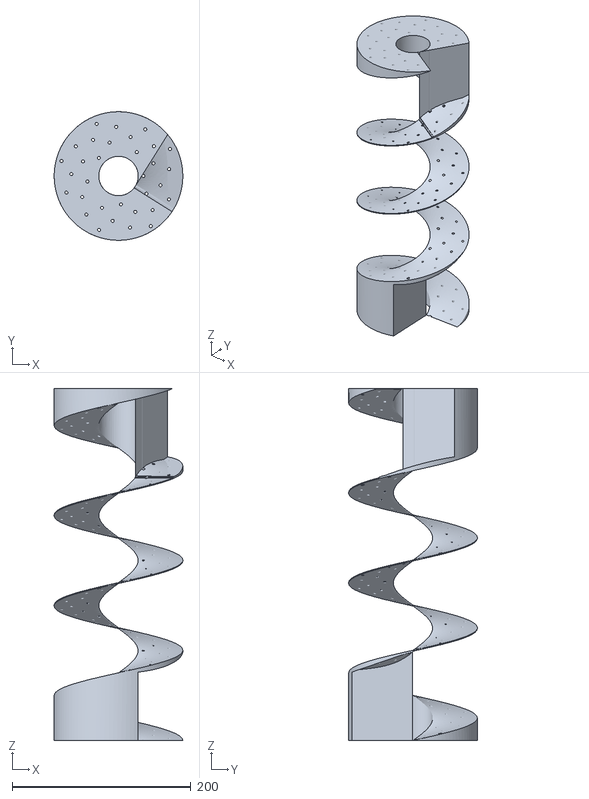
[picture p175: CAD file, 2026-11-13]
conception_echangeur/docs/formes/cylindre_d150_helice/ailette.stl
144.0 x 144.0 x 394.0
