ET-FR/HP_new_generation/conception_echangeur/docs/formes/cylindre_d150_helice/cfd/parois.stl

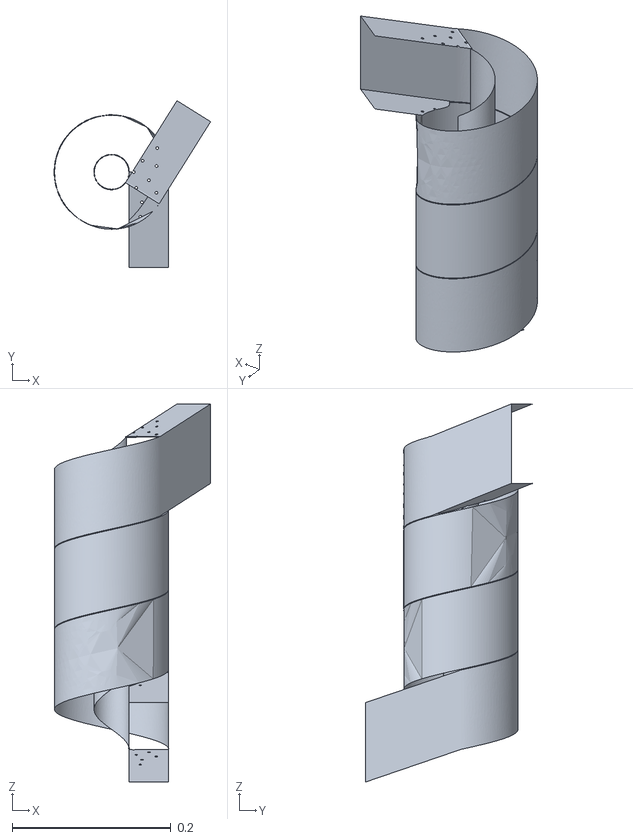
[picture p176: CAD file, 2026-11-13]
conception_echangeur/docs/formes/cylindre_d150_helice/cfd/parois.stl
0.197 x 0.21 x 0.476
