ET-FR/HP_new_generation/conception_echangeur/docs/formes/cylindre_d150_helice/v1_conduits_droits/enveloppe.stl

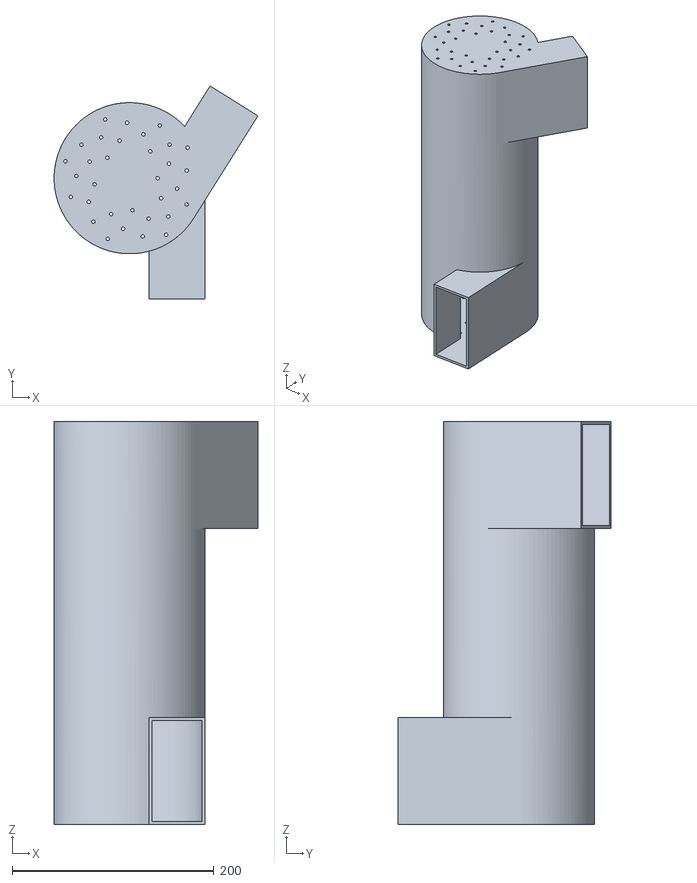
[picture p178: CAD file, 2026-11-13]
conception_echangeur/docs/formes/cylindre_d150_helice/v1_conduits_droits/enveloppe.stl
202.3 x 211.6 x 400.0
