ET-FR/HP_new_generation/conception_echangeur/docs/formes/cylindre_radial/cloisons.stl

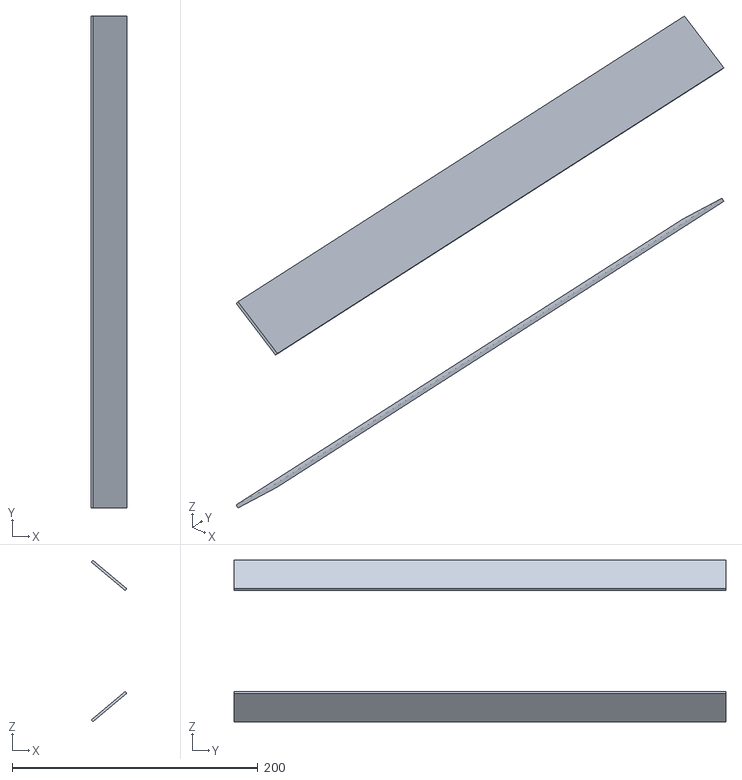
[picture p179: CAD file, 2026-11-13]
conception_echangeur/docs/formes/cylindre_radial/cloisons.stl
28.9 x 400.0 x 131.4
