ET-FR/HP_new_generation/conception_echangeur/docs/formes/cylindre_radial/variante_e/plenum.stl

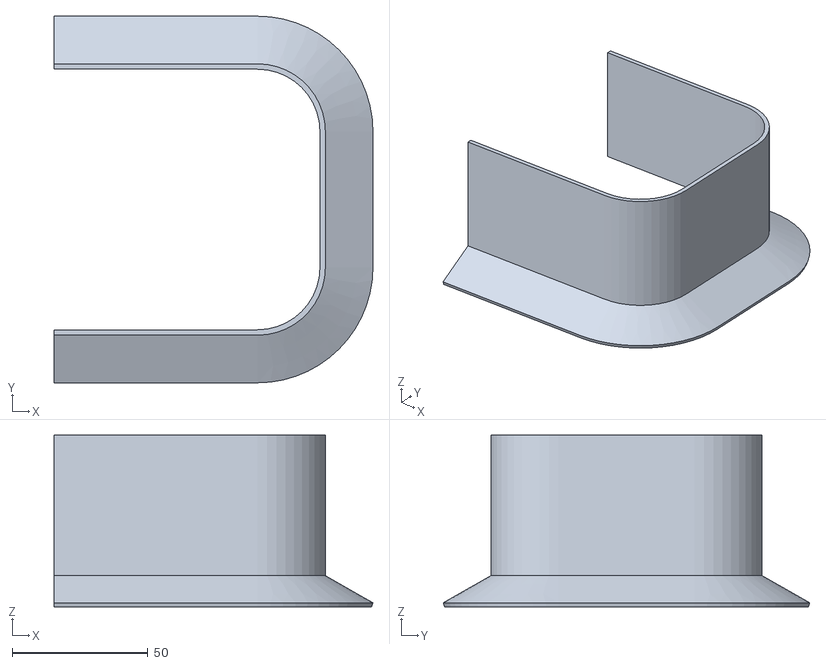
[picture p180: CAD file, 2026-11-13]
conception_echangeur/docs/formes/cylindre_radial/variante_e/plenum.stl
117.5 x 135.1 x 63.3
