ET-FR/HP_new_generation/conception_echangeur/docs/formes/cylindre_radial/variante_f/tranche_lamelles.step

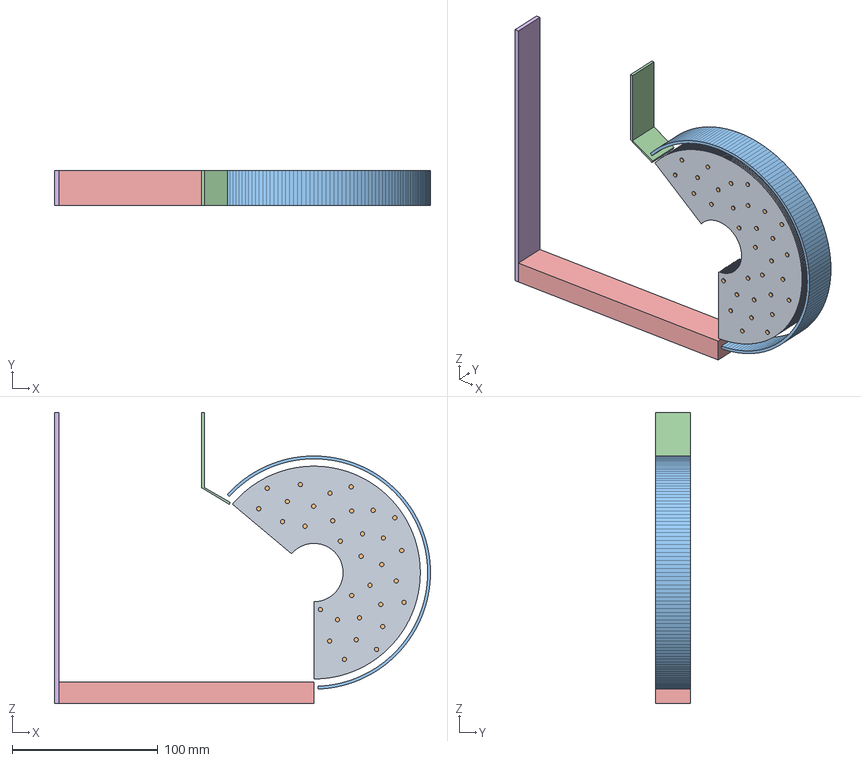
[picture p182: CAD file, 2026-11-13]
conception_echangeur/docs/formes/cylindre_radial/variante_f/tranche_lamelles.step
258.0 x 24.0 x 200.0 mm
