ET-FR/HP_new_generation/conception_echangeur/docs/formes/helice/tubes.stl

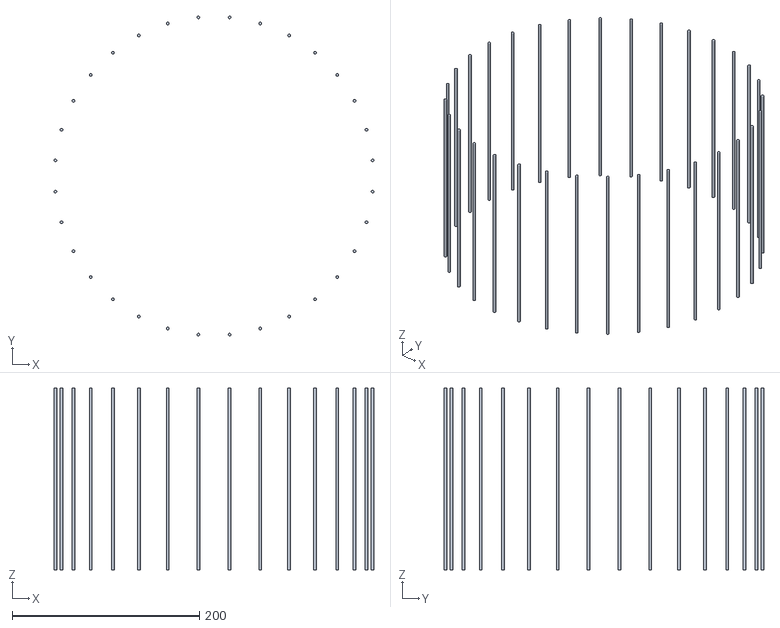
[picture p183: CAD file, 2026-11-11]
conception_echangeur/docs/formes/helice/tubes.stl
341.4 x 341.4 x 194.0
