ET-FR/HP_new_generation/conception_echangeur/docs/formes/cylindre_d100/enveloppe.stl

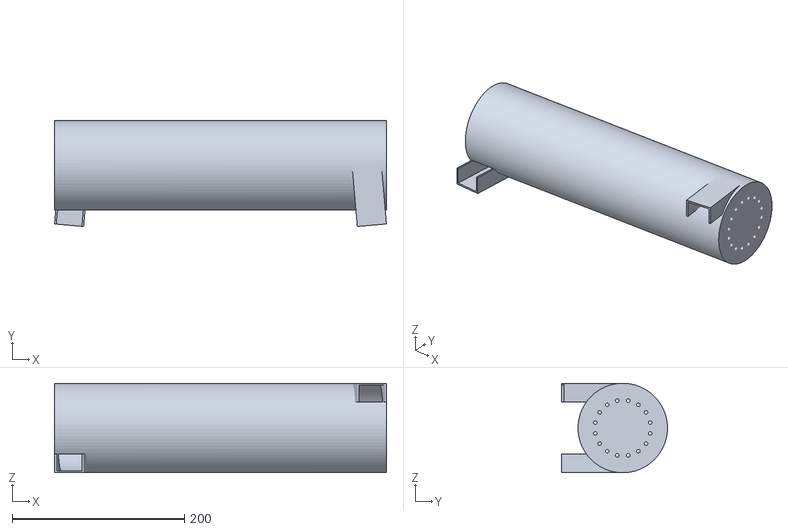
[picture p184: CAD file, 2026-11-13]
conception_echangeur/docs/formes/cylindre_d100/enveloppe.stl
386.0 x 123.2 x 104.0
