ET-FR/HP_new_generation/conception_echangeur/docs/formes/cylindre_d100_t32/tubes.stl

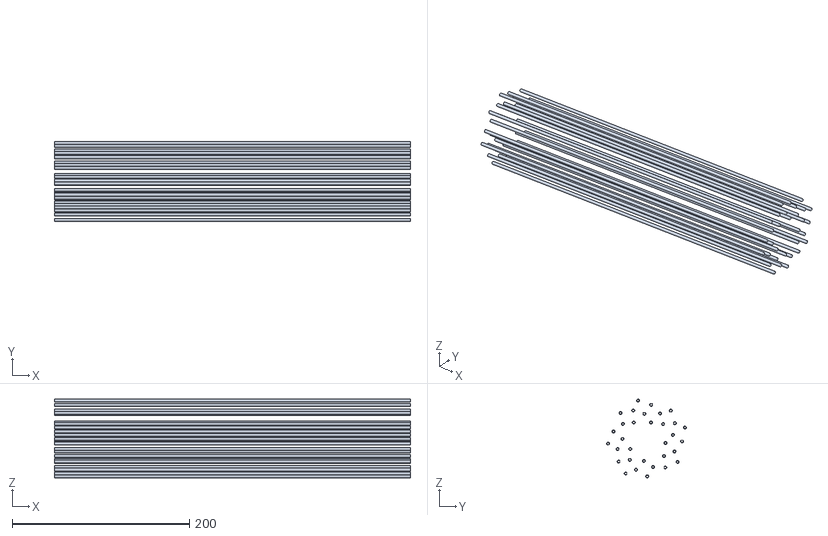
[picture p185: CAD file, 2026-11-13]
conception_echangeur/docs/formes/cylindre_d100_t32/tubes.stl
402.0 x 90.2 x 89.0
