ET-FR/HP_new_generation/conception_echangeur/docs/formes/cylindre_d150_helice/v1_conduits_droits/cfd/tubes.stl

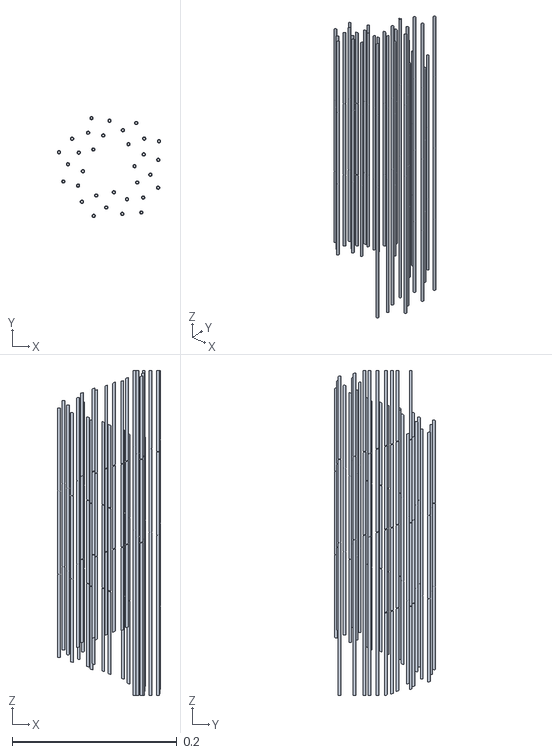
[picture p189: CAD file, 2026-11-13]
conception_echangeur/docs/formes/cylindre_d150_helice/v1_conduits_droits/cfd/tubes.stl
0.125 x 0.122 x 0.394
