ET-FR/HP_new_generation/conception_echangeur/docs/formes/cylindre_radial/variante_e/tubes_web.stl

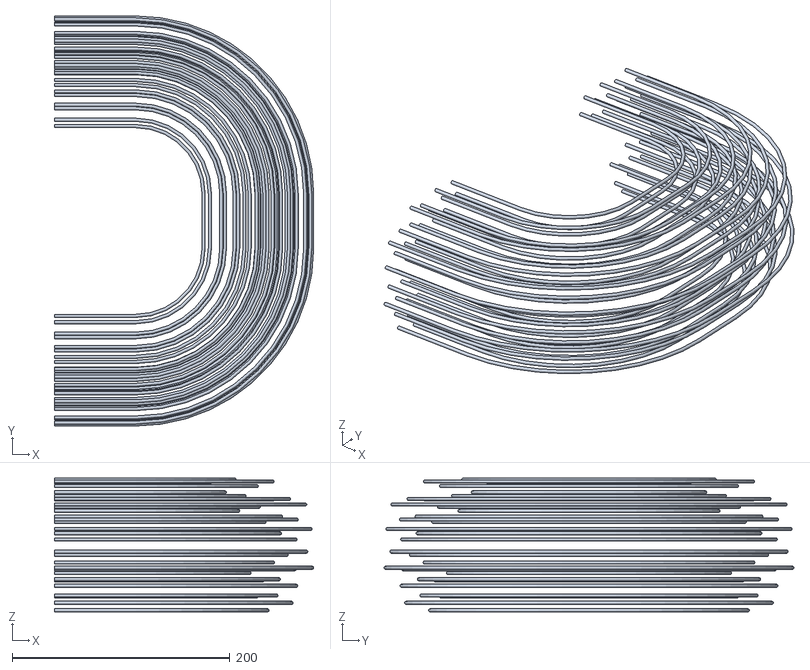
[picture p190: CAD file, 2026-11-13]
conception_echangeur/docs/formes/cylindre_radial/variante_e/tubes_web.stl
238.4 x 376.7 x 123.0
