ET-FR/HP_new_generation/conception_echangeur/docs/formes/cylindre_radial/variante_f/imprime/secteur/sect_profils_f05i.stl

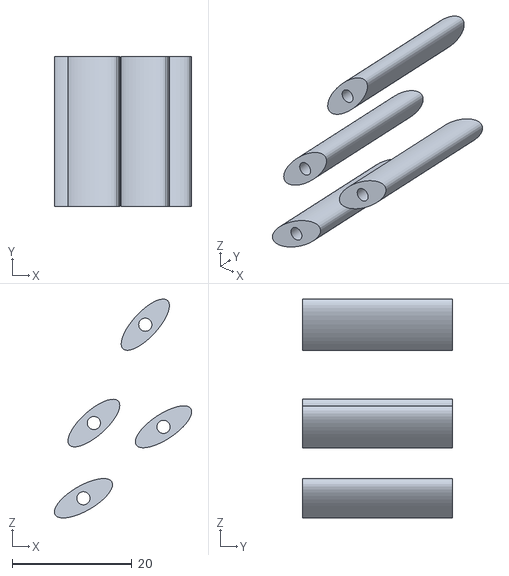
[picture p192: CAD file, 2026-11-13]
conception_echangeur/docs/formes/cylindre_radial/variante_f/imprime/secteur/sect_profils_f05i.stl
23.0 x 25.0 x 36.6
