ET-FR/HP_new_generation/conception_echangeur/docs/formes/cylindre_radial/variante_f/plis_plaque.stl

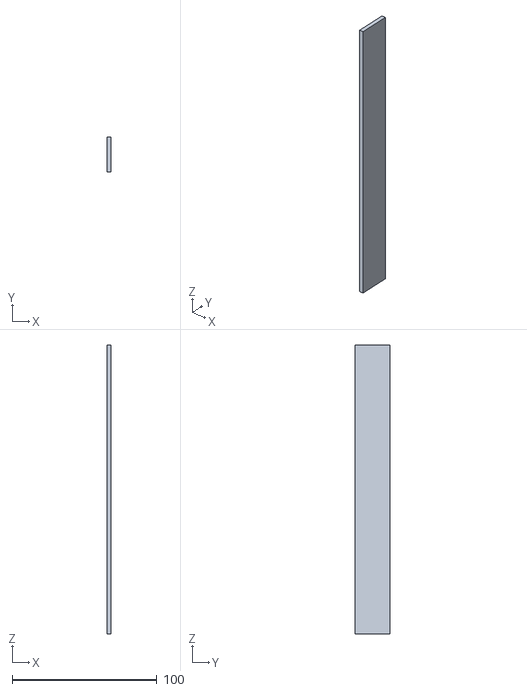
[picture p193: CAD file, 2026-11-13]
conception_echangeur/docs/formes/cylindre_radial/variante_f/plis_plaque.stl
3.00 x 24.0 x 200.0
