ET-FR/HP_new_generation/conception_echangeur/docs/formes/cylindre_radial/ventilateurs.stl

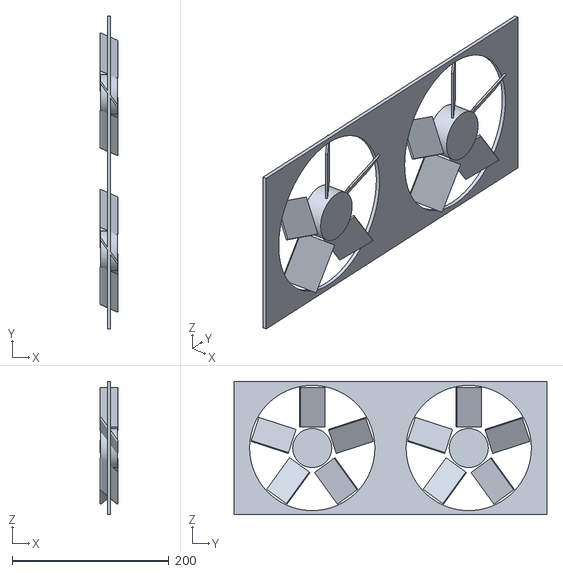
[picture p194: CAD file, 2026-11-13]
conception_echangeur/docs/formes/cylindre_radial/ventilateurs.stl
23.4 x 400.0 x 170.0
