ET-FR/HP_new_generation/conception_echangeur/docs/formes/helice/enveloppe.stl

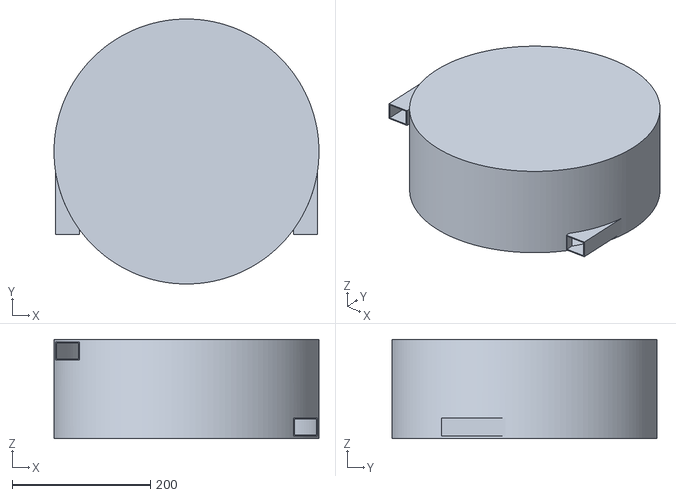
[picture p195: CAD file, 2026-11-11]
conception_echangeur/docs/formes/helice/enveloppe.stl
384.0 x 383.9 x 144.0
