ET-FR/HP_new_generation/conception_echangeur/docs/formes/cylindre_d100_t32/echangeur_d100.step

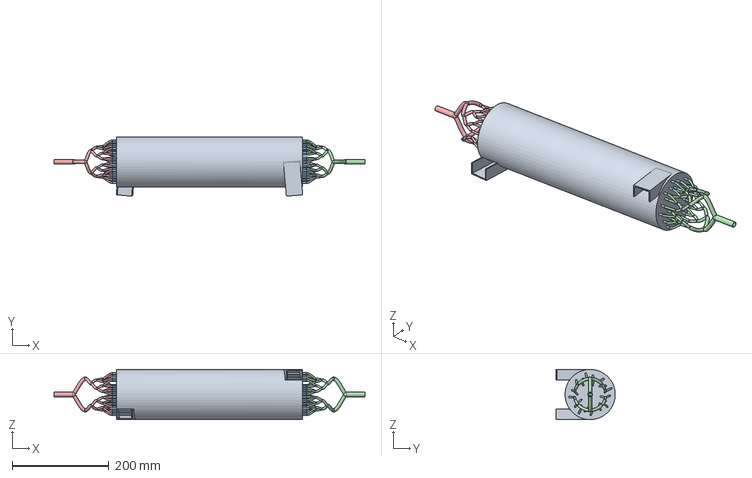
[picture p197: CAD file, 2026-11-13]
conception_echangeur/docs/formes/cylindre_d100_t32/echangeur_d100.step
644.0 x 123.2 x 104.0 mm
