ET-FR/HP_new_generation/conception_echangeur/docs/formes/cylindre_d150_helice/echangeur_d150.step

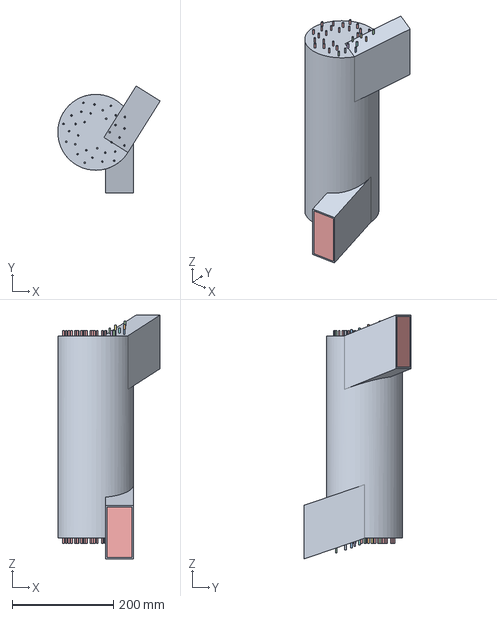
[picture p198: CAD file, 2026-11-13]
conception_echangeur/docs/formes/cylindre_d150_helice/echangeur_d150.step
202.3 x 211.6 x 482.1 mm
