ET-FR/HP_new_generation/conception_echangeur/docs/formes/cylindre_d150_helice/v1_conduits_droits/echangeur_d150.step

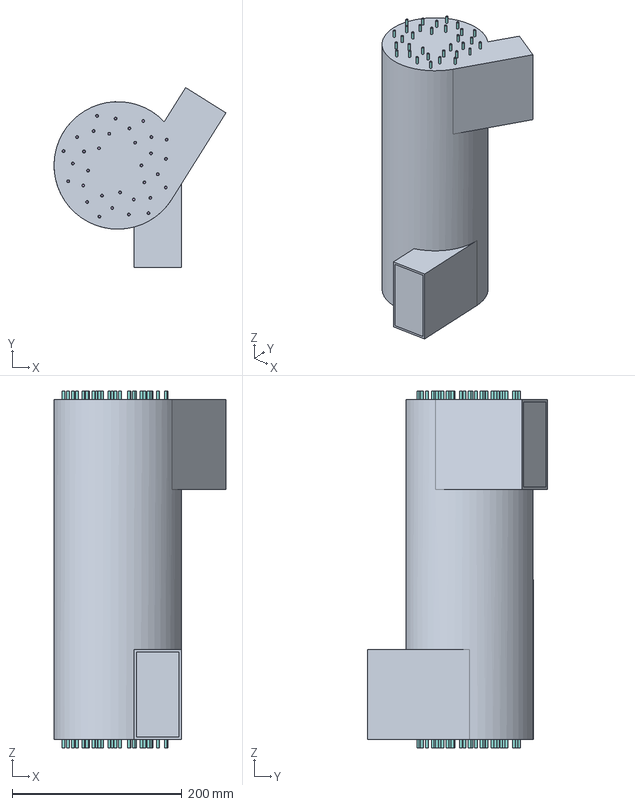
[picture p199: CAD file, 2026-11-13]
conception_echangeur/docs/formes/cylindre_d150_helice/v1_conduits_droits/echangeur_d150.step
202.3 x 211.6 x 420.0 mm
