ET-FR/HP_new_generation/conception_echangeur/docs/formes/cylindre_radial/variante_e/socle.stl

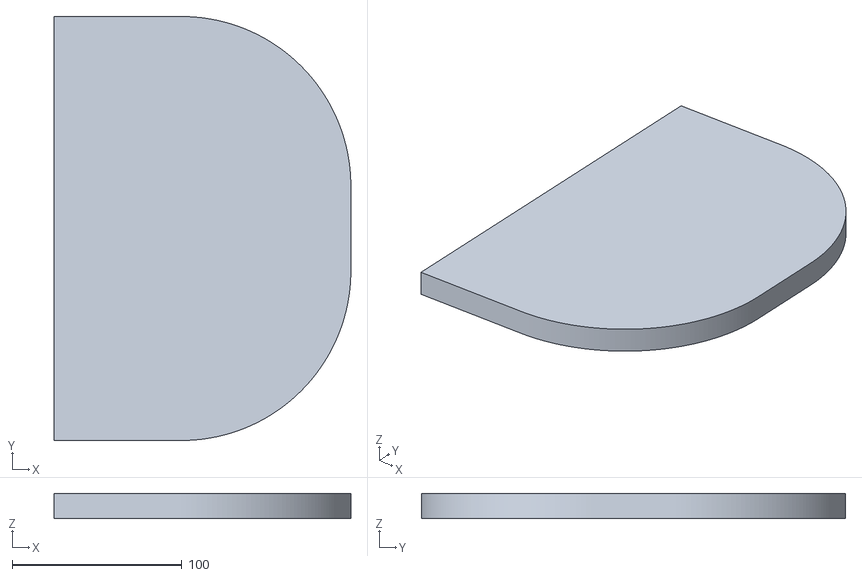
[picture p200: CAD file, 2026-11-13]
conception_echangeur/docs/formes/cylindre_radial/variante_e/socle.stl
175.0 x 250.0 x 15.0
