ET-FR/HP_new_generation/conception_echangeur/docs/formes/cylindre_radial/variante_f/imprime/secteur/tout_cont_lamelles_f05i.stl

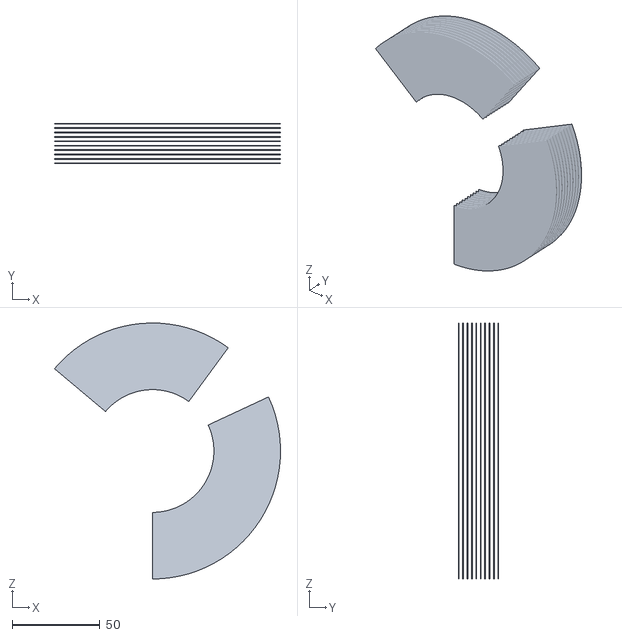
[picture p201: CAD file, 2026-11-13]
conception_echangeur/docs/formes/cylindre_radial/variante_f/imprime/secteur/tout_cont_lamelles_f05i.stl
128.9 x 23.0 x 146.0
