ET-FR/HP_new_generation/conception_echangeur/docs/formes/cylindre_radial/variante_f/tranche_socle.stl

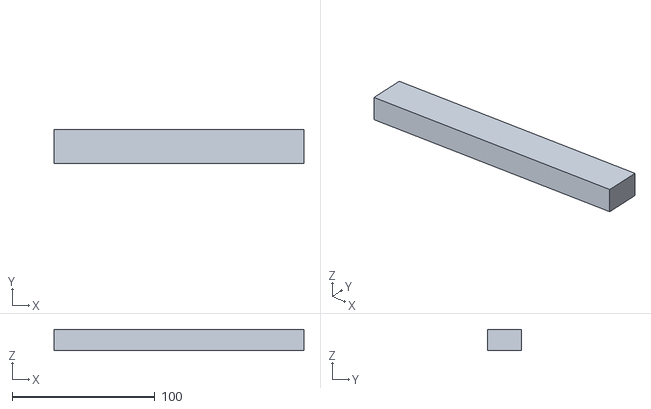
[picture p202: CAD file, 2026-11-13]
conception_echangeur/docs/formes/cylindre_radial/variante_f/tranche_socle.stl
175.0 x 24.0 x 15.0
