ET-FR/HP_new_generation/conception_echangeur/docs/formes/cylindre_radial/volute.stl

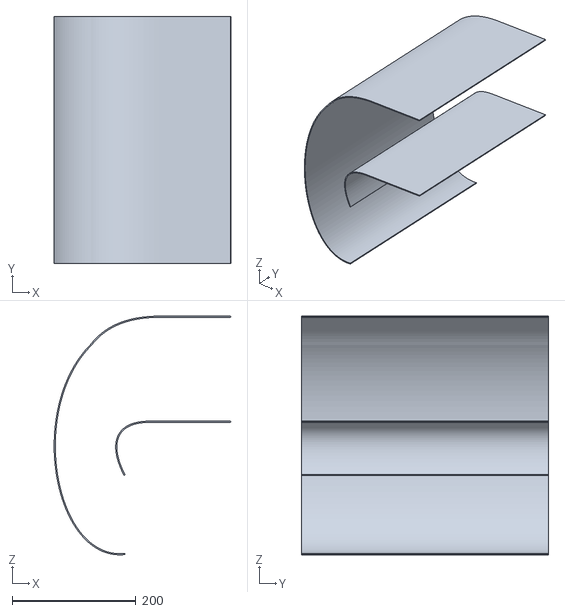
[picture p203: CAD file, 2026-11-13]
conception_echangeur/docs/formes/cylindre_radial/volute.stl
286.2 x 400.0 x 386.6
