ET-FR/HP_new_generation/conception_echangeur/docs/formes/helice/echangeur_helice.step

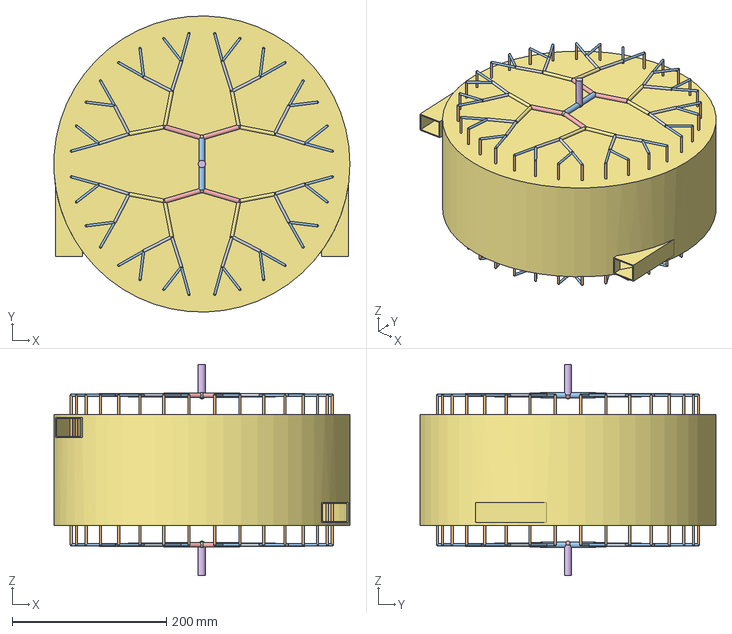
[picture p204: CAD file, 2026-11-11]
conception_echangeur/docs/formes/helice/echangeur_helice.step
383.7 x 383.8 x 274.0 mm
