ET-FR/HP_new_generation/conception_echangeur/docs/formes/cylindre_d100/arbre_sortie.stl

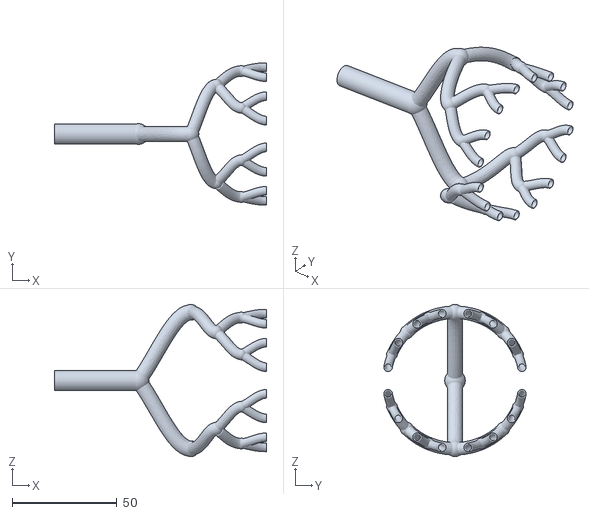
[picture p205: CAD file, 2026-11-13]
conception_echangeur/docs/formes/cylindre_d100/arbre_sortie.stl
101.0 x 67.9 x 72.6
