ET-FR/HP_new_generation/conception_echangeur/docs/formes/cylindre_d150_helice/cfd/tubes.stl

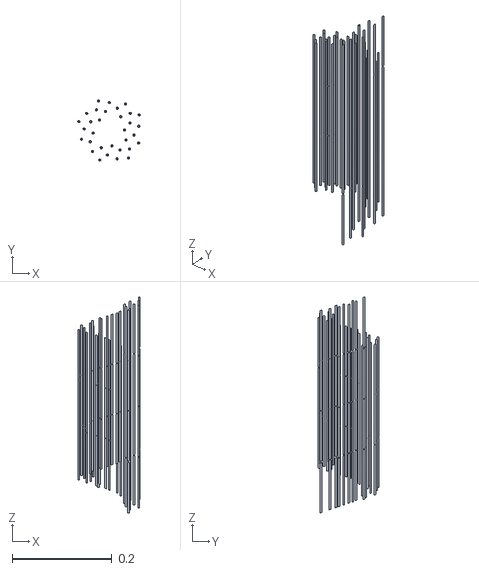
[picture p206: CAD file, 2026-11-13]
conception_echangeur/docs/formes/cylindre_d150_helice/cfd/tubes.stl
0.125 x 0.122 x 0.434
