ET-FR/HP_new_generation/conception_echangeur/docs/formes/cylindre_d150_helice/noyau.stl

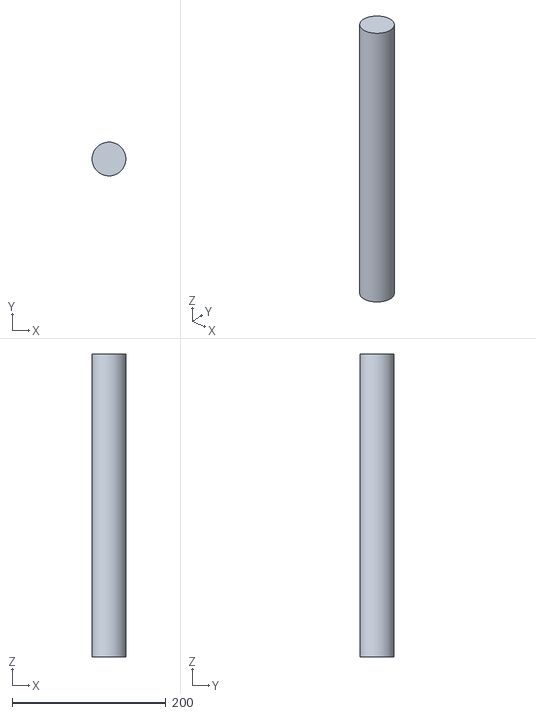
[picture p207: CAD file, 2026-11-13]
conception_echangeur/docs/formes/cylindre_d150_helice/noyau.stl
44.0 x 44.0 x 394.0
