ET-FR/HP_new_generation/conception_echangeur/docs/formes/cylindre_d150_helice/v1_conduits_droits/cfd/ailette.stl

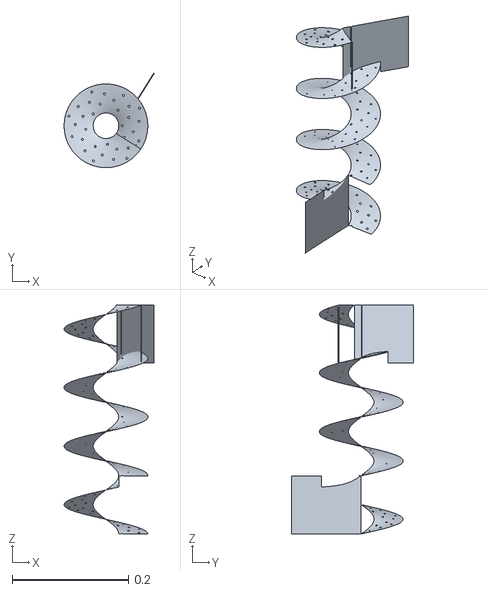
[picture p208: CAD file, 2026-11-13]
conception_echangeur/docs/formes/cylindre_d150_helice/v1_conduits_droits/cfd/ailette.stl
0.154 x 0.21 x 0.394
