ET-FR/HP_new_generation/conception_echangeur/docs/formes/cylindre_radial/flasques.stl

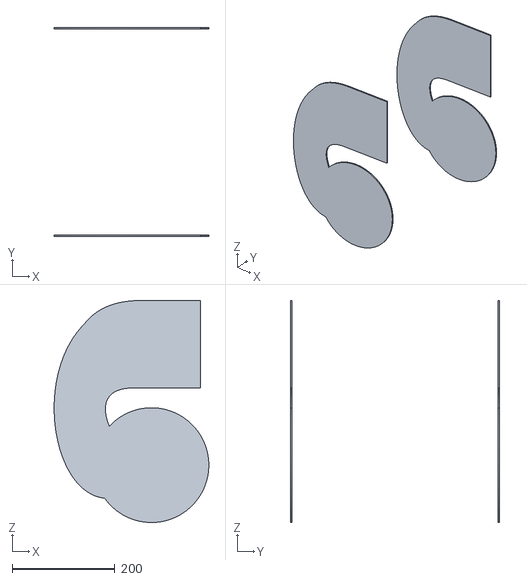
[picture p209: CAD file, 2026-11-13]
conception_echangeur/docs/formes/cylindre_radial/flasques.stl
300.7 x 406.0 x 431.5
