ET-FR/HP_new_generation/conception_echangeur/docs/formes/cylindre_radial/variante_f/imprime/imp_sans_lamelles_web.stl

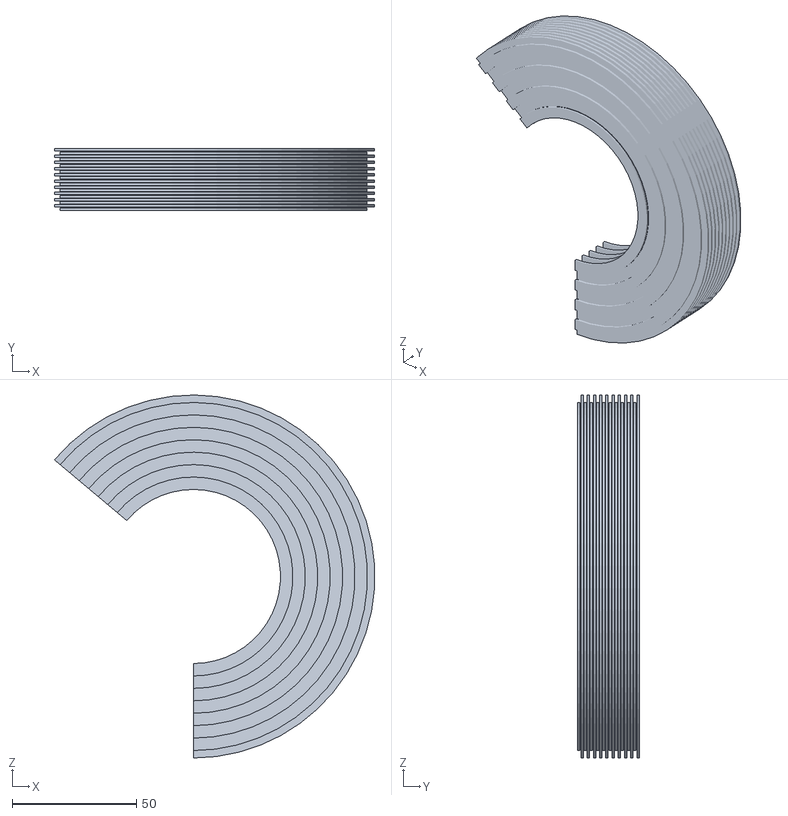
[picture p210: CAD file, 2026-11-13]
conception_echangeur/docs/formes/cylindre_radial/variante_f/imprime/imp_sans_lamelles_web.stl
128.8 x 24.8 x 146.0
