ET-FR/HP_new_generation/conception_echangeur/docs/formes/cylindre_radial/variante_f/imprime/secteur/tout_rad_lamelles_f05.stl

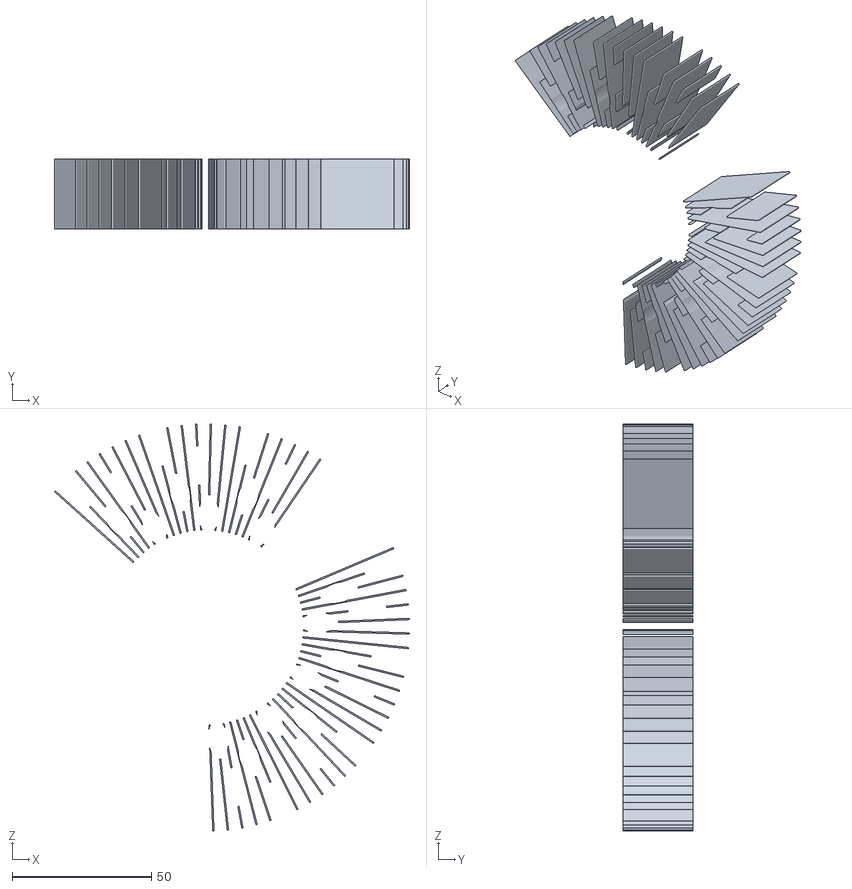
[picture p211: CAD file, 2026-11-13]
conception_echangeur/docs/formes/cylindre_radial/variante_f/imprime/secteur/tout_rad_lamelles_f05.stl
127.3 x 25.0 x 145.9
