ET-FR/HP_new_generation/conception_echangeur/docs/formes/cylindre_radial/variante_f/plaque.stl

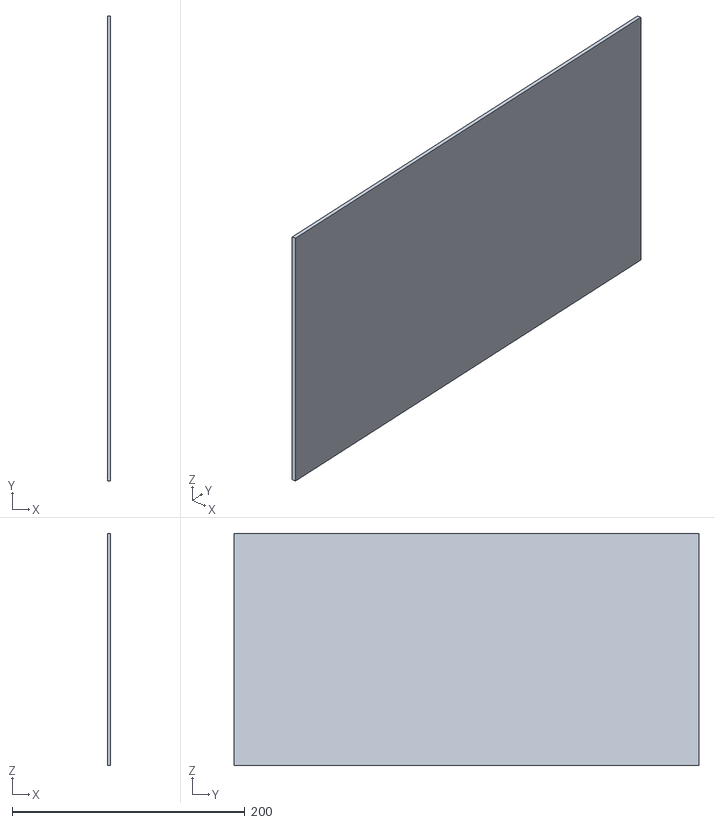
[picture p212: CAD file, 2026-11-13]
conception_echangeur/docs/formes/cylindre_radial/variante_f/plaque.stl
3.00 x 400.0 x 200.0
