ET-FR/HP_new_generation/conception_echangeur/docs/formes/helice/ailette.stl

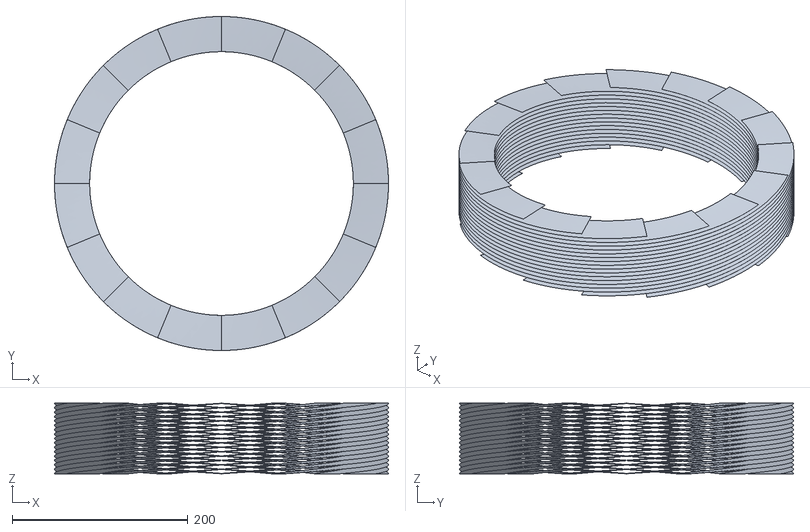
[picture p213: CAD file, 2026-11-11]
conception_echangeur/docs/formes/helice/ailette.stl
380.0 x 380.0 x 80.4
