ET-FR/HP_new_generation/conception_echangeur/docs/formes/cylindre_radial/filtre.stl

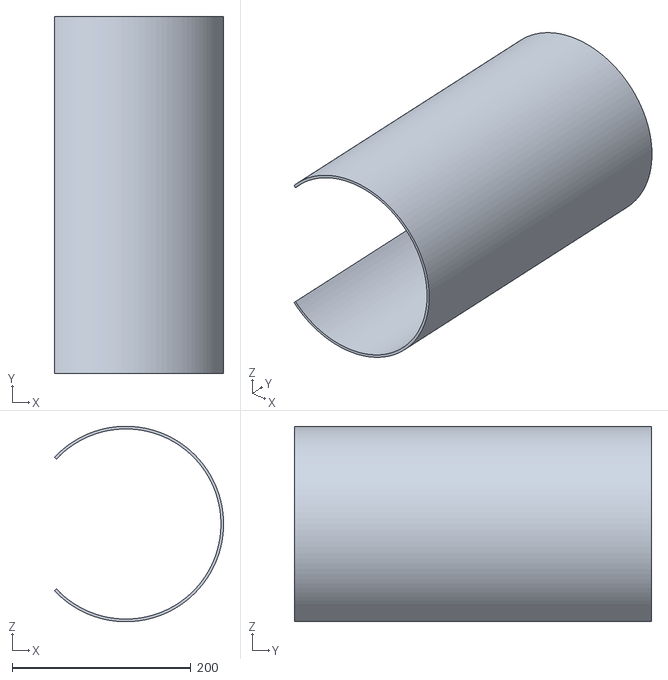
[picture p214: CAD file, 2026-11-13]
conception_echangeur/docs/formes/cylindre_radial/filtre.stl
189.6 x 400.0 x 219.0
