ET-FR/HP_new_generation/conception_echangeur/docs/formes/cylindre_radial/variante_e/filtre.stl

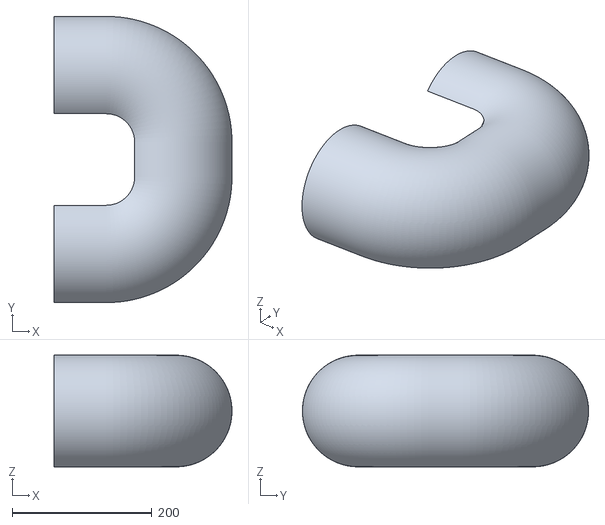
[picture p215: CAD file, 2026-11-13]
conception_echangeur/docs/formes/cylindre_radial/variante_e/filtre.stl
255.0 x 410.0 x 160.0
