ET-FR/HP_new_generation/conception_echangeur/docs/formes/cylindre_radial/variante_f/imprime/imp_sans_profils.stl

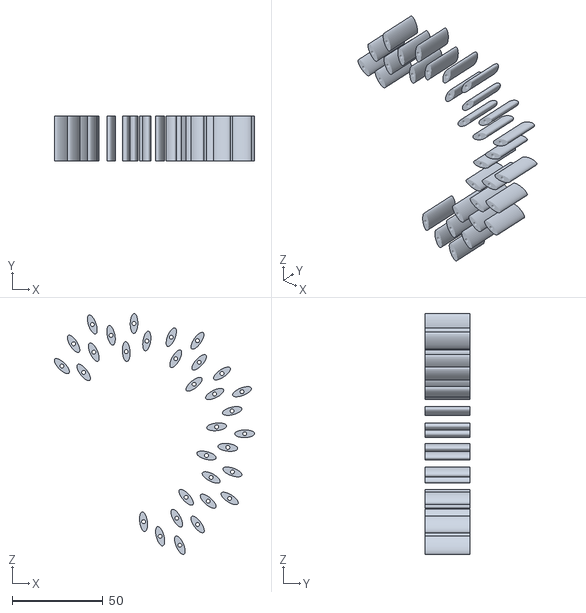
[picture p216: CAD file, 2026-11-13]
conception_echangeur/docs/formes/cylindre_radial/variante_f/imprime/imp_sans_profils.stl
110.2 x 25.0 x 132.5
