ET-FR/HP_new_generation/conception_echangeur/docs/formes/cylindre_radial/variante_f/imprime/secteur/tout_profils_f05i.stl

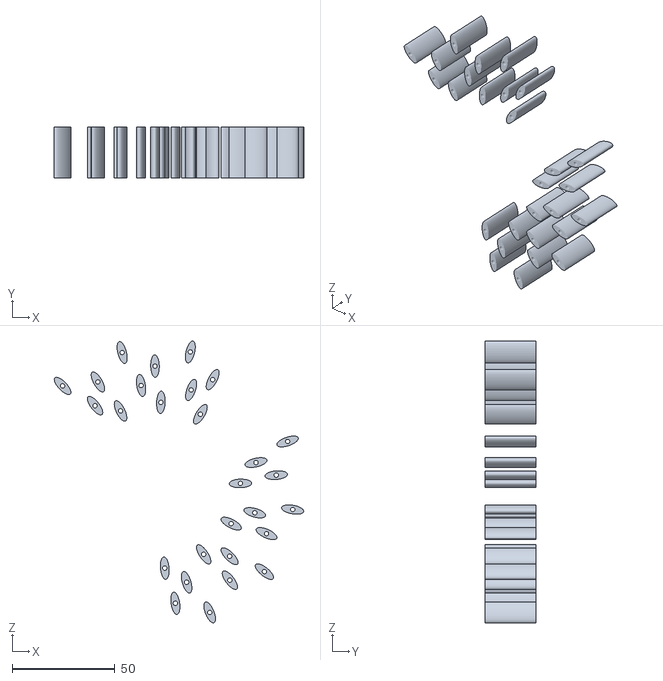
[picture p217: CAD file, 2026-11-13]
conception_echangeur/docs/formes/cylindre_radial/variante_f/imprime/secteur/tout_profils_f05i.stl
121.7 x 25.0 x 137.5
