ET-FR/HP_new_generation/conception_echangeur/docs/formes/cylindre_radial/variante_f/plenum.stl

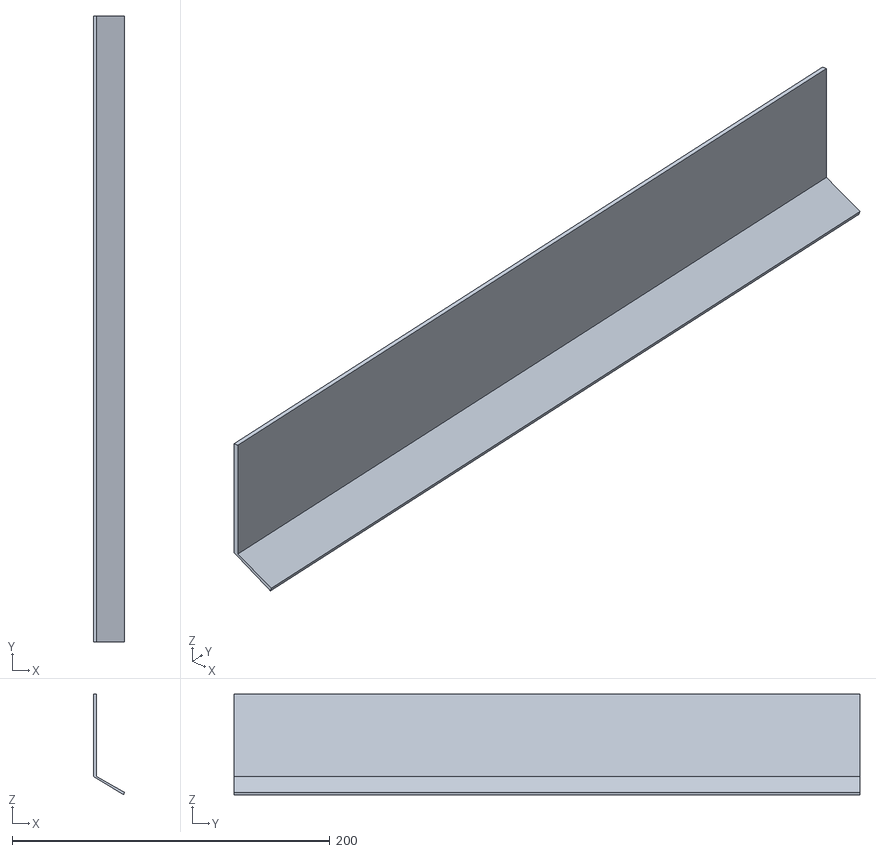
[picture p218: CAD file, 2026-11-13]
conception_echangeur/docs/formes/cylindre_radial/variante_f/plenum.stl
19.5 x 394.0 x 63.3
