ET-FR/HP_new_generation/conception_echangeur/docs/formes/cylindre_radial/galette.stl

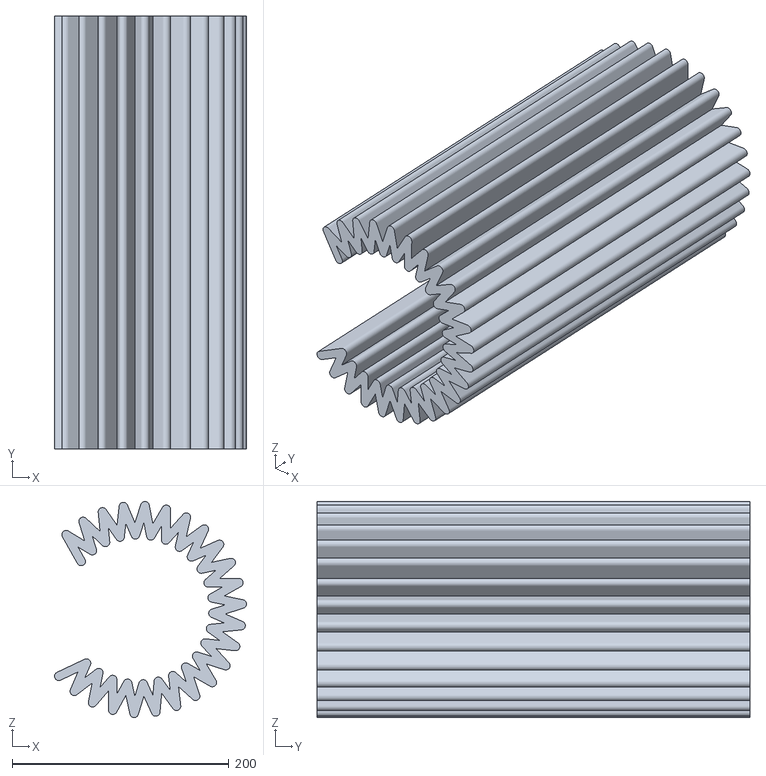
[picture p219: CAD file, 2026-11-13]
conception_echangeur/docs/formes/cylindre_radial/galette.stl
177.4 x 400.0 x 199.7
