ET-FR/HP_new_generation/conception_echangeur/docs/formes/cylindre_radial/variante_e/plaque.stl

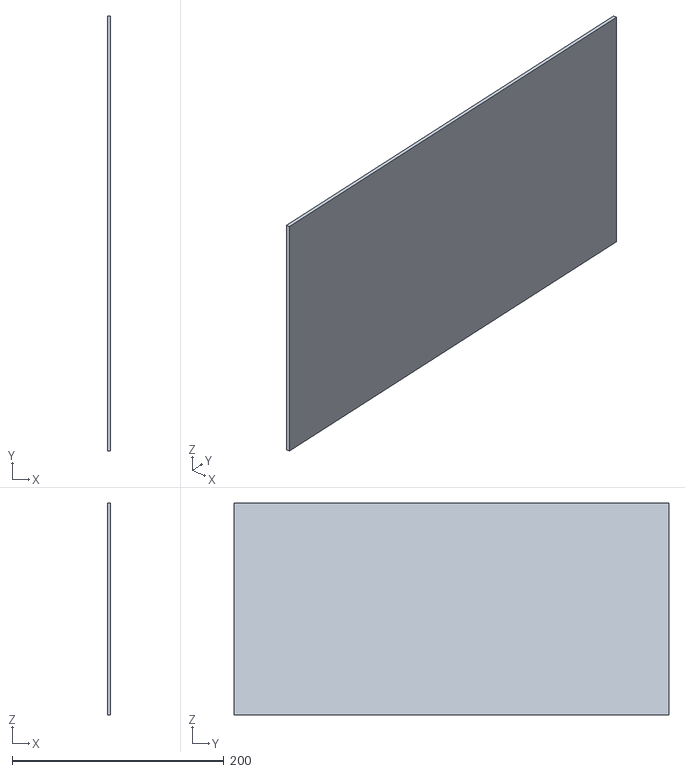
[picture p220: CAD file, 2026-11-13]
conception_echangeur/docs/formes/cylindre_radial/variante_e/plaque.stl
3.00 x 410.0 x 200.0
