ET-FR/HP_new_generation/conception_echangeur/docs/formes/cylindre_radial/variante_f/plis_plenum.stl

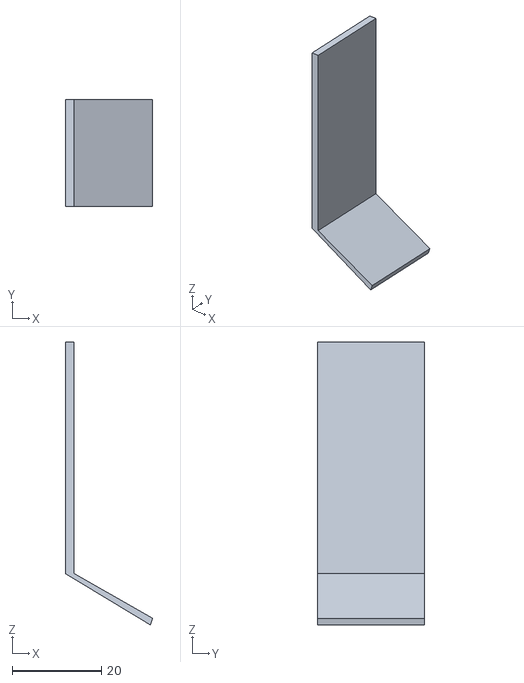
[picture p221: CAD file, 2026-11-13]
conception_echangeur/docs/formes/cylindre_radial/variante_f/plis_plenum.stl
19.5 x 24.0 x 63.3
