ET-FR/HP_new_generation/conception_echangeur/docs/formes/helice/noyau.stl

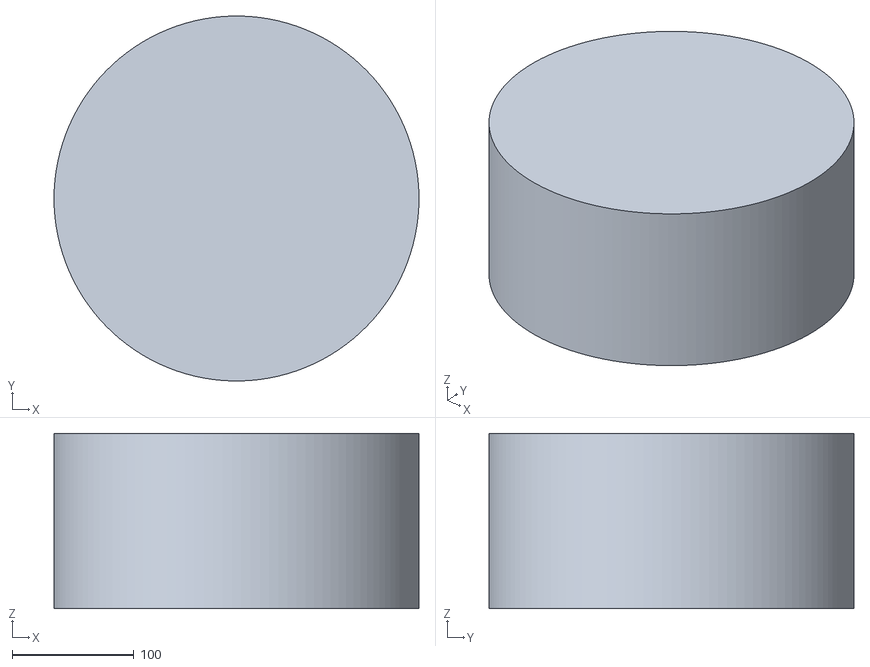
[picture p222: CAD file, 2026-11-11]
conception_echangeur/docs/formes/helice/noyau.stl
300.0 x 299.9 x 144.0
