ET-FR/HP_new_generation/conception_echangeur/docs/formes/cylindre_radial/variante_e/volet.stl

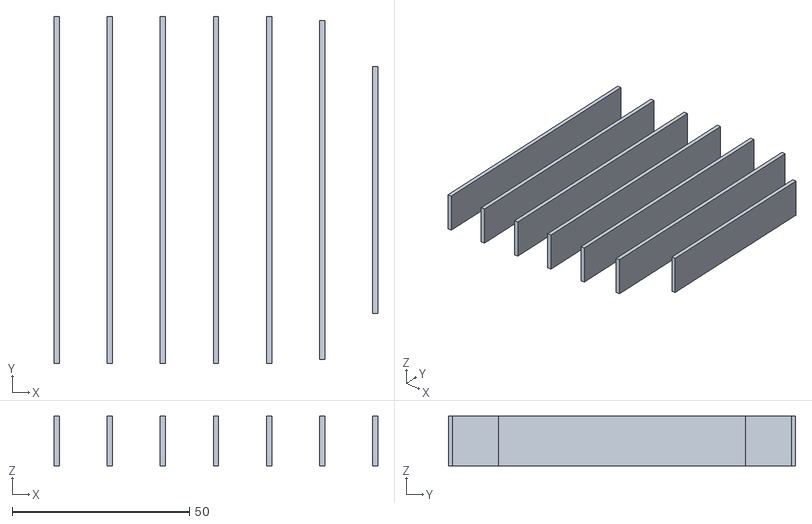
[picture p223: CAD file, 2026-11-13]
conception_echangeur/docs/formes/cylindre_radial/variante_e/volet.stl
91.5 x 98.0 x 14.0
