ET-FR/HP_new_generation/conception_echangeur/docs/formes/cylindre_radial/variante_f/imprime/imp_avec_propane.stl

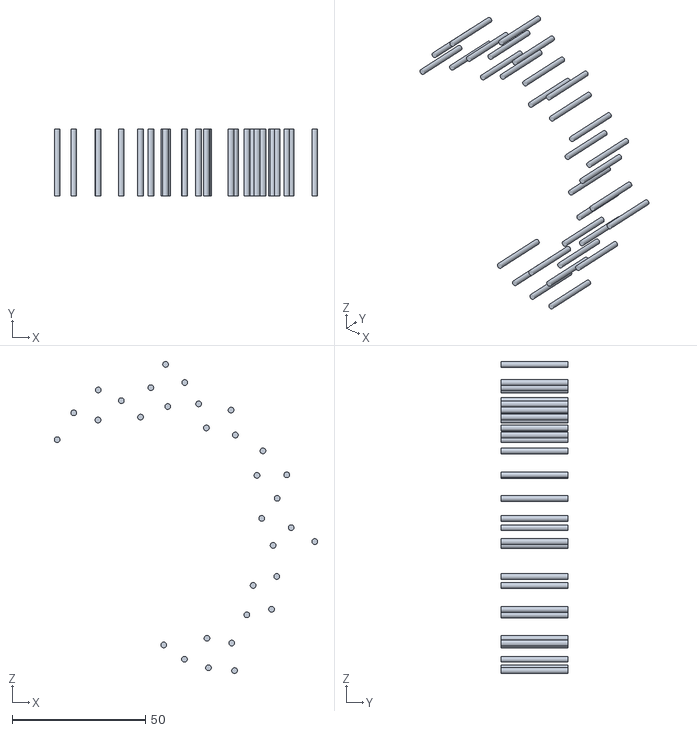
[picture p224: CAD file, 2026-11-13]
conception_echangeur/docs/formes/cylindre_radial/variante_f/imprime/imp_avec_propane.stl
98.9 x 25.0 x 117.1
