ET-FR/HP_new_generation/conception_echangeur/docs/formes/cylindre_radial/variante_f/imprime/secteur/sect_canaux_f05s.stl

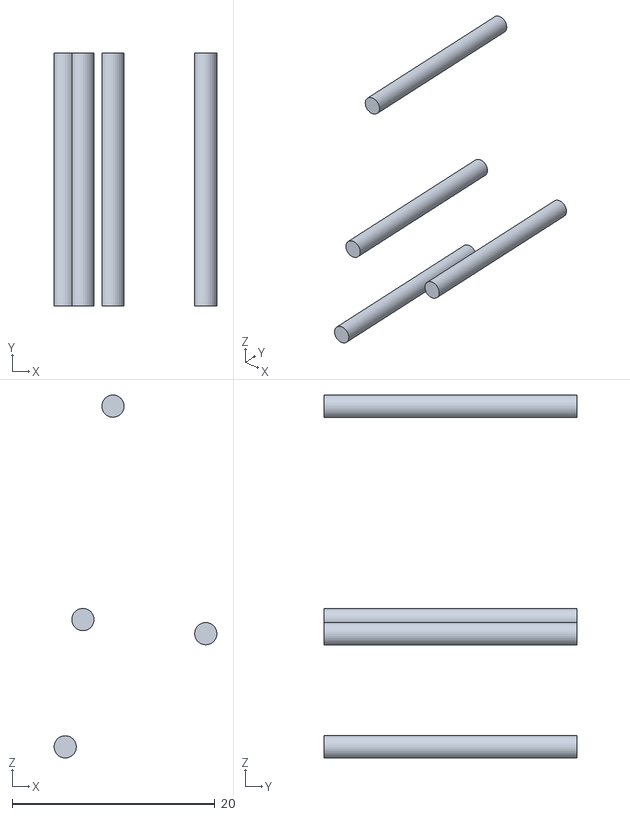
[picture p225: CAD file, 2026-11-13]
conception_echangeur/docs/formes/cylindre_radial/variante_f/imprime/secteur/sect_canaux_f05s.stl
16.1 x 25.0 x 35.8
