ET-FR/HP_new_generation/conception_echangeur/docs/formes/cylindre_radial/variante_f/ventilateurs.stl

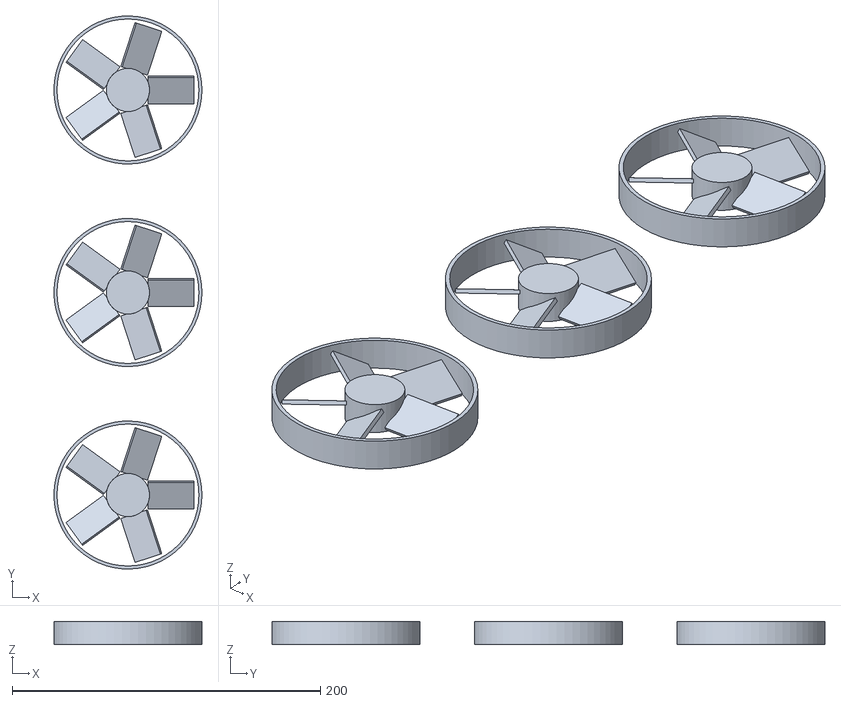
[picture p226: CAD file, 2026-11-13]
conception_echangeur/docs/formes/cylindre_radial/variante_f/ventilateurs.stl
95.9 x 358.6 x 15.0
