ET-FR/HP_new_generation/conception_echangeur/docs/formes/cylindre_radial/variante_e/ventilateur.stl

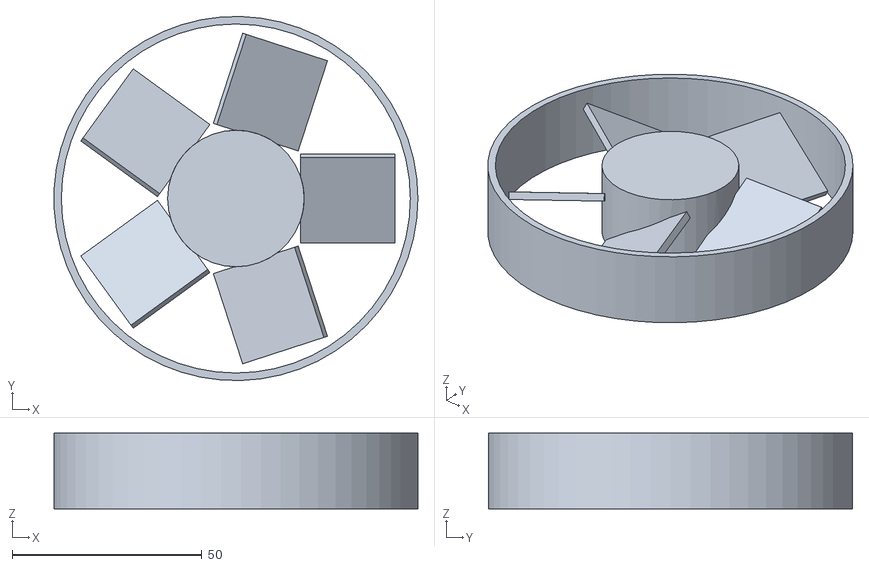
[picture p227: CAD file, 2026-11-13]
conception_echangeur/docs/formes/cylindre_radial/variante_e/ventilateur.stl
95.9 x 96.0 x 20.0
