ET-FR/HP_new_generation/conception_echangeur/docs/formes/cylindre_radial/variante_f/flasques.stl

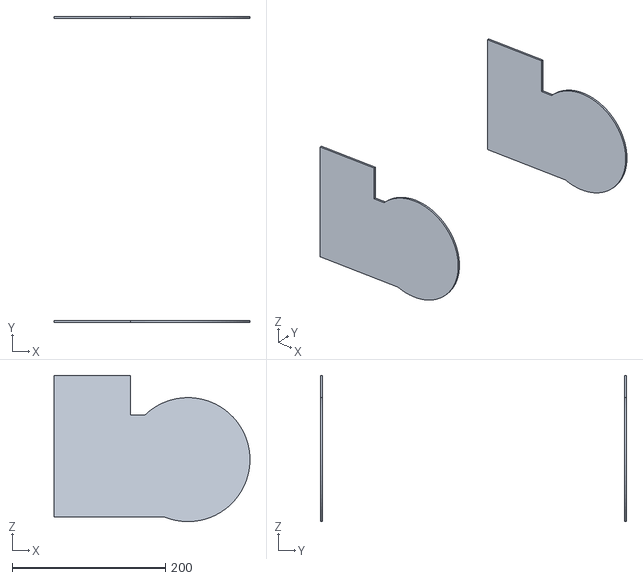
[picture p228: CAD file, 2026-11-13]
conception_echangeur/docs/formes/cylindre_radial/variante_f/flasques.stl
256.0 x 400.0 x 190.9
