ET-FR/HP_new_generation/conception_echangeur/docs/formes/cylindre_radial/variante_f/imprime/secteur/sect_canaux_f05.stl

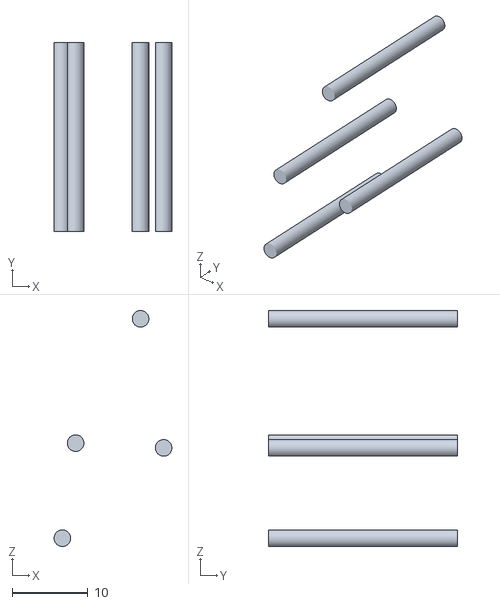
[picture p230: CAD file, 2026-11-13]
conception_echangeur/docs/formes/cylindre_radial/variante_f/imprime/secteur/sect_canaux_f05.stl
15.6 x 25.0 x 31.2
