ET-FR/HP_new_generation/conception_echangeur/docs/formes/cylindre_radial/variante_f/plis_tubes.stl

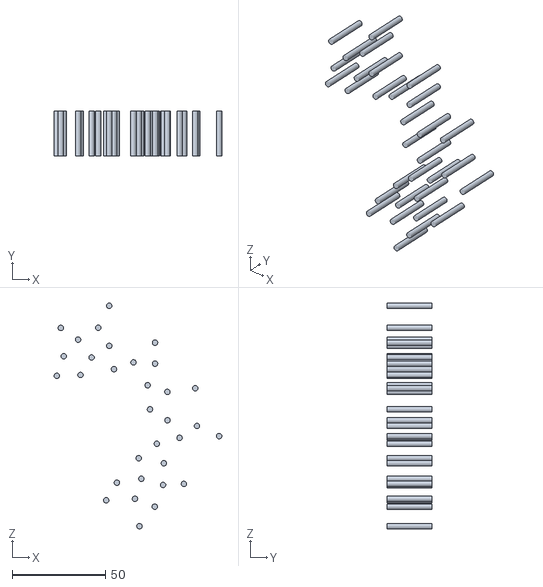
[picture p231: CAD file, 2026-11-13]
conception_echangeur/docs/formes/cylindre_radial/variante_f/plis_tubes.stl
90.2 x 24.0 x 121.4
