ET-FR/HP_new_generation/conception_echangeur/docs/formes/cylindre_radial/variante_f/imprime/secteur/tout_rad_profils_f05s.stl

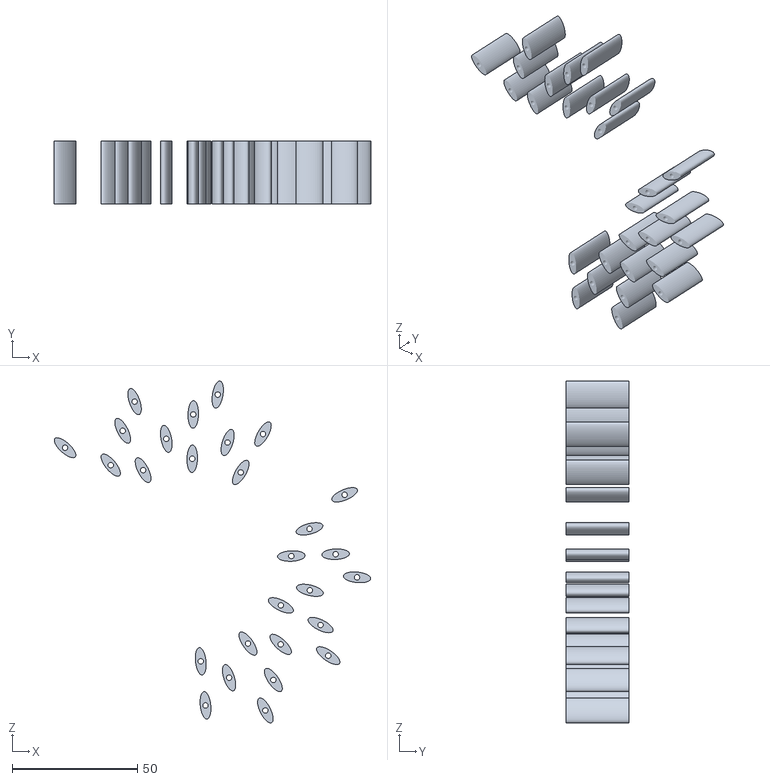
[picture p232: CAD file, 2026-11-13]
conception_echangeur/docs/formes/cylindre_radial/variante_f/imprime/secteur/tout_rad_profils_f05s.stl
126.2 x 25.0 x 136.4
