ET-FR/HP_new_generation/conception_echangeur/docs/formes/cylindre_radial/variante_f/tubes_web.stl

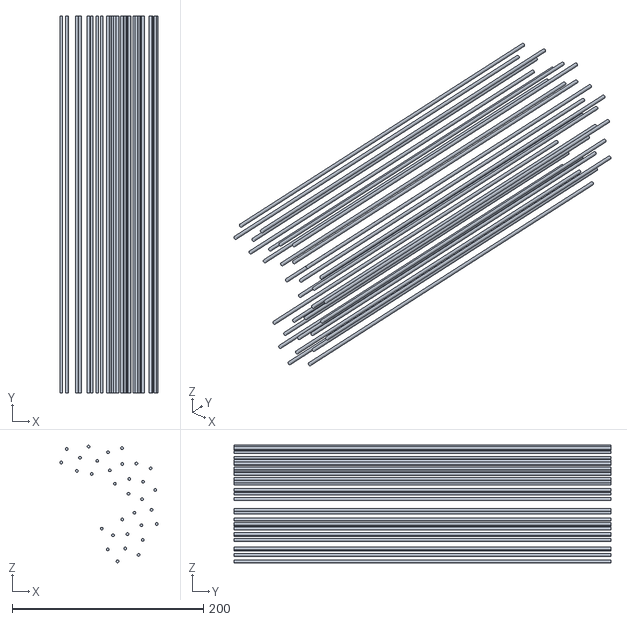
[picture p233: CAD file, 2026-11-13]
conception_echangeur/docs/formes/cylindre_radial/variante_f/tubes_web.stl
102.7 x 394.0 x 123.0
