ET-FR/HP_new_generation/conception_echangeur/docs/formes/cylindre_radial/variante_f/plis_lamelles_web.stl

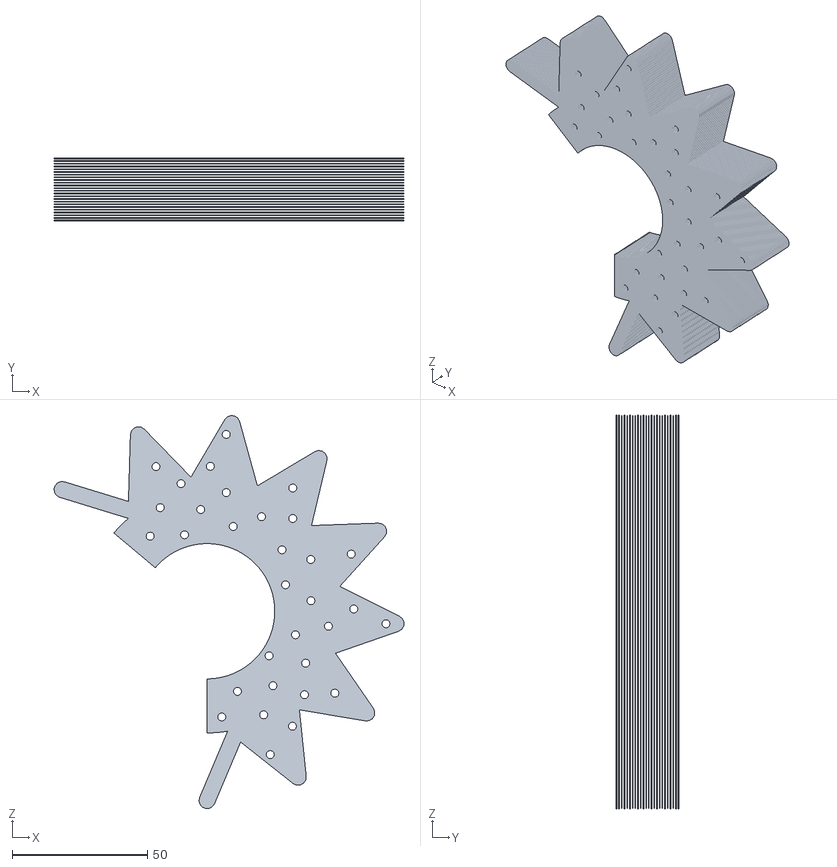
[picture p235: CAD file, 2026-11-13]
conception_echangeur/docs/formes/cylindre_radial/variante_f/plis_lamelles_web.stl
129.4 x 23.1 x 145.3
