ET-FR/HP_new_generation/conception_echangeur/docs/formes/cylindre_radial/variante_f/imprime/secteur/sect_lamelles_f05v.stl

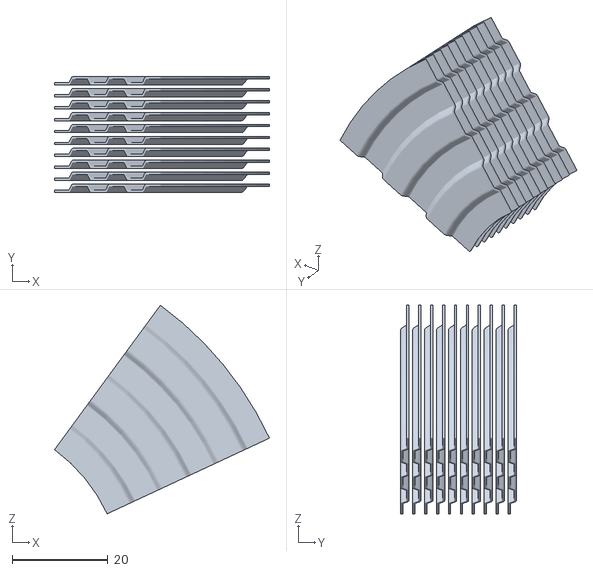
[picture p236: CAD file, 2026-11-13]
conception_echangeur/docs/formes/cylindre_radial/variante_f/imprime/secteur/sect_lamelles_f05v.stl
45.0 x 24.2 x 43.7
