ET-FR/HP_new_generation/conception_echangeur/docs/formes/cylindre_radial/variante_f/imprime/secteur/sect_rad_lamelles_f05v.stl

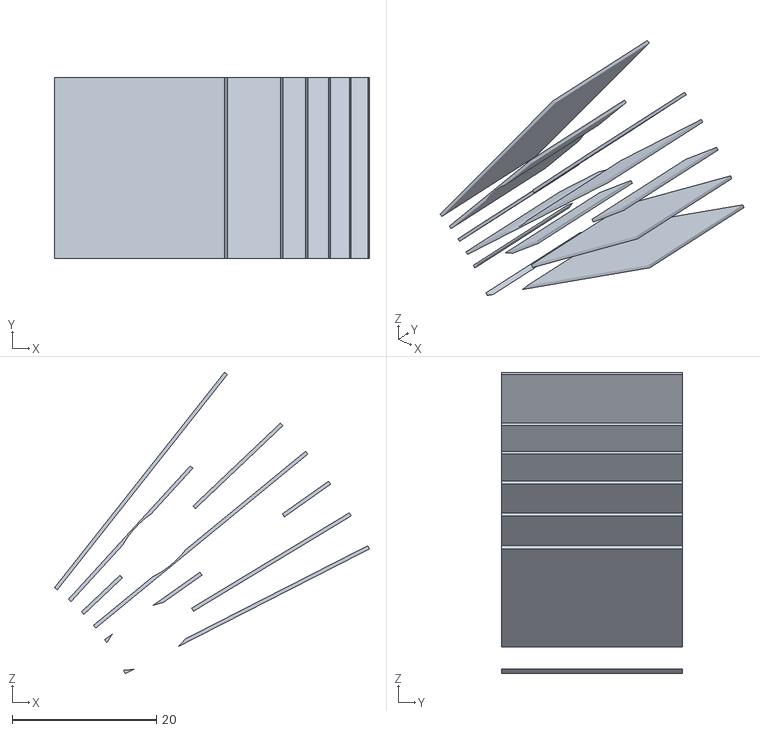
[picture p237: CAD file, 2026-11-13]
conception_echangeur/docs/formes/cylindre_radial/variante_f/imprime/secteur/sect_rad_lamelles_f05v.stl
43.6 x 25.0 x 41.7
