ET-FR/HP_new_generation/conception_echangeur/docs/formes/cylindre_radial/variante_f/tranche_lamelles_web.stl

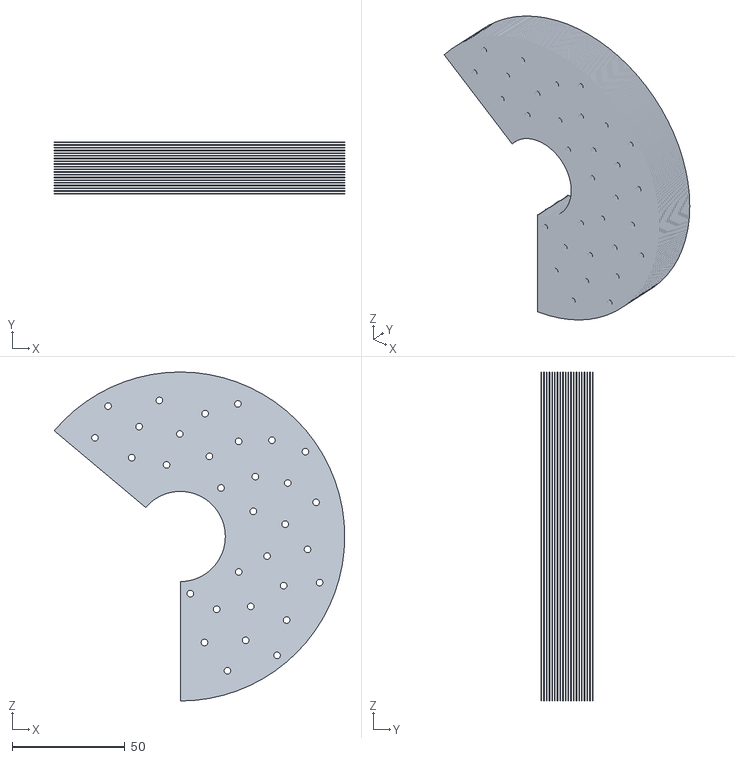
[picture p238: CAD file, 2026-11-13]
conception_echangeur/docs/formes/cylindre_radial/variante_f/tranche_lamelles_web.stl
128.9 x 22.9 x 146.0
