ET-FR/HP_new_generation/conception_echangeur/docs/formes/cylindre_radial/variante_f/imprime/secteur/tout_lamelles_f05i.stl

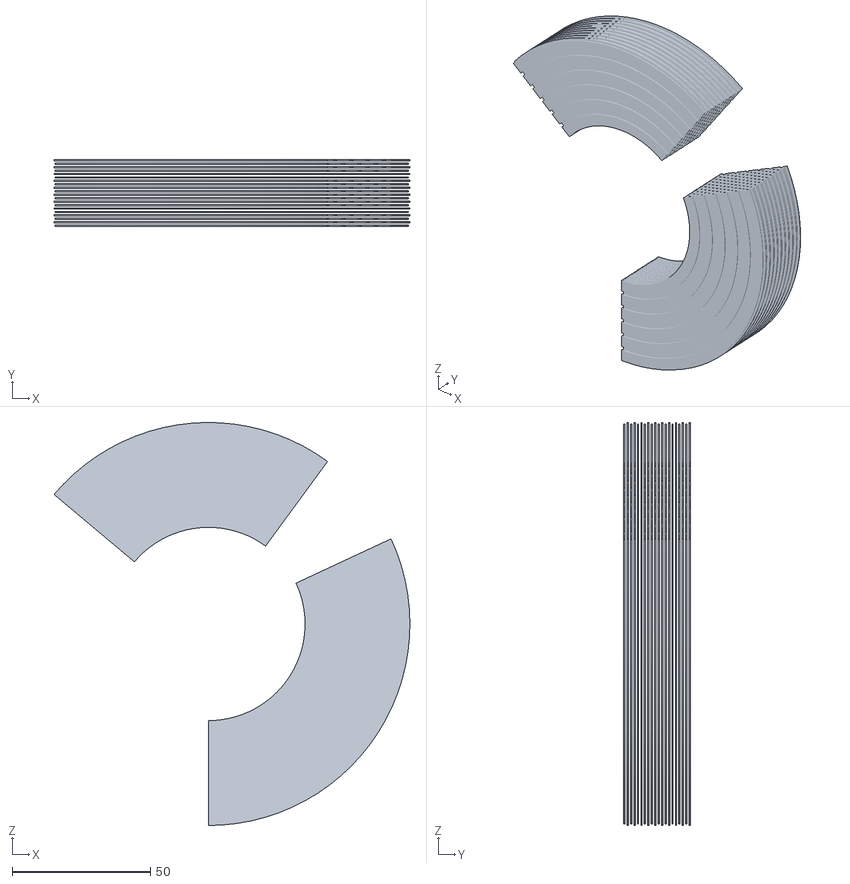
[picture p239: CAD file, 2026-11-13]
conception_echangeur/docs/formes/cylindre_radial/variante_f/imprime/secteur/tout_lamelles_f05i.stl
128.9 x 24.3 x 146.0
