ET-FR/HP_new_generation/conception_echangeur/docs/formes/cylindre_radial/variante_f/tranche_tubes.stl

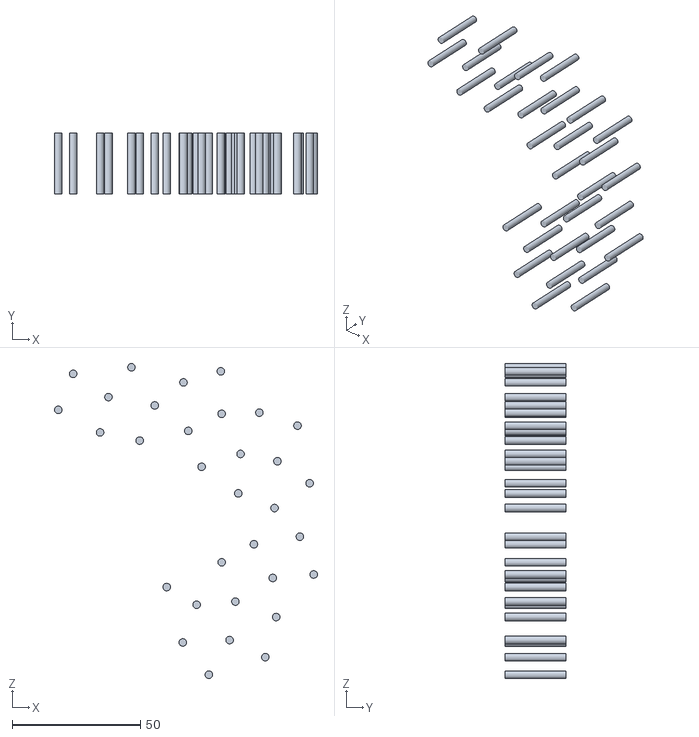
[picture p240: CAD file, 2026-11-13]
conception_echangeur/docs/formes/cylindre_radial/variante_f/tranche_tubes.stl
102.7 x 24.0 x 123.0
