ET-FR/HP_new_generation/conception_echangeur/docs/formes/cylindre_radial/variante_f/filtre.stl

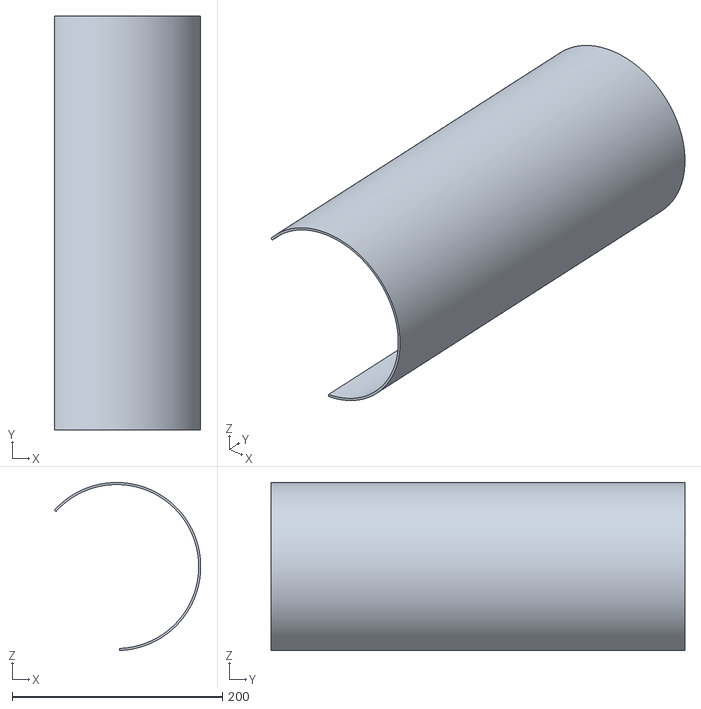
[picture p241: CAD file, 2026-11-13]
conception_echangeur/docs/formes/cylindre_radial/variante_f/filtre.stl
139.5 x 394.0 x 160.0
