ET-FR/HP_new_generation/conception_echangeur/docs/formes/cylindre_radial/variante_f/volet.stl

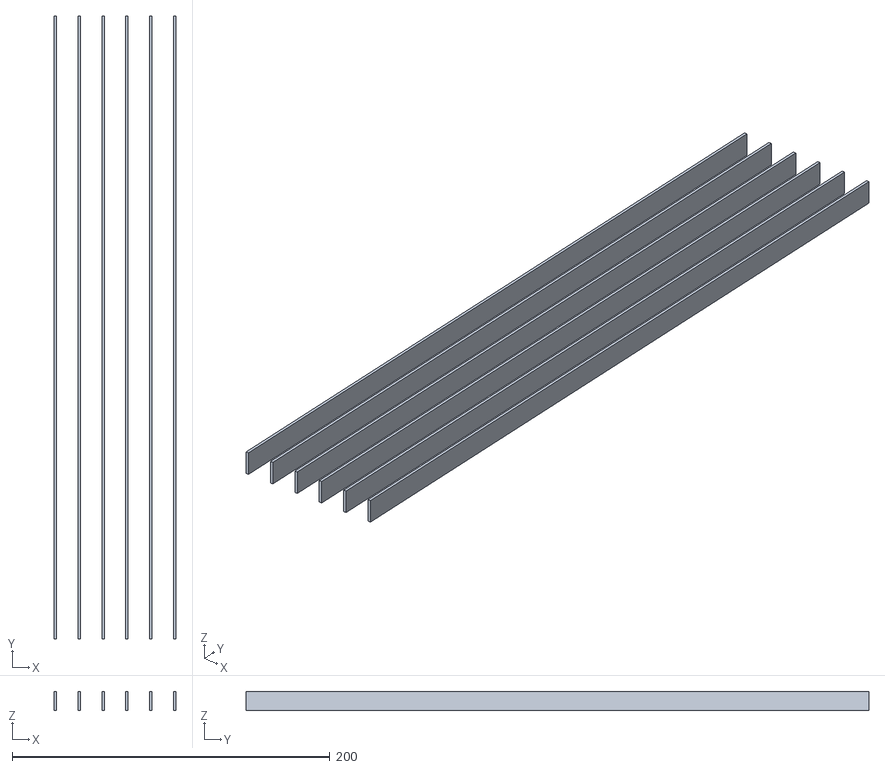
[picture p242: CAD file, 2026-11-13]
conception_echangeur/docs/formes/cylindre_radial/variante_f/volet.stl
76.5 x 392.0 x 12.0
