ET-FR/HP_new_generation/conception_echangeur/docs/formes/cylindre_radial/variante_f/imprime/secteur/sect_cont_lamelles_f05v.stl

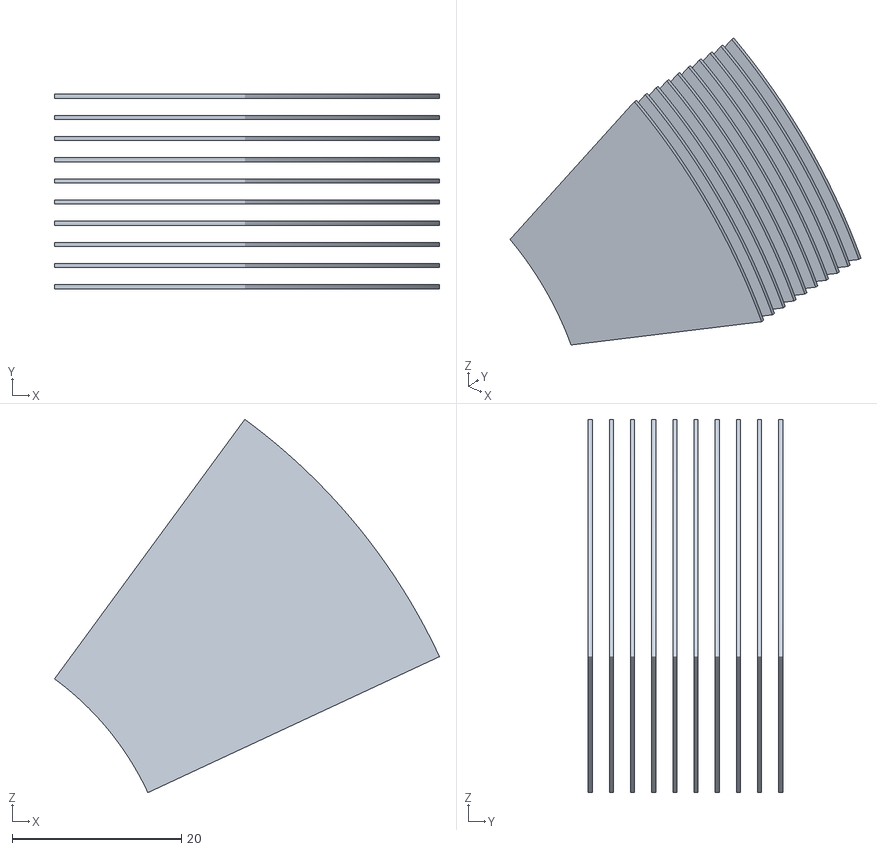
[picture p243: CAD file, 2026-11-13]
conception_echangeur/docs/formes/cylindre_radial/variante_f/imprime/secteur/sect_cont_lamelles_f05v.stl
45.5 x 23.0 x 44.1
