ET-FR/HP_new_generation/conception_echangeur/docs/formes/cylindre_radial/variante_f/socle.stl

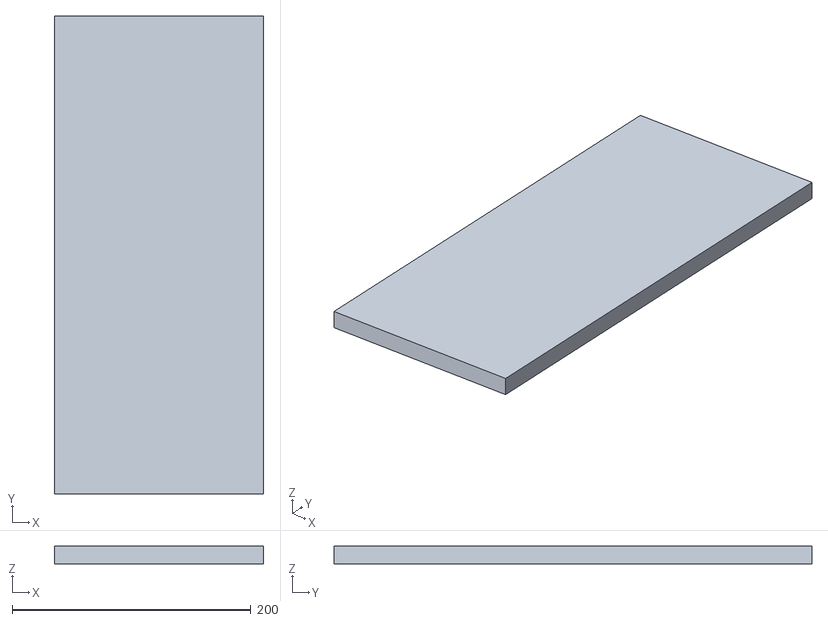
[picture p244: CAD file, 2026-11-13]
conception_echangeur/docs/formes/cylindre_radial/variante_f/socle.stl
175.0 x 400.0 x 15.0
