ET-FR/HP_new_generation/conception_echangeur/docs/formes/cylindre_radial/variante_f/variante_f.step

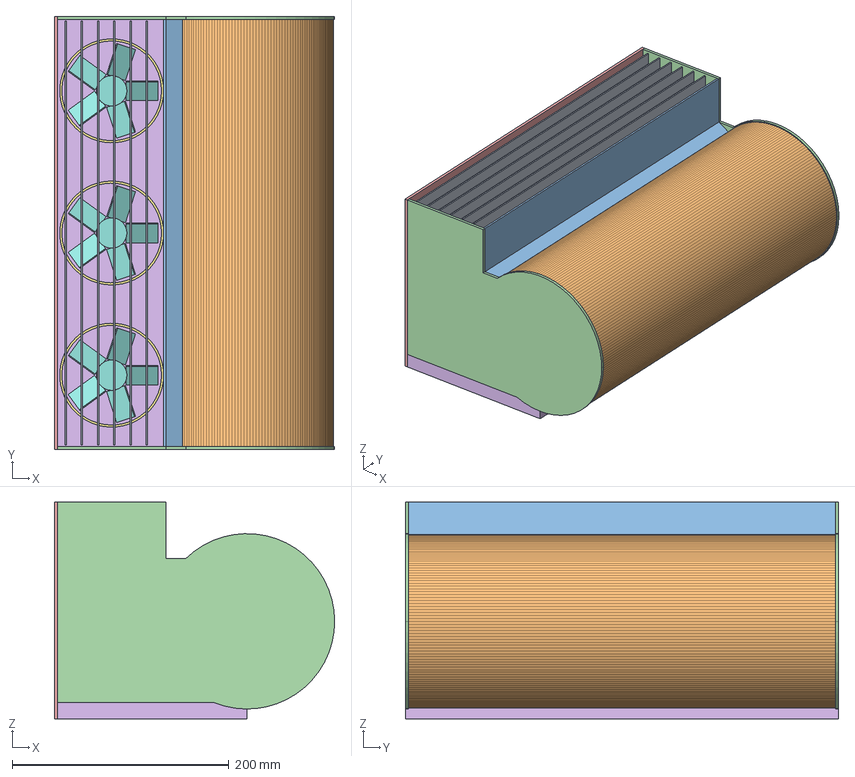
[picture p247: CAD file, 2026-11-13]
conception_echangeur/docs/formes/cylindre_radial/variante_f/variante_f.step
259.0 x 400.0 x 200.0 mm
