ET-FR/HP_new_generation/conception_echangeur/docs/formes/cylindre_radial/variante_f/imprime/secteur/sect_rad_canaux_f05v.stl

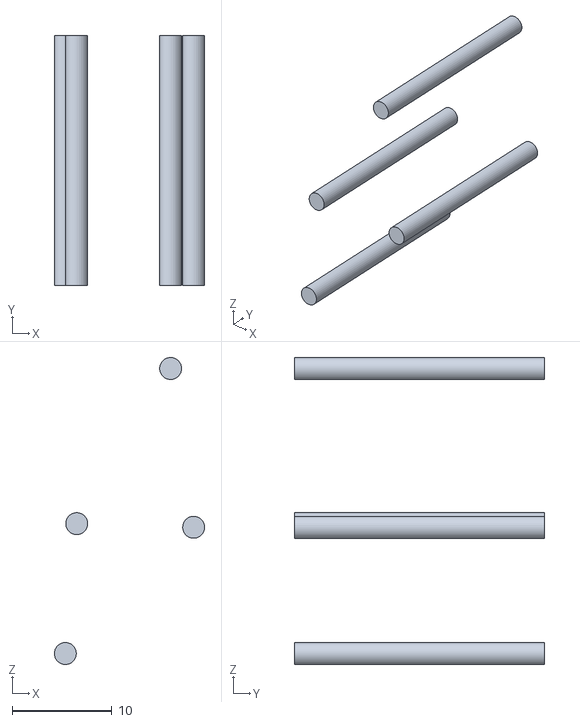
[picture p248: CAD file, 2026-11-13]
conception_echangeur/docs/formes/cylindre_radial/variante_f/imprime/secteur/sect_rad_canaux_f05v.stl
15.0 x 25.0 x 30.7
