ET-FR/HP_new_generation/conception_echangeur/docs/formes/cylindre_radial/variante_f/imprime/secteur/tout_rad_lamelles_f05s.stl

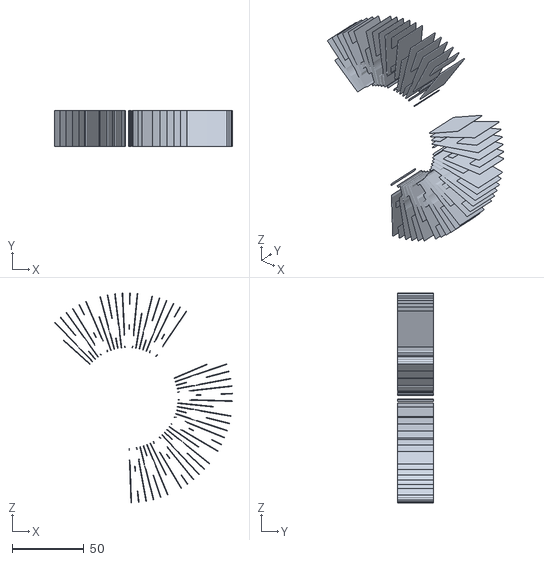
[picture p249: CAD file, 2026-11-13]
conception_echangeur/docs/formes/cylindre_radial/variante_f/imprime/secteur/tout_rad_lamelles_f05s.stl
123.7 x 25.0 x 145.9
