ET-FR/HP_new_generation/conception_echangeur/docs/formes/cylindre_radial/variante_f/imprime/secteur/sect_rad_profils_f05v.stl

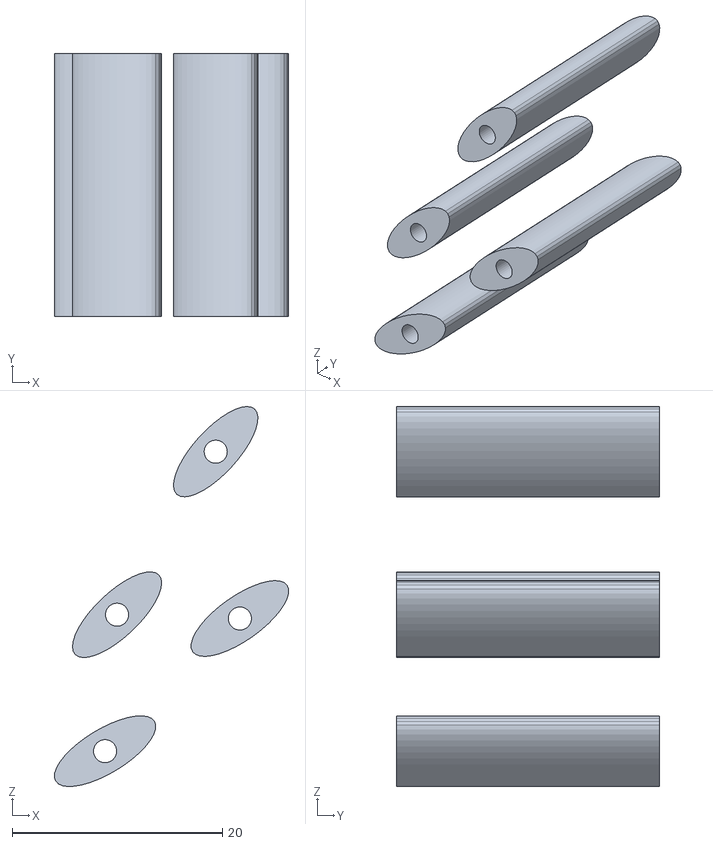
[picture p250: CAD file, 2026-11-13]
conception_echangeur/docs/formes/cylindre_radial/variante_f/imprime/secteur/sect_rad_profils_f05v.stl
22.3 x 25.0 x 36.2
