ET-FR/HP_new_generation/conception_echangeur/docs/formes/cylindre_radial/variante_f/imprime/secteur/tout_lamelles_f05s.stl

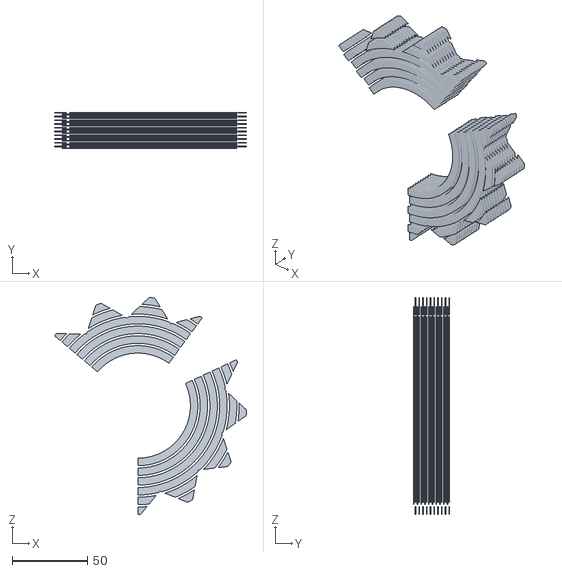
[picture p252: CAD file, 2026-11-13]
conception_echangeur/docs/formes/cylindre_radial/variante_f/imprime/secteur/tout_lamelles_f05s.stl
127.9 x 24.3 x 144.5
