ET-FR/HP_new_generation/conception_echangeur/docs/formes/cylindre_radial/variante_f/imprime/secteur/sect_rad_profils_f05s.stl

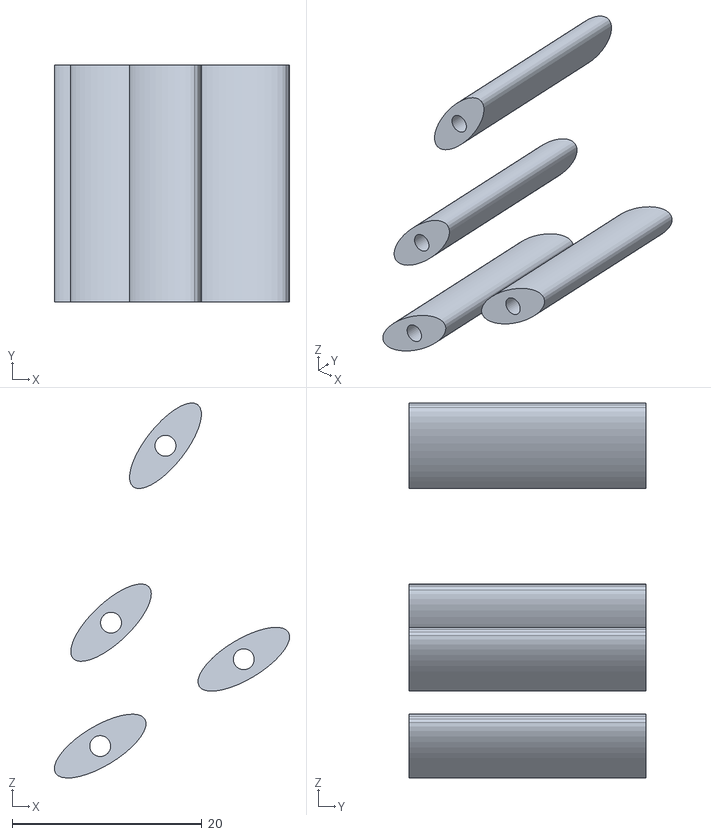
[picture p253: CAD file, 2026-11-13]
conception_echangeur/docs/formes/cylindre_radial/variante_f/imprime/secteur/sect_rad_profils_f05s.stl
24.8 x 25.0 x 39.5
