ET-FR/HP_new_generation/conception_echangeur/docs/formes/cylindre_radial/variante_f/imprime/secteur/sect_lamelles_f05s.stl

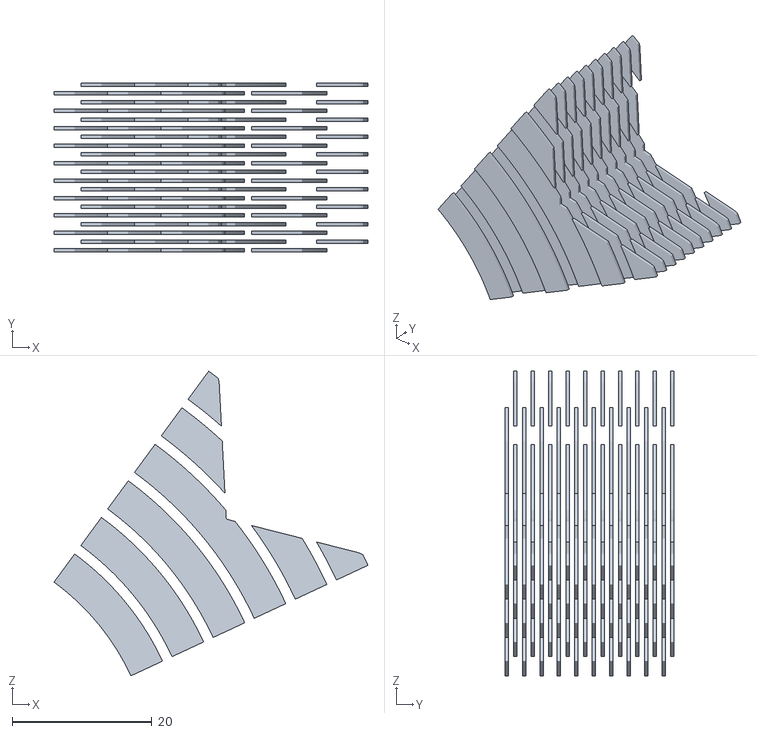
[picture p255: CAD file, 2026-11-13]
conception_echangeur/docs/formes/cylindre_radial/variante_f/imprime/secteur/sect_lamelles_f05s.stl
45.0 x 24.2 x 43.7
