ET-FR/HP_new_generation/conception_echangeur/docs/formes/cylindre_radial/variante_f/imprime/secteur/tout_lamelles_f05v.stl

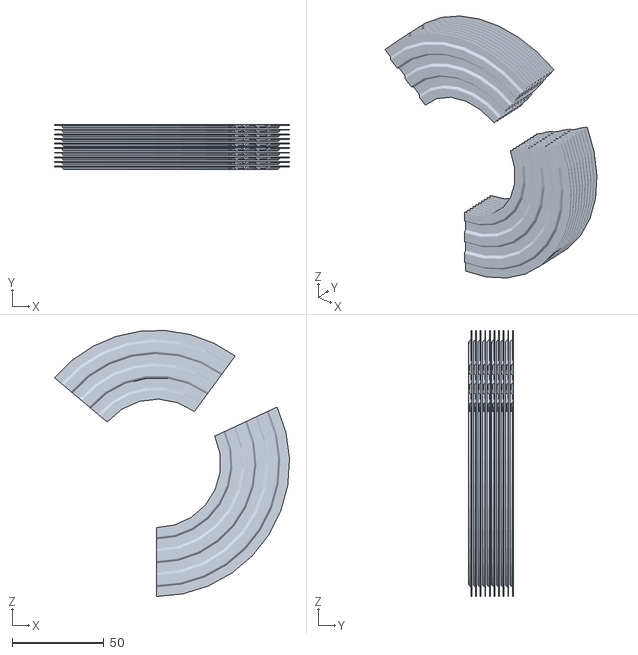
[picture p256: CAD file, 2026-11-13]
conception_echangeur/docs/formes/cylindre_radial/variante_f/imprime/secteur/tout_lamelles_f05v.stl
128.0 x 24.2 x 144.8
