ET-FR/HP_new_generation/(list of files, cad)

Other CAD files:
conception_echangeur/docs/formes/cylindre_radial/variante_f/imprime/cfd/domaine_avec_entree.stl
conception_echangeur/docs/formes/cylindre_radial/variante_f/imprime/cfd/domaine_sans_sortie.stl
conception_echangeur/docs/formes/cylindre_radial/variante_f/imprime/concept_imprime.step
conception_echangeur/docs/formes/cylindre_d150_helice/cfd/sortie.stl
conception_echangeur/docs/formes/cylindre_d150_helice/v1_conduits_droits/cfd/entree.stl
conception_echangeur/docs/formes/cylindre_d100_t32/enveloppe.stl
conception_echangeur/docs/formes/cylindre_radial/variante_e/tubes.stl
conception_echangeur/docs/formes/cylindre_d100/arbre_entree.stl
conception_echangeur/docs/formes/cylindre_d100_t32/arbre_sortie.stl
conception_echangeur/docs/formes/helice/arbre_haut.stl
conception_echangeur/docs/formes/cylindre_radial/variante_f/imprime/imp_avec_profils.stl
conception_echangeur/docs/formes/cylindre_radial/variante_f/imprime/imp_sans_filtre.stl
conception_echangeur/docs/formes/cylindre_radial/variante_f/imprime/imp_sans_lamelles.stl
conception_echangeur/docs/formes/cylindre_radial/variante_f/plis_lamelles.stl
conception_echangeur/docs/formes/cylindre_radial/variante_f/imprime/secteur/tout_rad_profils_f05.stl
conception_echangeur/docs/formes/cylindre_radial/variante_f/imprime/secteur/tout_profils_f05s.stl
conception_echangeur/docs/formes/cylindre_radial/variante_f/tubes.stl
conception_echangeur/docs/formes/cylindre_radial/variante_f/imprime/secteur/tout_rad_profils_f05v.stl
conception_echangeur/docs/formes/cylindre_d100/echangeur_d100.FCStd
conception_echangeur/docs/formes/cylindre_d100_t32/echangeur_d100.FCStd
conception_echangeur/docs/formes/cylindre_d150_helice/domaine_air.stl
conception_echangeur/docs/formes/cylindre_d150_helice/echangeur_d150.FCStd
conception_echangeur/docs/formes/cylindre_d150_helice/v1_conduits_droits/domaine_air.stl
conception_echangeur/docs/formes/cylindre_d150_helice/v1_conduits_droits/echangeur_d150.FCStd
conception_echangeur/docs/formes/cylindre_radial/echangeur_radial.FCStd
conception_echangeur/docs/formes/cylindre_radial/variante_e/variante_e.FCStd
conception_echangeur/docs/formes/cylindre_radial/variante_f/imprime/secteur/sect_canaux.stl
conception_echangeur/docs/formes/cylindre_radial/variante_f/imprime/secteur/sect_canaux_c15.stl
conception_echangeur/docs/formes/cylindre_radial/variante_f/imprime/secteur/sect_canaux_e15.stl
conception_echangeur/docs/formes/cylindre_radial/variante_f/imprime/secteur/sect_canaux_e4.stl
conception_echangeur/docs/formes/cylindre_radial/variante_f/imprime/secteur/sect_canaux_e5.stl
conception_echangeur/docs/formes/cylindre_radial/variante_f/imprime/secteur/sect_cont_lamelles.stl
conception_echangeur/docs/formes/cylindre_radial/variante_f/imprime/secteur/sect_cont_lamelles_c15.stl
conception_echangeur/docs/formes/cylindre_radial/variante_f/imprime/secteur/sect_cont_lamelles_e15.stl
conception_echangeur/docs/formes/cylindre_radial/variante_f/imprime/secteur/sect_cont_lamelles_e4.stl
conception_echangeur/docs/formes/cylindre_radial/variante_f/imprime/secteur/sect_cont_lamelles_e5.stl
conception_echangeur/docs/formes/cylindre_radial/variante_f/imprime/secteur/sect_entree_f05.stl
conception_echangeur/docs/formes/cylindre_radial/variante_f/imprime/secteur/sect_entree_f05i.stl
conception_echangeur/docs/formes/cylindre_radial/variante_f/imprime/secteur/sect_entree_f05s.stl
conception_echangeur/docs/formes/cylindre_radial/variante_f/imprime/secteur/sect_entree_f05v.stl
conception_echangeur/docs/formes/cylindre_radial/variante_f/imprime/secteur/sect_lamelles.stl
conception_echangeur/docs/formes/cylindre_radial/variante_f/imprime/secteur/sect_lamelles_c15.stl
conception_echangeur/docs/formes/cylindre_radial/variante_f/imprime/secteur/sect_lamelles_e15.stl
conception_echangeur/docs/formes/cylindre_radial/variante_f/imprime/secteur/sect_lamelles_e4.stl
conception_echangeur/docs/formes/cylindre_radial/variante_f/imprime/secteur/sect_lamelles_e5.stl
conception_echangeur/docs/formes/cylindre_radial/variante_f/imprime/secteur/sect_periodiques_f05.stl
conception_echangeur/docs/formes/cylindre_radial/variante_f/imprime/secteur/sect_periodiques_f05i.stl
conception_echangeur/docs/formes/cylindre_radial/variante_f/imprime/secteur/sect_periodiques_f05s.stl
conception_echangeur/docs/formes/cylindre_radial/variante_f/imprime/secteur/sect_periodiques_f05v.stl
conception_echangeur/docs/formes/cylindre_radial/variante_f/imprime/secteur/sect_profils.stl
conception_echangeur/docs/formes/cylindre_radial/variante_f/imprime/secteur/sect_profils_c15.stl
conception_echangeur/docs/formes/cylindre_radial/variante_f/imprime/secteur/sect_profils_e15.stl
conception_echangeur/docs/formes/cylindre_radial/variante_f/imprime/secteur/sect_profils_e4.stl
conception_echangeur/docs/formes/cylindre_radial/variante_f/imprime/secteur/sect_profils_e5.stl
conception_echangeur/docs/formes/cylindre_radial/variante_f/imprime/secteur/sect_rad_canaux.stl
conception_echangeur/docs/formes/cylindre_radial/variante_f/imprime/secteur/sect_rad_canaux_c15.stl
conception_echangeur/docs/formes/cylindre_radial/variante_f/imprime/secteur/sect_rad_canaux_e15.stl
conception_echangeur/docs/formes/cylindre_radial/variante_f/imprime/secteur/sect_rad_canaux_e4.stl
conception_echangeur/docs/formes/cylindre_radial/variante_f/imprime/secteur/sect_rad_canaux_e5.stl
conception_echangeur/docs/formes/cylindre_radial/variante_f/imprime/secteur/sect_rad_lamelles.stl
conception_echangeur/docs/formes/cylindre_radial/variante_f/imprime/secteur/sect_rad_lamelles_c15.stl
conception_echangeur/docs/formes/cylindre_radial/variante_f/imprime/secteur/sect_rad_lamelles_e15.stl
conception_echangeur/docs/formes/cylindre_radial/variante_f/imprime/secteur/sect_rad_lamelles_e4.stl
conception_echangeur/docs/formes/cylindre_radial/variante_f/imprime/secteur/sect_rad_lamelles_e5.stl
conception_echangeur/docs/formes/cylindre_radial/variante_f/imprime/secteur/sect_rad_profils.stl
conception_echangeur/docs/formes/cylindre_radial/variante_f/imprime/secteur/sect_rad_profils_c15.stl
conception_echangeur/docs/formes/cylindre_radial/variante_f/imprime/secteur/sect_rad_profils_e15.stl
conception_echangeur/docs/formes/cylindre_radial/variante_f/imprime/secteur/sect_rad_profils_e4.stl
conception_echangeur/docs/formes/cylindre_radial/variante_f/imprime/secteur/sect_rad_profils_e5.stl
conception_echangeur/docs/formes/cylindre_radial/variante_f/imprime/secteur/sect_sortie_f05.stl
conception_echangeur/docs/formes/cylindre_radial/variante_f/imprime/secteur/sect_sortie_f05i.stl
conception_echangeur/docs/formes/cylindre_radial/variante_f/imprime/secteur/sect_sortie_f05s.stl
conception_echangeur/docs/formes/cylindre_radial/variante_f/imprime/secteur/sect_sortie_f05v.stl
conception_echangeur/docs/formes/cylindre_radial/variante_f/imprime/secteur/tout_cont_lamelles.stl
conception_echangeur/docs/formes/cylindre_radial/variante_f/imprime/secteur/tout_cont_lamelles_c15.stl
conception_echangeur/docs/formes/cylindre_radial/variante_f/imprime/secteur/tout_cont_lamelles_e15.stl
conception_echangeur/docs/formes/cylindre_radial/variante_f/imprime/secteur/tout_cont_lamelles_e4.stl
conception_echangeur/docs/formes/cylindre_radial/variante_f/imprime/secteur/tout_cont_lamelles_e5.stl
conception_echangeur/docs/formes/cylindre_radial/variante_f/imprime/secteur/tout_lamelles.stl
conception_echangeur/docs/formes/cylindre_radial/variante_f/imprime/secteur/tout_lamelles_c15.stl
conception_echangeur/docs/formes/cylindre_radial/variante_f/imprime/secteur/tout_lamelles_e15.stl
conception_echangeur/docs/formes/cylindre_radial/variante_f/imprime/secteur/tout_lamelles_e4.stl
conception_echangeur/docs/formes/cylindre_radial/variante_f/imprime/secteur/tout_lamelles_e5.stl
conception_echangeur/docs/formes/cylindre_radial/variante_f/imprime/secteur/tout_profils.stl
conception_echangeur/docs/formes/cylindre_radial/variante_f/imprime/secteur/tout_profils_c15.stl
conception_echangeur/docs/formes/cylindre_radial/variante_f/imprime/secteur/tout_profils_e15.stl
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
