ET-FR/HP_new_generation/conception_echangeur/docs/figures/theorie_constructale.png

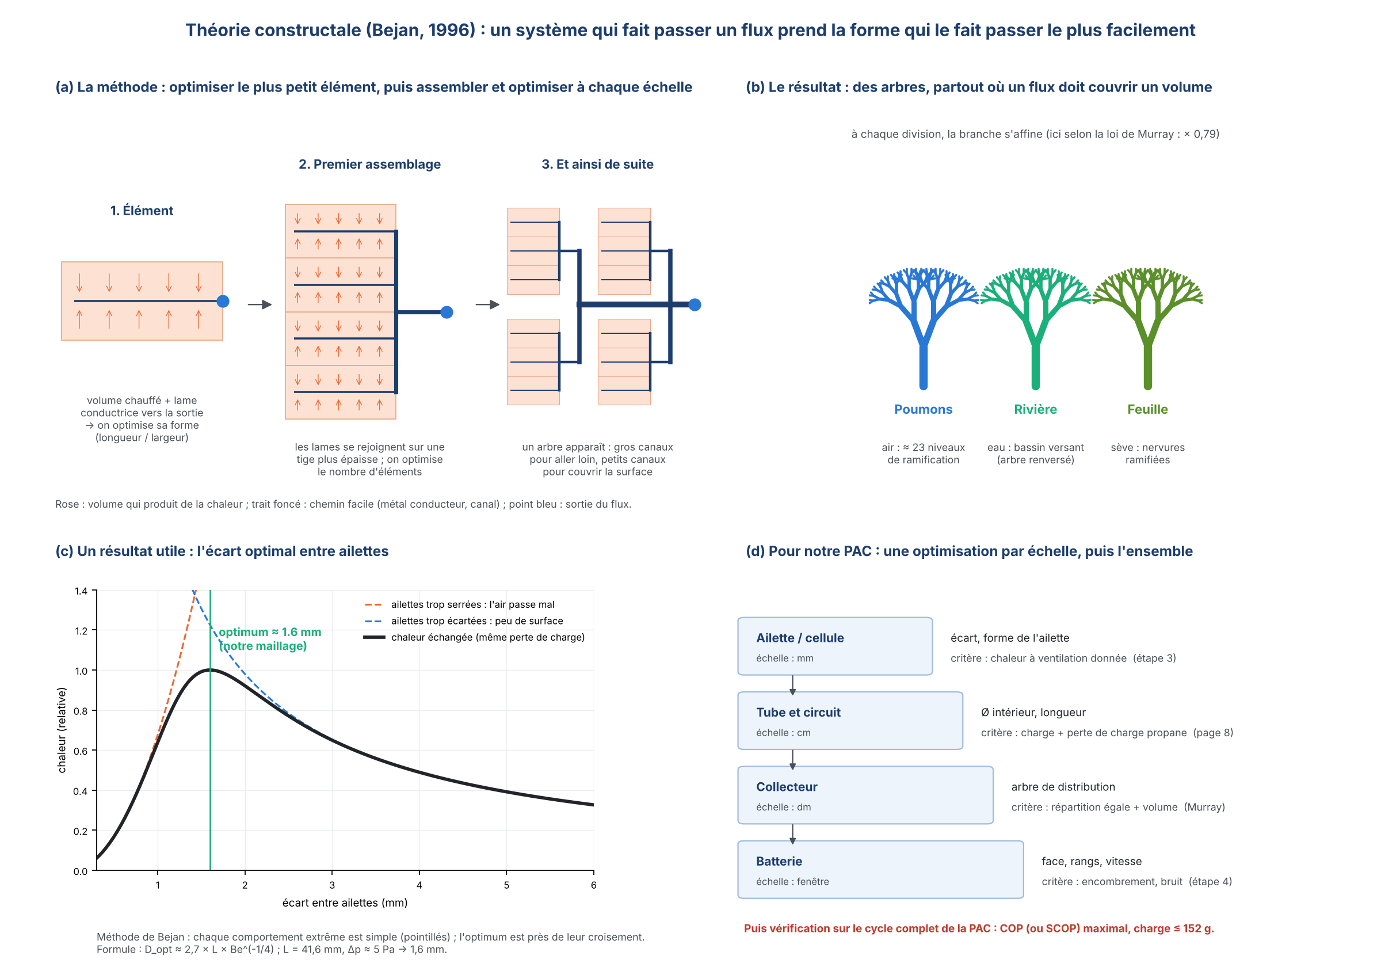
conception_echangeur/docs/figures/theorie_constructale.png
