ET-FR/HP_new_generation/conception_echangeur/docs/resultats_cfd.pdf

Étape | Sujet | Contenu | État
0 | Validation de la chaîne | plaques, tube isolé, faisceau de ronds ; convergence en maillage | fait
1 | Forme du tube | 22 formes à 1 m/s, même charge | fait
1b | Vitesse de l'air | 4 formes du meilleur compromis, 0,5 / 1 / 2 / 3 m/s | fait
2 | Agencement | aligné / quinconce, pas, nombre de rangs (1, 2, 4, 8) | fait
3 | Ailettes et TPMS | ailettes (plates, persiennées), surfaces TPMS en 3D | en cours
4 | Base + optimisation | plan d'expériences, puis optimisation bayésienne sur le cycle complet | à faire
5 | Validation physique | prototype imprimé, essais d'échange, de givrage et de fuite | à faire

# Échangeurs d'une PAC de fenêtre au propane

Étude CFD côté air. Mis à jour le 11/11/2026.

## But

Concevoir les deux échangeurs air / propane d'une pompe à chaleur de fenêtre réversible (chauage et clim), au propane R290, imprimés en 3D, pour une pièce de 50 m² au plus. Cible : 8 000 BTU/h (-2,3 kW).
Contrainte forte : charge de propane 152 g (norme IEC 60335-2-40), dominée par le volume des échangeurs.

Côté air se trouvent la plus grosse résistance thermique, le ventilateur et le bruit : c'est là qu'il faut
trouver la meilleure forme de tube, celle qui échange le plus pour le moins de puissance de ventilation.

## Méthode

1. Comparer des formes simples en CFD 2D avec des règles d'équité strictes, pour comprendre ce qui compte.
2. Construire une base de simulations, puis optimiser par optimisation bayésienne multi-objectif et multi-délité (Ax / BoTorch) : simulateur de la PAC (rapide) CFD 2D CFD 3D (coûteuse).
3. Objectifs naux : COP (ou SCOP) maximal, charge minimale ; contraintes : encombrement de la fenêtre,

tenue à la pression, bruit, givre et condensats.

## Règles communes à tous les calculs

Même charge de propane et même périmètre de contact côté propane : canal intérieur de Dh = 4 mm, paroi 1 mm. Batterie de référence : 4 rangs en quinconce, pas transversal = 2 Ø extérieur du rond (ajusté à charge égale).
Air à 20 °C, paroi à température imposée (propane en changement de phase), écoulement laminaire instationnaire, OpenFOAM v2606, maillage à couches validé en convergence.

## Étapes

Dans ce document : validation et convergence (p. 2), comparaison des formes (p. 3), compromis (p. 4), inuence de la vitesse,

puis géométries et une page de champs (vitesse, température, pression) par cas.

Cas | Grandeur | CFD | Référence | Écart
Plaques parallèles | f·Re | 23.93 | 24 (exact) | -0.3 %
Plaques parallèles | Nu | 7.529 | 7,541 (exact) | -0.2 %
Faisceau tubes ronds | Nu (Ø 6 mm) | 14.75 | Zukauskas 11,3 à 15,5 | dans la fourchette
Faisceau tubes ronds | p (Pa) | 4.40 | Zukauskas 5.02 | -12.4 %
Tube isolé | Nu | 10.72 | Hilpert 9.89 | +8.4 %
Tube isolé | Strouhal | 0.220 | Roshko 0.205 | +7.2 %
Tube isolé | Cd | 1.45 | essais 1,1 à 1,2 | surestimé (2D)
Grandeur | Grossier (17868) | Moyen (32042) | Fin (56802) | Valeur retenue
p (Pa) | 4.38 | 4.28 | 4.48 | 4,4 ± 2,5 %
Nu (Ø 6 mm) | 14.46 | 14.38 | 14.18 | 14,2 ± 1,5 %

# Résultats CFD 2D côté air

PAC de fenêtre R290, batterie air / propane. Mis à jour le 11/11/2026. OpenFOAM v2606, air 20 °C, laminaire, 1 m/s.

# 1. Validation (niveau 0) : la chaîne est validée

# 2. Convergence en maillage (tubes ronds, couches) : maillage moyen retenu

# Conclusion de l'étape 0

Cas exacts (plaques) retrouvés à 0,3 % près : le solveur, les conditions aux limites et l'extraction sont justes.
Faisceau de ronds : Nu dans la fourchette de Zukauskas, p 12 % sous l'abaque (écart habituel en 2D laminaire). Tube isolé : Nu et Strouhal 7 à 8 % au-dessus des références, Cd surestimé : eet connu du calcul 2D,

sans conséquence pour comparer des formes entre elles.
Maillage moyen retenu : incertitude ± 2,5 % sur p, ± 1,5 % sur Nu. Un écart de moins de 5 % entre deux formes n'est donc pas signicatif.

La comparaison des formes est en page 3.

Forme (même charge R290) | p (Pa) | h (W/m²K) | Ecacité | P vent / Q (-) | Prof. (mm) | Stabilité
Rond | 4.28 | 61.9 | 27.5 % | 1.29 | 37 | ± 0.1 %
Carré | 3.81 | 48.6 | 20.9 % | 1.51 | 46 | ± 0.9 %
Losange | 6.19 | 61.9 | 25.8 % | 1.98 | 47 | ± 1.5 %
Triangle, pointe amont | 4.69 | 57.4 | 22.8 % | 1.70 | 60 | ± 5.2 %
Triangle, base amont | 8.50 | 55.1 | 22.0 % | 3.19 | 60 | ± 1.4 %
Ellipse 2:1 | 1.48 | 47.2 | 20.7 % | 0.59 | 45 | ± 0.2 %
Ellipse 3:1 | 0.79 | 39.0 | 16.4 % | 0.40 | 58 | ± 1.2 %
Tube plat 4:1 | 0.62 | 34.9 | 14.0 % | 0.37 | 74 | ± 1.4 %
Goutte | 0.85 | 34.0 | 13.5 % | 0.52 | 80 | ± 3.5 %
Lentille | 0.76 | 41.3 | 17.1 % | 0.37 | 62 | ± 0.8 %
Forme (même charge R290) | p (Pa) | h (W/m²K) | Ecacité | P vent / Q (-) | Prof. (mm) | Stabilité
Prol d'aile NACA 0030 | 0.66 | 35.3 | 14.4 % | 0.38 | 70 | ± 2.0 %
Goutte inversée | 0.91 | 39.4 | 15.5 % | 0.48 | 80 | ± 3.3 %
Ellipse 4:1 | 0.52 | 35.9 | 14.6 % | 0.30 | 71 | ± 0.7 %
Ellipse 5:1 | 0.38 | 30.7 | 12.2 % | 0.26 | 85 | ± 1.1 %
Tube plat 8:1 arrondi | 0.29 | 29.1 | 11.1 % | 0.22 | 113 | ± 0.6 %
Hexagone, pointe amont | 5.12 | 58.3 | 25.4 % | 1.66 | 41 | ± 0.7 %
Hexagone, plat amont | 4.50 | 58.6 | 25.5 % | 1.46 | 40 | ± 0.2 %
Demi-cercle, plat amont | 13.01 | 61.9 | 25.5 % | 4.22 | 47 | ± 0.6 %
Demi-cercle, arrondi amont | 5.88 | 59.2 | 24.5 % | 1.98 | 47 | ± 0.2 %
Rond à 6 ailettes longit. | 63.04 | 63.6 | 54.5 % | 9.54 | 42 | ± 0.2 %
Rond cannelé (12 ondes) | 9.28 | 45.8 | 31.2 % | 2.45 | 39 | ± 0.1 %
Multicanaux (3 canaux) | 0.50 | 32.3 | 10.9 % | 0.38 | 110 | ± 0.8 %

# Comparaison des formes de tubes

Même charge de propane et même périmètre côté propane pour toutes les formes.

# Série 1 : 10 / 10 calculées

# Série 2 : 12 / 12 calculées

Conditions : batterie de 4 rangs en quinconce, air à 1 m/s en face, même charge de propane et même périmètre côté propane pour toutes les formes. p : perte de charge de l'air à travers la batterie ; xe la puissance et le bruit du ventilateur.

h : coe cient d'échange moyen côté air, par m² de surface extérieure des tubes.
E cacité : part de l'écart de température entre l'air entrant et la paroi récupérée par l'air en sortie ; à vitesse égale,
elle est proportionnelle à la chaleur échangée par m² de face.
P vent / Q : puissance de ventilation (p × débit) divisée par la chaleur échangée, pour un écart air / paroi de 10 K ; plus c'est bas, mieux c'est.

Prof. : profondeur de la batterie dans le sens de l'air (encombrement à charge égale).
Stabilité : écart entre les moyennes de la 1re et de la 2e moitié du calcul (écoulement instationnaire) ; au-delà de ±2 %, le calcul est à prolonger.
Couleurs : du rouge (moins bien) au vert (mieux), chaque tableau sur sa propre échelle ; E cacité : vert = plus de chaleur ; p : vert = moins de perte de charge.

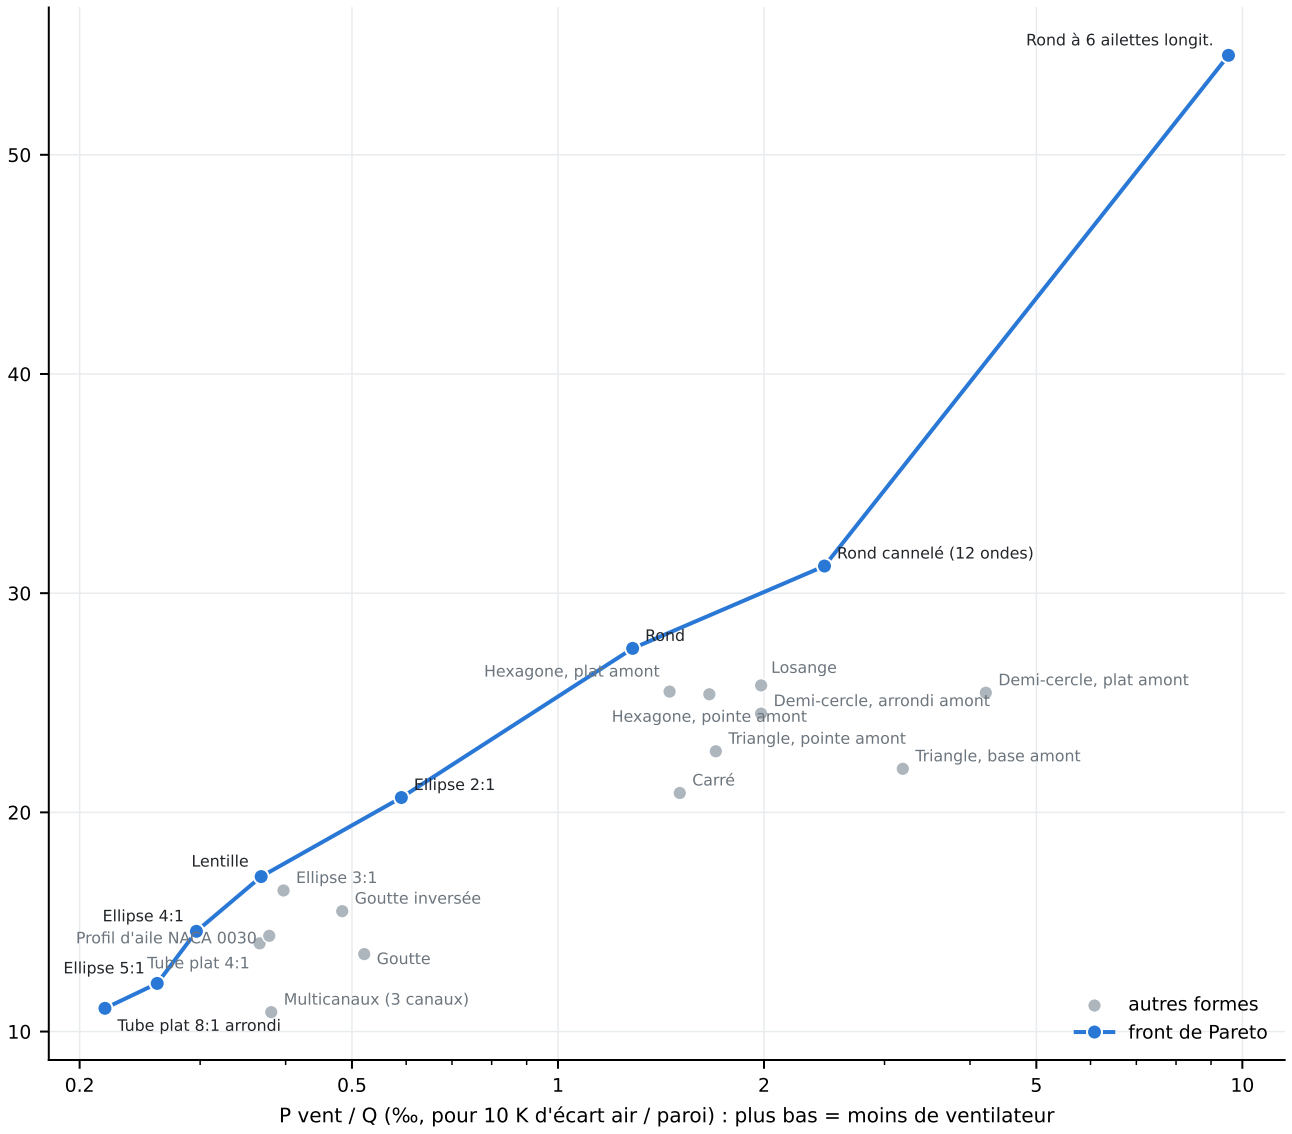
[picture p258: figure]
P vent / Q (; Rond; Carré; Losange; Triangle, pointe amont; Triangle, base amont; Ellipse 2:1; Ellipse; Tube plat 4:1; Goutte; Lentille; Prol d'aile NACA 0030; Goutte inversée; Ellipse 4:1; Ellipse 5:1; Tube plat 8:1 arrondi; Hexagone, pointe amont; Hexagone, plat amont; Demi-cercle, plat amont; Demi-cercle, arrondi amont; Rond à 6 ailettes longit.; Rond cannelé (12 ondes); Multicanaux (3 canaux); autres formes; front de Pareto

, pour 10 K d'écart air / paroi) : plus bas = moins de ventilateur

E cacité (%) : plus haut = plus de chaleur par m² de face

# Compromis échange / ventilation des 22 formes

Air à 1 m/s, même charge de propane. En haut à gauche : meilleur.
En bleu, le front de Pareto : aucune autre forme ne fait mieux sur les deux critères à la fois.

Lecture : les formes rondes échangent le plus sur peu de profondeur mais coûtent en ventilation ;
les formes allongées divisent la puissance de ventilation par 4 à 6 mais échangent 2 à 2,5 fois moins par m² de face. Le rond à ailettes a beaucoup plus de surface côté air : c'est déjà un tube à ailettes (à comparer plus tard aux ailettes).

# Conclusion de l'étape 1

Deux familles : formes compactes (rond, hexagones, losange) à 25 à 27 % d'e cacité mais P vent / Q de 1,3 à 2 ;
formes allongées (ellipses 3:1 à 5:1, lentille, tubes plats) à 11 à 17 % mais 0,2 à 0,4
Le rond est la meilleure forme compacte : il échange le plus pour la plus faible ventilation de sa famille, sur 37 mm. L'ellipse 2:1 est le meilleur intermédiaire : 25 % de chaleur en moins que le rond, 54 % de ventilation en moins.
Faces plates ou arêtes face à l'air (triangle base amont, demi-cercle plat amont, carré) : nettement moins bonnes. Les formes allongées demandent une batterie 1,6 à 3 fois plus profonde à charge égale (60 à 113 mm).
Retenues pour la suite (front de Pareto) : rond, ellipse 2:1, lentille 3:1, ellipse 4:1.

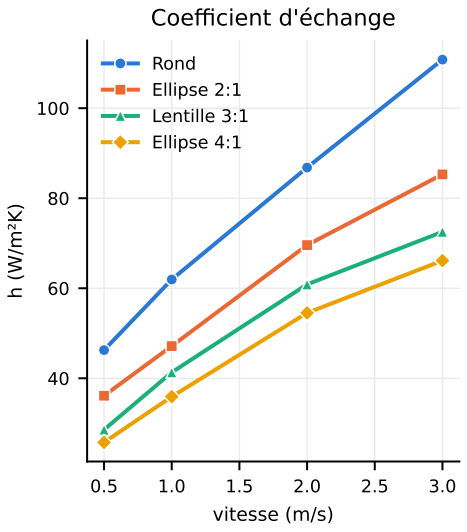
[picture p259: figure]
vitesse (m/s); h (W/m²K); Coe cient d'échange; Rond; Ellipse 2:1; Lentille 3:1; Ellipse 4:1
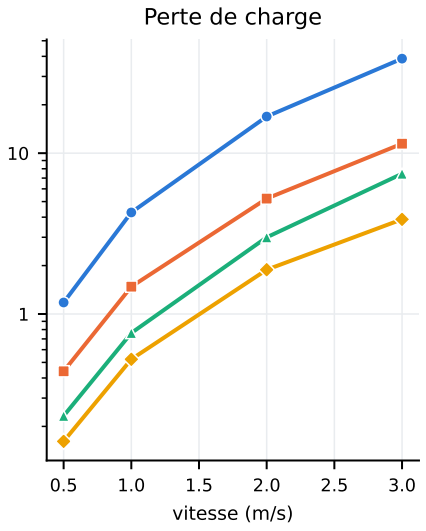
[picture p260: figure]
vitesse (m/s); Perte de charge
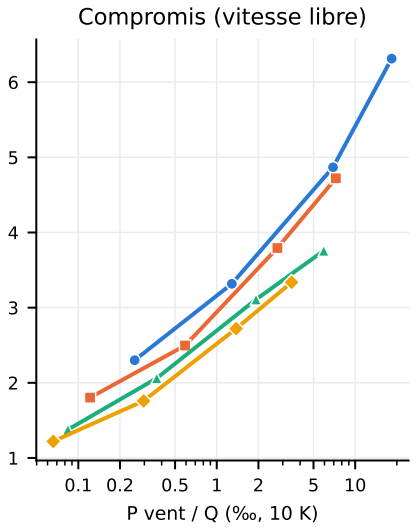
[picture p261: figure]
P vent / Q (; Compromis (vitesse libre)

## p (Pa)

Q par m² de face (kW/m², 10 K)

Forme | U (m/s) Re max | p (Pa) | h (W/m²K) | Ecacité Q face (kW/m²) P vent / Q (-
) | Stabilité
Rond | 0.5 | 396 | 1.18 | 46.3 | 38.1 % | 2.30 | 0.26 | ± 0.1 % (p Zuk. -21 %)
Rond | 1 | 792 | 4.28 | 61.9 | 27.5 % | 3.32 | 1.29 | ± 0.1 % (p Zuk. -15 %)
Rond | 2 | 1583 | 16.90 | 86.8 | 20.2 % | 4.87 | 6.92 | ± 1.2 % (p Zuk. -5 %)
Rond | 3 | 2375 | 38.71 | 110.8 | 17.4 % | 6.31 | 18.33 | ± 0.7 % (p Zuk. +2 %)
Ellipse 2:1 | 0.5 | 307 | 0.44 | 36.1 | 29.9 % | 1.80 | 0.12 | ± 0.0 %
Ellipse 2:1 | 1 | 615 | 1.48 | 47.2 | 20.7 % | 2.50 | 0.59 | ± 0.2 %
Ellipse 2:1 | 2 | 1230 | 5.22 | 69.6 | 15.7 % | 3.79 | 2.74 | ± 0.8 %
Ellipse 2:1 | 3 | 1845 | 11.45 | 85.3 | 13.0 % | 4.72 | 7.25 | ± 4.0 %
Lentille 3:1 | 0.5 | 270 | 0.23 | 28.6 | 22.8 % | 1.38 | 0.08 | ± 0.1 %
Lentille 3:1 | 1 | 539 | 0.76 | 41.3 | 17.1 % | 2.06 | 0.37 | ± 0.8 %
Lentille 3:1 | 2 | 1079 | 3.00 | 60.9 | 12.9 % | 3.11 | 1.92 | ± 0.6 %
Lentille 3:1 | 3 | 1618 | 7.45 | 72.5 | 10.4 % | 3.76 | 5.93 | ± 1.0 %
Ellipse 4:1 | 0.5 | 251 | 0.16 | 25.8 | 20.2 % | 1.22 | 0.07 | ± 0.3 %
Ellipse 4:1 | 1 | 502 | 0.52 | 35.9 | 14.6 % | 1.76 | 0.30 | ± 0.7 %
Ellipse 4:1 | 2 | 1004 | 1.88 | 54.5 | 11.3 % | 2.72 | 1.38 | ± 0.5 %
Ellipse 4:1 | 3 | 1506 | 3.88 | 66.1 | 9.2 % | 3.34 | 3.47 | ± 1.9 %

# Étape 1 : inuence de la vitesse de l'air

4 formes du meilleur compromis, 0,5 à 3 m/s en face, même batterie (4 rangs, même charge).

# Résultats

Re max : nombre de Reynolds sur la vitesse maximale entre tubes et le Ø 6 mm du rond. Au-delà de Re -1 000, l'écoulement réel devient 3D et turbulent dans les sillages : le calcul 2D laminaire est alors moins able (tendance correcte, valeurs à conrmer en 3D).
p Zuk. : écart aux abaques de Zukauskas (tubes ronds seulement). Q face : chaleur par m² de face (10 K d'écart air / paroi) ; Q face et p colorés du rouge au vert ;

l'e cacité baisse avec la vitesse alors que la chaleur augmente, c'est donc Q face qui compare les vitesses entre elles.

# Conclusion de l'étape 1b

Quand la vitesse est libre, le rond donne le plus de chaleur par m² de face pour un même coût de ventilation

(graphique de droite) ; l'ellipse 2:1 le suit de près (5 % en dessous), la lentille et l'ellipse 4:1 sont derrière. Exemple : le rond à 0,5 m/s échange 2,3 kW/m² pour 0,26
, mieux que l'ellipse 4:1 à 1 m/s (1,8 kW/m² pour 0,30 ).
Ralentir l'air est donc plus e cace qu'allonger le tube ; l'avantage des formes allongées à 1 m/s venait surtout

de la vitesse plus faible entre les tubes. Elles ne gardent l'avantage que pour des P vent / Q très bas (< 0,2
).
Le prix d'une vitesse faible est une grande surface de face, xée par la fenêtre. Au-delà de 2 m/s : à conrmer en 3D.

1 | 2 | 4 | 8
| | nombre de rangs

1

2

3

4

5

6

kW/m² (10 K)

Q par m² de face

Rond
Ellipse 2:1
0.8 | 1.0 | 1.2 | 1.4
Pt / Pt référence

2

3

4

5

Q par m² de face

0.6 | 0.8 | 1.0 | 1.2 | 1.4
Pl / Pl référence

2.50

2.75

3.00

3.25

3.50

Q par m² de face

Forme | Agencement | Re max | p (Pa) | h (W/m²K) | Ecacité P vent / Q (-
)Prof. (mm) Charge | Q / charge | Stabilité
Rond | Référence (4 rangs) | 792 | 4.28 | 61.9 | 27.5 % | 1.29 | 37 | 1.00 | 3.32 | ± 0.1 %
Rond | 1 rang | 792 | 1.17 | 59.2 | 7.4 % | 1.31 | 6 | 0.25 | 3.57 | ± 0.1 %
Rond | 2 rangs | 792 | 2.27 | 64.9 | 15.5 % | 1.21 | 16 | 0.50 | 3.74 | ± 0.0 %
Rond | 8 rangs | 792 | 8.99 | 66.5 | 49.9 % | 1.49 | 79 | 2.00 | 3.01 | ± 0.3 %
Rond | Pt × 0,75 | 1187 | 10.02 | 84.1 | 44.1 % | 1.88 | 37 | 1.33 | 3.99 | ± 0.2 %
Rond | Pt × 1,25 | 660 | 3.13 | 54.6 | 20.3 % | 1.27 | 37 | 0.80 | 3.06 | ± 0.0 %
Rond | Pt × 1,5 | 594 | 2.22 | 55.8 | 17.5 % | 1.05 | 37 | 0.67 | 3.18 | ± 0.7 %
Rond | Pl × 0,6 | 895 | 6.45 | 68.8 | 30.0 % | 1.77 | 25 | 1.00 | 3.63 | ± 0.1 %
Rond | Pl × 1,5 | 792 | 3.81 | 62.3 | 27.6 % | 1.14 | 53 | 1.00 | 3.33 | ± 0.1 %
Rond | Aligné | 792 | 1.72 | 32.6 | 15.6 % | 0.91 | 37 | 1.00 | 1.88 | ± 0.1 %
Rond | Aligné, Pt × 0,75 | 1187 | 7.37 | 58.1 | 33.1 % | 1.84 | 37 | 1.33 | 3.00 | ± 0.4 %
Ellipse 2:1 | Référence (4 rangs) | 615 | 1.48 | 47.2 | 20.7 % | 0.59 | 45 | 1.00 | 2.50 | ± 0.2 %
Ellipse 2:1 | 1 rang | 615 | 0.41 | 50.0 | 6.0 % | 0.57 | 8 | 0.25 | 2.88 | ± 0.5 %
Ellipse 2:1 | 2 rangs | 615 | 0.78 | 52.5 | 12.1 % | 0.53 | 21 | 0.50 | 2.92 | ± 0.0 %
Ellipse 2:1 | 8 rangs | 615 | 2.97 | 49.2 | 38.4 % | 0.64 | 95 | 2.00 | 2.31 | ± 0.1 %
Ellipse 2:1 | Pt × 0,75 | 754 | 2.68 | 56.0 | 30.7 % | 0.72 | 45 | 1.33 | 2.78 | ± 0.1 %
Ellipse 2:1 | Pt × 1,25 | 554 | 1.08 | 47.6 | 17.1 % | 0.52 | 45 | 0.80 | 2.58 | ± 0.5 %
Ellipse 2:1 | Pt × 1,5 | 519 | 0.93 | 46.9 | 14.2 % | 0.54 | 45 | 0.67 | 2.58 | ± 2.4 %
Ellipse 2:1 | Pl × 0,6 | 742 | 2.42 | 55.9 | 24.0 % | 0.83 | 30 | 1.00 | 2.90 | ± 0.3 %
Ellipse 2:1 | Pl × 1,5 | 615 | 1.90 | 54.9 | 23.6 % | 0.66 | 64 | 1.00 | 2.85 | ± 0.5 %
Ellipse 2:1 | Aligné | 615 | 0.63 | 27.4 | 12.6 % | 0.42 | 45 | 1.00 | 1.52 | ± 0.2 %
Ellipse 2:1 | Aligné, Pt × 0,75 | 754 | 1.56 | 32.4 | 19.1 % | 0.67 | 45 | 1.33 | 1.73 | ± 0.0 %

# Niveau 2 : agencement de la batterie

Rond et ellipse 2:1, air à 1 m/s. Référence : 4 rangs en quinconce, Pt = 2 Ø (rond), Pl = Pt 3 / 2.

La charge de propane par m² de face varie ici comme rangs / Pt : colonne « Charge ».

## Résultats

Mêmes grandeurs que les autres tableaux (p, h, e cacité, P vent / Q, profondeur, stabilité : voir la légende de la page de comparaison des formes).

Re max : Reynolds sur la vitesse maximale entre tubes et le Ø 6 mm du rond.
Charge : charge de propane par m² de face, relative à la référence (1 = 4 rangs, Pt de référence).
Q / charge : chaleur par m² de face (kW/m², 10 K d'écart air / paroi) divisée par la charge relative
(p, e cacité et Q / charge colorés du rouge au vert) ; Q / charge est le critère qui compte si la charge de 152 g est la contrainte limitante.

### Conclusion de l'étape 2

La quinconce s'impose : en aligné, la chaleur chute de 43 % (rond) et de 27 % (ellipse 2:1) à charge égale.
Resserrer les tubes en largeur (Pt × 0,75) donne le plus de chaleur par gramme de propane (+ 20 % pour le rond),

mais la ventilation par kW monte de 46 % : intéressant si la charge limite, pas si le bruit limite.
Moins de rangs utilise mieux le propane (2 rangs : + 13 %) mais demande 2 fois plus de surface de face.
Le pas en profondeur (Pl) change peu la chaleur ; Pl × 0,6 amincit la batterie (37 25 mm), + 37 % de ventilation. L'ellipse 2:1 ventile partout 2 fois moins par kW que le rond, pour 20 à 25 % de chaleur par gramme en moins.
Cas instables corrigés (11/11) : ellipse Pl × 1,5 moyennée après son régime transitoire (dès 0,85 s), rond
Pl × 1,5 dès 0,5 s, 3 cas prolongés. Ellipse Pt × 1,5 reste à ± 2,4 % : bouées irrégulières, valeurs inchangées.

Tube | Ailettes | p (Pa) | h (W/m²K) | Ecacité | Q face | P vent / Q | Charge | Q / charge | Ailettes
Rond | nus | 4.28 | 61.9 | 27.5 % | 3.32 | 1.29 | 1.00 | 3.32 | -
Rond | 1,8 mm | 15.03 | 58.4 | 86.4 % | 10.42 | 1.44 | 1.00 | 10.42 | 85 %
Rond | 1,8 mm, 20 tranches | 14.99 | 58.1 | 86.2 % | 10.41 | 1.44 | 1.00 | 10.41 | 85 %
Rond | 1,8 mm, 40 tranches | 15.06 | 58.4 | 86.4 % | 10.43 | 1.44 | 1.00 | 10.43 | 85 %
Rond | 2,5 mm | 10.86 | 53.4 | 75.1 % | 9.06 | 1.19 | 1.00 | 9.06 | 80 %
Rond | 1,8 mm, 2 rangs | 7.68 | 66.5 | 67.8 % | 8.19 | 0.94 | 0.50 | 16.37 | 86 %
Rond | ondulées 1,8 mm | 21.52 | 79.8 | 94.1 % | 11.36 | 1.89 | 1.00 | 11.36 | 87 %
Rond | 1,8 mm, bord ondulé | 15.02 | 58.4 | 86.4 % | 10.43 | 1.44 | 1.00 | 10.43 | 85 %
Rond | gyroïde 6 mm | 85.33 | 134.6 | 98.7 % | 11.91 | 7.14 | 1.00 | 11.91 | 86 %
Rond | Diamond 6 mm | 93.90 | 133.1 | 99.5 % | 12.01 | 7.79 | 1.00 | 12.01 | 89 %
Ellipse 2:1 | nus | 1.48 | 47.2 | 20.7 % | 2.50 | 0.59 | 1.00 | 2.50 | -
Ellipse 2:1 | 1,8 mm | 10.08 | 55.3 | 89.8 % | 10.84 | 0.93 | 1.00 | 10.84 | 91 %
Ellipse 2:1 | 1,8 mm, 2 rangs | 5.39 | 62.4 | 72.4 % | 8.74 | 0.62 | 0.50 | 17.47 | 91 %
Ellipse 2:1 | ondulées, 2 rangs | 7.74 | 74.3 | 79.9 % | 9.65 | 0.80 | 0.50 | 19.30 | 92 %
Ellipse 2:1 | bord ondulé, 2 rangs | 5.38 | 62.5 | 72.4 % | 8.74 | 0.61 | 0.50 | 17.48 | 91 %
Ellipse 2:1 | gyroïde 6 mm, 2 rangs | 37.63 | 115.4 | 85.4 % | 10.31 | 3.64 | 0.50 | 20.63 | 89 %

# Étape 3 : tubes à ailettes (CFD 3D) : plates, ondulées, TPMS

Mêmes tubes et même charge de propane que les tubes nus (4 rangs en quinconce, Pt = 12 mm), air à 1 m/s en façade.
Ailettes de 0,2 mm sur toute la profondeur (rangs × Pl), supposées isothermes ; domaine : l'espace entre deux ailettes, en 28 tranches.

## Résultats

h : moyen sur toute la surface côté air (tubes + ailettes). Q face : chaleur par m² de face (kW/m², 10 K d'écart air / paroi). P vent / Q en

. Charge : propane relatif à la référence (4 rangs). Ailettes : part de la chaleur échangée par les ailettes. Calcul stationnaire : résidus plafonnant vers 7·10³, mais p, température de sortie et ux constants

à moins de 0,1 % depuis l'itération 2 000 ; bilan de chaleur fermé à 0,2 % (TPMS : maillage snappyHexMesh sans couches limites, bilan fermé à 1,2 %, stabilité 0,8 %). Ondulées : A = 0,75 mm,

= 2 Pl ; bord ondulé : A = 0,8 mm, = 4 mm.

### Conclusions de l'étape 3

À charge égale (4 rangs), les ailettes multiplient la chaleur par m² de face par 3,1 (rond) et 4,3 (ellipse 2:1) ;

la ventilation par kW augmente de 11 % (rond) et 57 % (ellipse). Les ailettes portent 85 à 91 % de la chaleur.
Avec ailettes, 4 rangs sont trop profonds (air à 86-90 %). 2 rangs gardent 80 % de la chaleur avec moitié moins de

propane : chaleur par gramme × 4,9 (rond) et × 7 (ellipse) par rapport aux tubes nus, et ventilation par kW
plus basse que les tubes nus (rond 0,94 contre 1,29

; ellipse 0,62

, autant que l'ellipse nue). Pas de 2,5 mm (batterie extérieure qui givre) : 13 % de chaleur en moins, 17 % de ventilation par kW en moins. Maillage convergé : 20, 28 et 40 tranches donnent p et e cacité à moins de 0,5 % près (28 retenues).
Ailettes ondulées (amplitude 0,75 mm, une onde tous les 2 Pl) : + 9 à 10 % de chaleur avec les mêmes tubes, mais p + 43 % et ventilation par kW + 30 %. Même NTU par pascal que les plates : gain utile si la charge limite. Bord d'attaque ondulé (tubercules, 0,8 mm) : aucun eet (p et chaleur identiques à 0,1 %) en laminaire à 1 m/s. TPMS à métal égal (gyroïde / Diamond, cellule 6 mm) : air presque saturé (98,7-99,5 % en 4 rangs) mais p × 5,7

à × 6,2 et ventilation par kW × 5 ; NTU par pascal 2,6 à 4,7 × plus faible que les ailettes plates.
Mais par gramme de propane, le gyroïde ellipse 2 rangs est le meilleur (20,6 contre 17,5 plates, 19,3 ondulées)
au prix de 3,6

de ventilation par kW (6 × les plates). Cellule de 6 mm sans doute trop serrée pour 1 m/s. Ellipse 2:1, 2 rangs : plates = ventilation minimale ; ondulées = + 10 % par gramme ; gyroïde = + 18 % par gramme.

Reste : rendement d'ailette réel, instationnaire, persiennes, TPMS à cellule plus grande (8-12 mm).

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

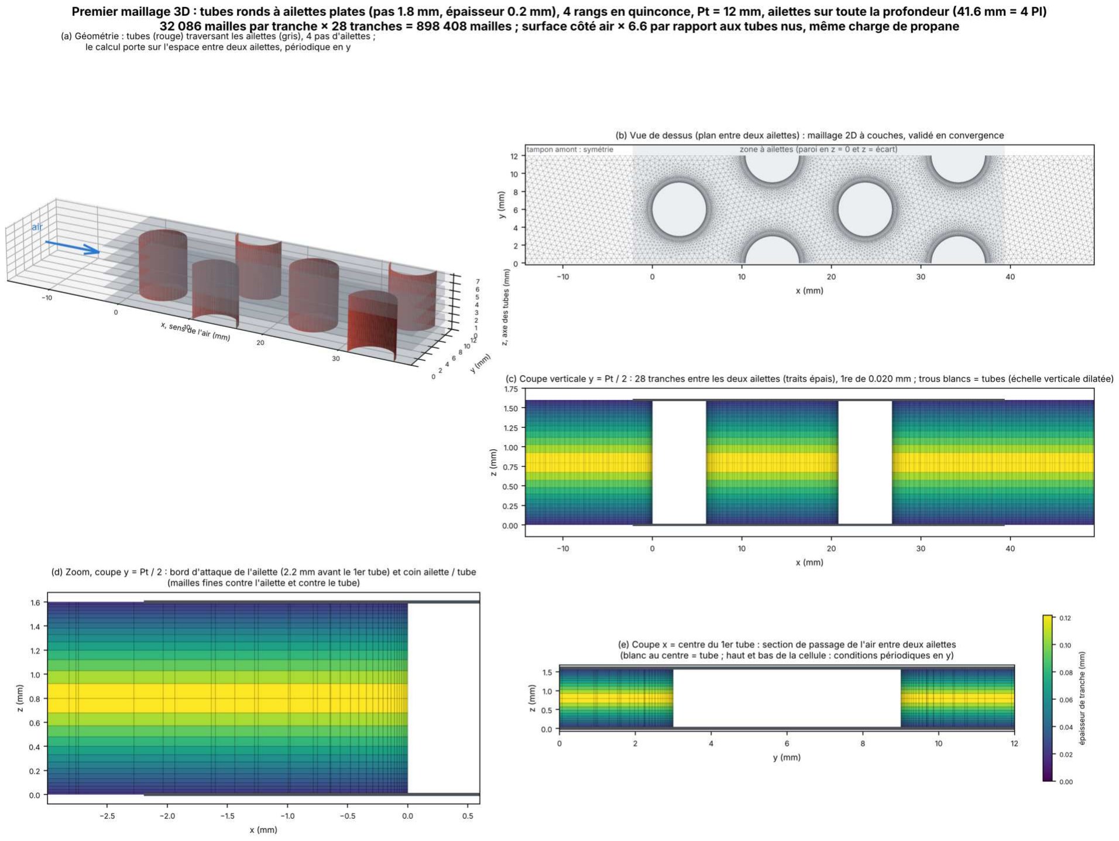
[picture p262: figure]

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

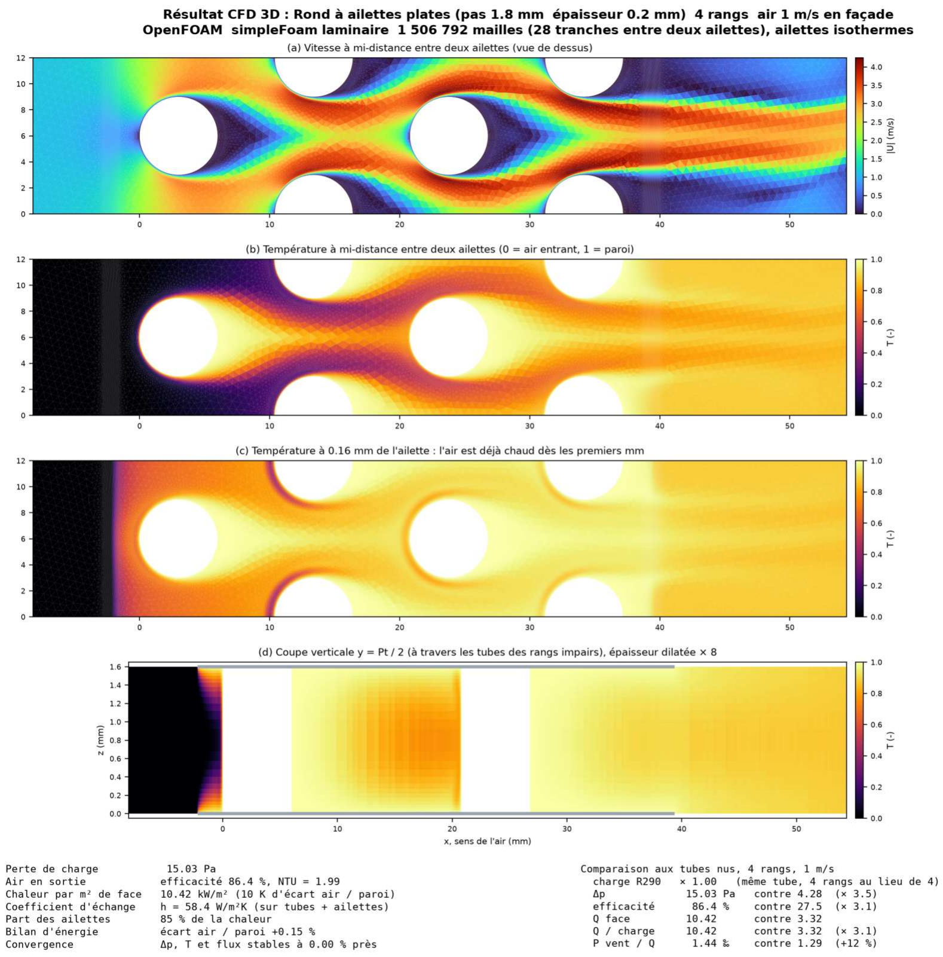
[picture p263: figure]

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

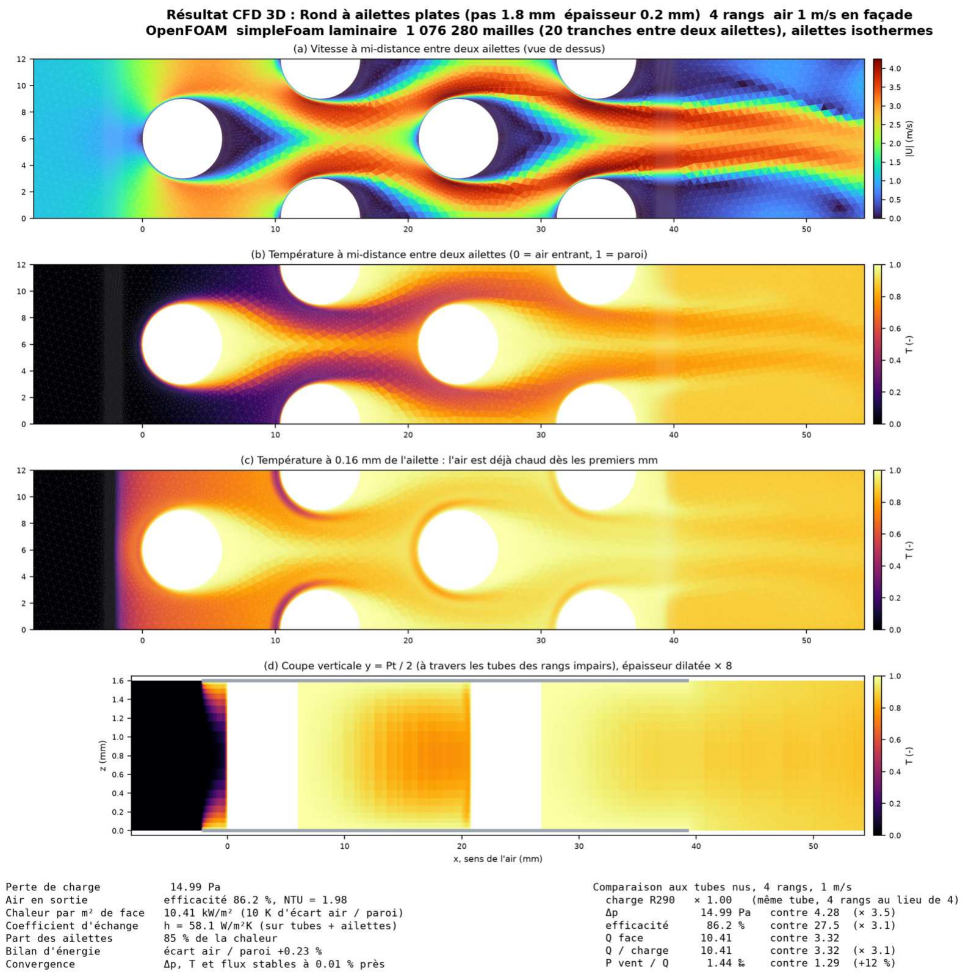
[picture p264: figure]

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

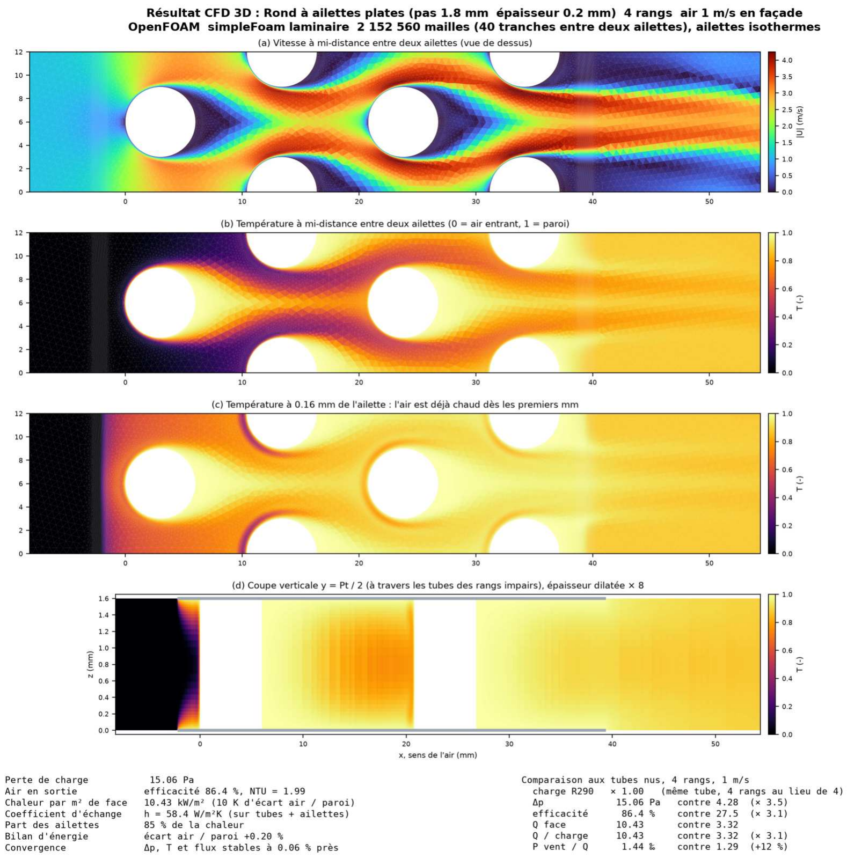
[picture p265: figure]

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

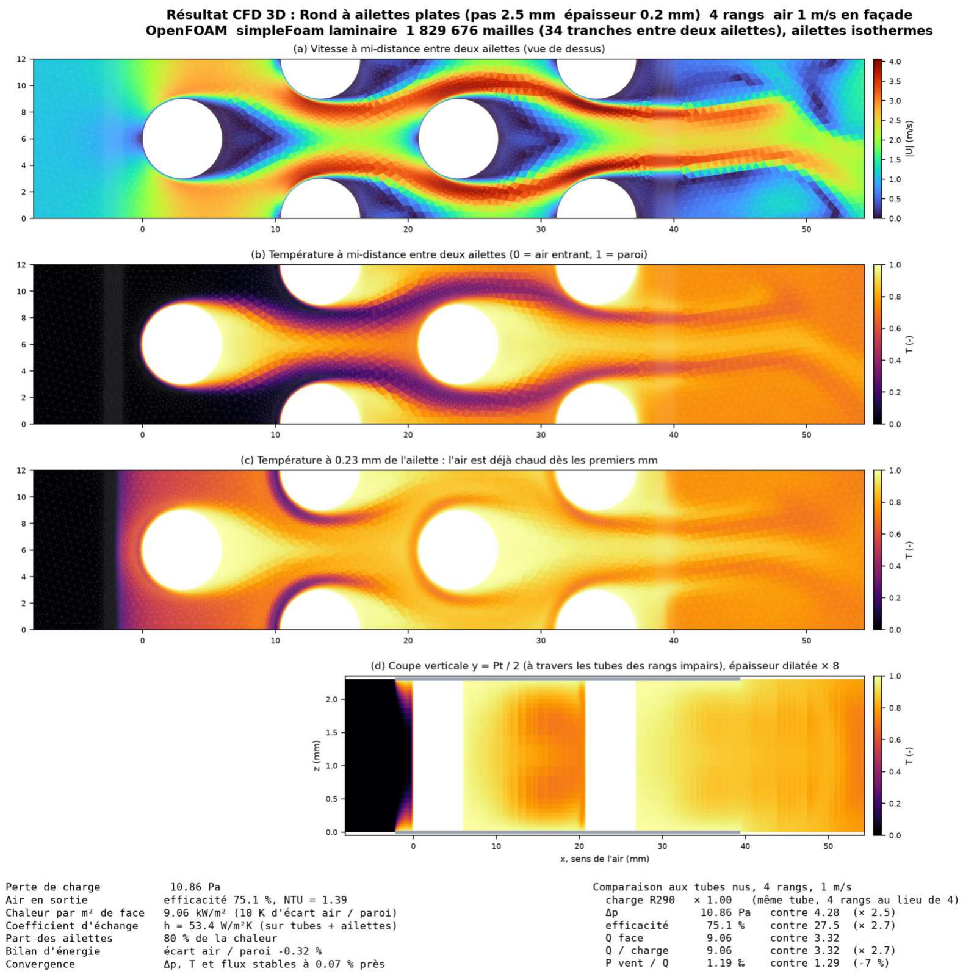
[picture p266: figure]

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

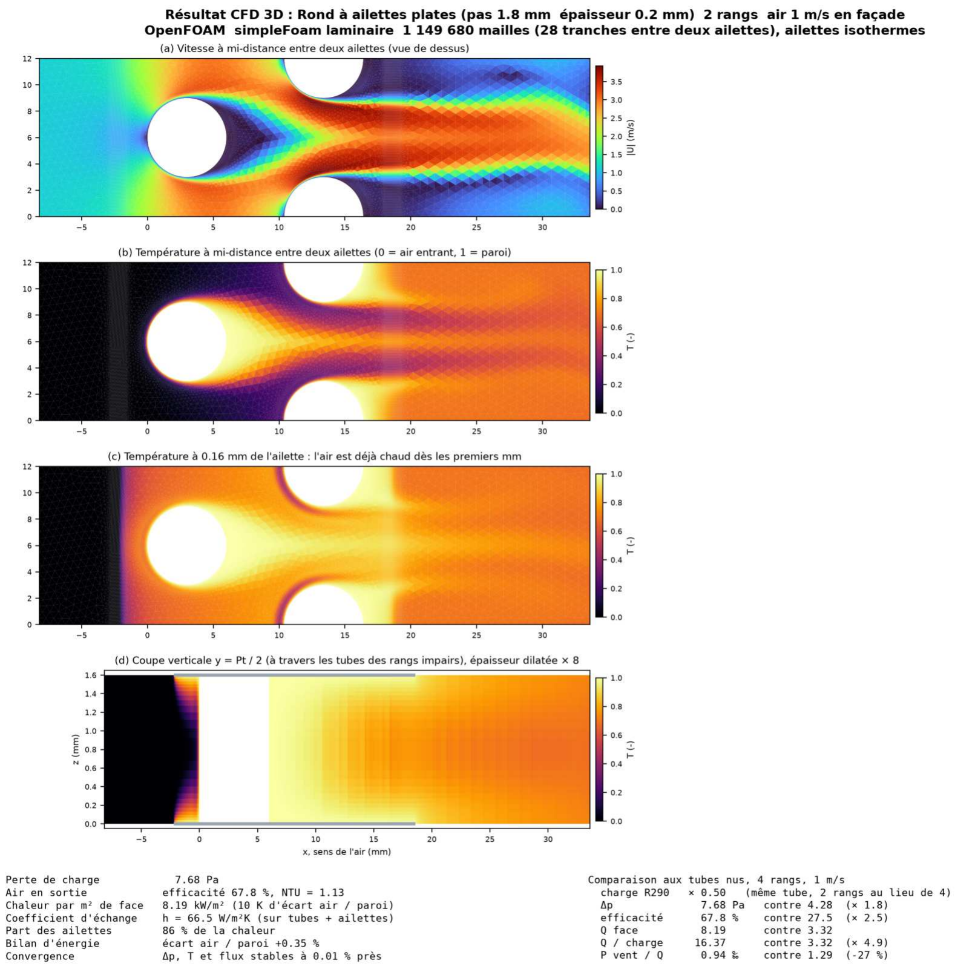
[picture p267: figure]

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

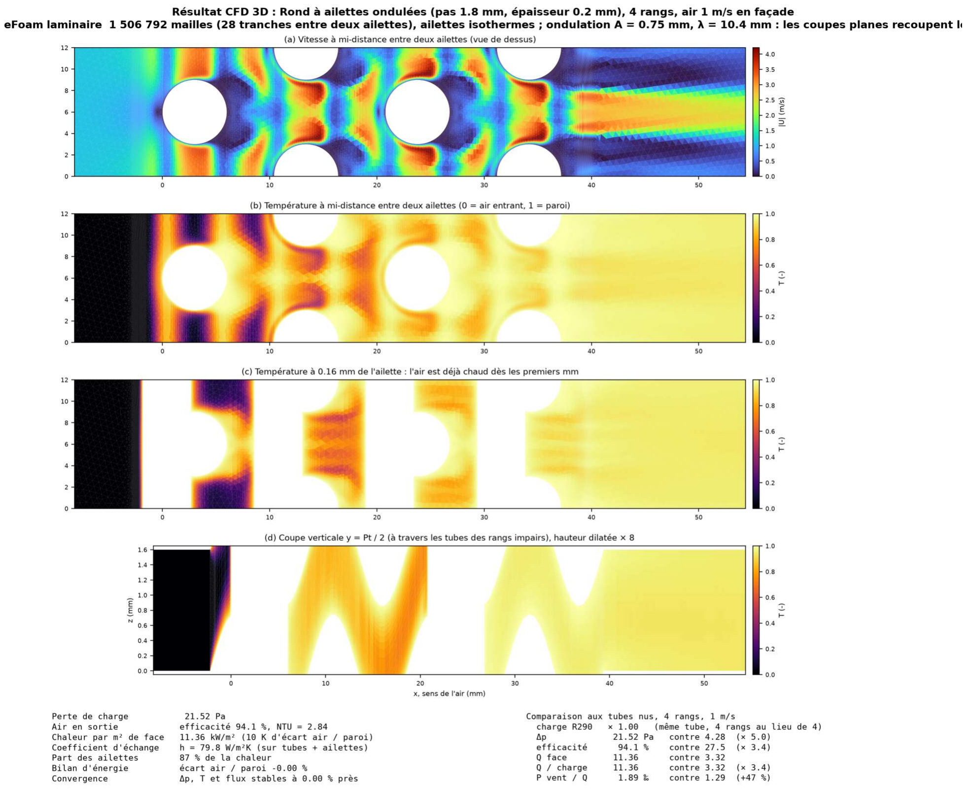
[picture p268: figure]

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

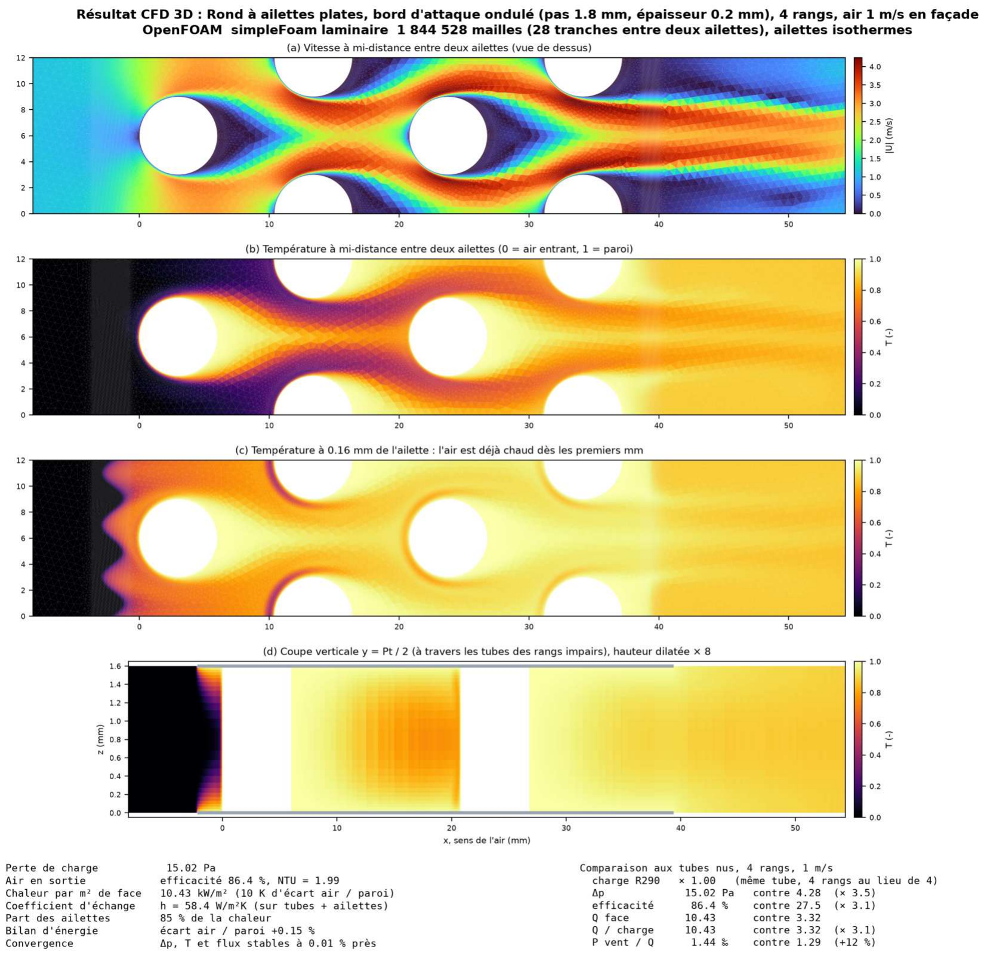
[picture p269: figure]

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

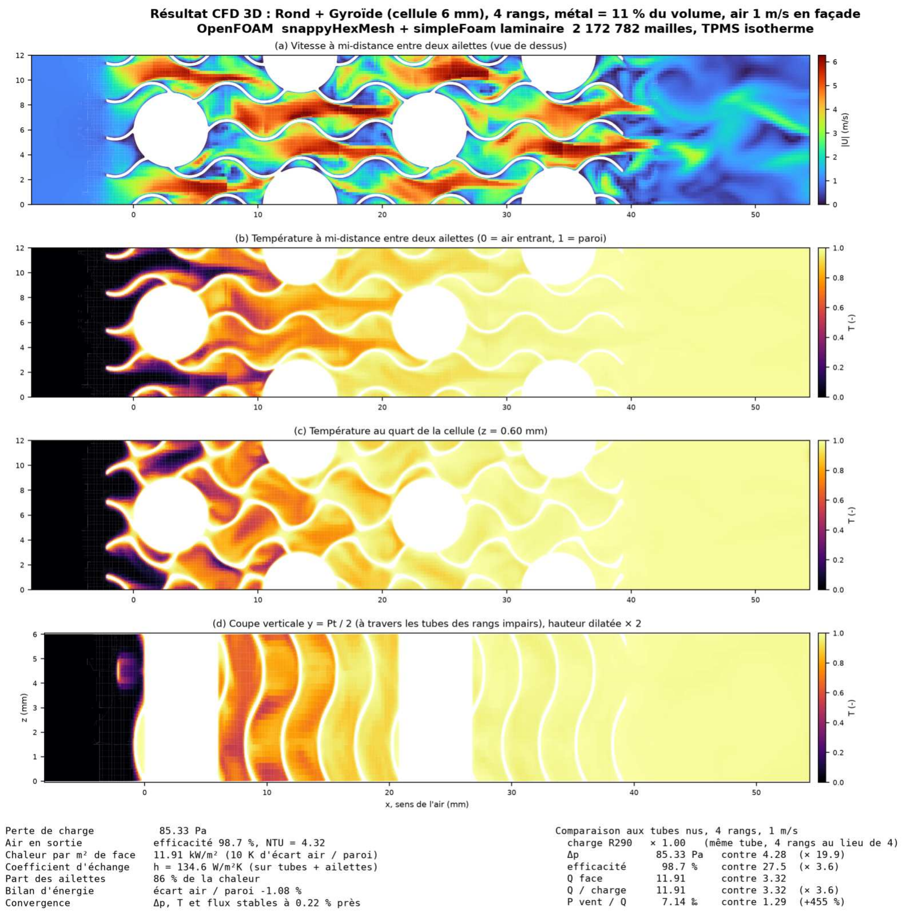
[picture p270: figure]

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

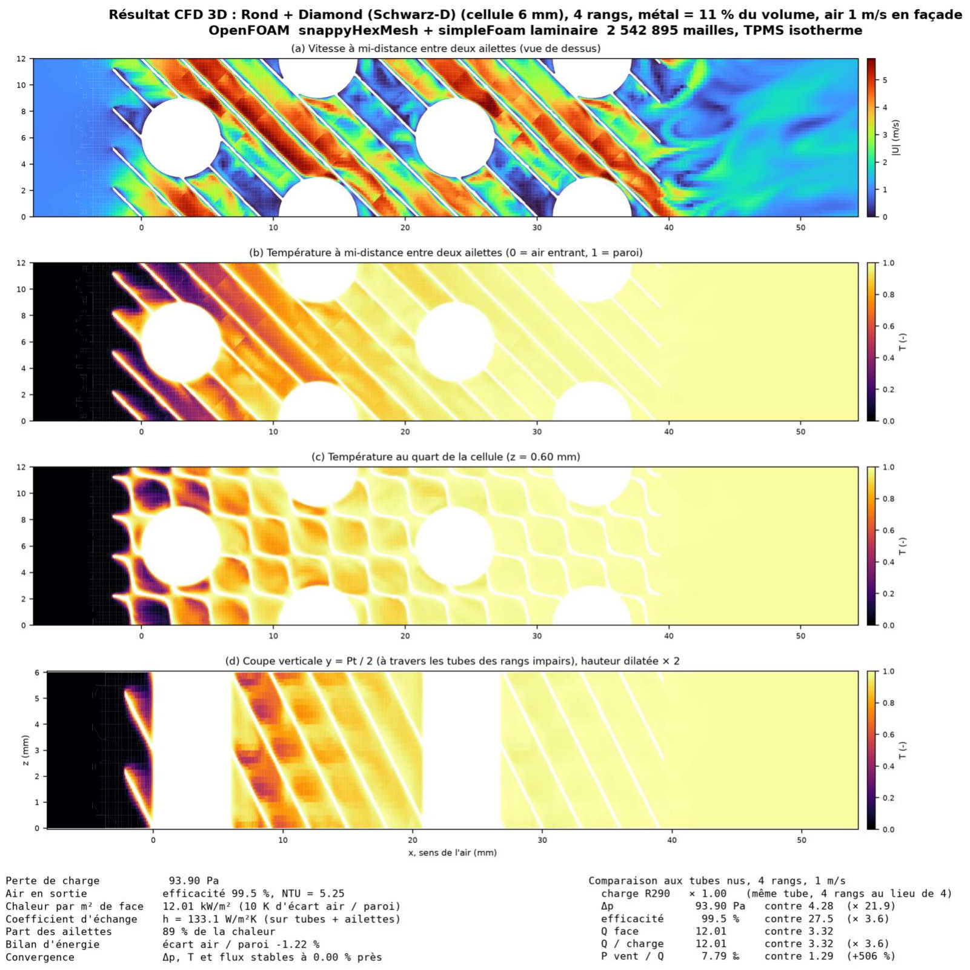
[picture p271: figure]

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

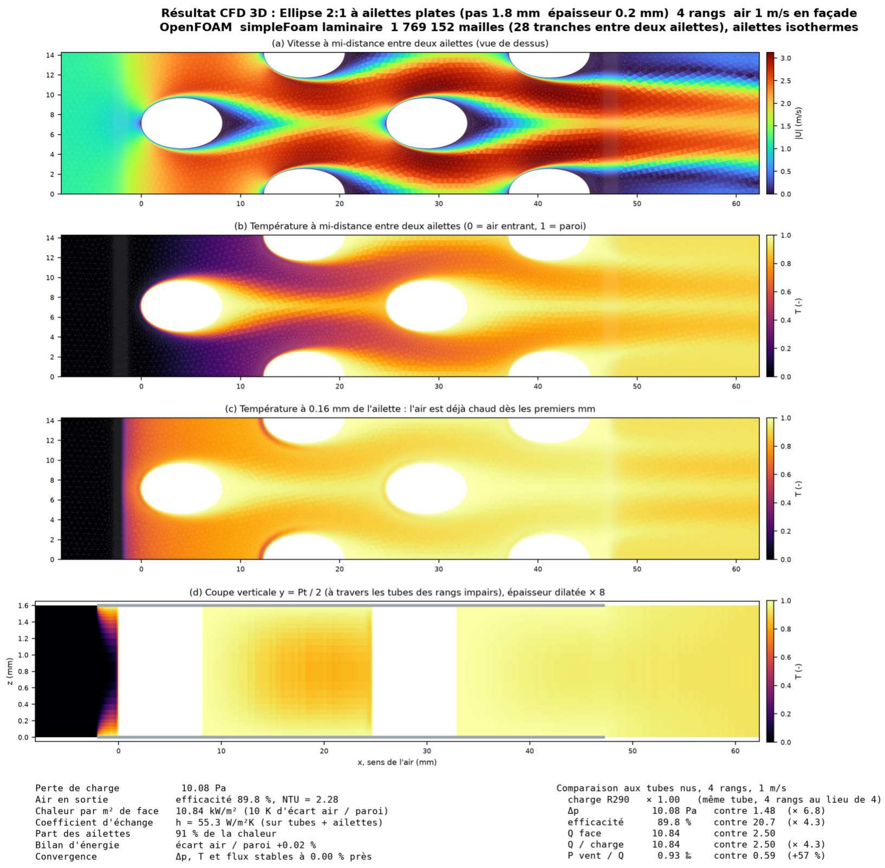
[picture p272: figure]

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

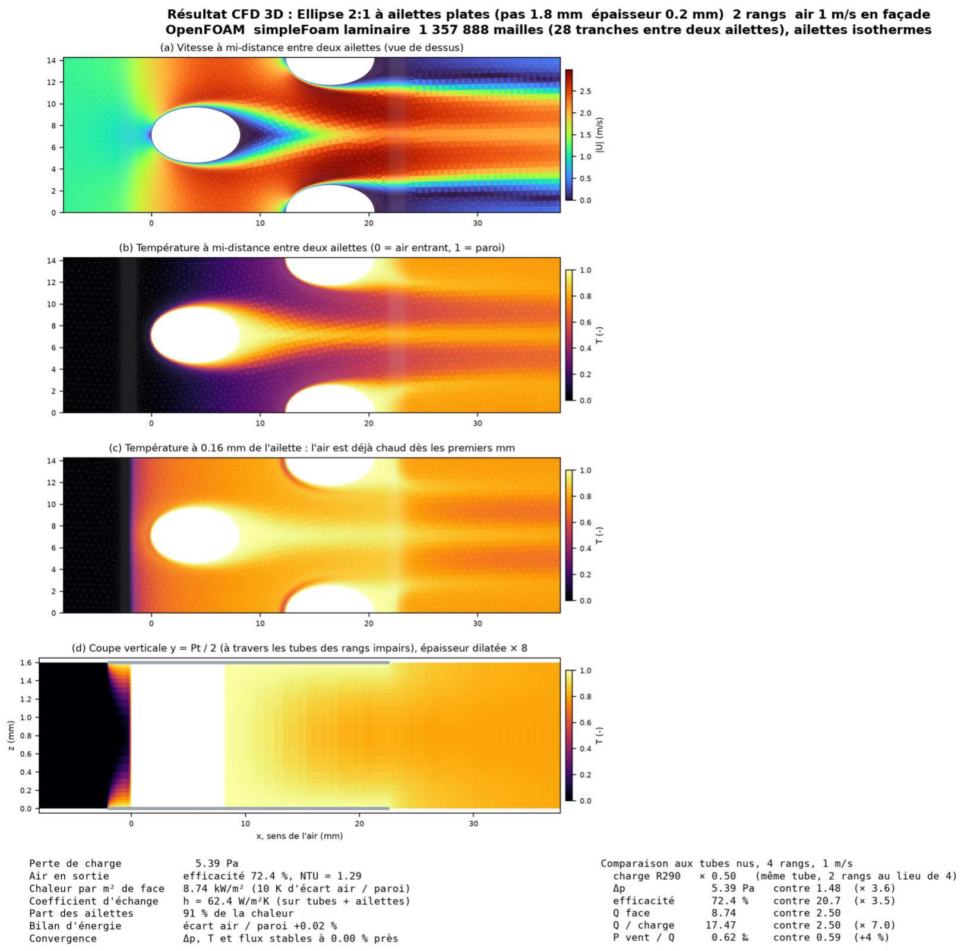
[picture p273: figure]

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

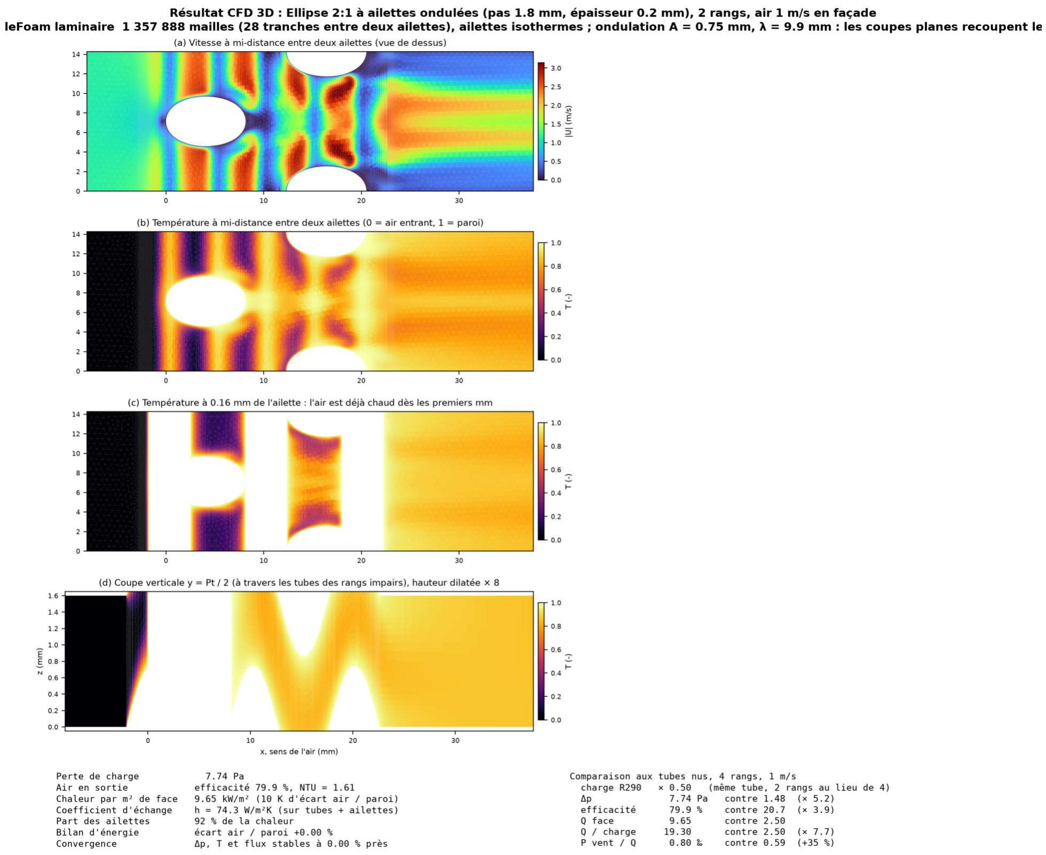
[picture p274: figure]

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

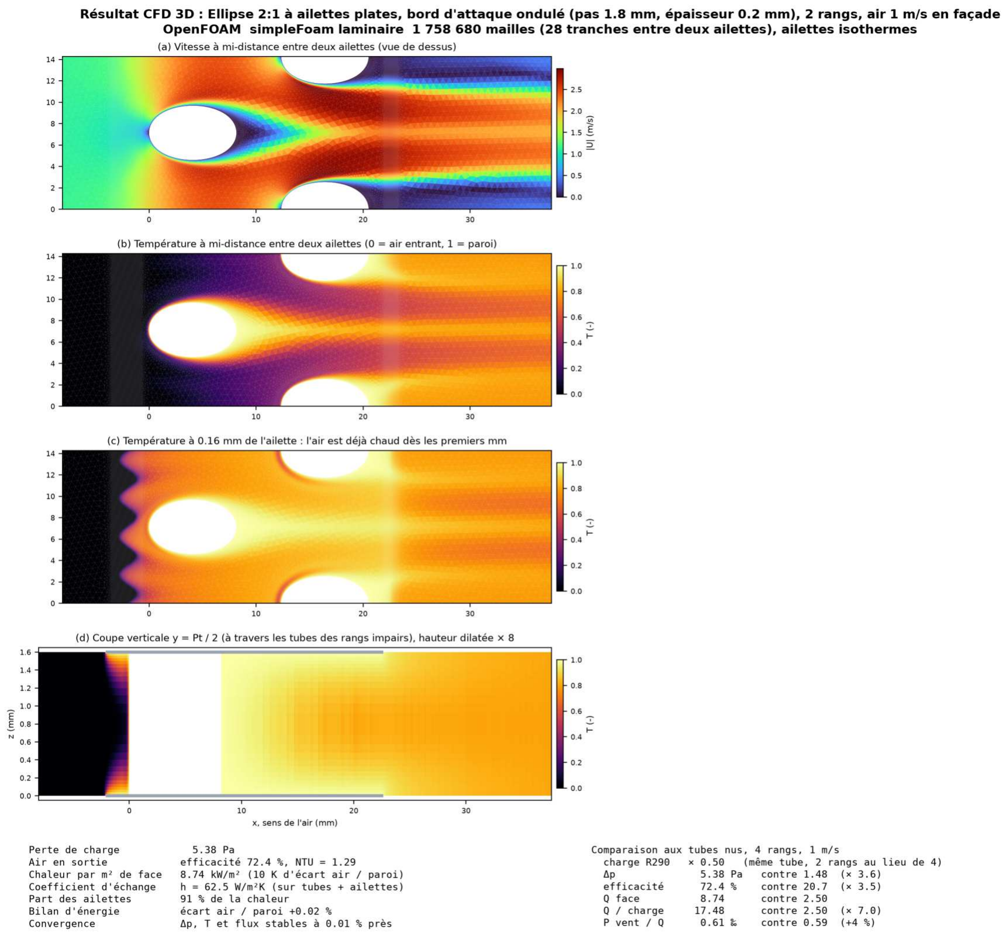
[picture p275: figure]

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

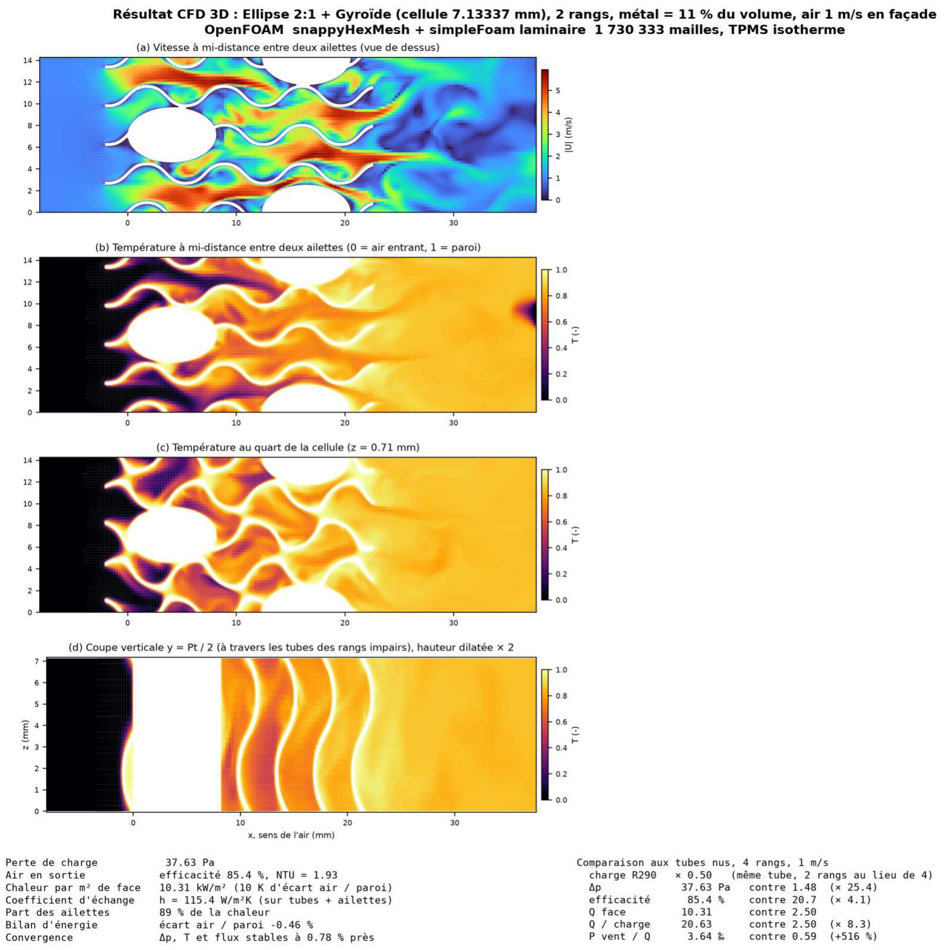
[picture p276: figure]

5 | 10 | 20 | 50 | 100 | 200 | 500
Perte de charge côté air p (Pa, échelle log) : plus à gauche = moins de ventilateur

60

70

80

90

100

E cacité (%) : plus haut = plus de chaleur

| | | | | 2 mm | 2 mm
Ellipse | 2:1, ondulées | | | 3 mm | 4 mm
Ellipse 2:1, 1,8 mm | | | 3 mm
Rond, | 1,8 mm | | 4 mm 6 mm
| | 4 mm | | Gyroïde seul Diamond seul Fischer-Koch S seul tubes | à ailettes, 2 rangs (même charge)

3 mm

Échangeur | Cellule / ailettes | Prof. (mm) Dh air (mm) | p (Pa) | Ecacité | Q face | P vent / Q
Gyroïde | 2 mm | 7.2 | 0.83 | 246.6 | 96.4 % | 11.64 | 21.11
Gyroïde | 3 mm | 5.9 | 1.41 | 74.7 | 72.5 % | 8.75 | 8.51
Gyroïde | 4 mm | 5.4 | 2.08 | 38.9 | 52.7 % | 6.36 | 6.10
Diamond | 2 mm | 8.3 | 0.59 | 473.4 | 99.0 % | 11.95 | 39.50
Diamond | 3 mm | 6.5 | 1.04 | 107.4 | 87.9 % | 10.61 | 10.09
Diamond | 4 mm | 5.8 | 1.61 | 47.9 | 70.0 % | 8.45 | 5.65
Fischer-Koch S | 3 mm | 8.0 | 0.65 | 608.6 | 98.2 % | 11.86 | 51.16
Fischer-Koch S | 4 mm | 6.7 | 0.99 | 195.9 | 89.6 % | 10.82 | 18.05
Fischer-Koch S | 6 mm | 5.7 | 1.68 | 60.3 | 62.2 % | 7.50 | 8.00
Rond | 1,8 mm (2 rangs) | 20.8 | - | 7.7 | 67.8 % | 8.19 | 0.94
Ellipse 2:1 | 1,8 mm (2 rangs) | 24.7 | - | 5.4 | 72.4 % | 8.74 | 0.62
Ellipse 2:1 | ondulées (2 rangs) | 24.7 | - | 7.7 | 79.9 % | 9.65 | 0.80
Ellipse 2:1 | bord ondulé (2 rangs) | 24.7 | - | 5.4 | 72.4 % | 8.74 | 0.61

# TPMS seul contre tubes à ailettes, à même charge de propane

TPMS seul : la feuille (paroi 0,3 mm) sépare deux labyrinthes, air et propane, de même volume. Le volume
propane par m² de face est celui de l'ellipse 2:1 à ailettes, 2 rangs (2,09 L/m²) : il xe l'épaisseur du bloc (5 à 11 mm).

Air à 1 m/s en façade ; paroi à la température du propane (côté air seul calculé, comme pour les ailettes, supposées parfaites).

# Résultats (même charge de propane)

Q face en kW/m² et P vent / Q en

, pour 10 K d'écart air / paroi. Maillage snappyHexMesh, 9 mailles par Dh ; convergence (gyroïde 3 mm, 62 k / 141 k / 255 k mailles) : p 75,5 / 74,8 / 72,8 Pa, e cacité 73,5 / 72,6 / 72,1 %. Bilans de chaleur fermés à 1,6 % près.

# Le TPMS seul est-il meilleur ?

Non : à même charge de propane, aucun TPMS seul n'approche les ailettes plates.
Meilleur TPMS : Diamond 4 mm, 70 % d'e cacité (ailettes : 72 %) pour 48 Pa au lieu de 5,4 Pa,
soit 9 × plus de perte de charge et de ventilation par kW. Gyroïde 3 mm : même chaleur, 14 × p.
Petites cellules : air saturé (96 à 99 %) mais 250 à 600 Pa, hors de portée d'un ventilateur de fenêtre.
Cause : la charge impose des passages ns (Dh 0,6 à 2 mm) et tortueux ; des canaux droits entre plaques

restent bien meilleurs en laminaire. Ailettes réelles (rendement 75 à 85 %) : écart réduit, pas un facteur 9. Le dimensionnement tubes + ailettes reste la voie à suivre.

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

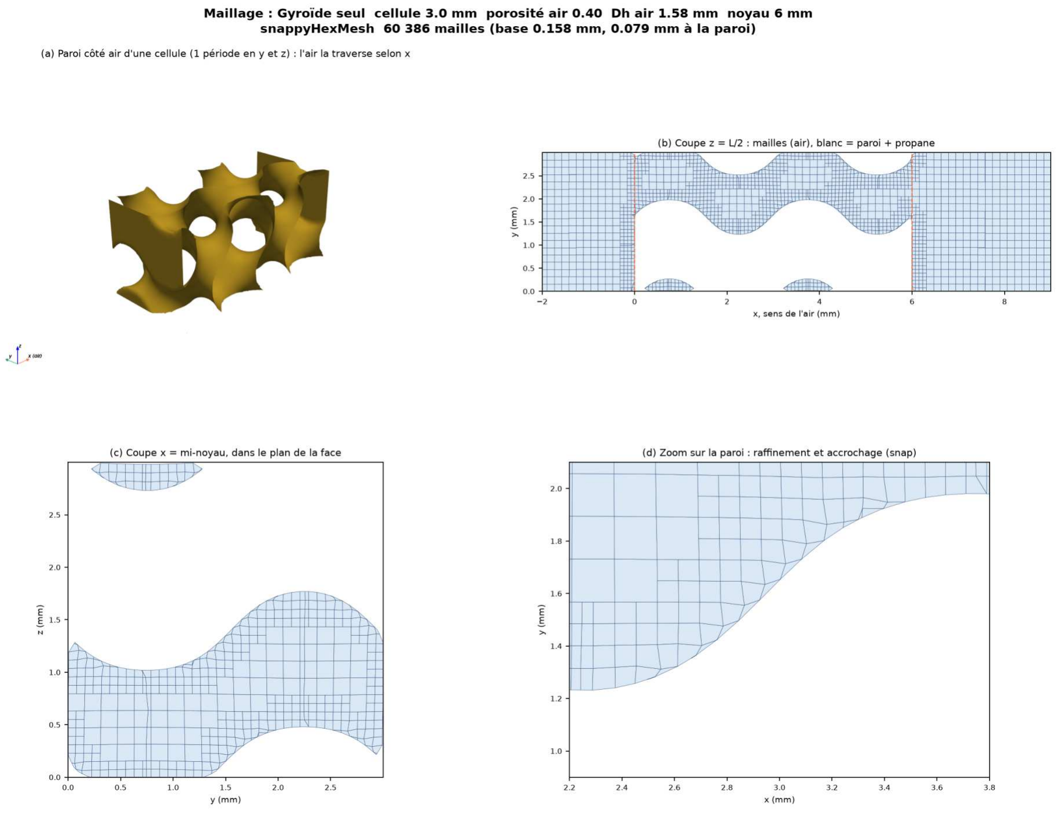
[picture p277: figure]

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

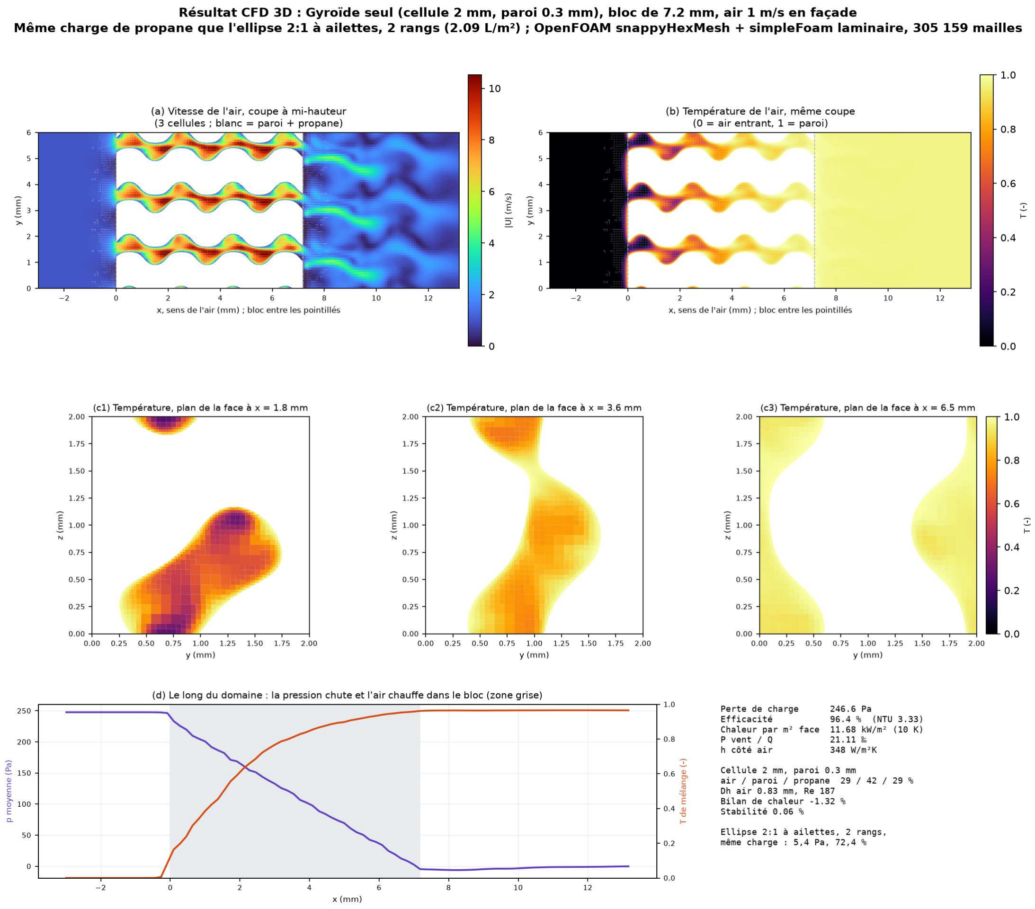
[picture p278: figure]

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

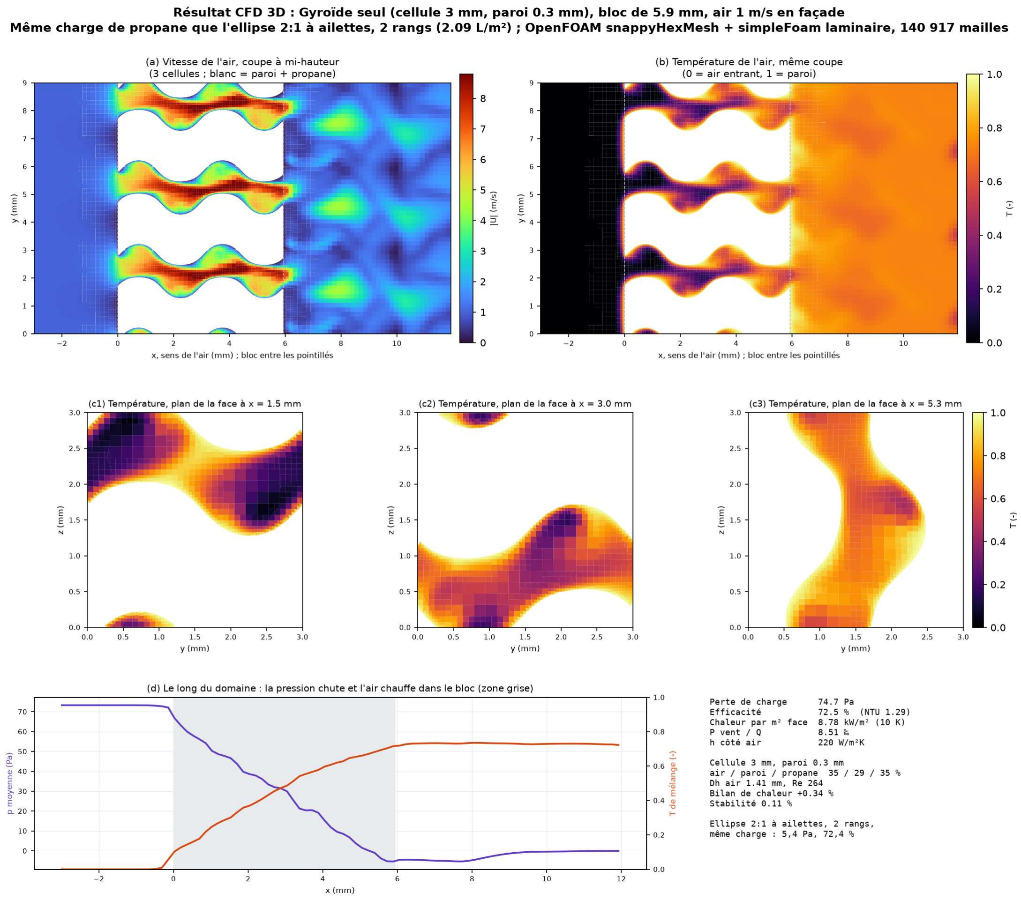
[picture p279: figure]

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

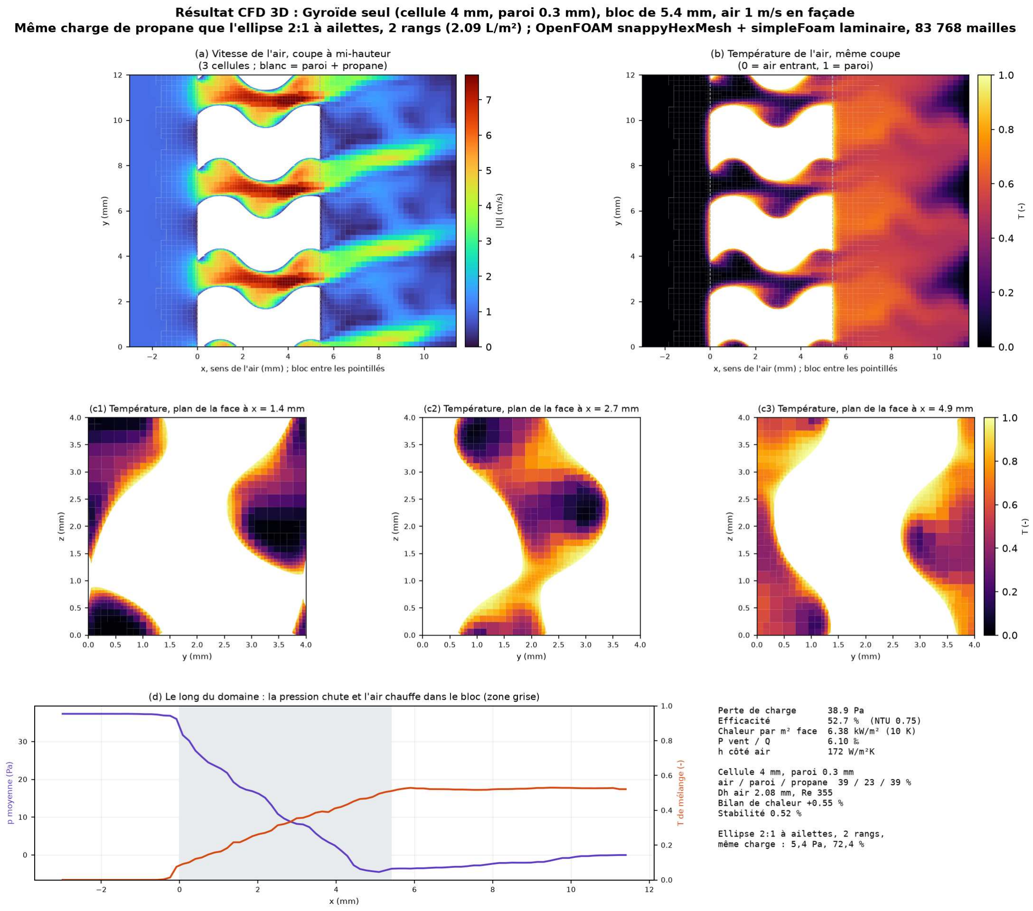
[picture p280: figure]

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

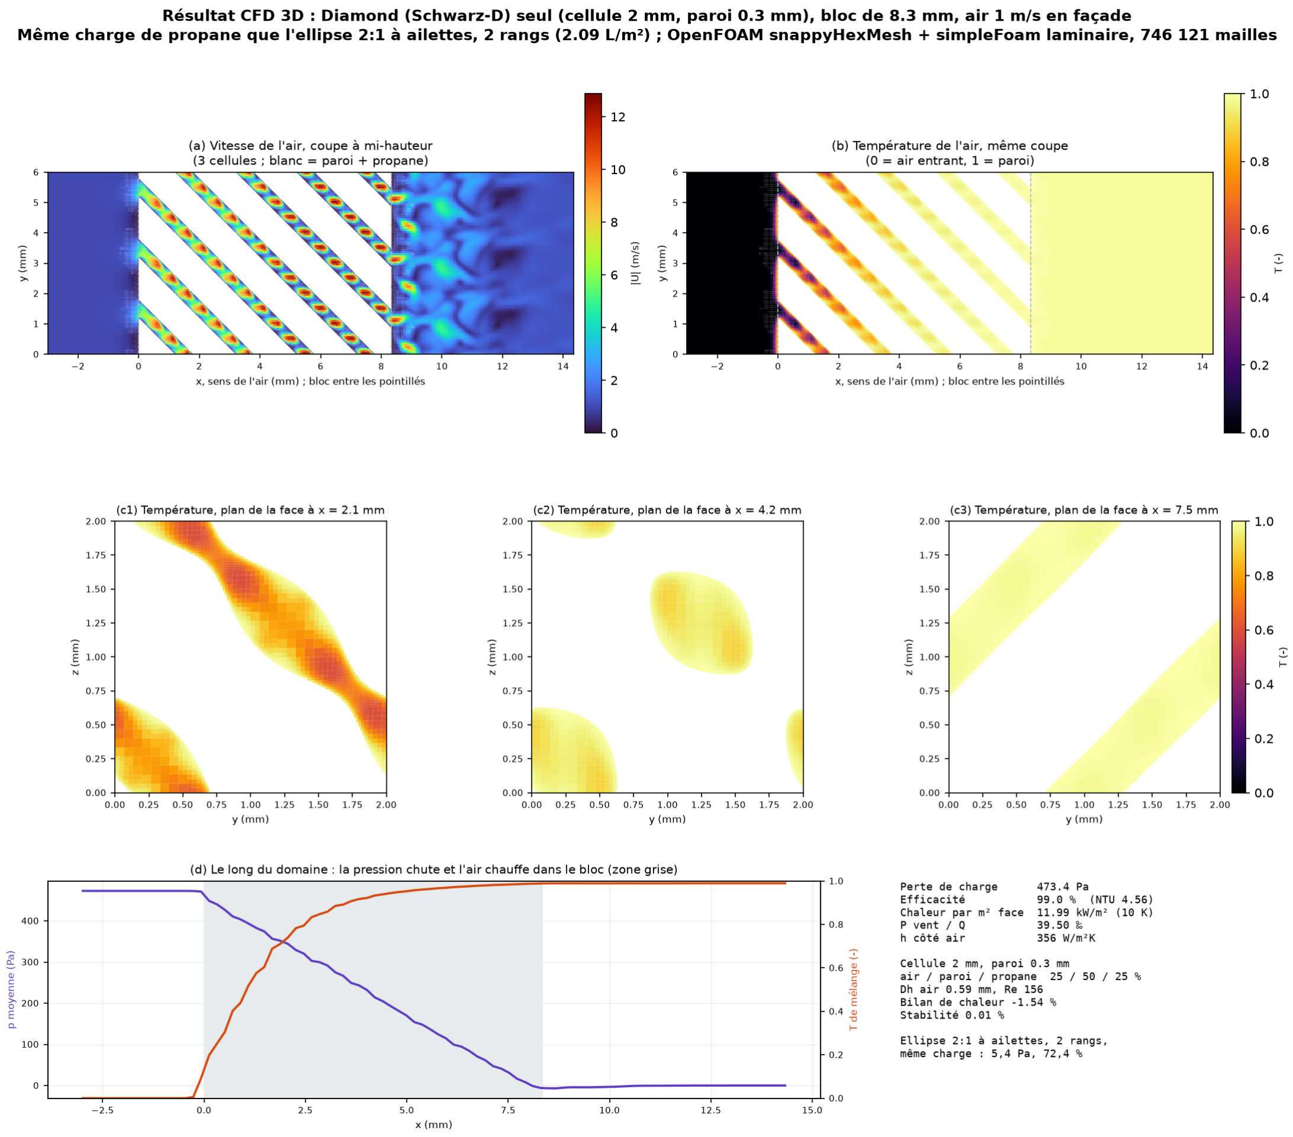
[picture p281: figure]

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

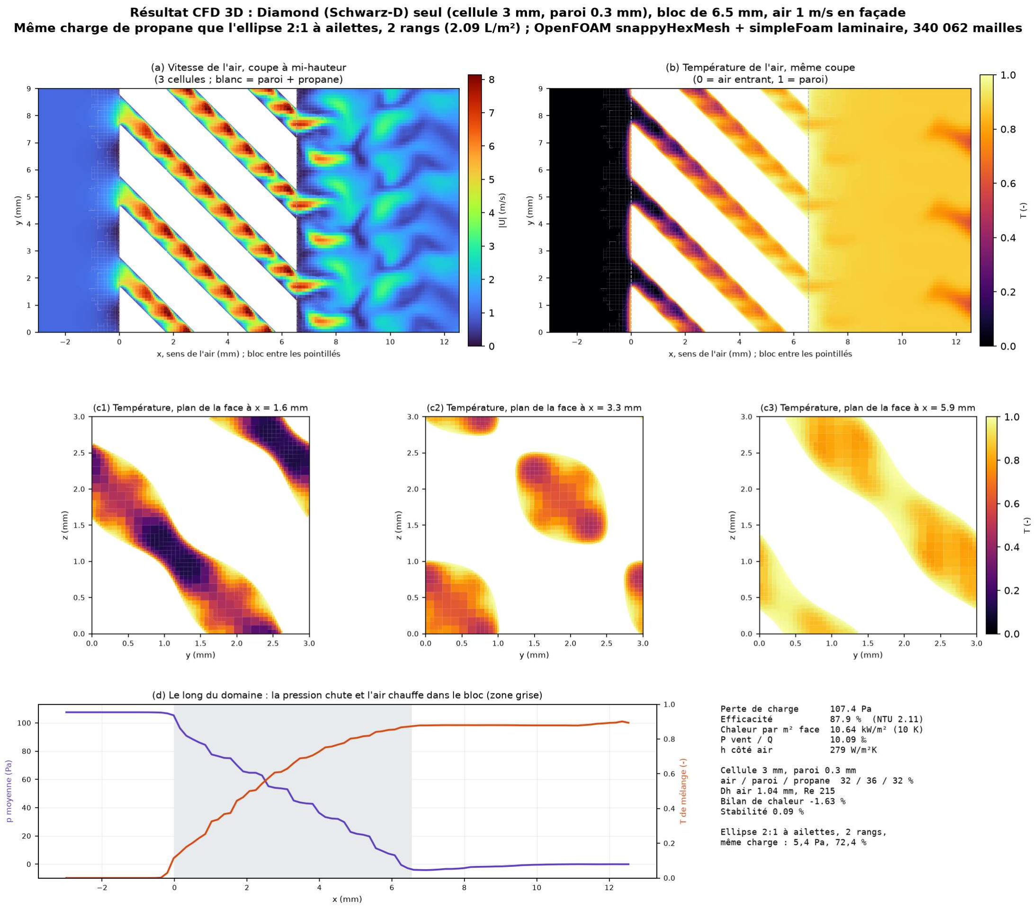
[picture p282: figure]

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

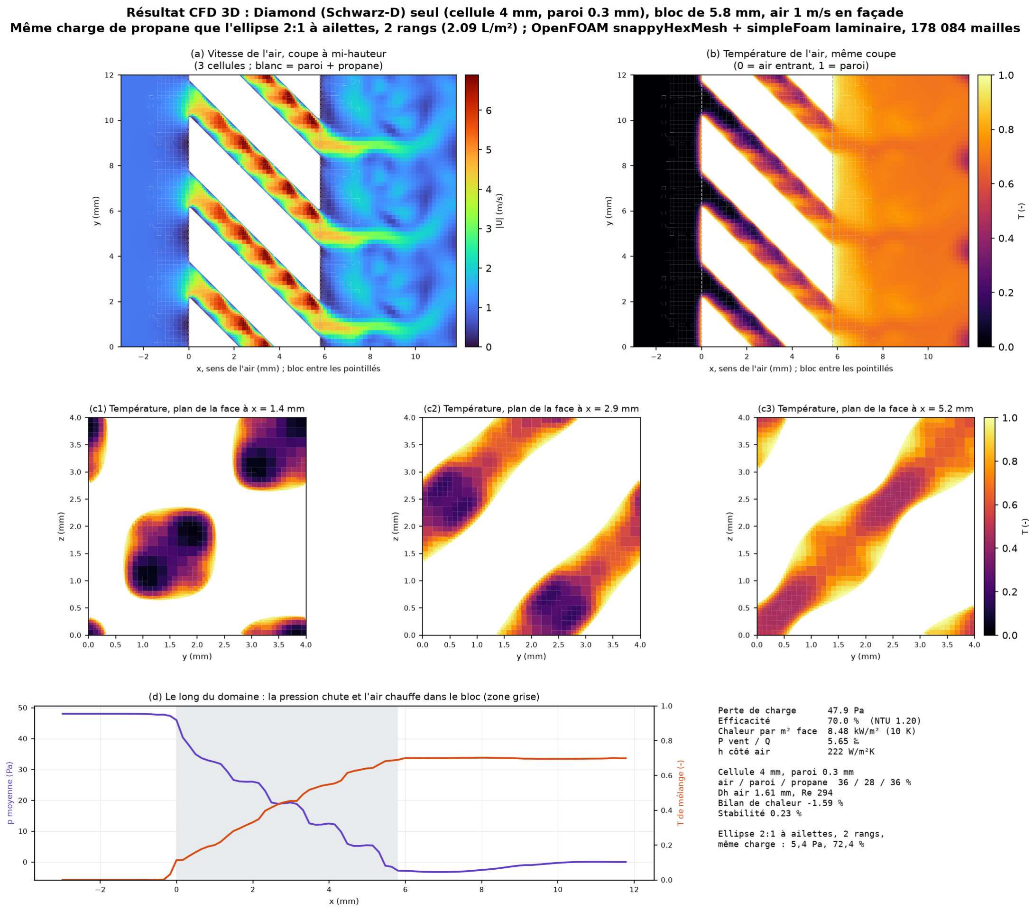
[picture p283: figure]

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

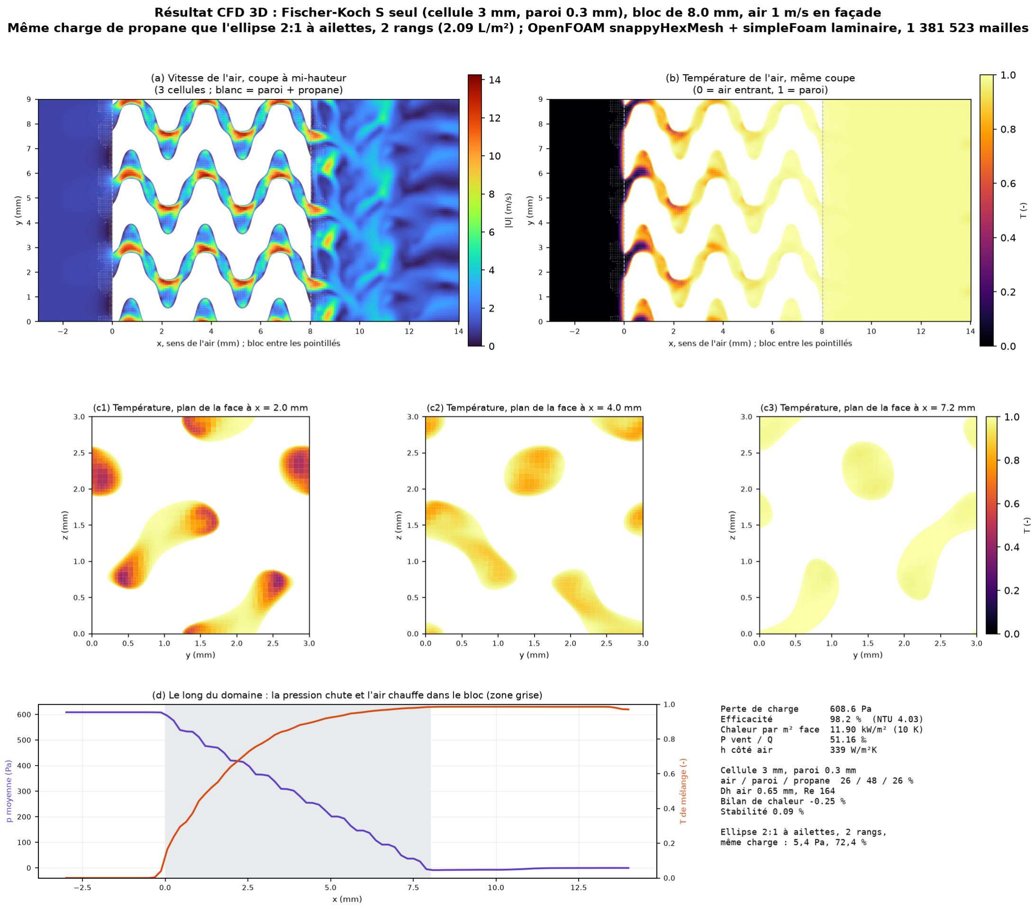
[picture p284: figure]

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

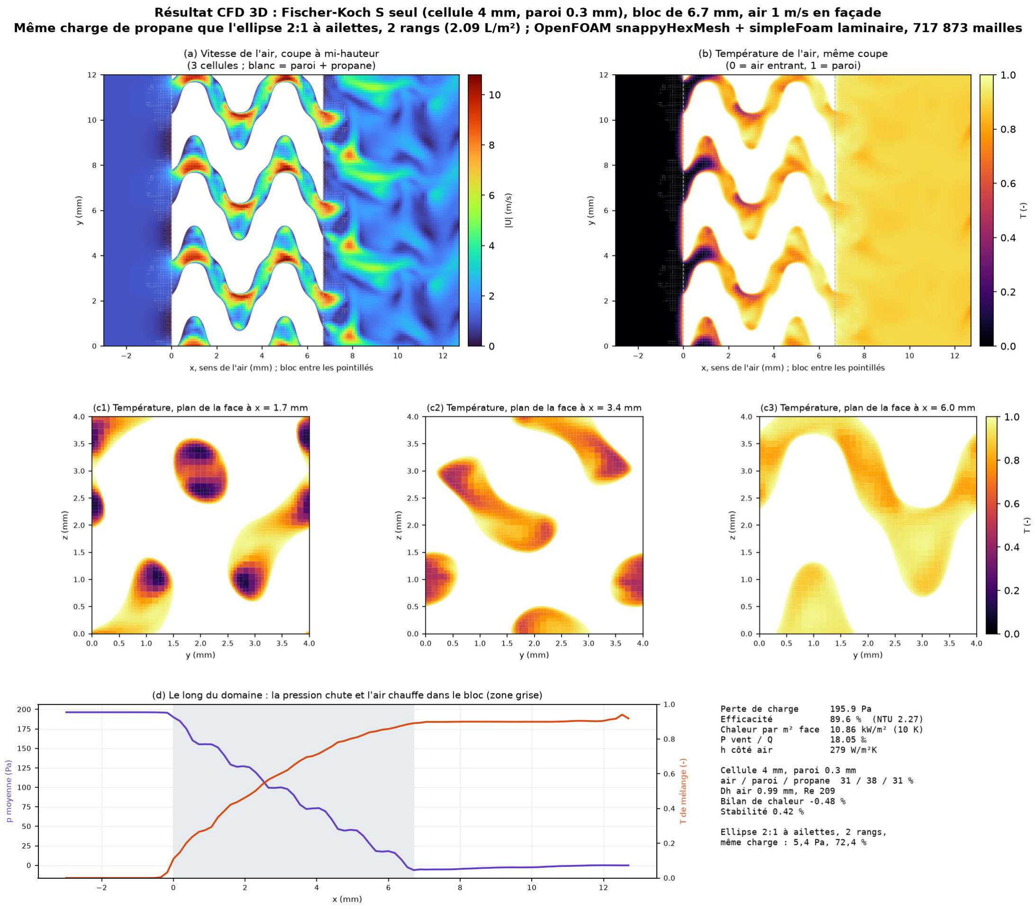
[picture p285: figure]

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

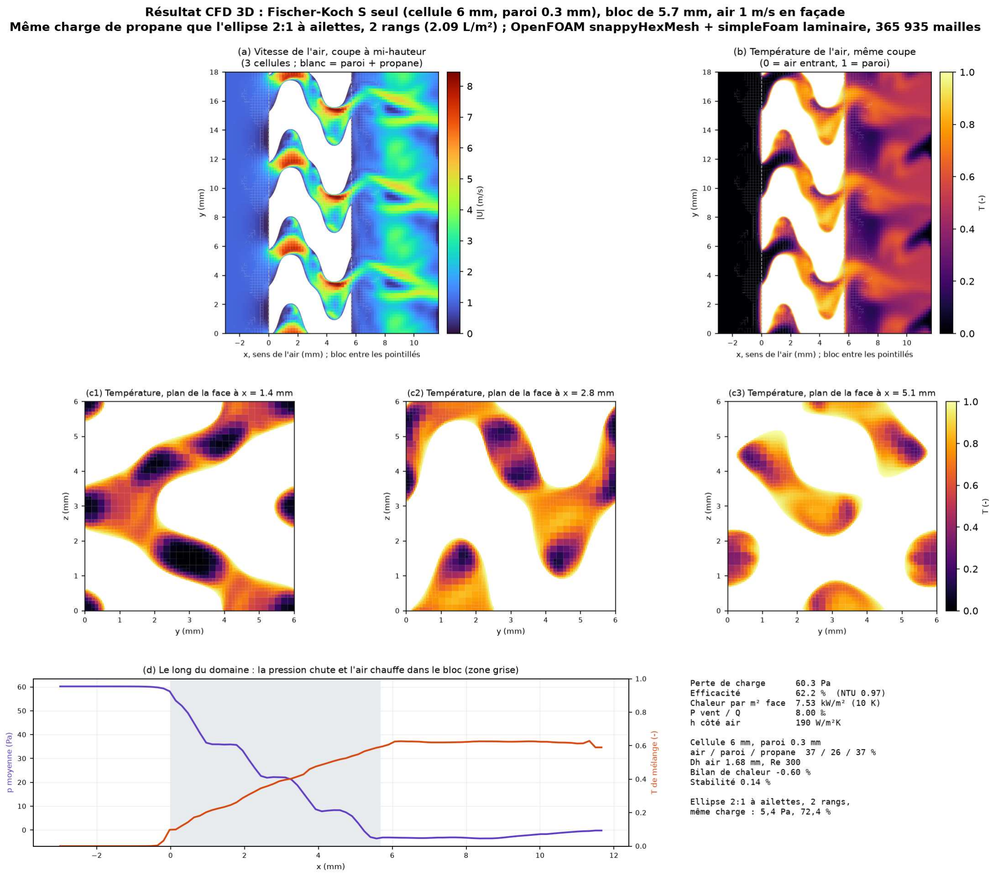
[picture p286: figure]

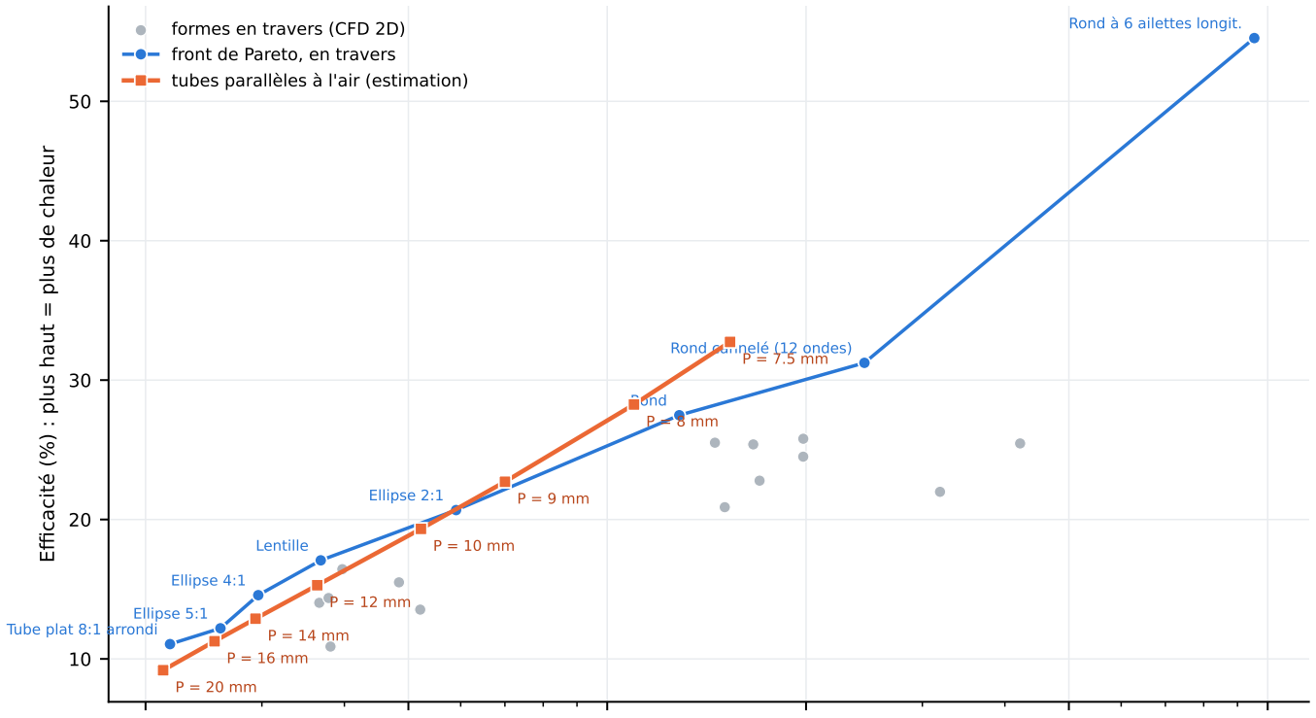
[picture p287: figure]
Tube plat 8:1 arrondi; Ellipse 5:1; Ellipse 4:1; Lentille; Ellipse 2:1; Rond; Rond cannelé (12 ondes); Rond à 6 ailettes longit.; formes en travers (CFD 2D) front de Pareto, en travers tubes parallèles à l'air (estimation)

0.2 | 0.5 | 1 | 2 | 5 | 10
| P vent / Q (

## , 10 K d'écart air / paroi) : plus bas = moins de ventilateur

## E cacité (%) : plus haut = plus de chaleur

Pas P (mm) | P / D | Prof. (mm) | Re (Dh) | p (Pa) | h (W/m²K) | Ecacité | P vent / Q (-
) | Fiabilité
7.5 | 1.25 | 16 | 682 | 6.08 | 76.5 | 32.7 % | 1.53 | faible (P/D < 1,5)
8 | 1.33 | 18 | 776 | 3.76 | 64.0 | 28.2 % | 1.10 | faible (P/D < 1,5)
9 | 1.50 | 23 | 982 | 1.93 | 49.7 | 22.7 % | 0.70 | bonne
10 | 1.67 | 29 | 1212 | 1.22 | 41.4 | 19.3 % | 0.52 | bonne
12 | 2.00 | 42 | 1746 | 0.67 | 32.0 | 15.3 % | 0.36 | bonne
14 | 2.33 | 57 | 2376 | 0.46 | 26.6 | 12.9 % | 0.29 | transition ?
16 | 2.67 | 74 | 3103 | 0.35 | 23.0 | 11.3 % | 0.25 | transition ?
20 | 3.33 | 115 | 4849 | 0.24 | 18.6 | 9.2 % | 0.21 | transition ?
Rond en travers | 2.00 | 37 | | 4.28 | 61.9 | 27.5 % | 1.29 | CFD 2D

# Piste : tubes parallèles à l'air (estimation, à valider en CFD 3D)

Tubes ronds Ø 6 mm couchés dans le sens de l'air, en réseau triangulaire de pas P dans le plan de la face ; air à 1 m/s.
Même tube et même charge de propane que la batterie de référence : la profondeur découle du pas (même longueur de tube par m² de face). Calcul analytique, pas CFD : couche limite laminaire en développement dans l'anneau équivalent à la cellule, pertes aux bouts.

# Résultats à charge égale (1 m/s)

Vérication du calcul sur le canal plan : f·Re = 24.00 (exact 24), Nu = 7.53 (exact 7,54) ; zone d'entrée à moins de 2,5 % de la corrélation de Shah.

## Fiabilité : l'anneau équivalent n'est plus dèle sous P/D -

## 1,5 (passage très inégal autour du tube) ; au-delà de Re -

2 300 l'écoulement peut devenir turbulent. Collecteurs non comptés : ni leur volume de propane, ni leur obstacle à l'air. p et e cacité colorés du rouge au vert.

# Conclusion

Sur le papier, les tubes parallèles à l'air valent les meilleures formes en travers : la courbe suit le front de Pareto, un peu en dessous à pas large (P 10 mm), un peu au-dessus à pas serré (P 9 mm).
Raison : à charge égale les tubes sont courts (16 à 42 mm), l'air reste en régime d'entrée où l'échange est fort.
Les points au-dessus du front (P = 7,5 et 8 mm) sont ceux où le modèle est le moins able (passage inégal).
Exemple P = 8 mm : autant de chaleur que le rond en travers, 12 % de p en moins, 19 mm de profondeur au lieu de 37. Bilan : concurrent sérieux, pas une rupture ; l'écart au front reste dans l'incertitude (± 15 %).
Le juge sera le collecteur (milliers de tubes de 2 cm à raccorder), non compté ici ; avantage non compté :
contre-courant air / propane. Suite si on garde la piste : CFD 3D d'une cellule et dessin du collecteur.

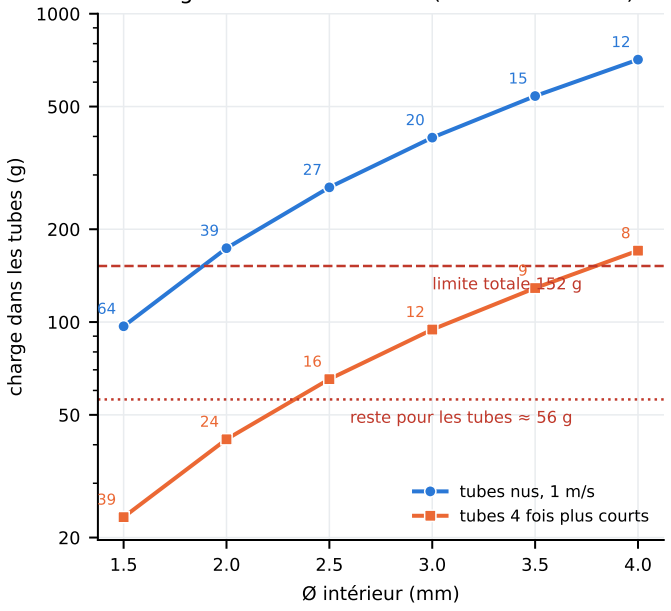
[picture p288: figure]
Ø intérieur (mm); charge dans les tubes (g); limite totale; reste pour; les tubes -; tubes nus, 1 m/s; tubes 4 fois plus courts

Charge des deux batteries (chires : circuits)

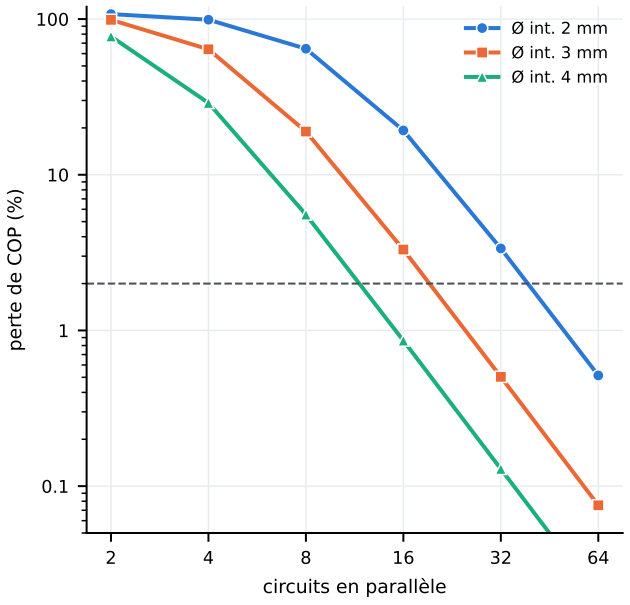
[picture p289: figure]
circuits en parallèle; perte de COP (%); Ø int. 2 mm; Ø int. 3 mm; Ø int. 4 mm

Perte de COP par la perte de charge (tubes nus)

Longueur | Ø int. (mm) Paroi (mm) Circuits Circuit cond. (m) Évap. (g) | Cond. (g) | Tubes (g) | Total (g)
Tubes nus, 1 m/s | 1.5 | 2.25 | 64 | 4.8 | 12 | 85 | 97 | 193
Tubes nus, 1 m/s | 2.0 | 2.00 | 39 | 7.9 | 22 | 151 | 174 | 269
Tubes nus, 1 m/s | 2.5 | 1.75 | 27 | 11.4 | 35 | 238 | 273 | 369
Tubes nus, 1 m/s | 3.0 | 1.50 | 20 | 15.4 | 51 | 345 | 396 | 492
Tubes nus, 1 m/s | 3.5 | 1.25 | 15 | 20.5 | 70 | 471 | 541 | 637
Tubes nus, 1 m/s | 4.0 | 1.00 | 12 | 25.6 | 92 | 618 | 710 | 806
4 fois plus courts | 1.5 | 2.25 | 39 | 2.0 | 3 | 20 | 23 | 119
4 fois plus courts | 2.0 | 2.00 | 24 | 3.2 | 5 | 36 | 42 | 138
4 fois plus courts | 2.5 | 1.75 | 16 | 4.8 | 8 | 57 | 65 | 161
4 fois plus courts | 3.0 | 1.50 | 12 | 6.4 | 12 | 83 | 95 | 190
4 fois plus courts | 3.5 | 1.25 | 9 | 8.5 | 16 | 113 | 129 | 225
4 fois plus courts | 4.0 | 1.00 | 8 | 9.6 | 22 | 149 | 170 | 266

# Côté propane : diamètre intérieur des tubes (estimation)

Tube de Ø extérieur 6 mm (côté air inchangé) ; le canal intérieur rétrécit quand la paroi s'épaissit. Climatisation nominale : évaporation 10 °C, condensation 46 °C, 2,3 kW de froid. Longueur de tube tirée de la CFD (tubes nus, 4 rangs, 1 m/s) : 144 m à l'évaporateur, 307 m au condenseur. Pour chaque diamètre : le nombre minimal de circuits en parallèle pour perdre au plus 2 % de COP par la perte de charge du propane.

# Résultats (perte de COP ≤ 2 %)

Total : tubes + reste du circuit (96 g selon les volumes du simulateur : huile du compresseur, carter, ligne liquide). Collecteurs et distributeurs non comptés. Charge : fraction de vide de Rouhani-Axelsson ; perte de charge : Müller-Steinhagen et Heck ; COP : sensibilité de Carnot (-3 % par K perdu) ;
au-delà d'environ 20 % de perte de COP, la valeur n'est plus qu'indicative (perte de charge comparable à la pression). Charges colorées du rouge au vert.

# Conclusion

Le diamètre intérieur est un levier fort : la charge varie comme son carré. Passer de 4 à 2 mm la divise par 4.
Mais il faut alors 3 fois plus de circuits en parallèle pour garder la perte de charge du propane (39 au lieu de 12). Le vrai problème est la longueur : en tubes nus à 1 m/s il faut -450 m de tube, et le total dépasse la limite à tous les diamètres, même 1,5 mm (193 g avec 64 circuits). Le reste du circuit prend déjà -95 g sur 152.
Le condenseur porte 87 % de la charge des tubes (liquide et diphasique dense) : c'est lui qu'il faut réduire. Avec des tubes 4 fois plus courts (ailettes, air plus rapide) : Ø 2 mm tient dans la limite (138 g, 24 circuits). Conclusion : canal n ET tubes courts ; l'étape 3 (ailettes) devient prioritaire, et les collecteurs sont à

concevoir avec soin, car leur volume s'ajoute (non compté ici).

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

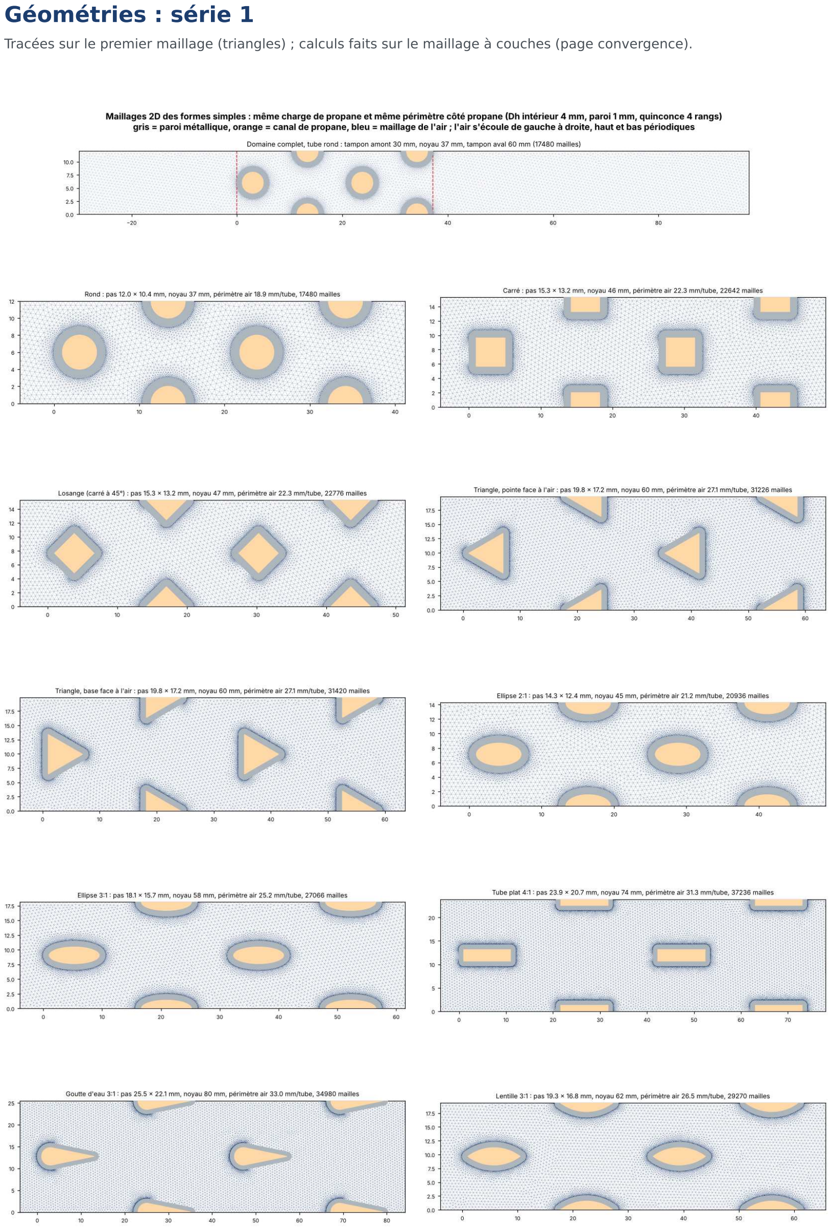
[picture p290: page 36]

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

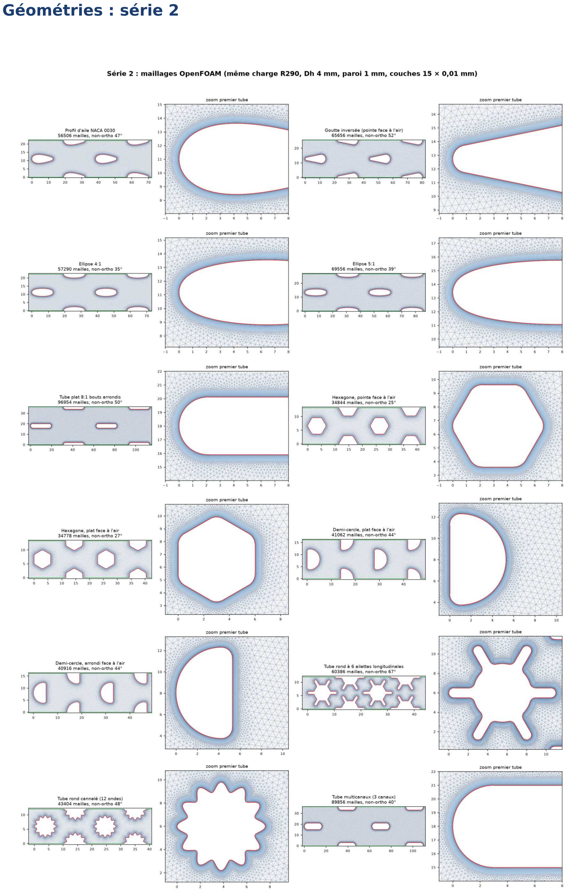
[picture p291: page 37]

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
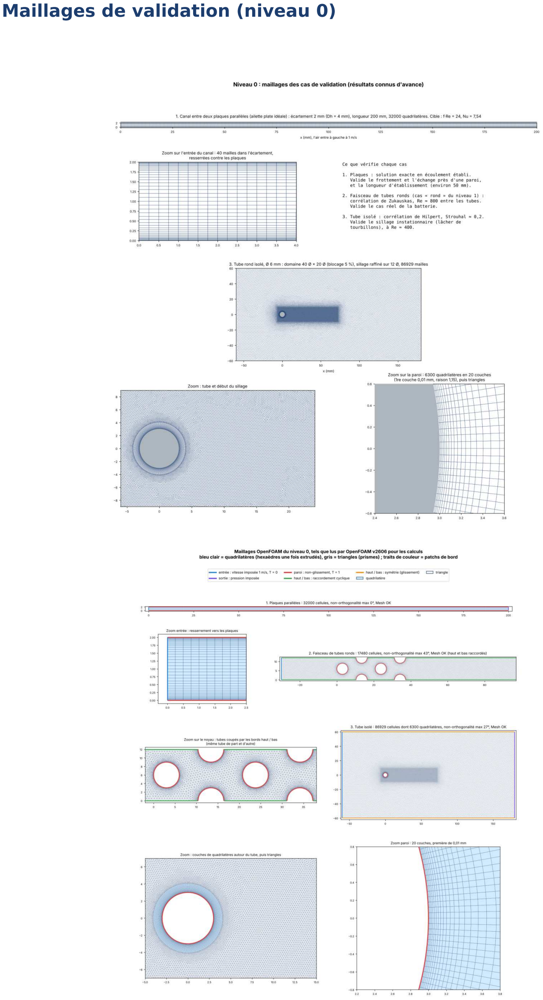
[picture p292: page 92]

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

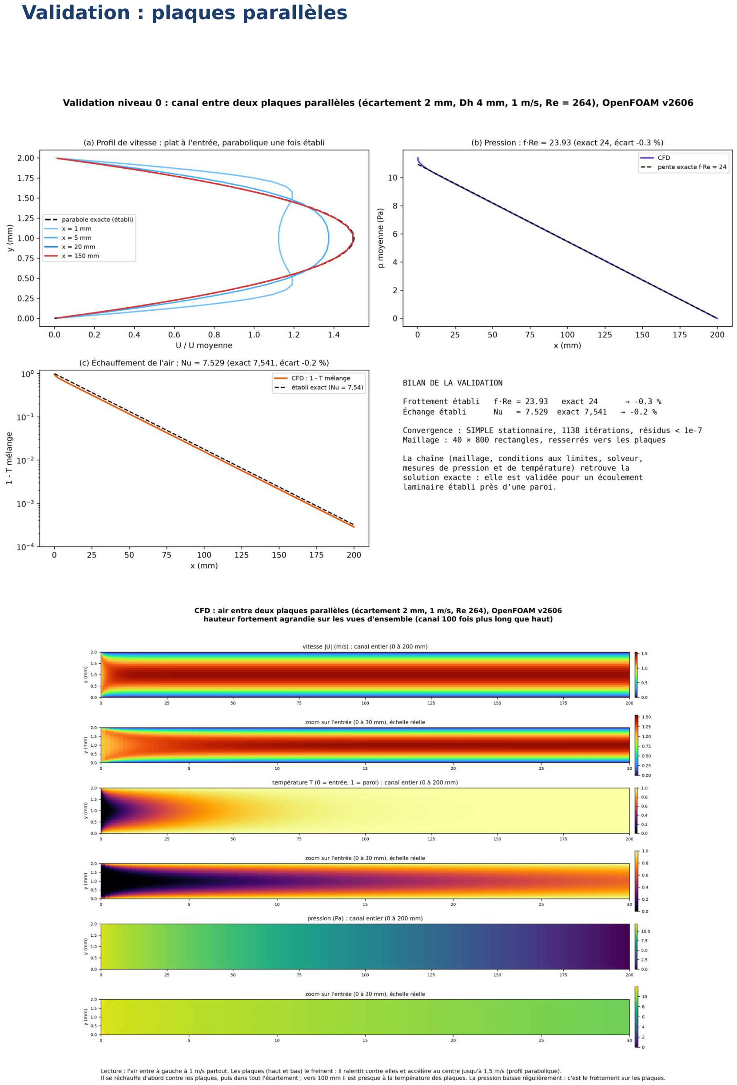
[picture p293: page 93]

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

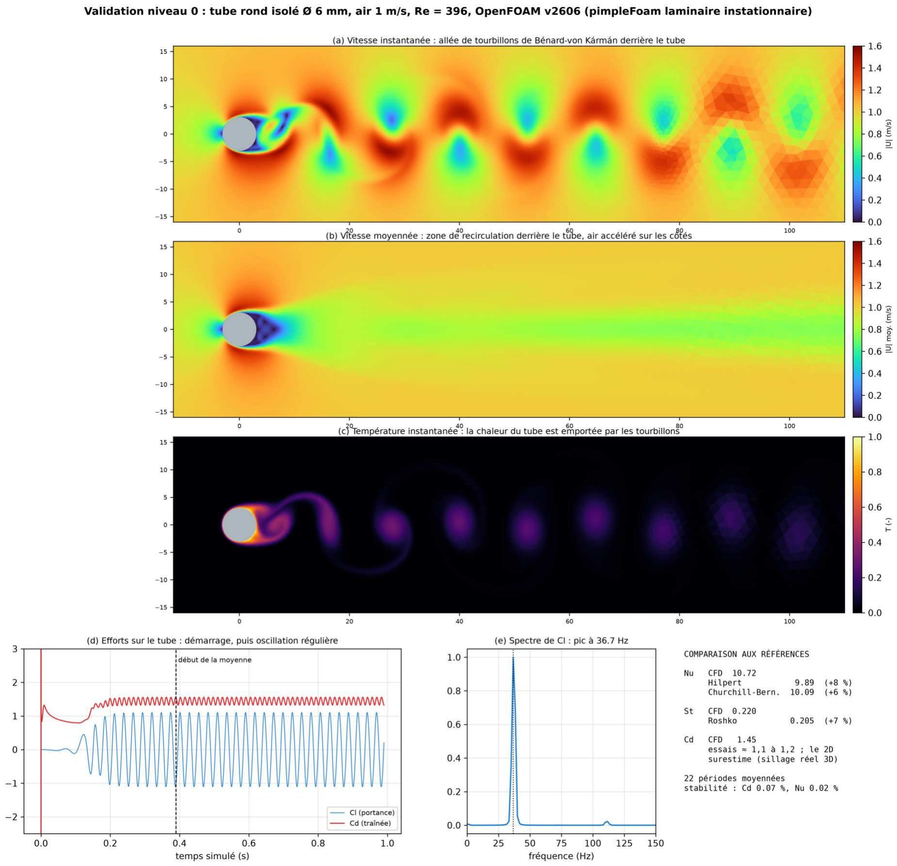
[picture p294: figure]

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

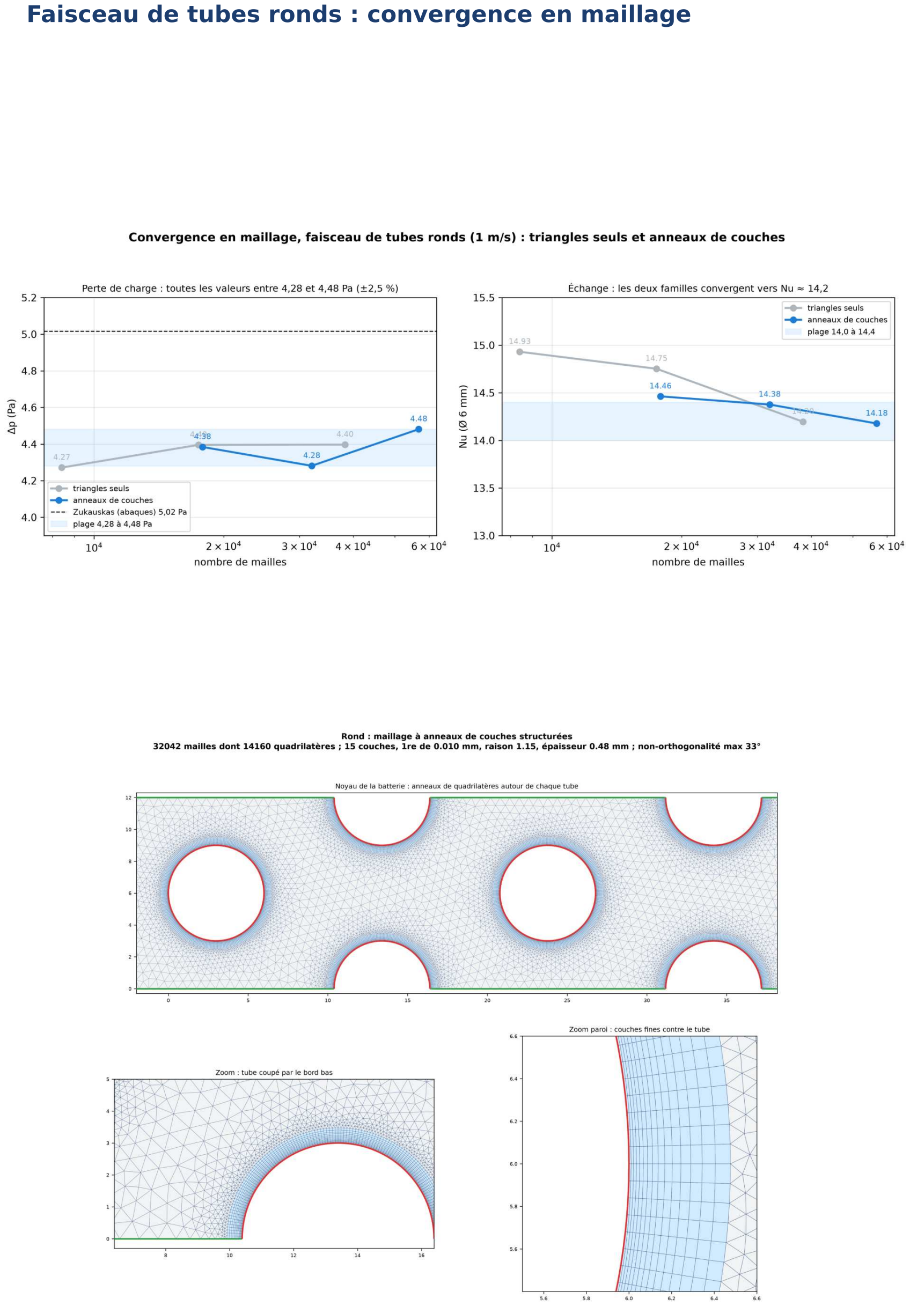
[picture p295: page 95]

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

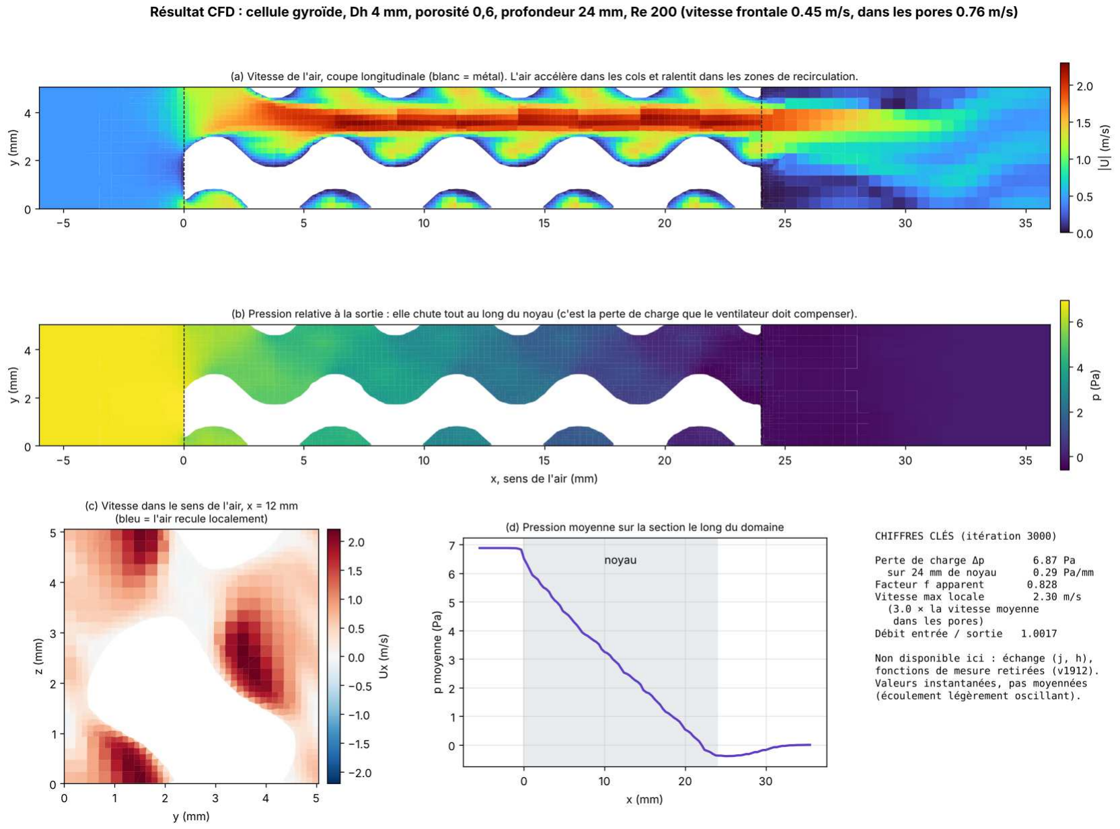
[picture p296: figure]

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

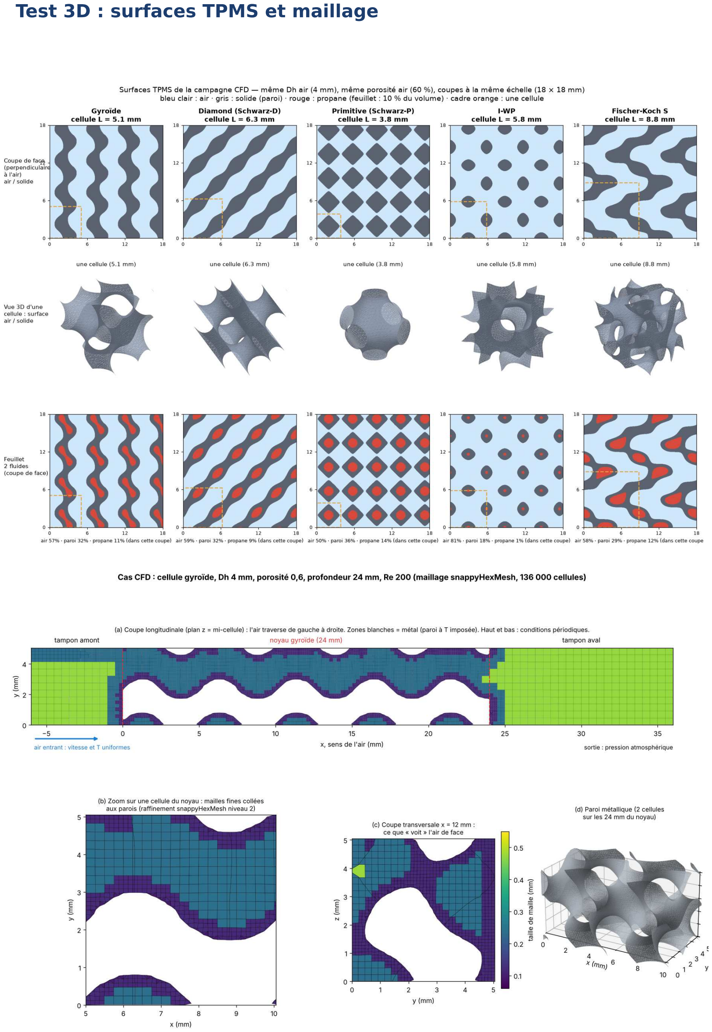
[picture p297: page 98]
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
