ET-FR/HP_new_generation/conception_ventilateur/resultats_predimensionnement.md

## 1. Poids des ventilateurs dans le COP

| COP visé | Puissance élec. totale W | Ventilateurs 76 W (η 0,30) | Ventilateurs 40 W (η ≈ 0,55) | COP si 76 → 40 W |
|---|---|---|---|---|
| 4,0 | 660 | 12 % | 6 % | 4,23 |
| 6,0 | 440 | 17 % | 9 % | 6,54 |

## 2. Perte de sortie d'un axial libre (énergie cinétique perdue)

| Échangeur | D mm | moyeu/D | c sortie m/s | ½ρc² Pa | Δp_total Pa | part perdue |
|---|---|---|---|---|---|---|
| intérieur | 200 | 0,35 | 8,1 | 39,0 | 64,0 | 61 % |
| intérieur | 250 | 0,35 | 5,2 | 16,0 | 41,0 | 39 % |
| intérieur | 300 | 0,35 | 3,6 | 7,7 | 32,7 | 24 % |
| extérieur | 300 | 0,35 | 11,2 | 75,2 | 100,2 | 75 % |
| extérieur | 400 | 0,35 | 6,3 | 23,8 | 48,8 | 49 % |
| extérieur | 500 | 0,35 | 4,0 | 9,7 | 34,7 | 28 % |

La composante tangentielle (giration) s'ajoute si rien ne la redresse (stator, aubes directrices).

## 3. Axial, ψ = 0,20, perte de sortie récupérée à 50 % (diffuseur court)

| Échangeur | D mm | Δp_t Pa | u bout m/s | tr/min | φ | P élec. W à η = 0,30 / 0,45 / 0,60 |
|---|---|---|---|---|---|---|
| intérieur | 200 | 44,5 | 19,3 | 1839 | 0,37 | 33 / 22 / 16 |
| intérieur | 250 | 33,0 | 16,6 | 1267 | 0,27 | 24 / 16 / 12 |
| intérieur | 300 | 28,9 | 15,5 | 987 | 0,20 | 21 / 14 / 11 |
| extérieur | 300 | 62,6 | 22,8 | 1454 | 0,43 | 145 / 97 / 72 |
| extérieur | 400 | 36,9 | 17,5 | 837 | 0,32 | 85 / 57 / 43 |
| extérieur | 500 | 29,9 | 15,8 | 603 | 0,22 | 69 / 46 / 35 |

φ hors de 0,15–0,35 : diamètre mal adapté au débit. Le bruit croît comme u⁵ à u⁶ : à débit égal, le grand diamètre lent gagne.

## 4. Rendement statique mesuré : ebm-papst W1G200-EC87-20

| tr/min | m³/h | Δp Pa | P élec. W | η statique global |
|---|---|---|---|---|
| 1300 | 410 | 10 | 8,0 | 0,14 |
| 1300 | 370 | 18 | 8,0 | 0,23 |
| 1300 | 320 | 23 | 8,0 | 0,26 |
| 900 | 280 | 5 | 4,0 | 0,10 |
| 900 | 250 | 8 | 4,1 | 0,14 |
| 900 | 220 | 11 | 4,0 | 0,17 |

Un bon ventilateur EC de 200 mm du commerce : η ≈ 0,2–0,3 au point utile. L'hypothèse 0,30 du cahier des charges est donc « bon produit standard » ; la cible du dossier est 0,50–0,60.
