ET-FR/HP_new_generation/conception_echangeur/docs/formes/carre/resultat.png

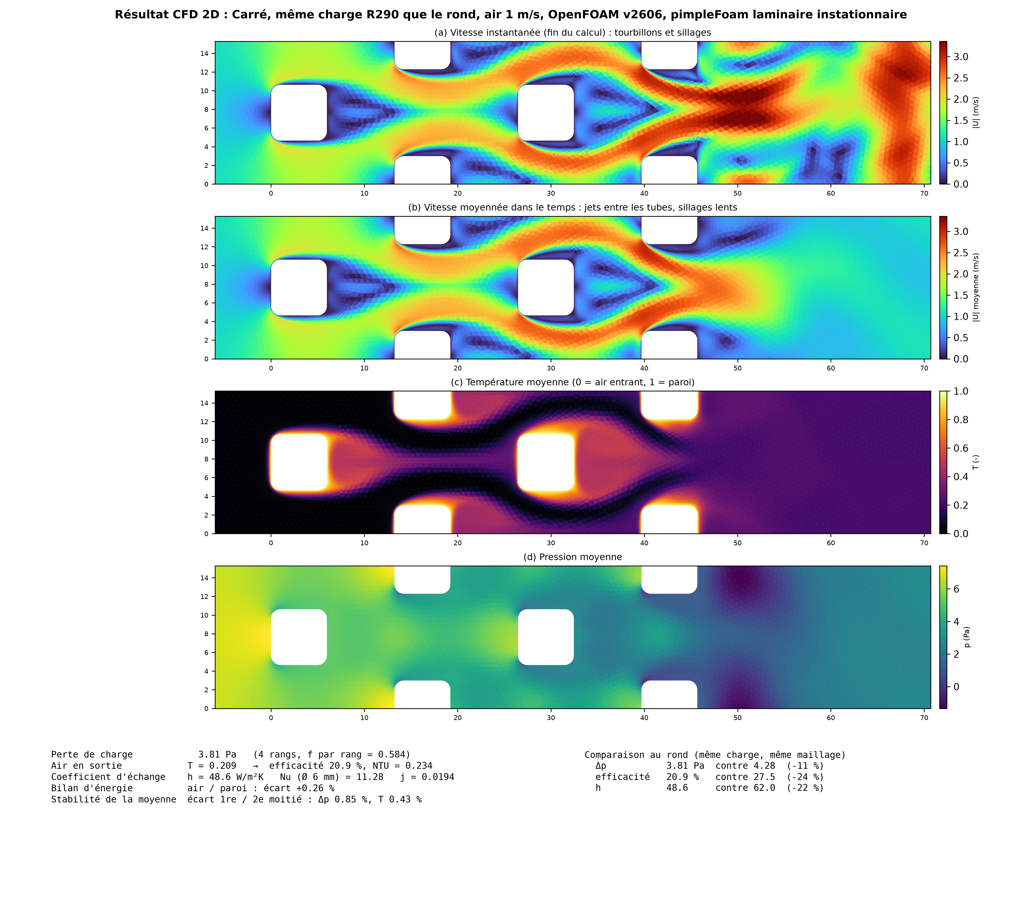
conception_echangeur/docs/formes/carre/resultat.png
