ET-FR/HP_new_generation/conception_echangeur/docs/formes/cylindre_radial/variante_f/imprime/cfd/resultat_avec_temperature_radial.png

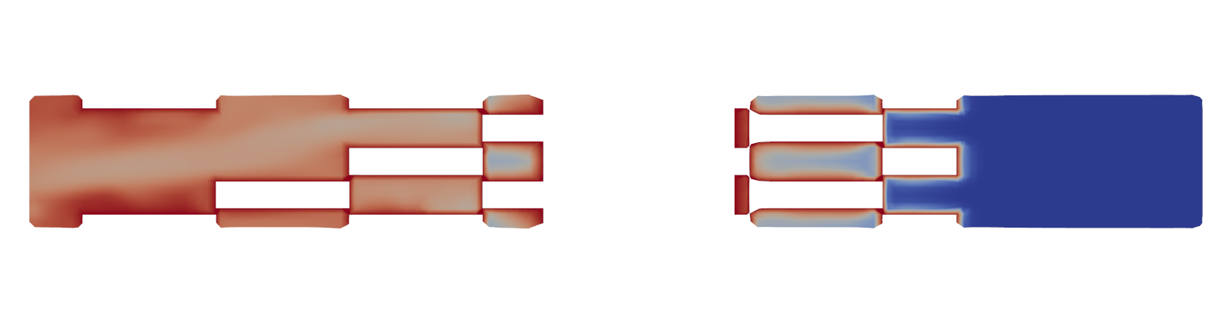
conception_echangeur/docs/formes/cylindre_radial/variante_f/imprime/cfd/resultat_avec_temperature_radial.png
