ET-FR/HP_new_generation/conception_echangeur/docs/formes/cylindre_radial/variante_f/imprime/cfd/resultat_secteur_continu_p5_temperature_y.png

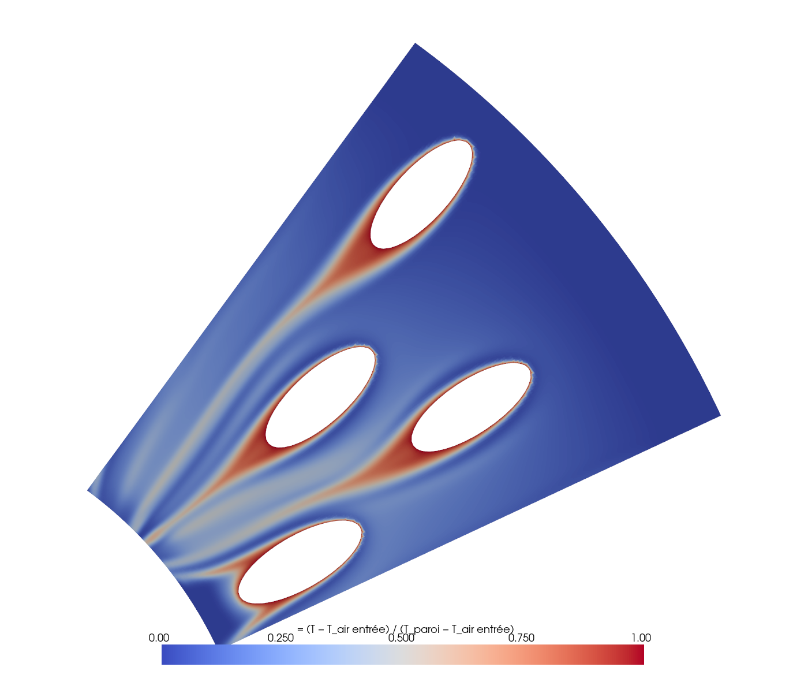
conception_echangeur/docs/formes/cylindre_radial/variante_f/imprime/cfd/resultat_secteur_continu_p5_temperature_y.png
