ET-FR/HP_new_generation/conception_echangeur/docs/formes/demi_cercle_rond/resultat.png

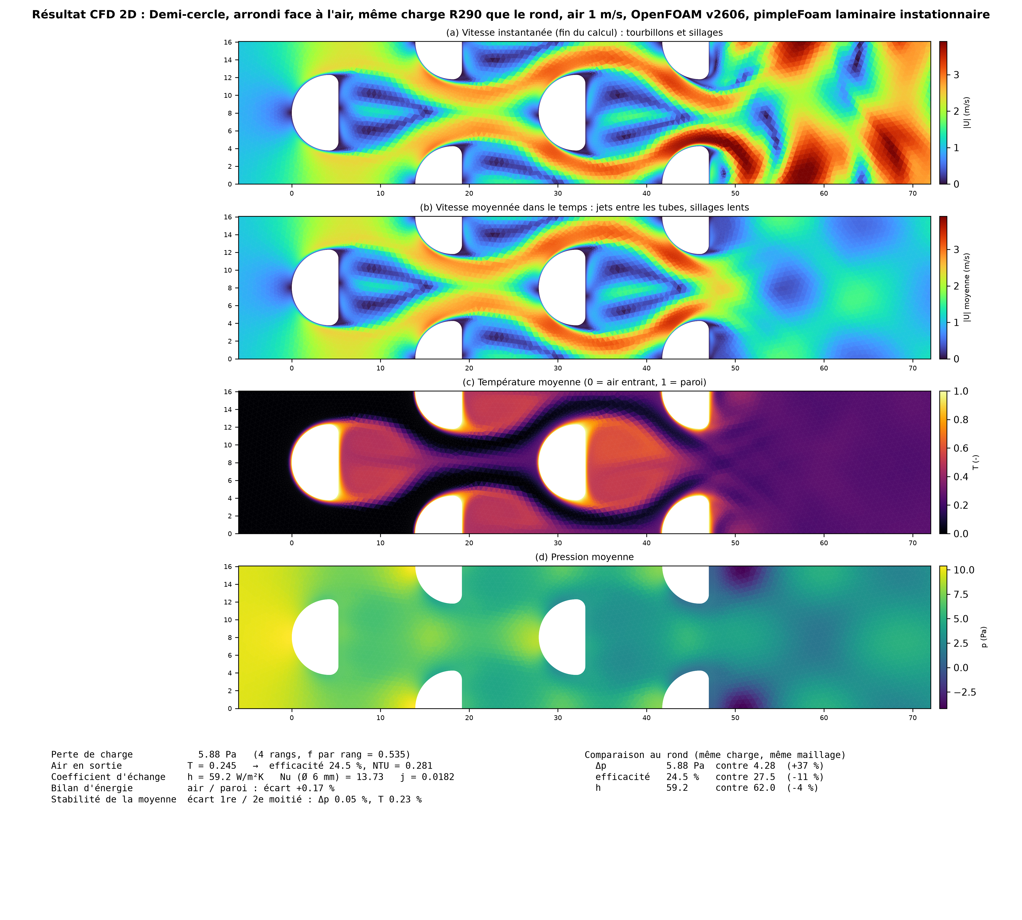
conception_echangeur/docs/formes/demi_cercle_rond/resultat.png
