ET-FR/HP_new_generation/conception_echangeur/docs/formes/ellipse2/resultat.png

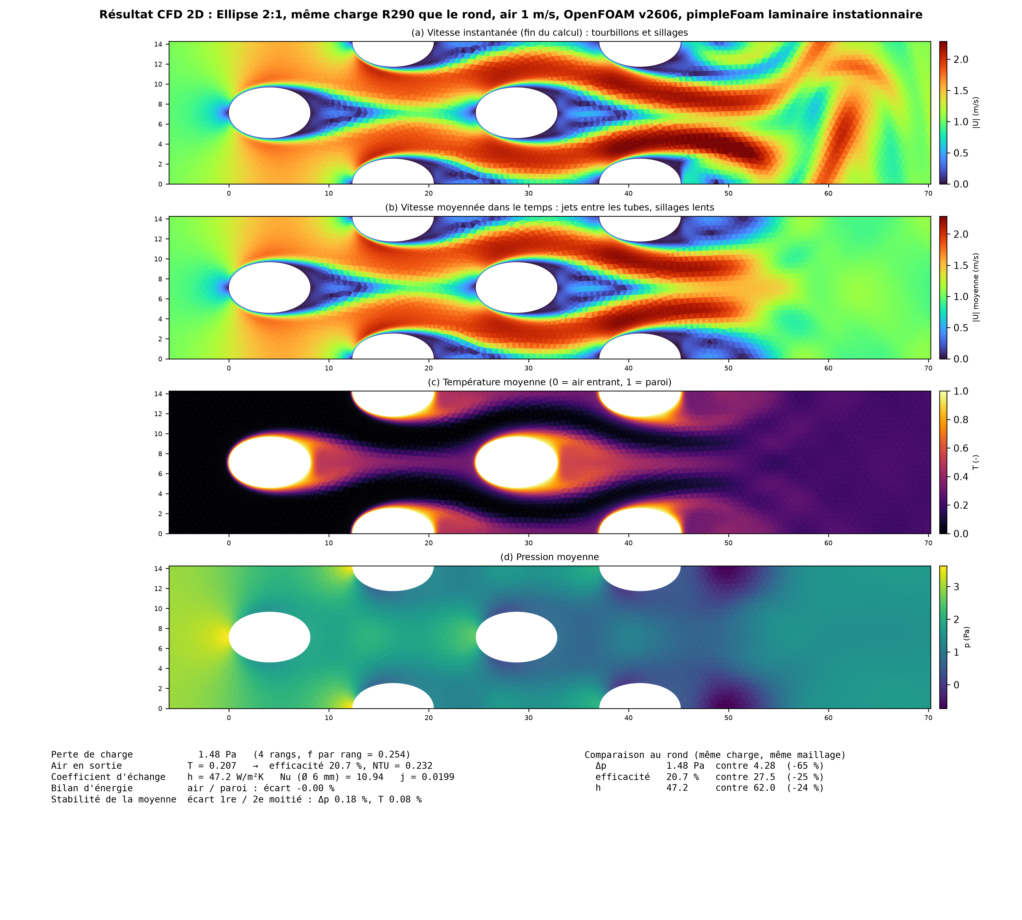
conception_echangeur/docs/formes/ellipse2/resultat.png
