ET-FR/HP_new_generation/conception_echangeur/docs/formes/ellipse2/resultat_ail1.8_r2_ond.png

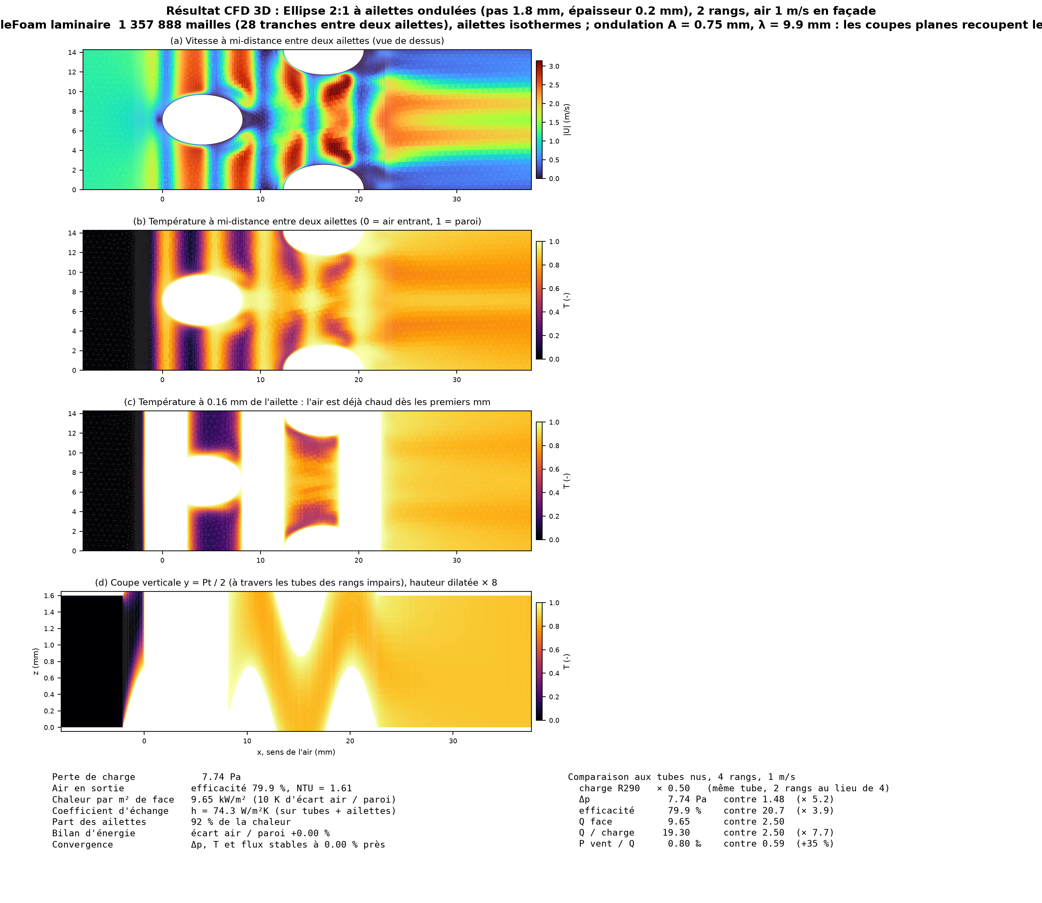
conception_echangeur/docs/formes/ellipse2/resultat_ail1.8_r2_ond.png
