ET-FR/HP_new_generation/conception_echangeur/docs/formes/ellipse2/resultat_N2_pt1.5.png

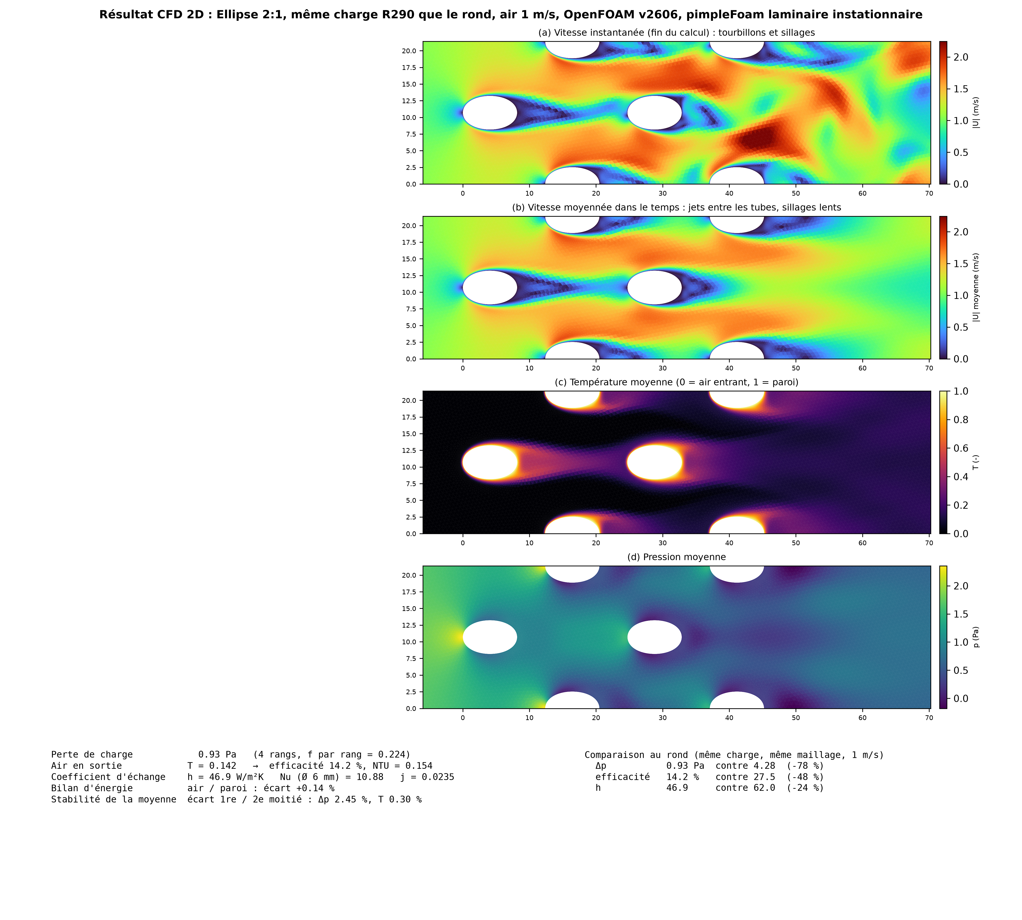
conception_echangeur/docs/formes/ellipse2/resultat_N2_pt1.5.png
