ET-FR/HP_new_generation/conception_echangeur/docs/formes/ellipse2/resultat_N2_rangs2.png

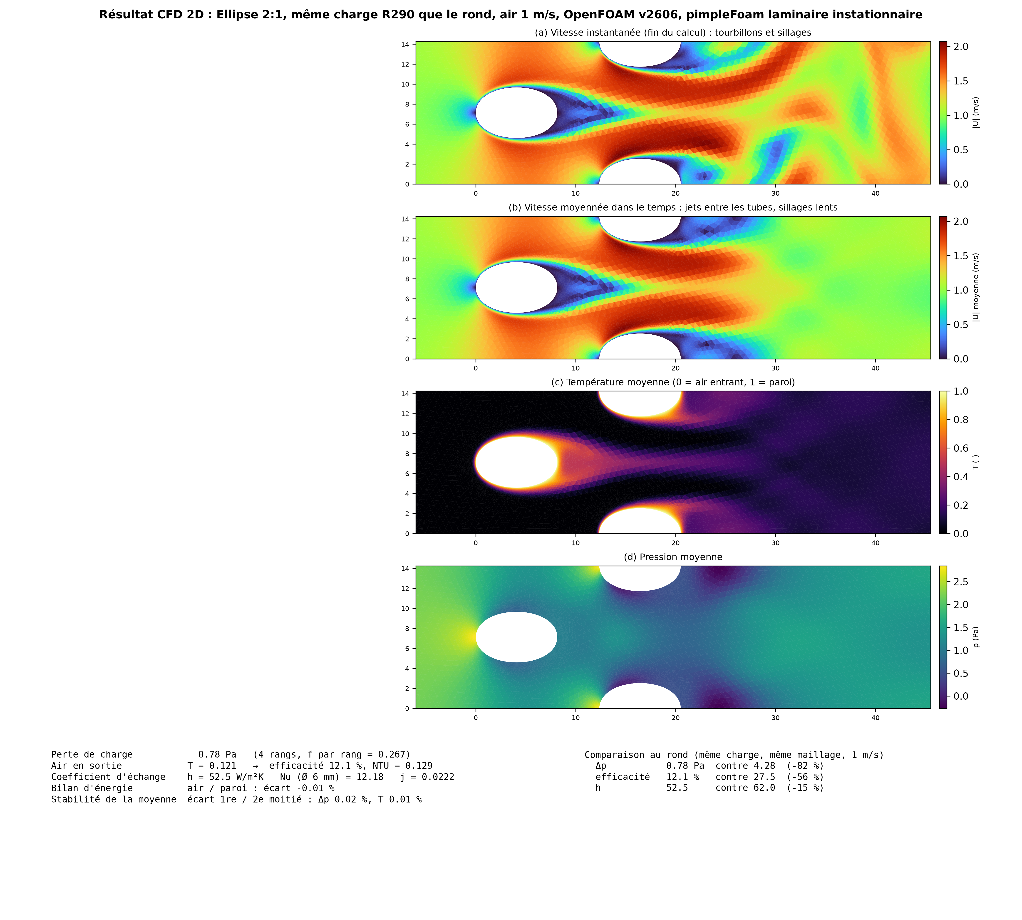
conception_echangeur/docs/formes/ellipse2/resultat_N2_rangs2.png
