ET-FR/HP_new_generation/conception_echangeur/docs/formes/ellipse2/resultat_r2_gyroide6.png

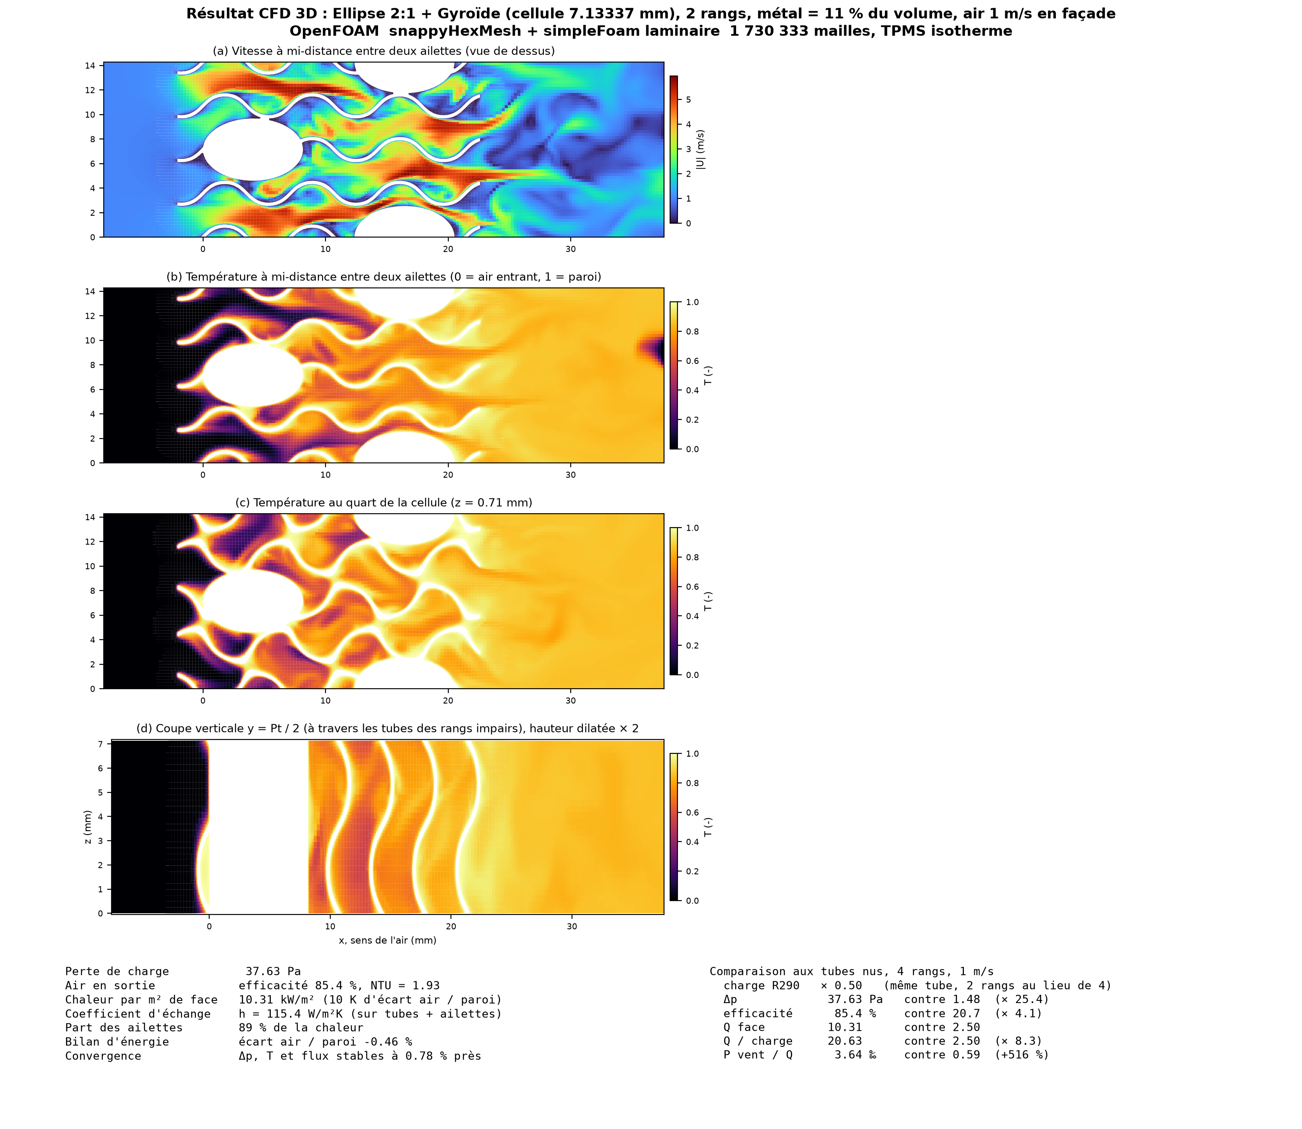
conception_echangeur/docs/formes/ellipse2/resultat_r2_gyroide6.png
