ET-FR/HP_new_generation/conception_echangeur/docs/formes/ellipse3/resultat.png

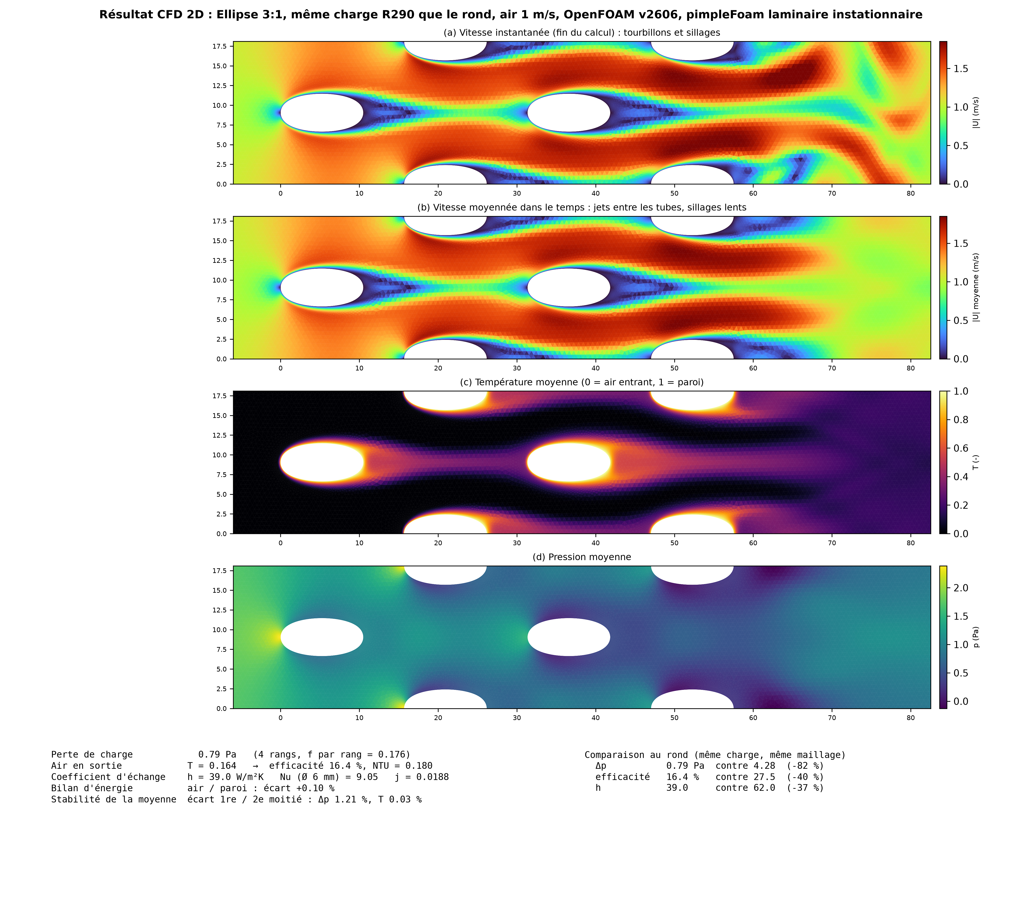
conception_echangeur/docs/formes/ellipse3/resultat.png
