ET-FR/HP_new_generation/conception_echangeur/docs/formes/ellipse4/resultat.png

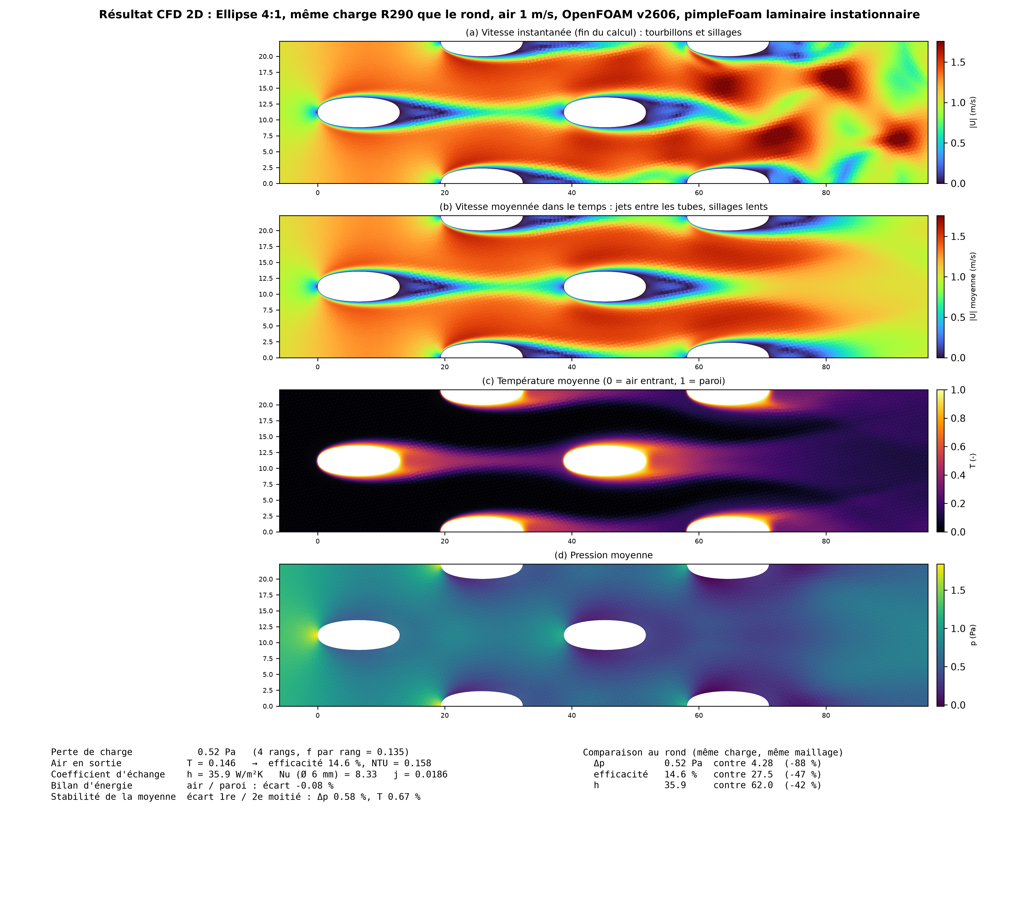
conception_echangeur/docs/formes/ellipse4/resultat.png
