ET-FR/HP_new_generation/conception_echangeur/docs/formes/ellipse5/resultat.png

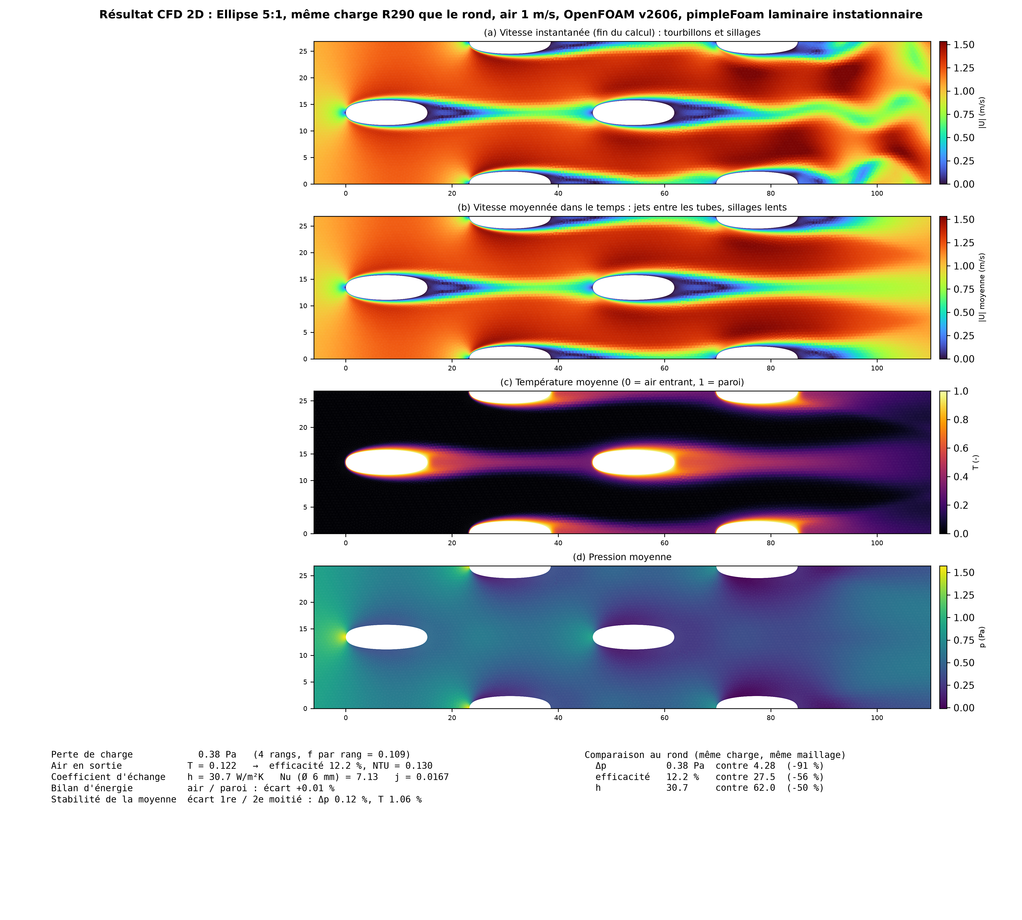
conception_echangeur/docs/formes/ellipse5/resultat.png
