ET-FR/HP_new_generation/conception_echangeur/docs/formes/etoile6/resultat.png

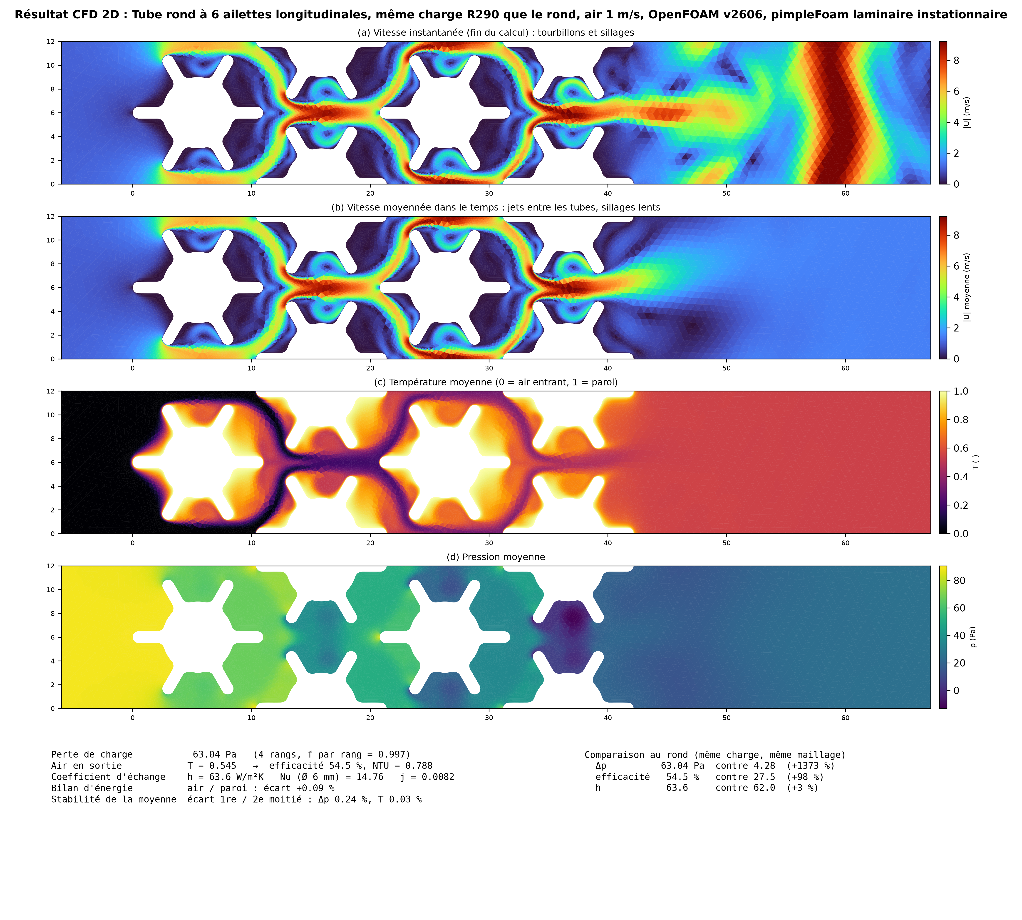
conception_echangeur/docs/formes/etoile6/resultat.png
