ET-FR/HP_new_generation/conception_echangeur/docs/formes/goutte_inversee/resultat.png

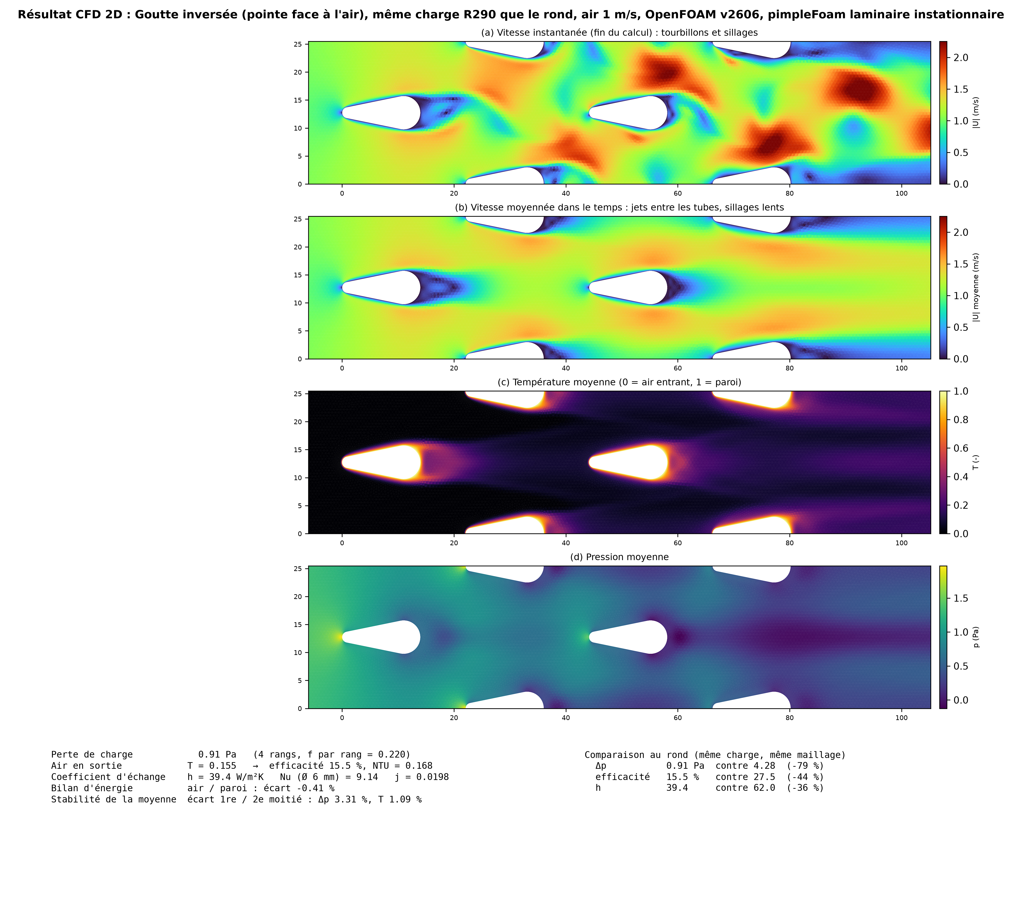
conception_echangeur/docs/formes/goutte_inversee/resultat.png
