ET-FR/HP_new_generation/conception_echangeur/docs/formes/hexagone_pointe/resultat.png

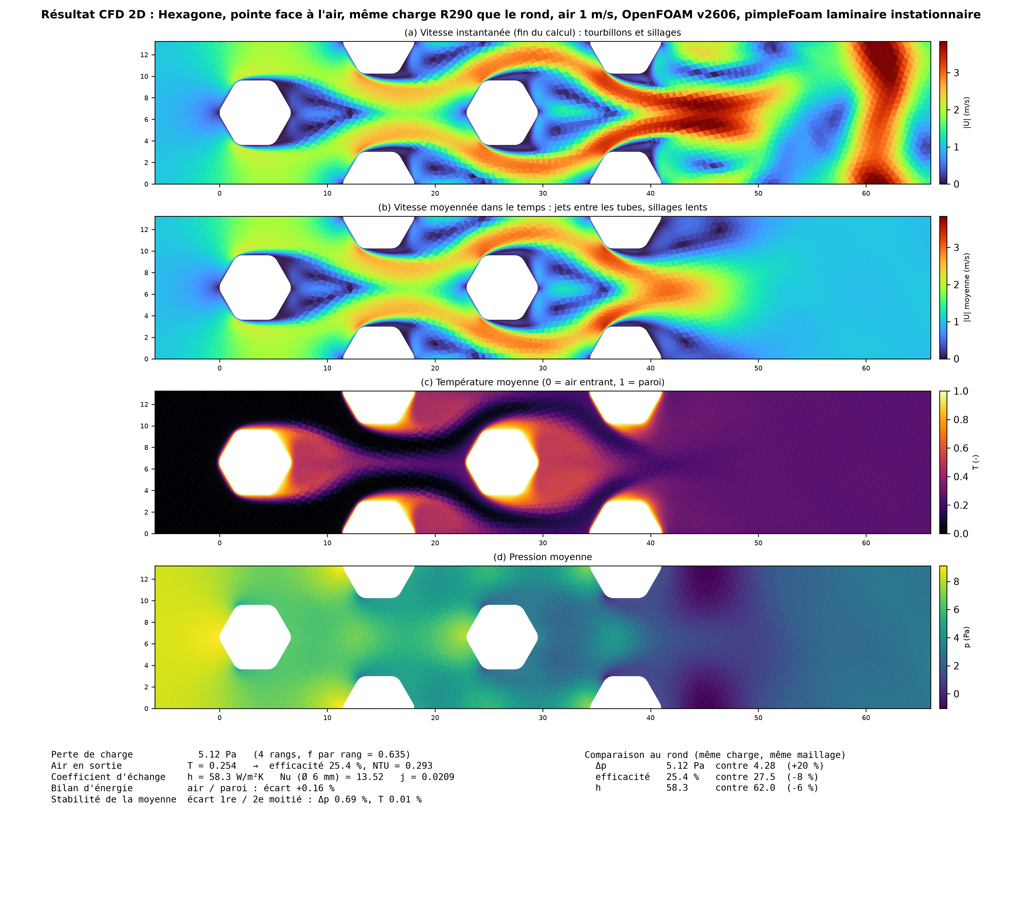
conception_echangeur/docs/formes/hexagone_pointe/resultat.png
