ET-FR/HP_new_generation/conception_echangeur/docs/formes/lentille/resultat.png

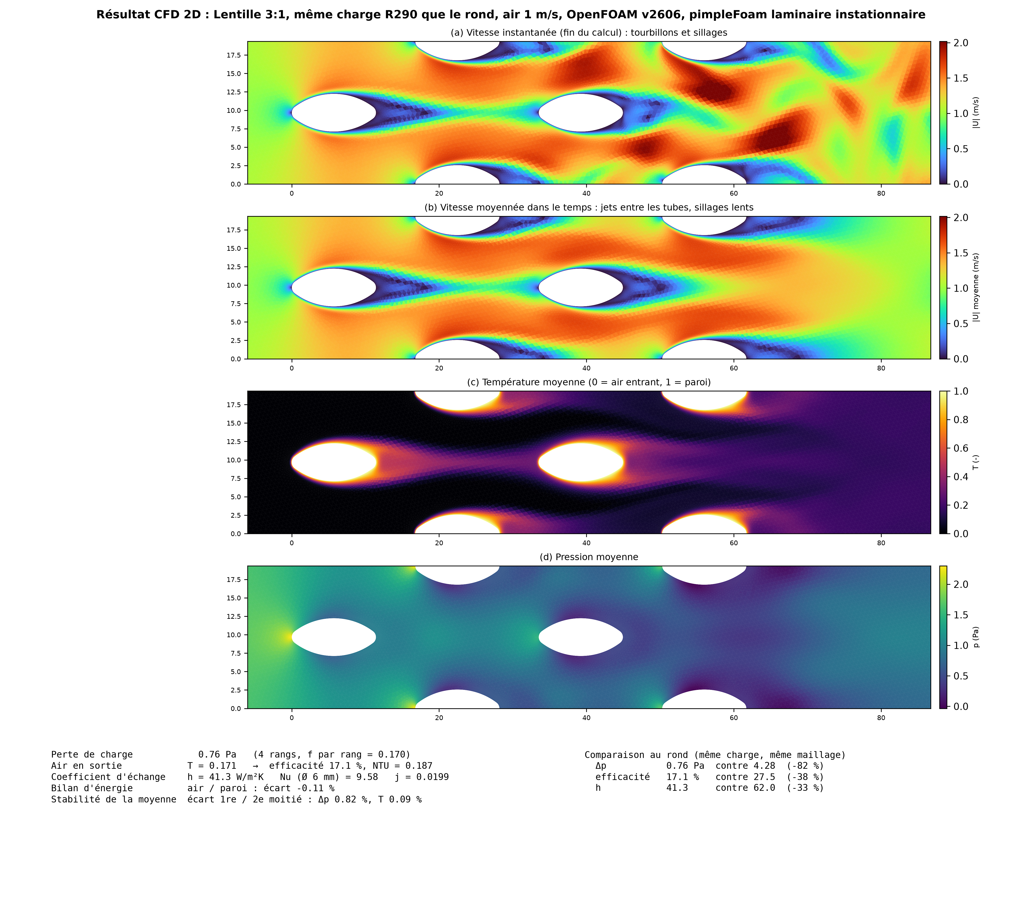
conception_echangeur/docs/formes/lentille/resultat.png
