ET-FR/HP_new_generation/conception_echangeur/docs/formes/lentille/resultat_U2.png

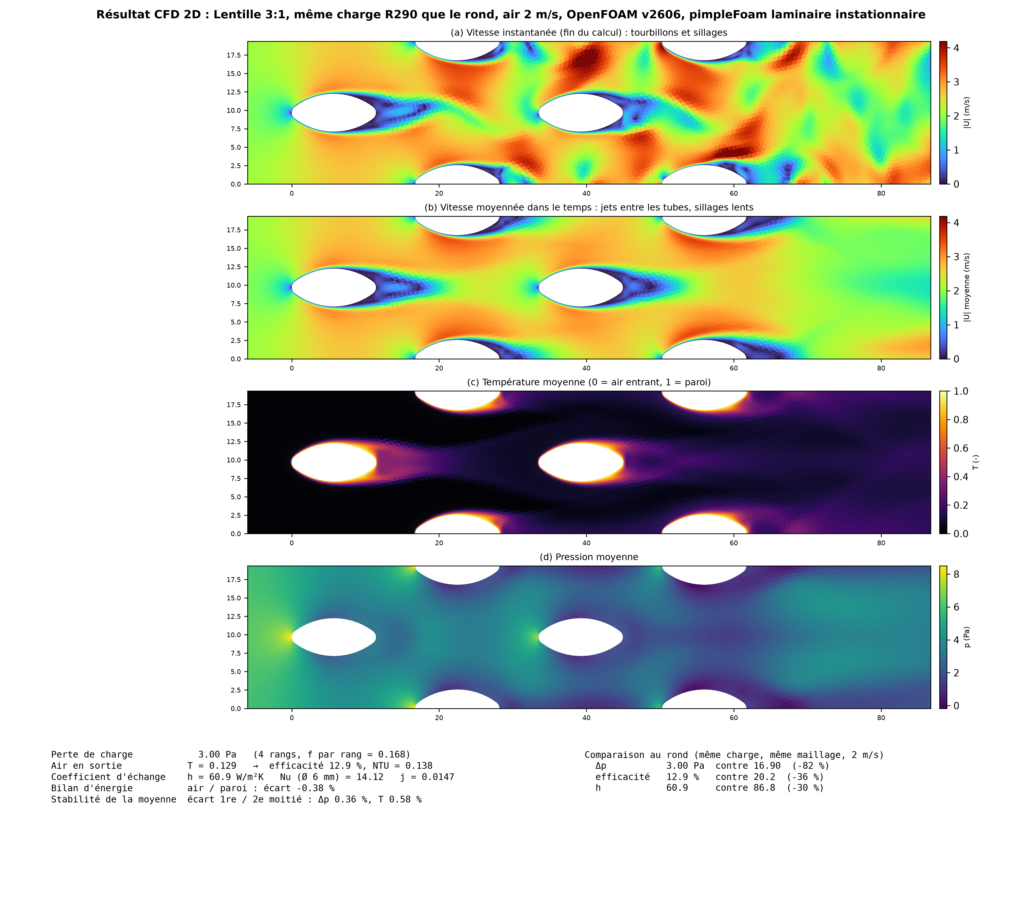
conception_echangeur/docs/formes/lentille/resultat_U2.png
