ET-FR/HP_new_generation/conception_echangeur/docs/formes/losange/resultat.png

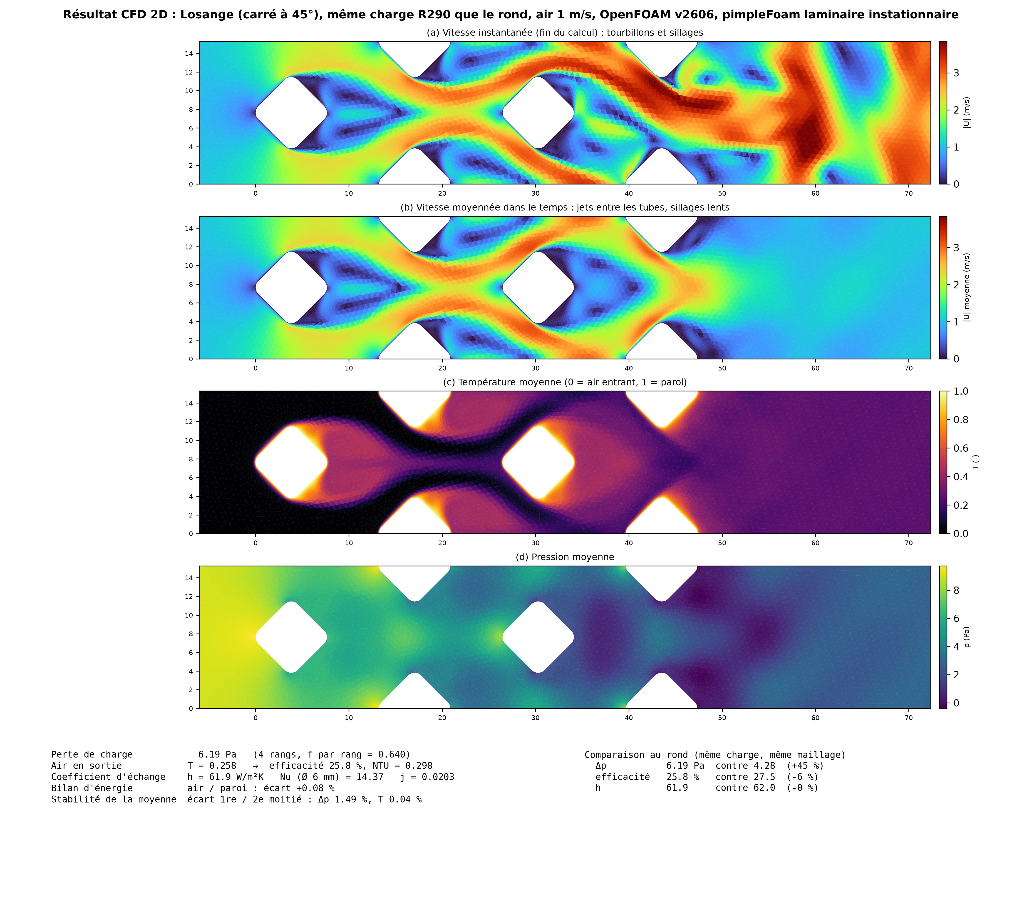
conception_echangeur/docs/formes/losange/resultat.png
