ET-FR/HP_new_generation/conception_echangeur/docs/formes/rond/resultat_ail1.8_r2.png

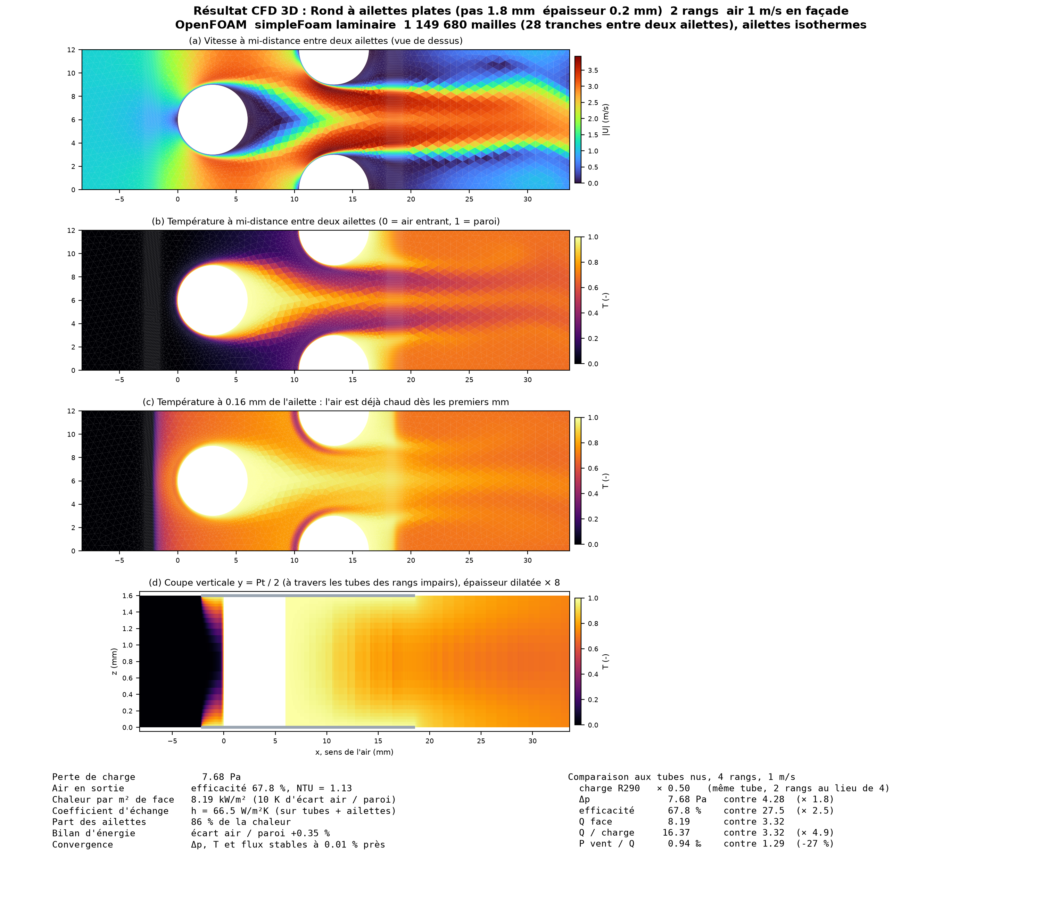
conception_echangeur/docs/formes/rond/resultat_ail1.8_r2.png
