ET-FR/HP_new_generation/conception_echangeur/docs/formes/rond/resultat_ail2.5.png

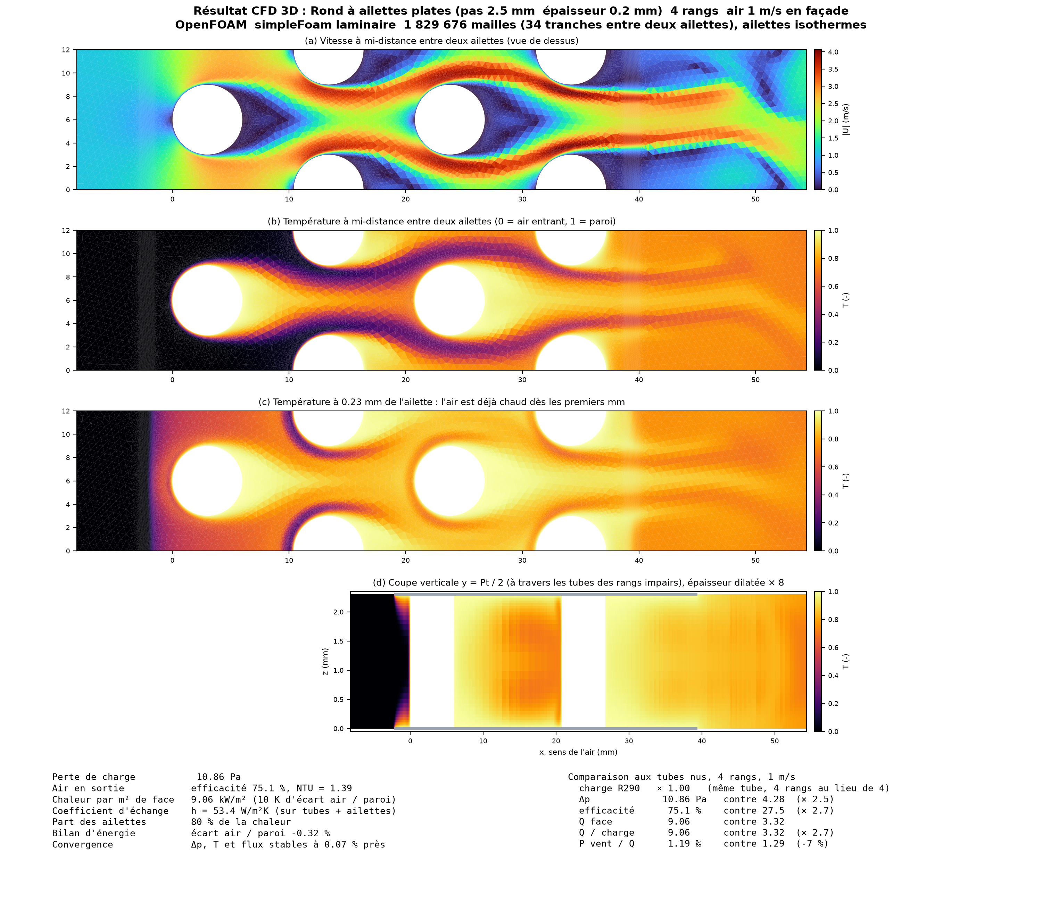
conception_echangeur/docs/formes/rond/resultat_ail2.5.png
