ET-FR/HP_new_generation/conception_echangeur/docs/formes/rond/resultat_gyroide6.png

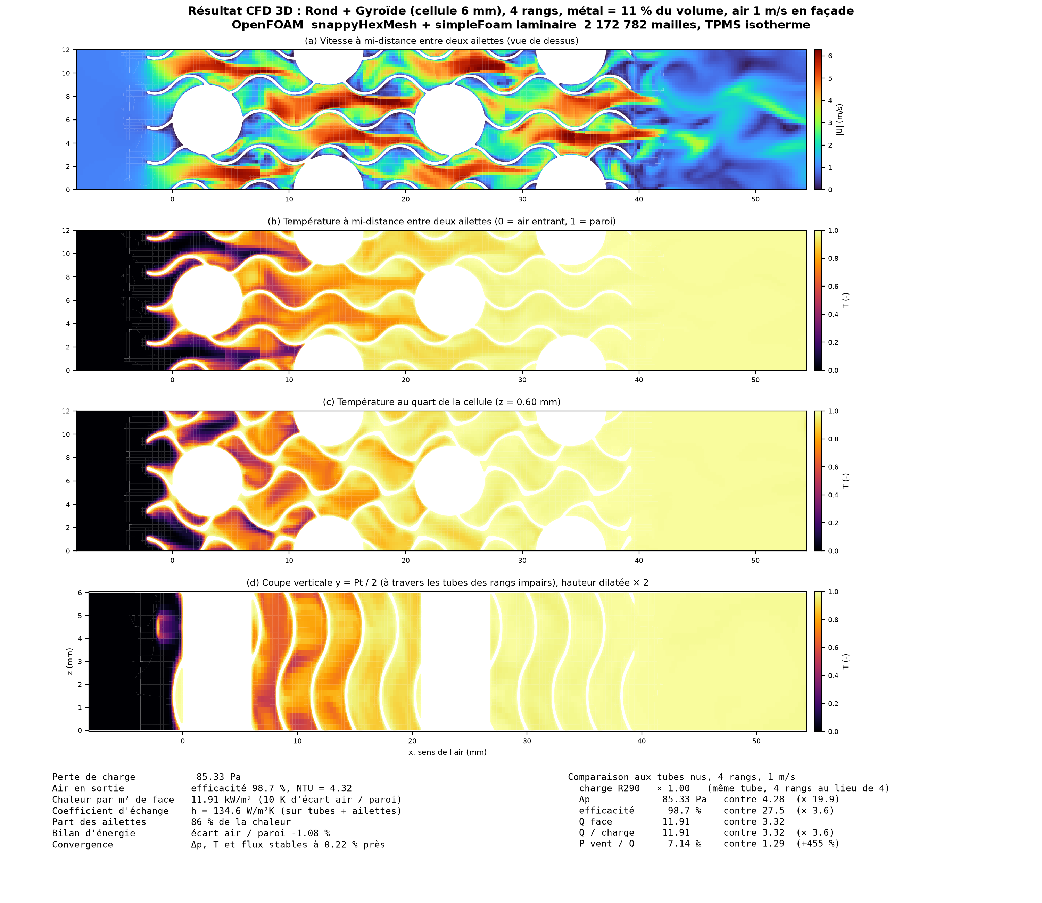
conception_echangeur/docs/formes/rond/resultat_gyroide6.png
