ET-FR/HP_new_generation/conception_echangeur/docs/formes/rond/resultat_maillage_triangles.png

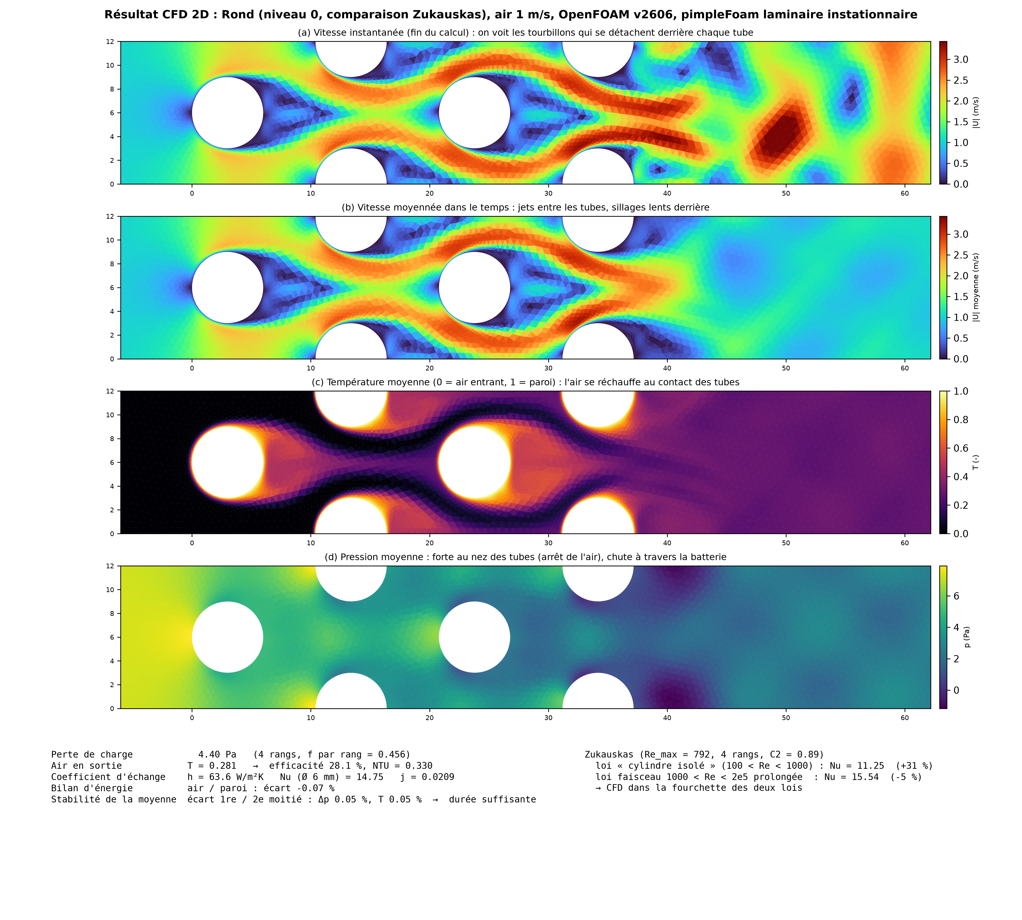
conception_echangeur/docs/formes/rond/resultat_maillage_triangles.png
