ET-FR/HP_new_generation/conception_echangeur/docs/formes/rond/resultat_N2_pt0.75.png

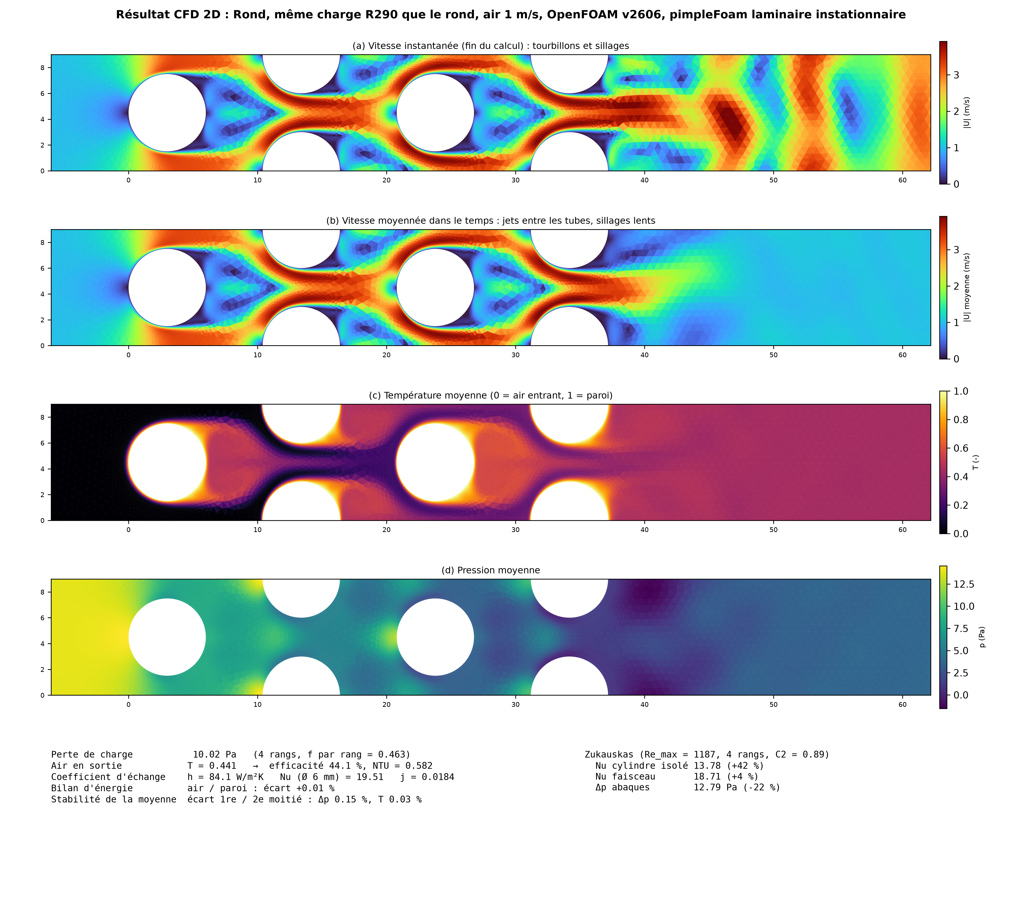
conception_echangeur/docs/formes/rond/resultat_N2_pt0.75.png
