ET-FR/HP_new_generation/conception_echangeur/docs/formes/rond/resultat_N2_rangs8.png

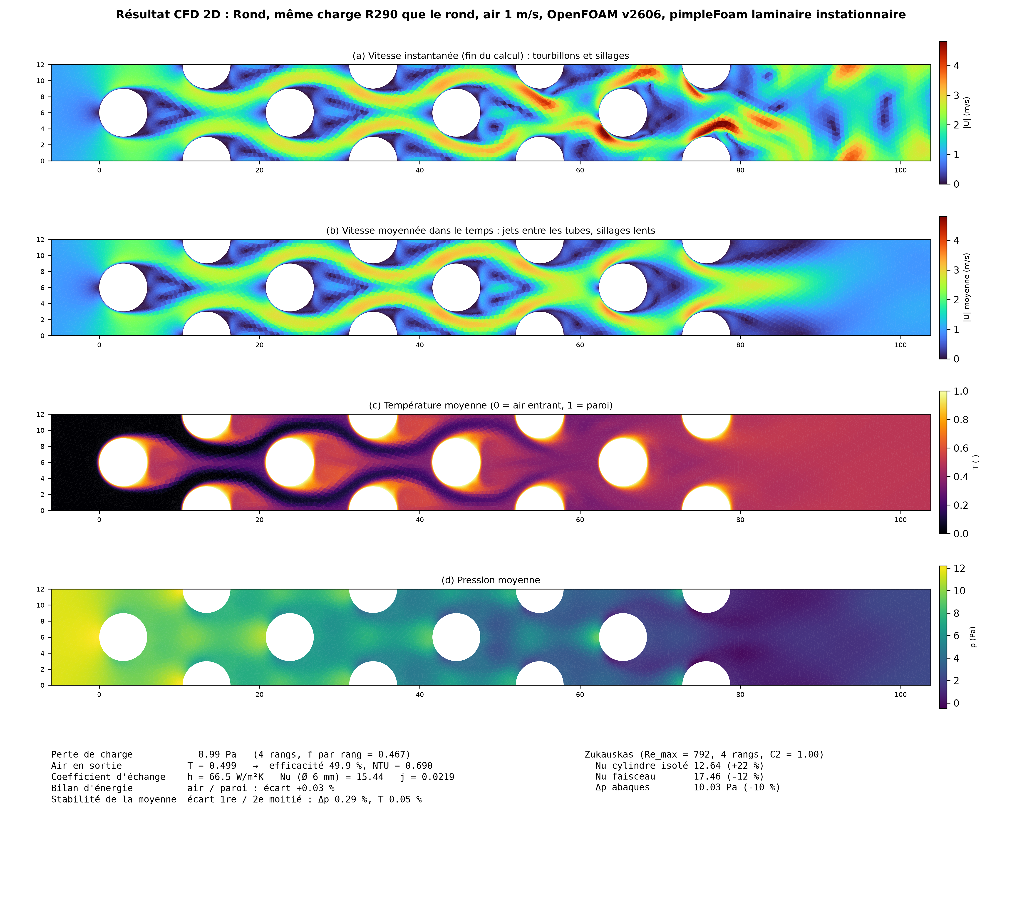
conception_echangeur/docs/formes/rond/resultat_N2_rangs8.png
