ET-FR/HP_new_generation/conception_echangeur/docs/formes/rond/resultat_U3.png

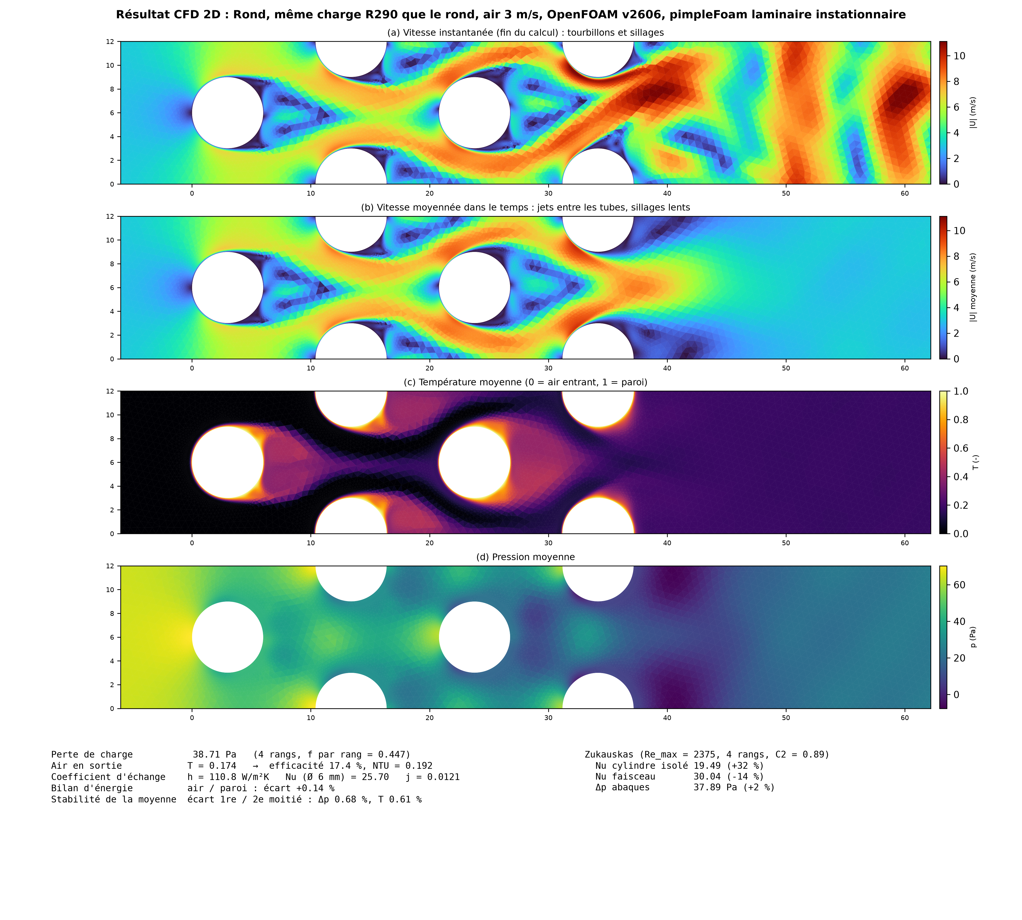
conception_echangeur/docs/formes/rond/resultat_U3.png
