ET-FR/HP_new_generation/conception_echangeur/docs/formes/stade8/resultat.png

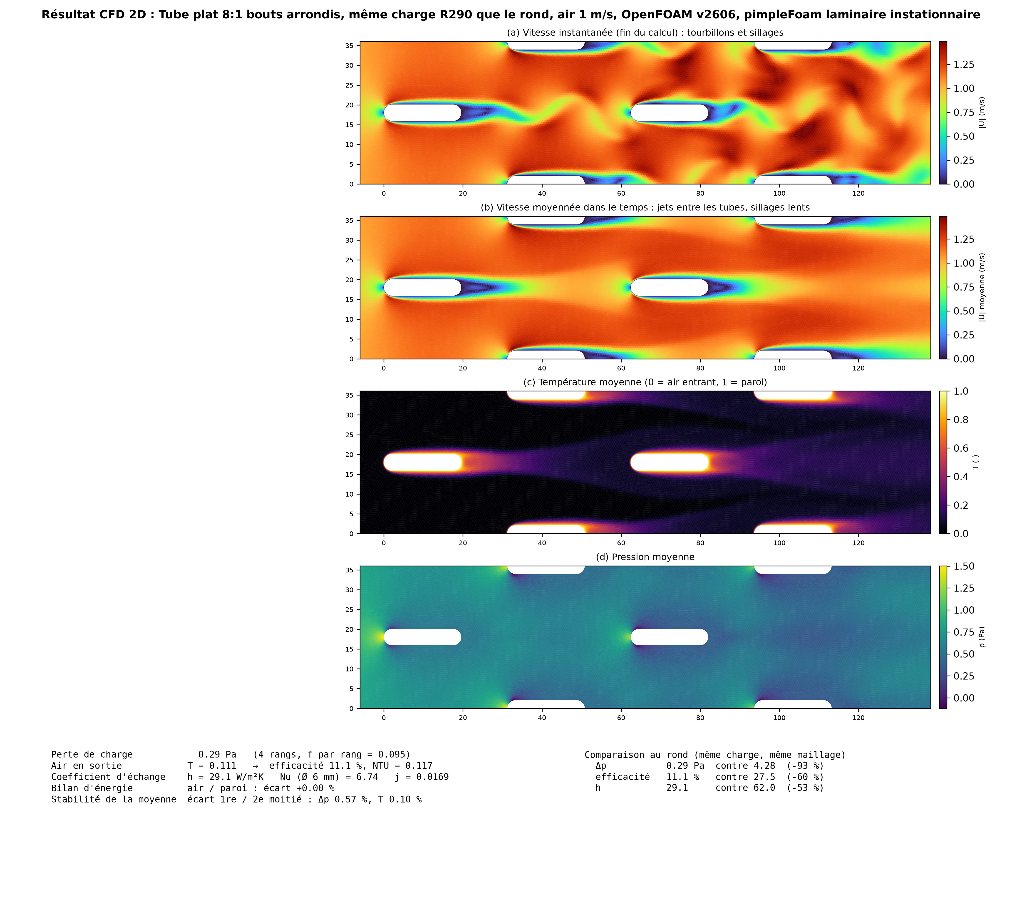
conception_echangeur/docs/formes/stade8/resultat.png
