ET-FR/HP_new_generation/conception_echangeur/docs/formes/tpms_seul/resultat_diamond_L2.png

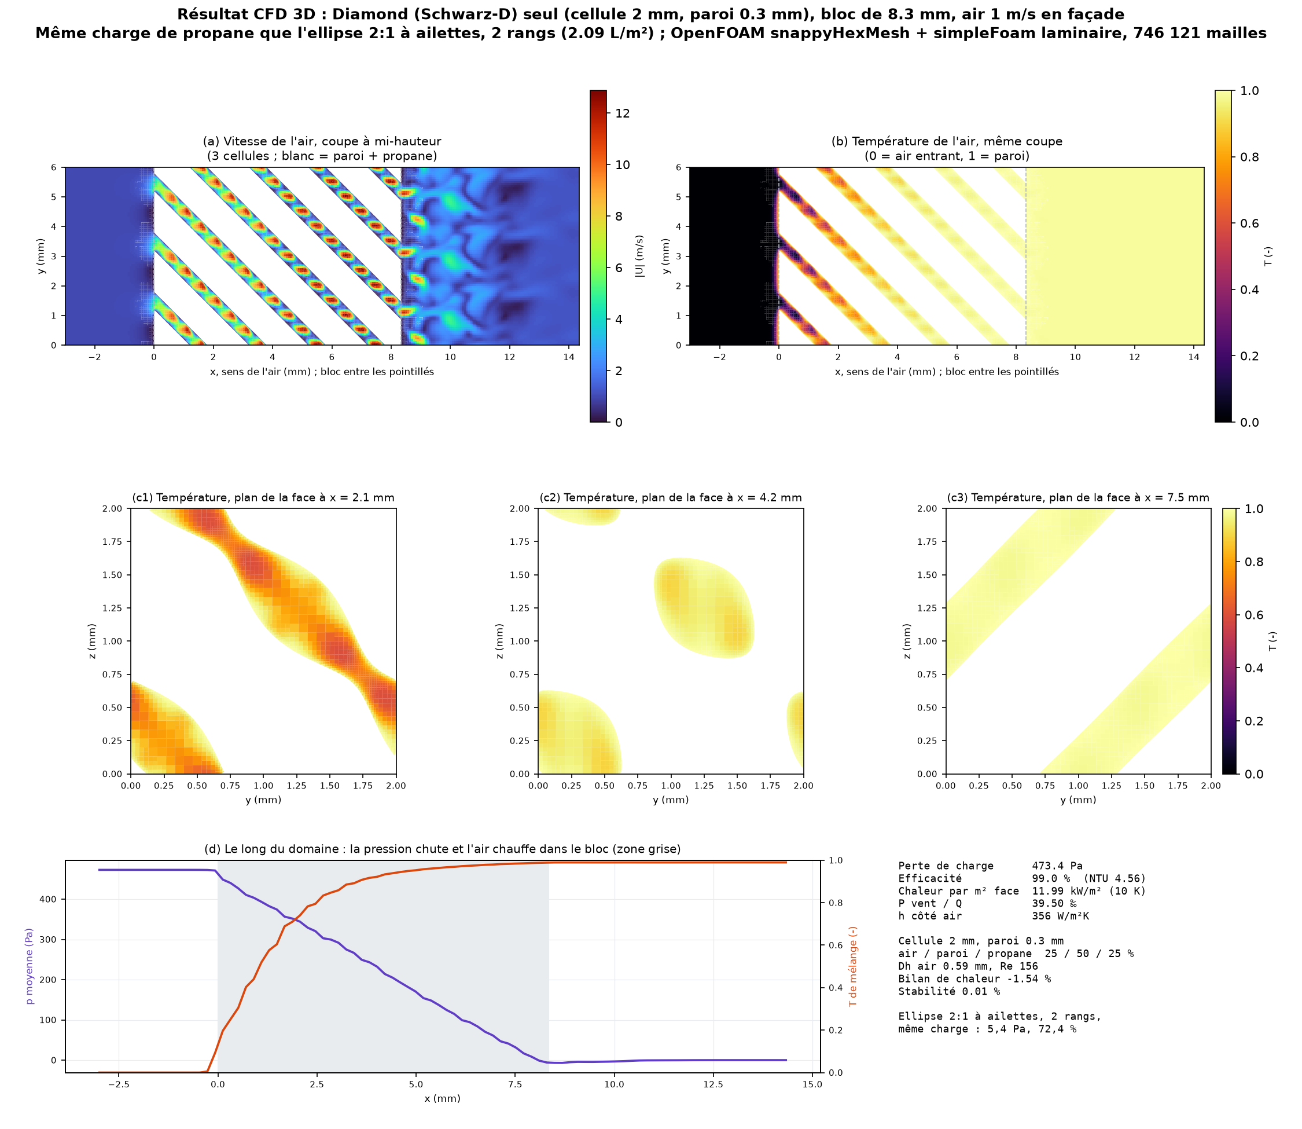
conception_echangeur/docs/formes/tpms_seul/resultat_diamond_L2.png
