ET-FR/HP_new_generation/conception_echangeur/docs/formes/tpms_seul/resultat_fks_L6.png

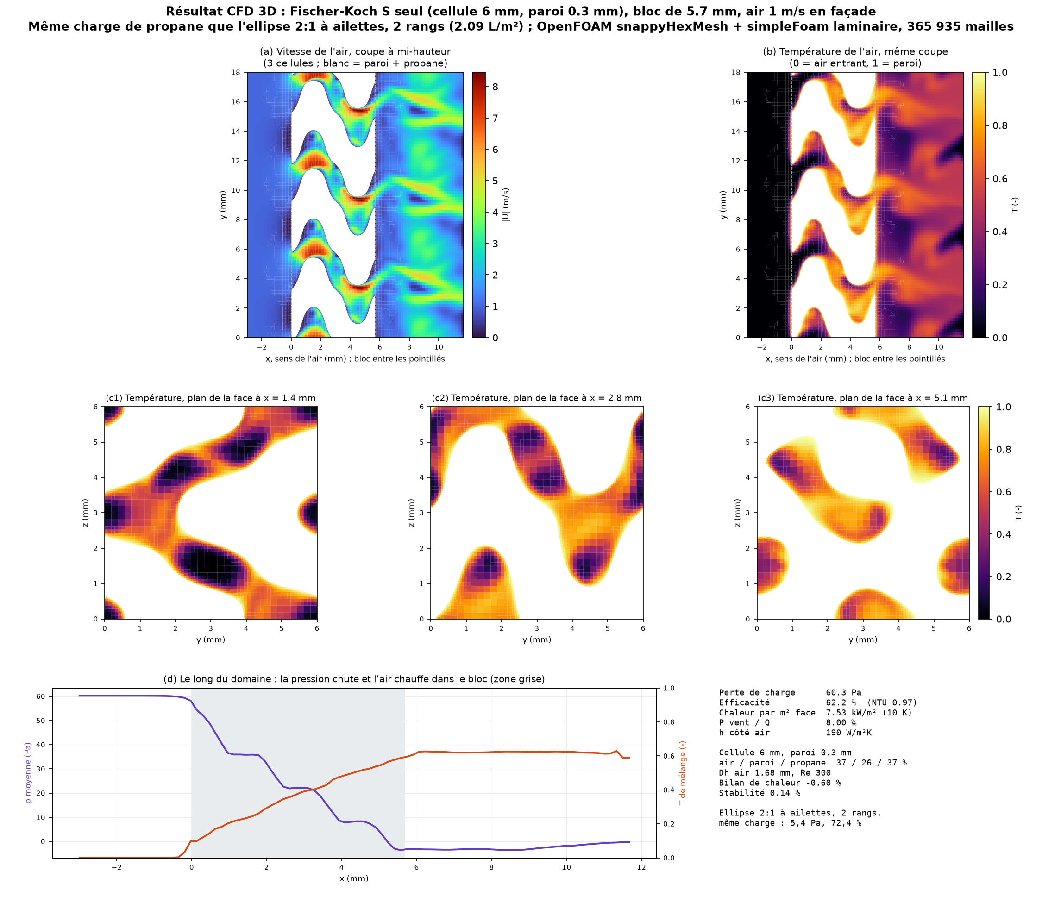
conception_echangeur/docs/formes/tpms_seul/resultat_fks_L6.png
