ET-FR/HP_new_generation/conception_echangeur/docs/formes/triangle_base/resultat.png

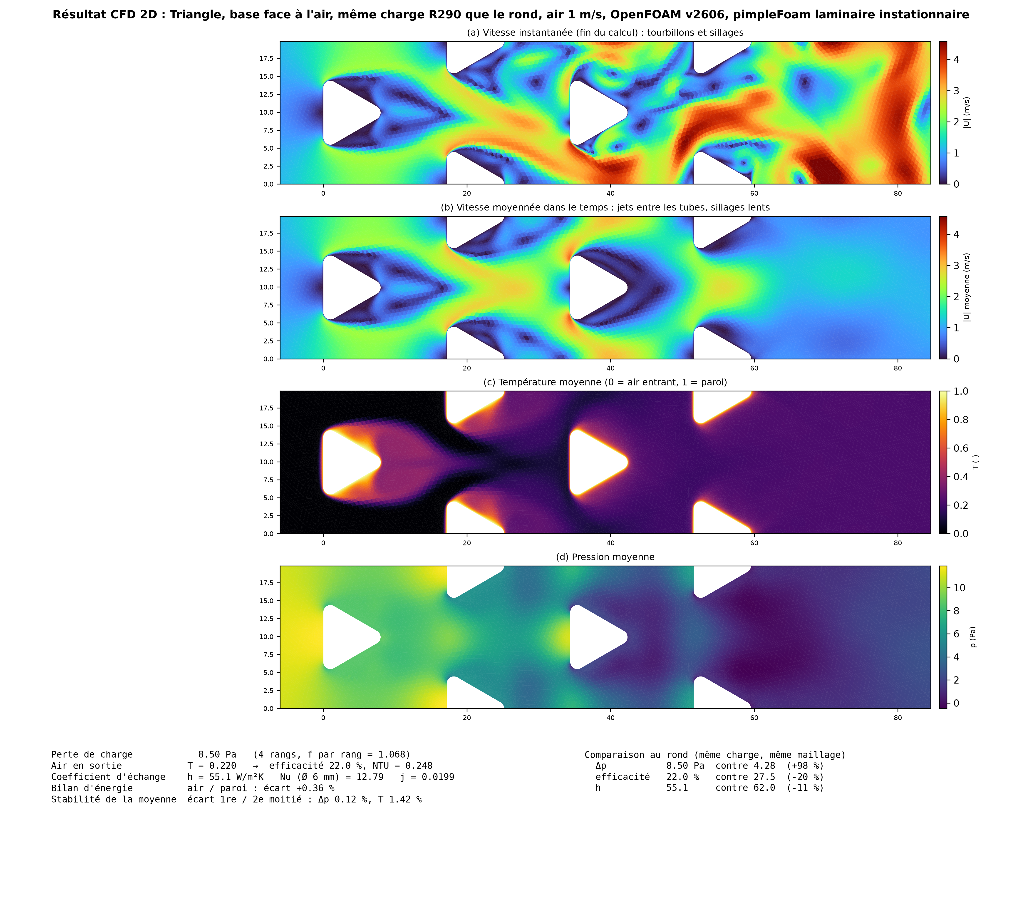
conception_echangeur/docs/formes/triangle_base/resultat.png
