ET-FR/HP_new_generation/conception_echangeur/docs/formes/triangle_pointe/resultat.png

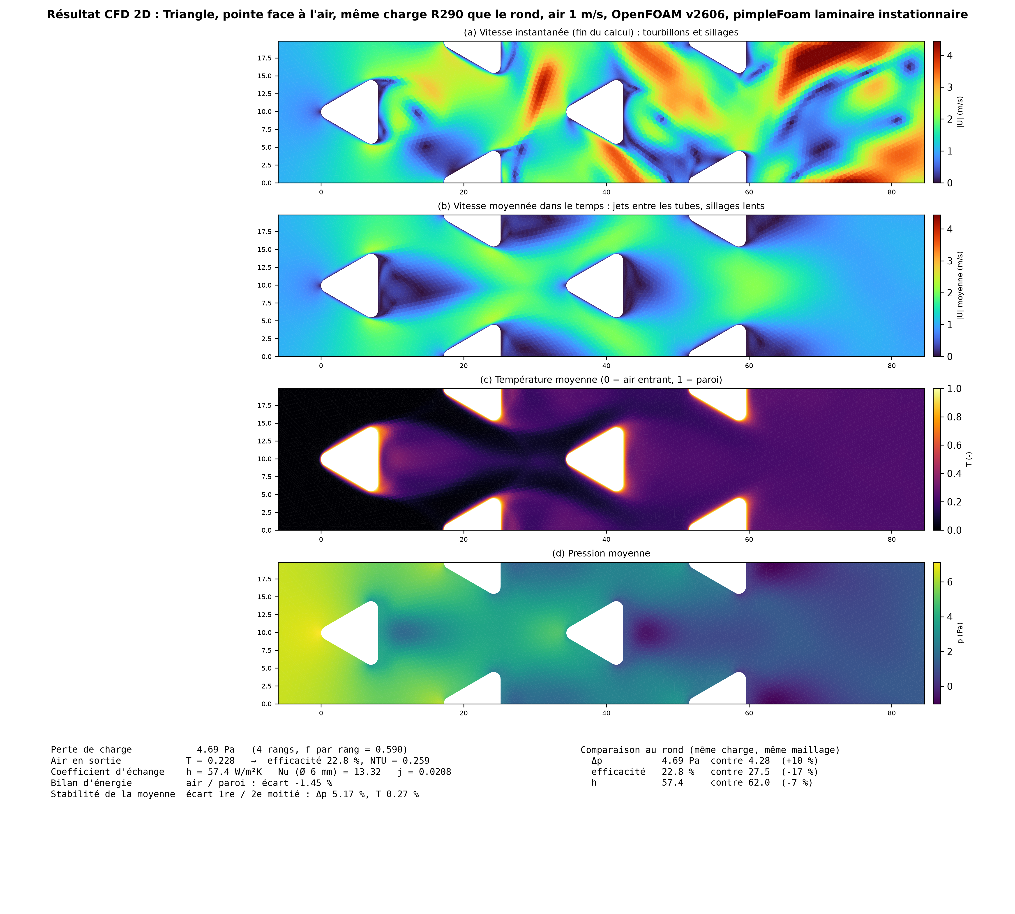
conception_echangeur/docs/formes/triangle_pointe/resultat.png
