ET-FR/HP_new_generation/conception_echangeur/docs/maillages/validation_niveau0.png

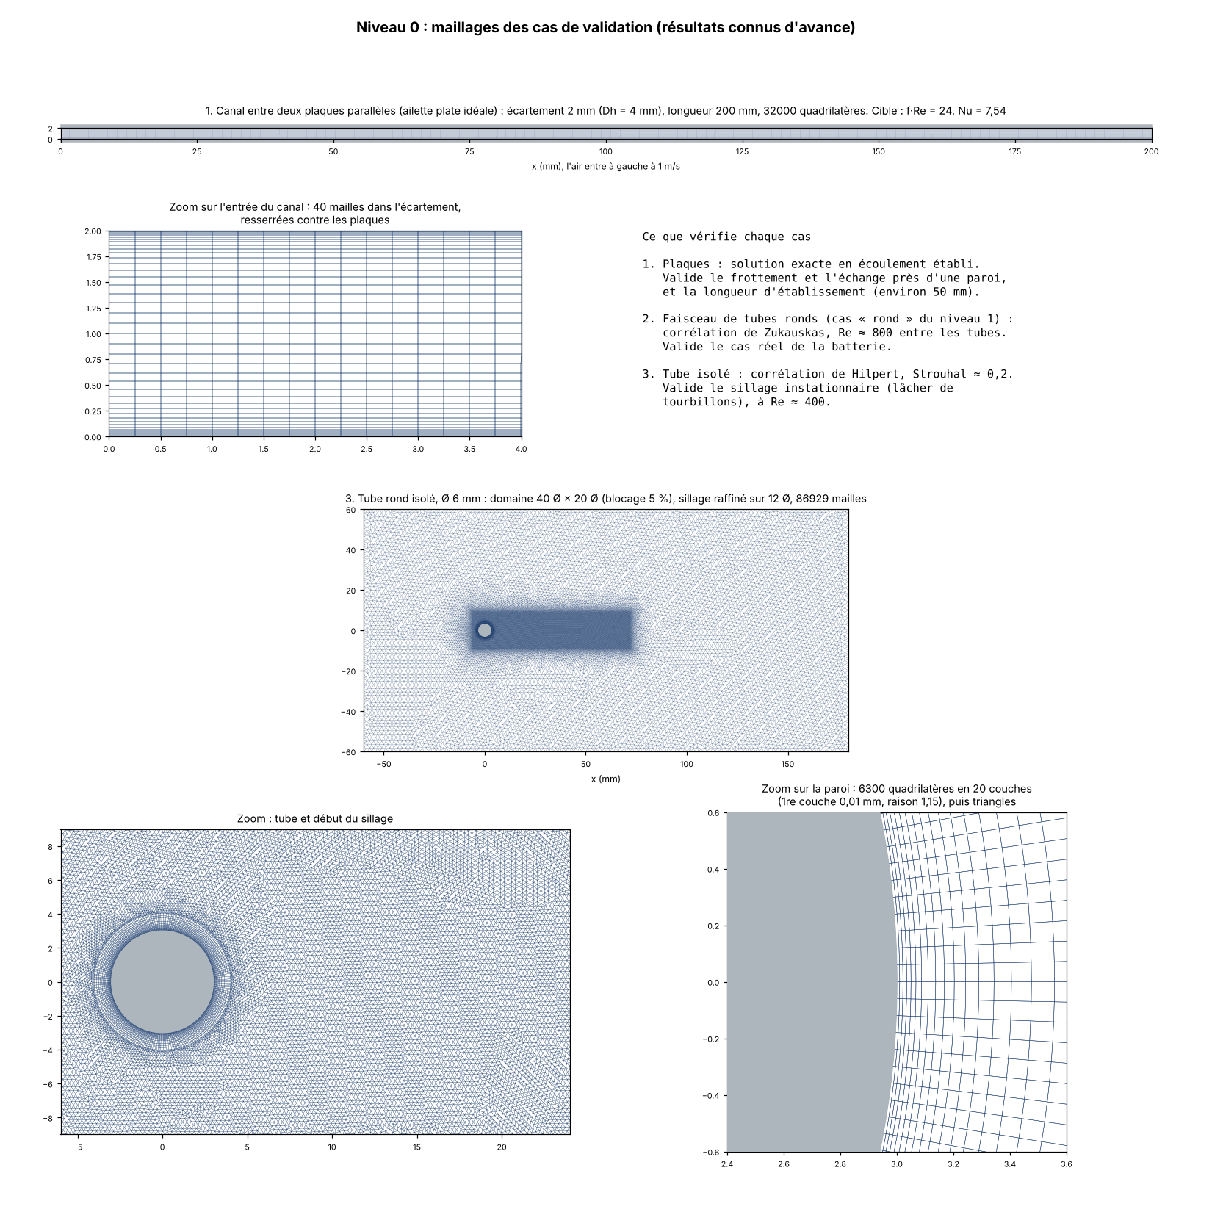
conception_echangeur/docs/maillages/validation_niveau0.png
