ET-FR/HP_new_generation/TODO_HUMAN.txt

- Design dun heat exchangeur avec ailette ou autre
