ET-FR/HP_new_generation/(commit log)

2026-10-31 Simulateur physique temps réel d'une PAC de fenêtre réversible au R290
    Modèle quasi-statique (CoolProp, compresseur inverter, epsilon-NTU avec
    batterie humide, dégivrage, cyclage, charge vs IEC 60335-2-40) et
    interface matplotlib interactive : schéma animé, diagramme P-h, courbe
    COP = f(T ext), historique et curseurs de charge.
    Claude-Session: https://claude.ai/code/session_01BUfgHVN2FK2ydRHGdARjz6
2026-11-05 Interface web, débits d'air séparés, cascade des pertes, dimensionnement
    - Interface web (pac_fenetre/web/index.html) servie par pac_fenetre/serveur.py,
    calcul dans pac_fenetre/moteur.py ; --tk garde l'ancienne interface matplotlib.
    - Conditions : débits d'air intérieur et extérieur réglables séparément,
    loi cubique appliquée à chaque ventilateur.
    - Conception.multiplicateurs : remplace les multiplicateurs de technologie.
    - PompeAChaleur.cascade_pertes : décomposition Carnot -> COP unité.
    - pac_fenetre/dimensionnement.py.
2026-11-05 Aéraulique physique : Δp Kays & London, courbe ventilateur réelle, puissance au point de fonctionnement
2026-11-05 Échangeur gyroïde : géométrie, corrélations f et j de Leeds, UA et charge couplés à la géométrie, balayage
2026-11-08 Surfaces d'échange : TPMS, tubes nus, comparateur, simulation gyroïde, chaîne CFD OpenFOAM
    - tpms.py : gyroïde, Diamond, Primitive, I-WP, Fischer-Koch S ; géométrie à porosité et Dh donnés
    - echangeurs_air.py : TPMS feuillet et hybride (corrélations CFD ou Leeds), faisceau de tubes nus (VDI)
    - comparateur.py : même enveloppe, mêmes débits et même puissance, cycle complet par candidat
    - simu_gyroide.py : PAC avec deux batteries gyroïdes paramétrées depuis l'interface
    - outils/cfd_tpms : génération STL et cas OpenFOAM v2412, campagne, extraction j/f, ajustement
    - tests du comparateur, des surfaces TPMS et du générateur de STL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
2026-11-08 Interface web : simulateur 2, P-h annoté, glossaire, principes de design, gyroïde 3D, comparateur
    - Simulateur temps réel 2 : schéma de la machine, paramètres par composant, états aux coins, détail du COP
    - Diagramme P-h : cycles de référence (idéal, compresseur parfait) et zones de phase du propane
    - Onglets Glossaire et Principes de design
    - Dimensionnement : échangeur gyroïde 3D (three.js local) avec simulation, comparateur de surfaces
    - Serveur : routes gyroïde, comparateur et bibliothèques locales ; connexions coupées ignorées
    - Correction de la boucle d'affichage quand un onglet est masqué
2026-11-08 Bibliographie des surfaces d'échange et plan de conception des batteries
2026-11-09 Coupe du maillage CFD d'une cellule gyroïde (Re 200)
    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
2026-11-09 Plan : base initiale de simulations, coût CFD mesuré d'un cas gyroïde
    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
2026-11-09 Résultat CFD (vitesse, pression) d'une cellule gyroïde à Re 200
    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
2026-11-09 Plan d'étude des formes simples côté air (critères d'équité, paramètres de test)
    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
2026-11-09 Plan formes simples : paroi 1 mm, batterie de référence et formes validées
    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
2026-11-09 Chaîne 2D : géométrie des formes simples (critère d'équité) et maillage gmsh périodique
    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
2026-11-09 Niveau 0 : maillages des cas de validation (plaques parallèles, tube isolé)
    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
2026-11-09 Chaîne 2D : export OpenFOAM (polyMesh cyclique), générateur de cas, script de compilation v2606
    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
2026-11-09 Figure des maillages OpenFOAM du niveau 0 (cellules et patchs de bord)
    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
2026-11-09 Chaîne 2D : extraction des résultats et comparaison aux références (exacte, Zukauskas, Hilpert)
    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
2026-11-09 Maillages du niveau 0 relus par OpenFOAM v2606 (cas en cours de calcul)
    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
2026-11-09 Extraction : test de stabilité de la moyenne (1re et 2e moitié de la fenêtre)
    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
2026-11-09 Niveau 0 : résultats des plaques parallèles et du faisceau de tubes ronds (OpenFOAM v2606)
    Plaques : f·Re = 23,93 (exact 24), Nu = 7,529 (exact 7,541).
    Faisceau rond : Nu = 14,75, entre les deux lois de Zukauskas (11,25 et 15,54) ;
    Δp = 4,40 Pa ; bilan d'énergie à 0,07 % ; moyenne stable à 0,05 %.
    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
2026-11-09 Cartes CFD des plaques parallèles (vitesse, température, pression)
    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
2026-11-09 Sauvegarde du niveau 0 : archives des cas (plaques, faisceau rond) et synthèse des résultats
    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
2026-11-09 README de la CFD 2D : démarche, tableaux des entrées et des sorties, résultats, utilisation
    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
2026-11-09 Niveau 0 terminé : tube isolé (Nu +8 % Hilpert, St +7 % Roshko), archive et synthèse
    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
2026-11-09 Niveau 0 : perte de charge du faisceau rond comparée à Zukauskas (−12 %, bibliothèque ht)
    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
2026-11-09 Convergence en maillage du faisceau rond : Δp convergée, échange non convergé (−3,8 %)
    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
2026-11-09 Maillage à anneaux de couches structurées autour des tubes (compatible raccordement cyclique)
    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
2026-11-09 Extraction : lecture des fichiers de mesure de reprise (surfaceFieldValue_0.dat, ...)
    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
2026-11-09 Convergence avec anneaux de couches : Nu ≈ 14,2 ± 1,5 %, Δp ≈ 4,4 Pa ± 2,5 %
    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
2026-11-10 AWS : démarrage d'une machine de calcul (compilation OpenFOAM v2606, arrêt de sécurité) et lancement des cas en parallèle
2026-11-10 Maillage à couches : rééchantillonnage régulier des contours (évite une spline qui se recoupe sur les formes à côtés droits)
2026-11-10 AWS : lancement des cas après la compilation, ordre des plus longs d'abord
2026-11-10 Rangement de docs/ : un dossier par forme, maillages, simulateur, articles ; PDF de synthèse des résultats CFD
2026-11-10 PDF : images intégrées sans ré-échantillonnage ; figures régénérées à 300 dpi (scripts de convergence et de maillage à couches)
2026-11-10 Nomenclature de la PAC de fenêtre R290
2026-11-10 Niveau 1 : résultat de la goutte (figure, résultats, archive) ajouté au PDF ; colonne de stabilité
2026-11-10 Niveau 1 : losange et triangle pointe amont ajoutés au rapport ; script de rapatriement d'une forme
2026-11-10 Série 2 de formes (12) : NACA 0030, goutte inversée, ellipses 4:1 et 5:1, stade 8:1, hexagones, demi-cercles, tube à ailettes longitudinales, cannelé, multicanaux
2026-11-10 Niveau 1 : rond (cas couches moyen de la convergence, identique) ajouté au rapport
2026-11-10 Rapport : légende des colonnes ; P vent / Q exprimé pour un écart air / paroi de 10 K (unité corrigée)
2026-11-10 Niveau 1 : lentille et tube plat 4:1 ajoutés au rapport
2026-11-10 AWS : prolongation de cas instationnaires (reprise au dernier pas de temps)
2026-11-10 Fenêtre de moyenne doublée pour toutes les formes ; finalisation automatique de la campagne AWS ; rapport : page de comparaison des 22 formes
2026-11-10 Campagne AWS terminée : niveau 1 prolongé et série 2 (22 formes), rapport mis à jour ; PDF compressé (JPEG) sous la limite GitHub
2026-11-10 Étape 1 (balayage en vitesse) : suffixe _U<vitesse> au rangement, vitesse dans les figures, page du rapport, finalisation AWS générique
2026-11-10 Rapport : graphique du compromis des 22 formes (front de Pareto), géométries, maillages de validation, pages TPMS
2026-11-10 Étape 1 : balayage en vitesse (0,5 / 2 / 3 m/s) du rond, de l'ellipse 2:1, de la lentille et de l'ellipse 4:1
2026-11-10 Rapport, étape 1 : compromis tracé en chaleur par m² de face (comparable entre vitesses)
2026-11-10 Rapport : vues CFD rangées par forme (toutes les vitesses d'une forme à la suite)
2026-11-10 Niveau 2 (agencement) : pas transversal et longitudinal, rangs, aligné / quinconce dans la géométrie, les cas et l'extraction (Umax diagonal, Zukauskas aligné) ; page du rapport
2026-11-10 AWS : machine de calcul conservée et arrêtée (plus supprimée) pour garder OpenFOAM compilé ; script de redémarrage
2026-11-10 lancer_cas : pas d'attache MPI aux cœurs (avec -np 2, tous les cas s'empilaient sur les cœurs 0 et 1)
2026-11-10 Niveau 2 : agencement (rangs, pas transversal et longitudinal, aligné / quinconce) du rond et de l'ellipse 2:1
2026-11-10 Rapport, niveau 2 : tableau aux mêmes colonnes que les autres (Re max, h, efficacité, P vent / Q, profondeur, stabilité) plus charge et Q / charge ; étape 2 marquée faite
    Claude-Session: https://claude.ai/code/session_01BUfgHTr4QYfxBPPMun5tc5
2026-11-10 Rapport : encadré de conclusion après chaque étape (validation, formes, vitesse, agencement)
    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
2026-11-10 Piste tubes parallèles à l'air : estimation analytique (couche limite en développement, vérifiée sur le canal plan) et page du rapport ; tableaux colorés du rouge au vert (chaleur et Δp, échelle prop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
2026-11-10 Piste tubes parallèles à l'air mise en attente : notée dans le plan, marquée « à valider en CFD 3D » dans le rapport
    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
2026-11-10 Étape 3 : premier maillage 3D des tubes ronds à ailettes plates (maillage 2D à couches empilé en tranches entre deux ailettes) et figure
    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
2026-11-10 Ailettes plates sur toute la profondeur de la batterie (4 Pl, chaque rang centré dans sa bande)
    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
2026-11-10 Côté propane : estimation de la charge et de la perte de charge selon le diamètre intérieur et le nombre de circuits, page du rapport
    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
2026-11-10 Plan : piste du distributeur imprimé à orifices calibrés (détente et répartition entre circuits) notée en attente
    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
2026-11-10 Note de recherche : pistes de biomimétisme (loi de Murray pour les collecteurs, toile d'araignée, branchies, tubercules, mouillabilité alternée)
    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
2026-11-10 Figure explicative de la loi de Murray (arbre de collecteur à 32 circuits, compromis pompage / volume)
    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
2026-11-10 Plan : collecteurs en arbre de Murray notés pour la conception des collecteurs (intérêt surtout pour la répartition, ordres de grandeur de volume)
    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
2026-11-10 Figure explicative de la théorie constructale (méthode par échelles, arbres naturels, écart optimal entre ailettes, échelles de la PAC)
    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
2026-11-10 Biomimétisme : moustache de phoque, chouette, phyllotaxie, poumon d'oiseau, contre-courant, ailettes vascularisées, Nepenthes
    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
2026-11-10 Plan : index des pistes de biomimétisme avec l'étape où les reprendre ; renvoi depuis le plan des échangeurs
    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
2026-11-10 Planche des formes bio-inspirées retenues
    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
2026-11-11 PDF « Pistes et idées » : équation de conception, charge de propane, théorie constructale, loi de Murray, distributeur, biomimétisme, ventilateurs, tubes parallèles à l'air, ailettes 3D, optimisation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
2026-11-11 Niveau 2 : prolongation de 4 cas (ellipse Pl × 1,5 moyennée après le régime transitoire, ellipse Pt × 1,25 et Pt × 1,5, rond Pt × 1,5)
2026-11-11 Étape 3 : cas OpenFOAM 3D des tubes à ailettes plates (extrusion en tranches, bords d'ailette resserrés, flux des ailettes) ; premiers résultats rond et ellipse 2:1, pas 1,8 mm
2026-11-11 Rapport : page de l'étape 3 (ailettes plates, premiers résultats, lot en cours) et maillage 3D ; étape 3 « en cours » ; creer_cas_ailettes : rangs et nombre de tranches
2026-11-11 Étape 3 : visuels CFD 3D du rond et de l'ellipse 2:1 à ailettes (vitesse et température entre ailettes, coupe verticale), ajoutés au rapport
2026-11-11 Vue 3D interactive (HTML, plotly) des cas à ailettes : tubes, ailettes, coupes de température et de vitesse, lignes de courant
2026-11-11 Rapport général en HTML (docs/rapport_cfd.html) : toutes les pages, sommaire cliquable, vue 3D interactive des ailettes ; régénéré avec le PDF
2026-11-11 Vue 3D : mêmes échelles en x et y (les ronds apparaissaient étirés de 50 % en largeur)
2026-11-11 Étape 3 : lot 2 (convergence 20 / 40 tranches, 2 rangs rond et ellipse, pas 2,5 mm) ; figures 3D (échelle, charge relative), rapport PDF et HTML à jour (vue 3D : 5 cas)
    [ailette.stl, arbre_bas.stl, arbre_haut.stl, echangeur_helice.FCStd, echangeur_helice.step, enveloppe.stl, noyau.stl, tubes.stl]
2026-11-11 Vue 3D : maillage (tranches) et température à deux autres hauteurs, activables dans la légende ; titres d'axes rétablis
2026-11-11 Vue 3D allégée (coordonnées et valeurs au millième, coupes réduites)
2026-11-11 Étape 3 : ailettes ondulées et bord d'attaque ondulé (déformation exacte du maillage validé), tubes + TPMS à métal égal (snappyHexMesh) ; figures, vue 3D et rapport prêts pour ces cas
2026-11-11 Étape 3, lot 3 : ailettes ondulées, bord d'attaque ondulé, TPMS (gyroïde, Diamond) à métal égal ; figures, conclusions, rapport PDF et HTML (vue 3D) à jour
2026-11-11 Rapport : titres des pages TPMS et ailettes ondulées corrigés
2026-11-13 Échangeur radial (variantes A′ à F), concept imprimé en 3D et CFD 3D ; rangement du dépôt
    - Rangement : échangeurs et CFD regroupés dans conception_echangeur/, cartes/ renommé compresseurs/
    - Hélice Ø 150 : résultats 3D (coupes, températures réelles, profils le long du chemin), CAO corrigée
    - Nouvelle architecture : cylindre couché à flux radial ; croquis 2D (A, A′, B, C, D, E) et modèles
    3D (A′, E en fer à cheval, F en tube droit), rapport unique echangeur_radial.html
    - Variante F : lamelles, tranche plissée, concept imprimé (parois ≥ 1 mm, profils porteurs de propane,
    lamelles décalées, noyau vide), versions sans et avec stries
    - CFD 3D sur AWS : tranche c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
    [ailette.stl, arbre_bas.stl, arbre_entree.stl, arbre_haut.stl, arbre_sortie.stl, cloisons.stl, concept_imprime.step, domaine_air.step]
2026-11-13 Secteur 1/8 : raccord périodique corrigé, lamelles 0,5 mm décalées / imbriquées / vague / avec dents
    - Correctif du raccord AMI y0↔y1 en parallèle (découpage en tranches le long du tube, garde-fou dans Allrun) ;
    cas au pas de 2,5 mm calculés avant le 14/11 marqués non valables.
    - Nouvelles formes (secteur_periodique.py, stl_secteur.py) : lamelles imbriquées, ailette en vague, lamelles à dents.
    - Résultats maillage fin, raccord corrigé (830 m³/h) : décalées 59 Pa / 299 W/K, imbriquées 169 Pa / 731 W/K,
    vague 103 Pa / 330 W/K, décalées avec dents 56 Pa / 229 W/K.
    - Rapport : colonnes hA/Δp (dégradé) et raccord, graphique Δp = f(hA), vues 3D des nouveaux cas.
    Co-Au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
    [sect_canaux_f05.stl, sect_canaux_f05i.stl, sect_canaux_f05s.stl, sect_canaux_f05v.stl, sect_cont_lamelles_f05.stl, sect_cont_lamelles_f05i.stl, sect_cont_lamelles_f05s.stl, sect_cont_lamelles_f05v.stl]
